Niclasapdk/esd6_project/gitfigures/problem_analysis/effects-all.png

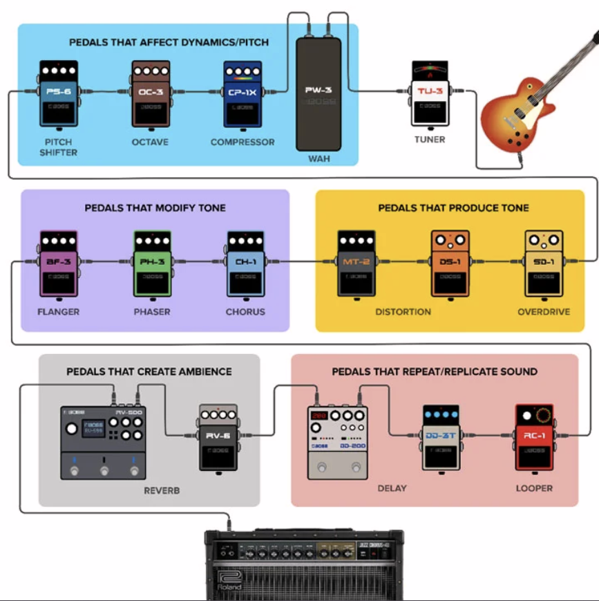
gitfigures/problem_analysis/effects-all.png
