Niclasapdk/esd6_project/gitfigures/problem_analysis/bandwidth_instruments.jpeg

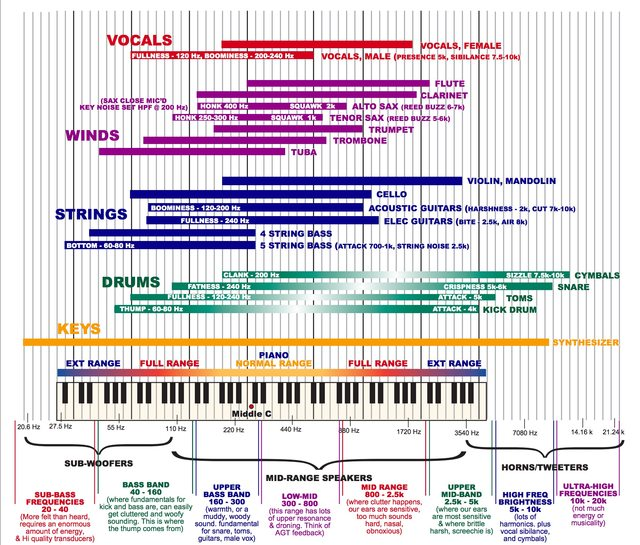
gitfigures/problem_analysis/bandwidth_instruments.jpeg
