Niclasapdk/esd6_project/README.md

# esd6_project
Project repository for esd6 project performed in the spring semester for the Electronic systems engineering education at Aalborg University. The project involves development of a Digital Guitar effect pedal.
