Niclasapdk/esd6_project/ltspice_sim/i2c_level_shift/i2c_level_shift.pdf

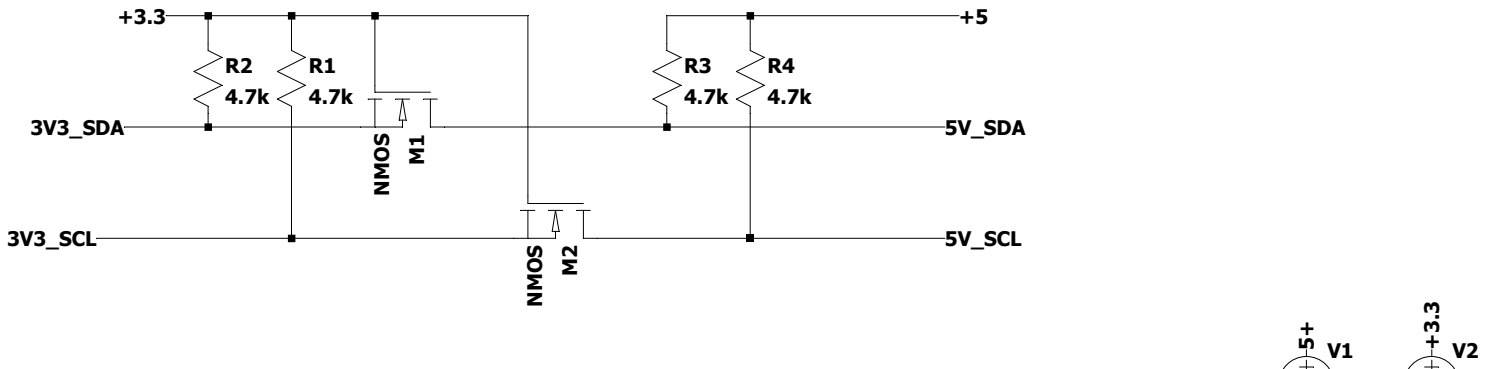
[picture p3: figure]
M1 NMOS M2 NMOS; 3V3_SCL; 3V3_SDA; 5V_SDA; 5V_SCL

5

3.3

--- C:\Users\nicla\Documents\GitHub\esd6_project\ltspice_sim\i2c_level_shift\i2c_level_shift.asc ---
