Niclasapdk/esd6_project/ltspice_sim/powersupply/fullbridgerectifier.pdf

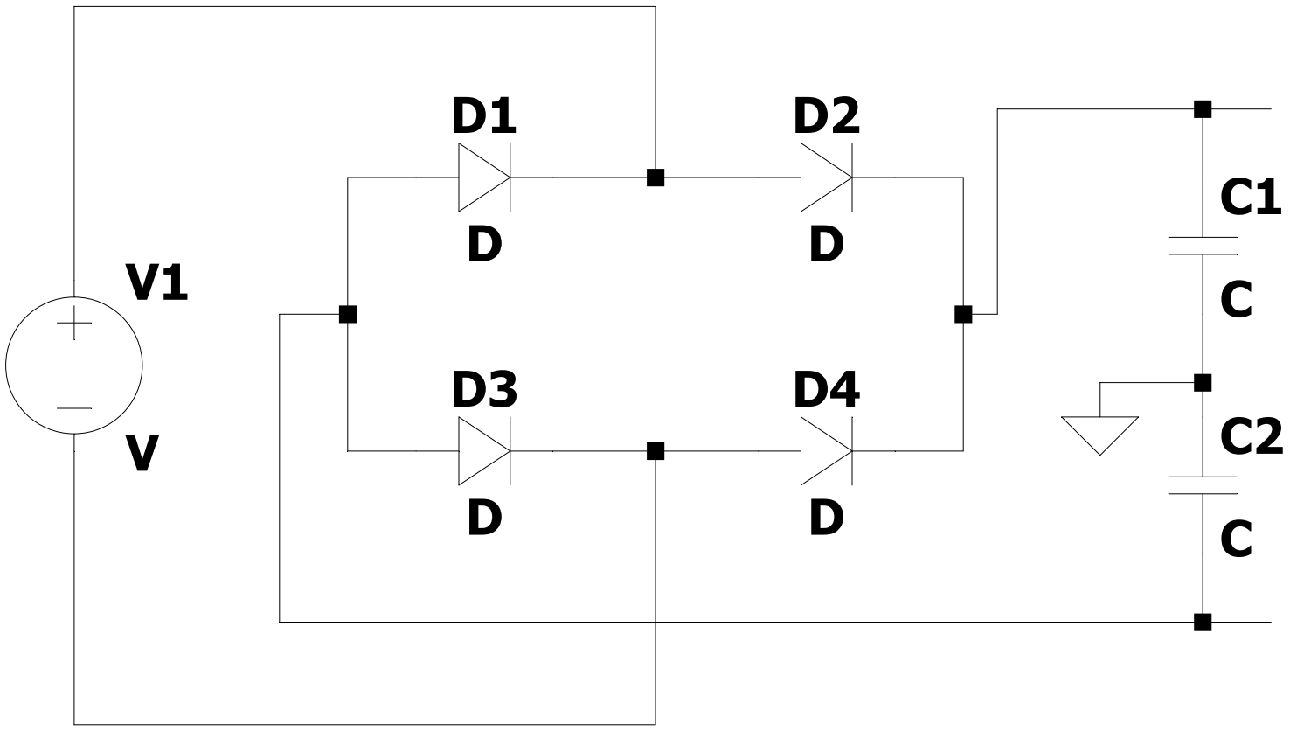
[picture p4: figure]

--- C:\Users\nicla\Documents\GitHub\esd6_project\ltspice_sim\powersupply\fullbridgerectifier.asc ---
