Niclasapdk/esd6_project/ltspice_sim/output_stage/final_output_stage.pdf

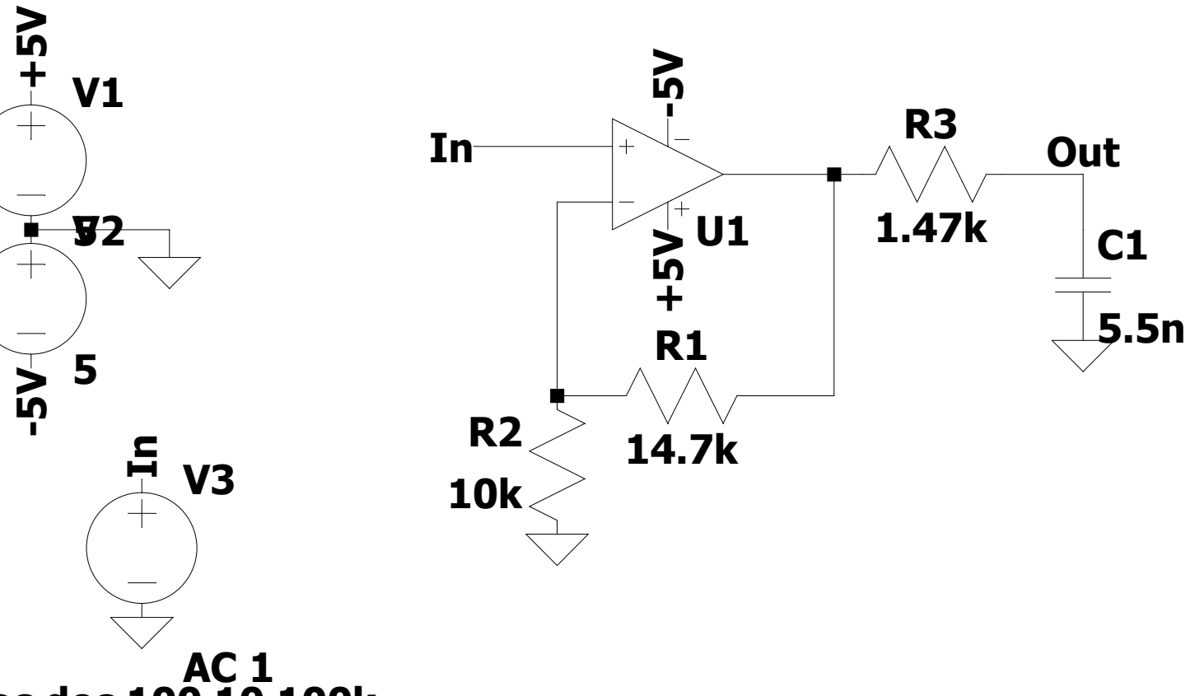
[picture p5: figure]
Out -5V +⁵V

# .ac dec 100 10 100k

--- C:\Users\nicla\Documents\GitHub\esd6_project\ltspice_sim\output_stage\output_stage.asc ---
