Niclasapdk/esd6_project/ltspice_sim/pre_amplifier/pre_amplifier.pdf

U1

V1

5V2

5

R1

R2 | C1 ⁺⁵V -5V | -5V +⁵V In | Out

--- C:\Users\nicla\Documents\GitHub\esd6_project\ltspice_sim\pre_amplifier\pre_amplifier.asc ---
