Niclasapdk/esd6_project/ltspice_sim/output_stage/output_stage.pdf

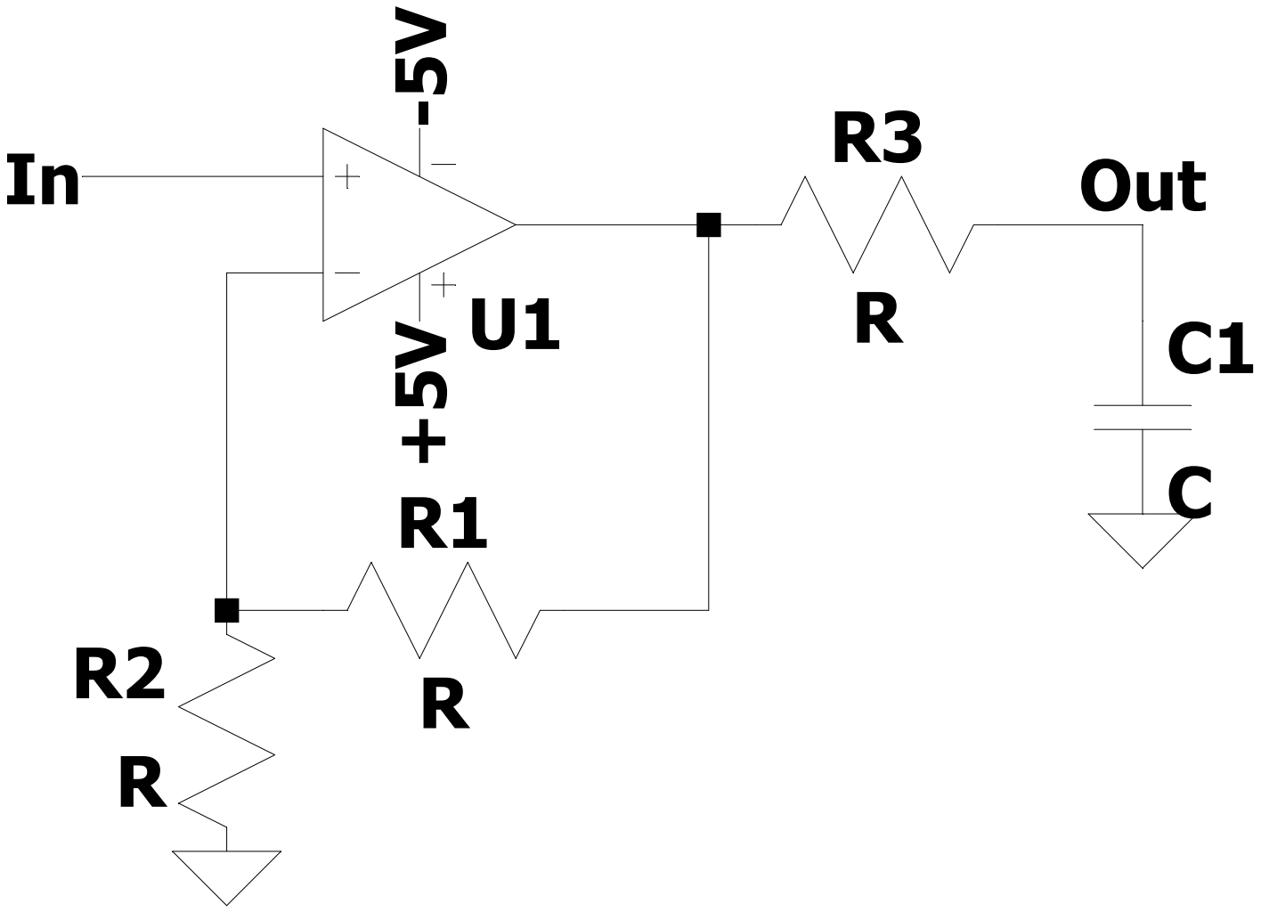
[picture p6: figure]
Out

--- C:\Users\nicla\Documents\GitHub\esd6_project\ltspice_sim\output_stage\output_stage.asc ---
