Niclasapdk/esd6_project/gitfigures/system_design/Wah/wah_low_frequency_12db.csv

#Digilent WaveForms Network Analyzer - Bode
#Device Name: Discovery2
#Serial Number: SN:210321B053D5
#Date Time: 2025-05-15 12:41:13.483
#Start: 20 Hz
#Stop: 20000 Hz
#Steps: 300
#Wavegen: Wavegen C1
#Amplification: 1 X
#Settle: 10 ms
#MinPeriods: 16
#Channel: Channel 1
#Range: 5.43979 V
#Offset: -0.000262887 V
#Relative: no
#Channel: Channel 2
#Range: 5.43753 V
#Offset: -8.04338e-05 V
#Relative: yes
Frequency (Hz) | Channel 1 Magnitude (dB) | Channel 2 Magnitude (dB) | Channel 2 Phase (deg)
20.00000000000002 | -0.002606070705130074 | -33.81785702211154 | -75.45421835355387
20.46743597265041 | -0.003039530886577424 | -33.4971010224652 | -75.87884337679446
20.94579676472719 | -0.003606329130092465 | -33.37743036438188 | -76.69155523995754
21.43533770891007 | -0.001902478492544501 | -33.1057782051241 | -77.15941111737237
21.93632010546278 | -0.003095008247465629 | -32.87304823254387 | -78.01910867283254
22.44901136170614 | -0.002248319778112701 | -32.66217747758758 | -78.67815813652268
22.97368513475109 | -0.002733646385287935 | -32.4089361148945 | -78.92603872778579
23.5106214775674 | -0.003115348752118241 | -32.20519191451243 | -79.74588884813735
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
