Niclasapdk/esd6_project/gitfigures/system_design/Wah/wah_mid_frequency_12db.csv

#Digilent WaveForms Network Analyzer - Bode
#Device Name: Discovery2
#Serial Number: SN:210321B053D5
#Date Time: 2025-05-15 12:43:02.559
#Start: 20 Hz
#Stop: 20000 Hz
#Steps: 300
#Wavegen: Wavegen C1
#Amplification: 1 X
#Settle: 10 ms
#MinPeriods: 16
#Channel: Channel 1
#Range: 5.43979 V
#Offset: -0.000262887 V
#Relative: no
#Channel: Channel 2
#Range: 5.43753 V
#Offset: -8.04338e-05 V
#Relative: yes
Frequency (Hz) | Channel 1 Magnitude (dB) | Channel 2 Magnitude (dB) | Channel 2 Phase (deg)
20.00000000000002 | -0.00260477324015059 | -43.95884145612773 | -74.299338491093
20.46743597265041 | -0.003276387584285059 | -43.70699813291107 | -74.98111551779743
20.94579676472719 | -0.003042464940005225 | -43.49375212266494 | -75.43956537908767
21.43533770891007 | -0.00290015797058464 | -43.29166157057587 | -75.97746576867382
21.93632010546278 | -0.002951141947448487 | -43.14320937720648 | -76.71534744921144
22.44901136170614 | -0.002900704517803395 | -42.91114187823084 | -77.71771890074979
22.97368513475109 | -0.002491785947718732 | -42.69948997378943 | -78.34720888592523
23.5106214775674 | -0.002943338338022859 | -42.44593828576228 | -78.98008649812051
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
