Niclasapdk/esd6_project/gitfigures/system_design/analog_frontend/appendix_LM317_schematic.png

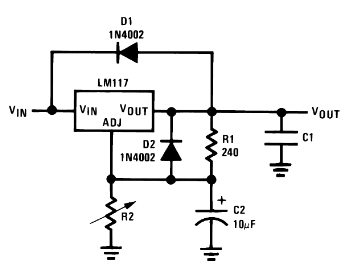
gitfigures/system_design/analog_frontend/appendix_LM317_schematic.png
