Niclasapdk/esd6_project/gitfigures/system_design/analog_frontend/appendix_LM337_schematic_part_2.png

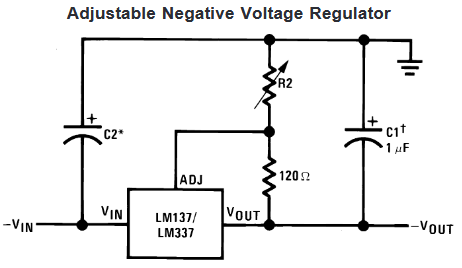
gitfigures/system_design/analog_frontend/appendix_LM337_schematic_part_2.png
