Niclasapdk/esd6_project/gitfigures/system_design/analog_frontend/final_output_stage.png

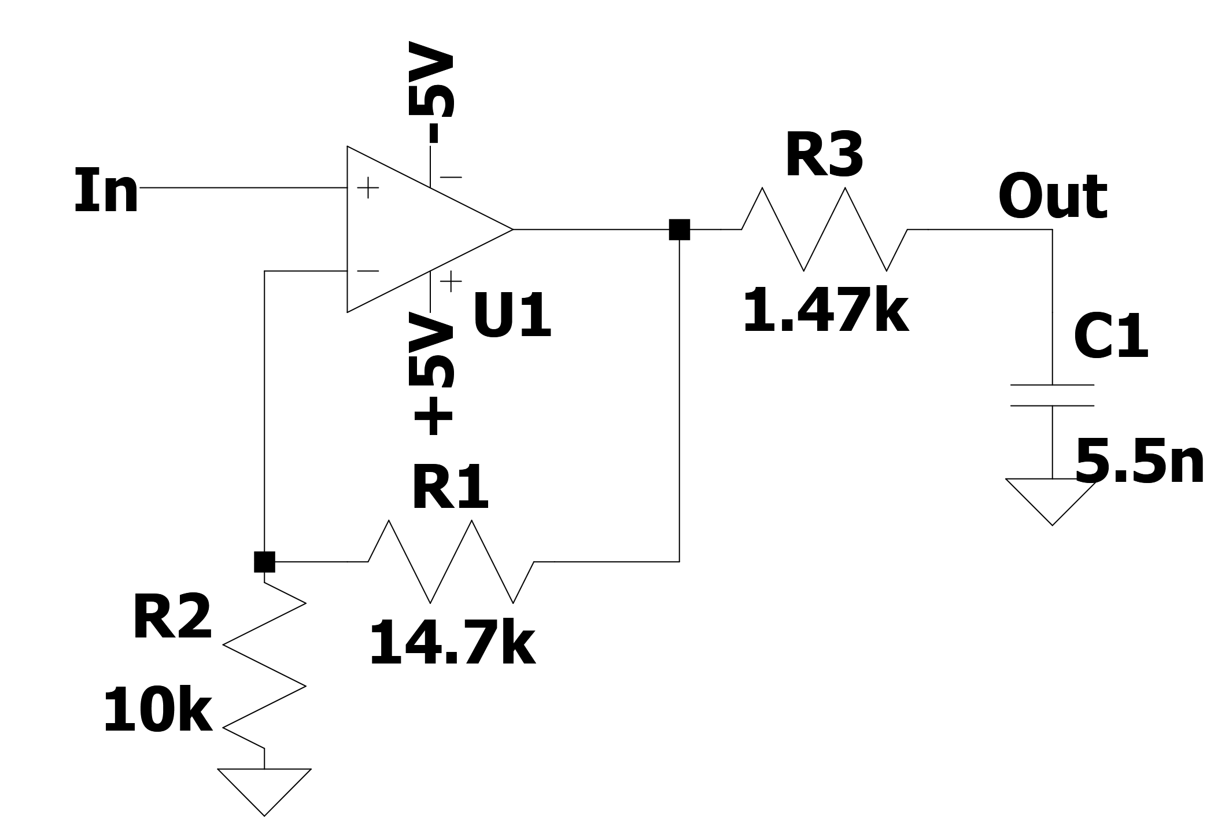
gitfigures/system_design/analog_frontend/final_output_stage.png
