Niclasapdk/esd6_project/gitfigures/system_design/analog_frontend/freqresp_frontend.png

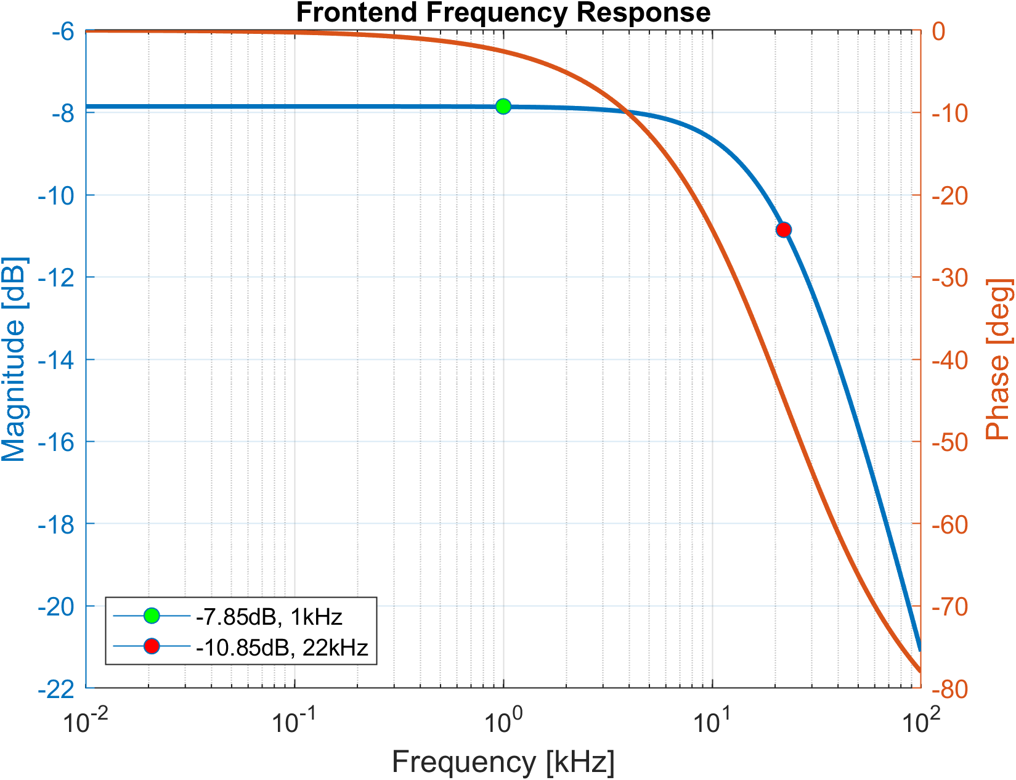
gitfigures/system_design/analog_frontend/freqresp_frontend.png
