Niclasapdk/esd6_project/gitfigures/system_design/analog_frontend/i2c_level_shift.png

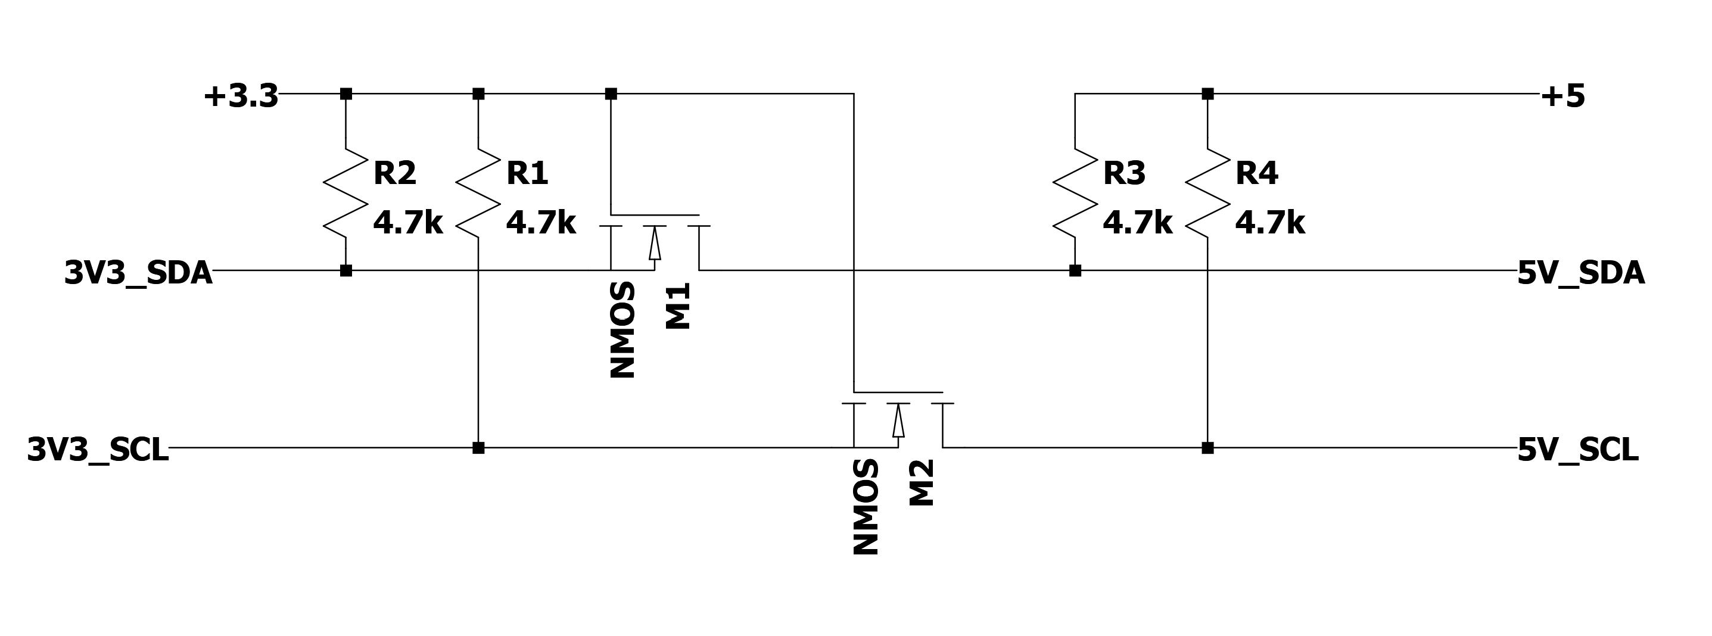
gitfigures/system_design/analog_frontend/i2c_level_shift.png
