Niclasapdk/esd6_project/gitfigures/system_design/analog_frontend/input_protection_preamp.png

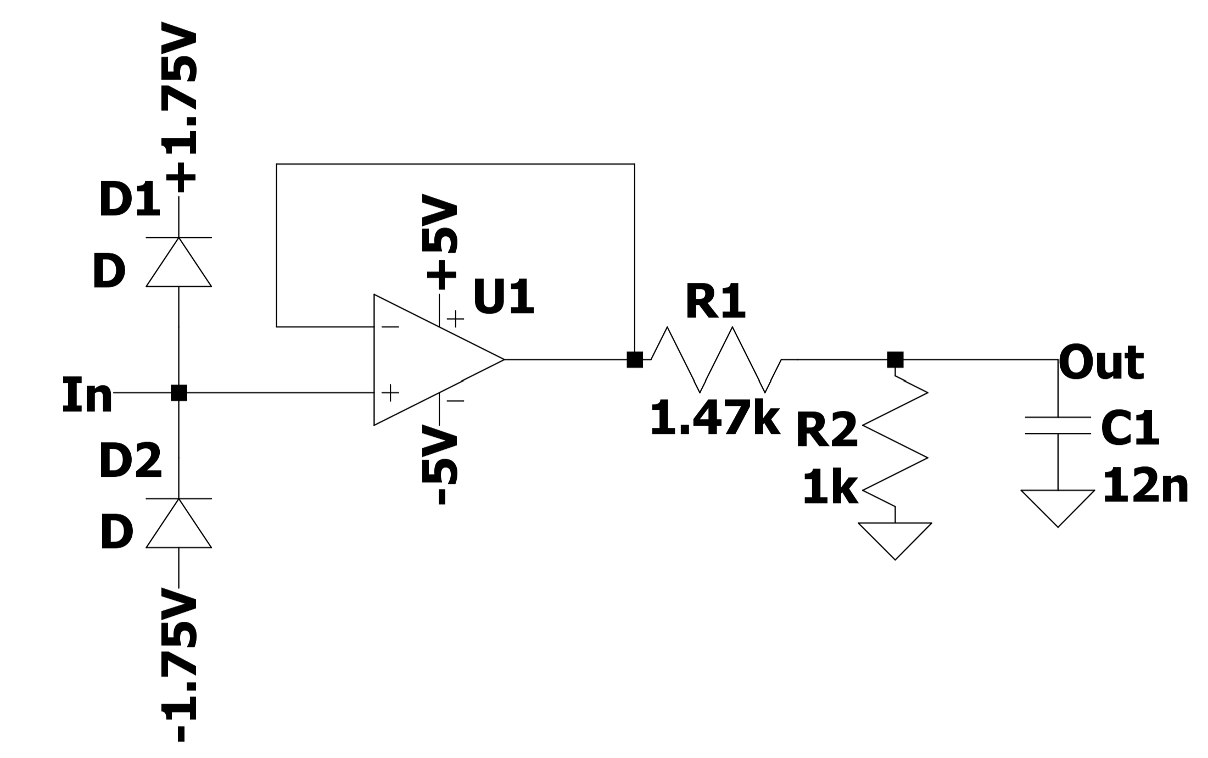
gitfigures/system_design/analog_frontend/input_protection_preamp.png
