Niclasapdk/esd6_project/gitfigures/system_design/analog_frontend/pedalboard.png

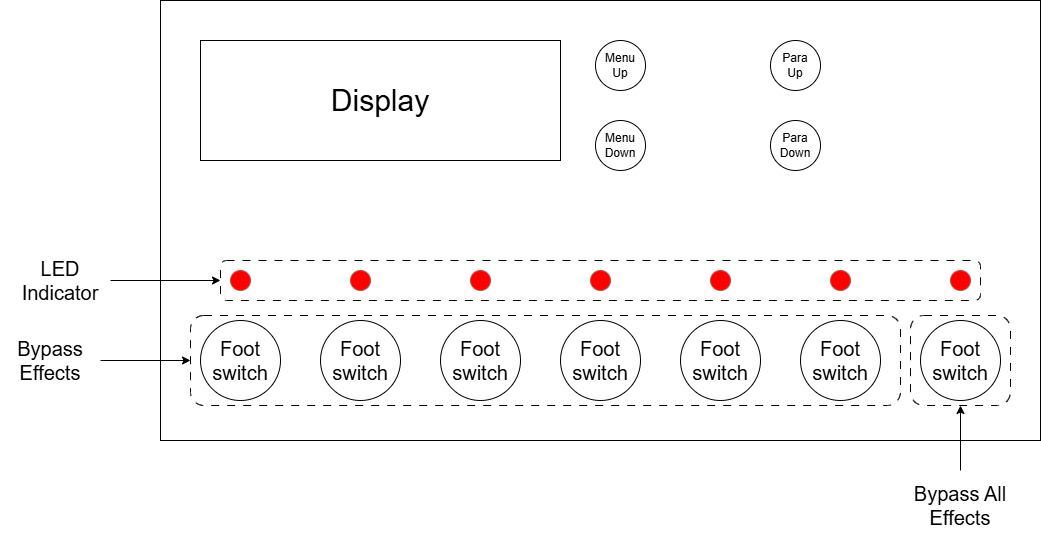
gitfigures/system_design/analog_frontend/pedalboard.png
