Niclasapdk/esd6_project/gitfigures/system_design/analog_frontend/pre_amp_scheamtic.png

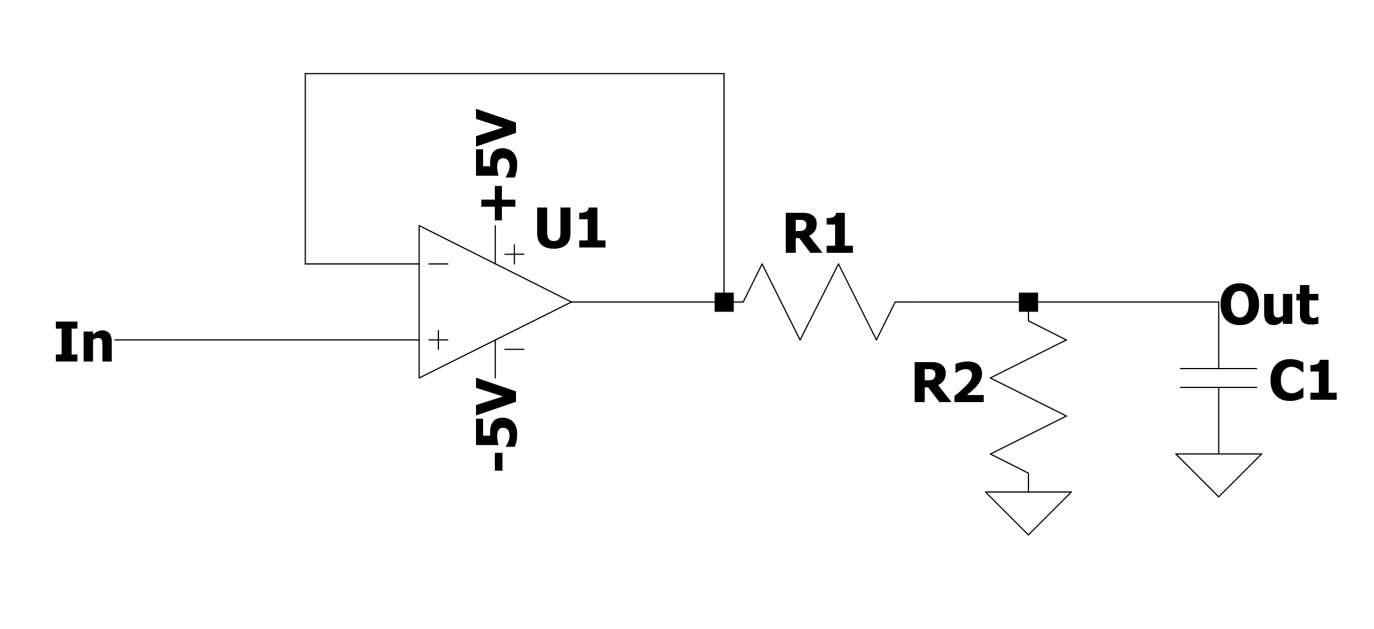
gitfigures/system_design/analog_frontend/pre_amp_scheamtic.png
