Niclasapdk/esd6_project/gitfigures/system_design/ChorusFlanger/ChorusBlock.drawio.png

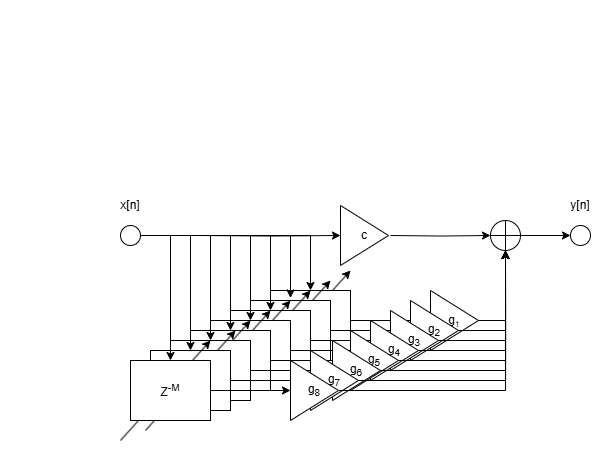
gitfigures/system_design/ChorusFlanger/ChorusBlock.drawio.png
