Niclasapdk/esd6_project/gitfigures/system_design/ChorusFlanger/FlangerBlock.drawio.png

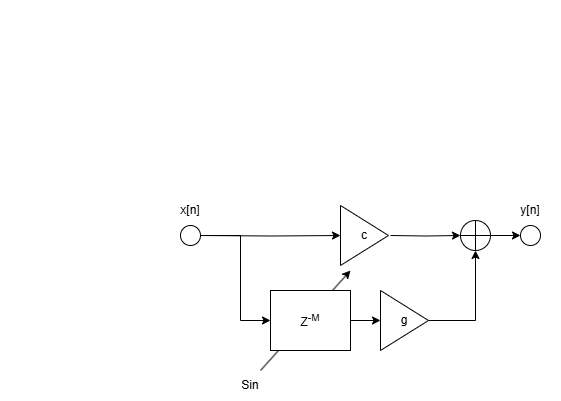
gitfigures/system_design/ChorusFlanger/FlangerBlock.drawio.png
