Niclasapdk/esd6_project/gitfigures/system_design/ChorusFlanger/FlangerWaveplot.png

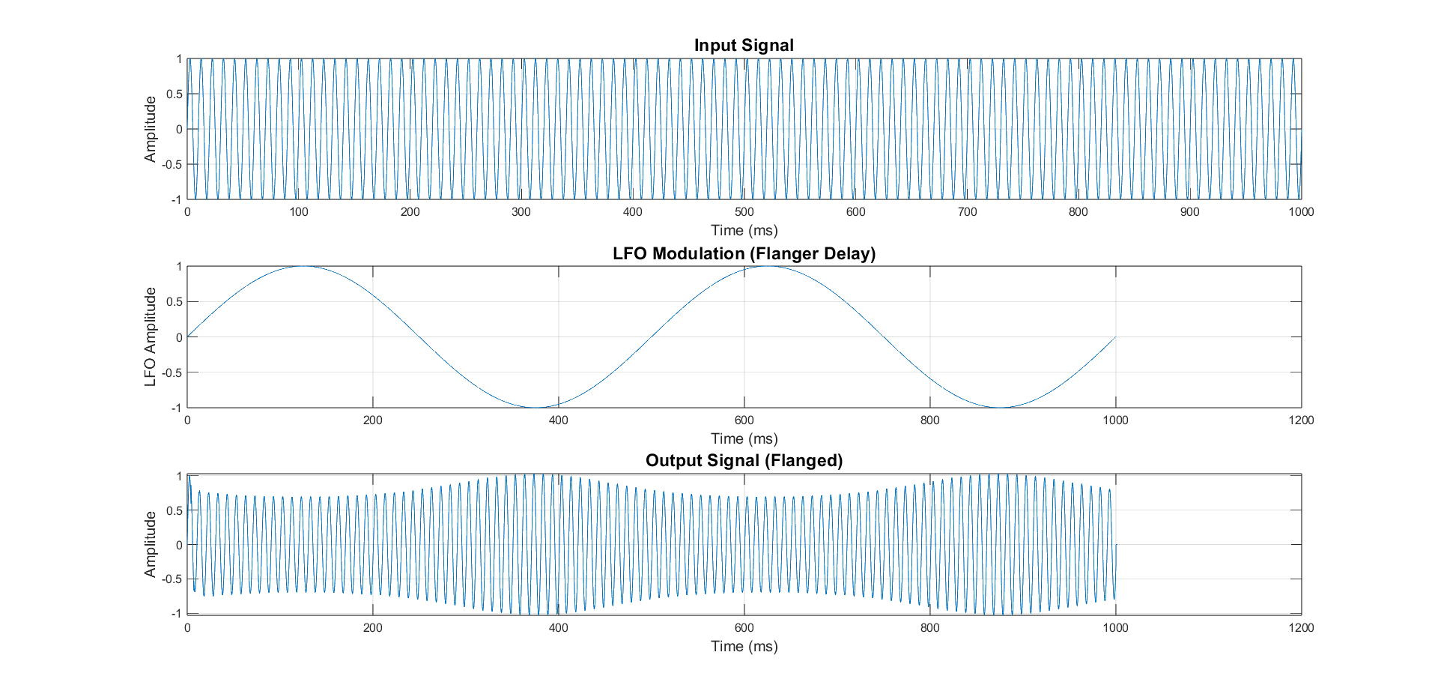
gitfigures/system_design/ChorusFlanger/FlangerWaveplot.png
