Niclasapdk/esd6_project/gitfigures/system_design/codec/snr_10_5dB_input_gain_700mV_signal.png

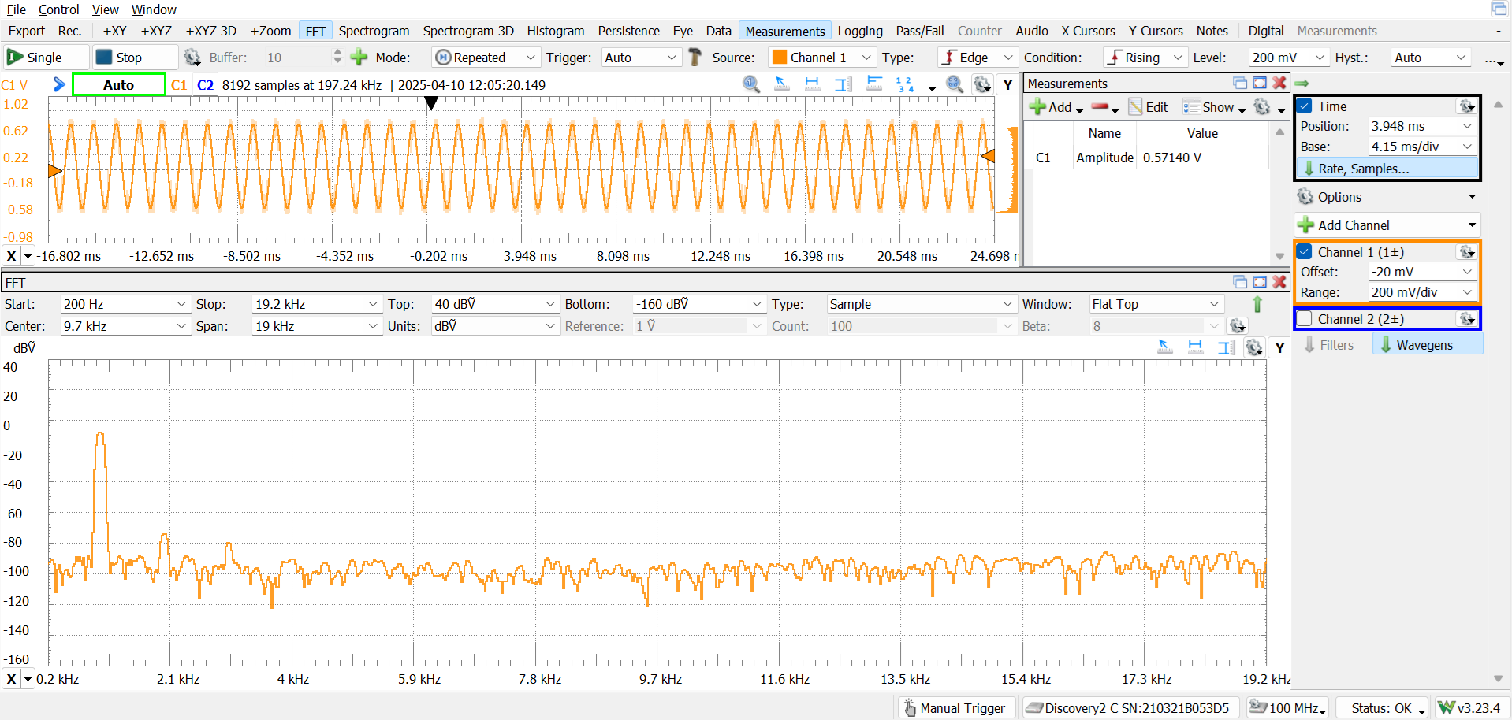
gitfigures/system_design/codec/snr_10_5dB_input_gain_700mV_signal.png
