Niclasapdk/esd6_project/gitfigures/system_design/LCD/LCD_protocol.drawio.png

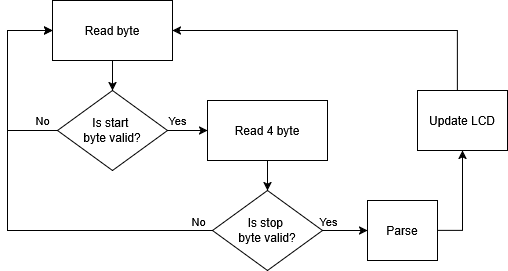
gitfigures/system_design/LCD/LCD_protocol.drawio.png
