Niclasapdk/esd6_project/gitfigures/system_design/lowfrequencyoscillator/32bit_multiplication.png

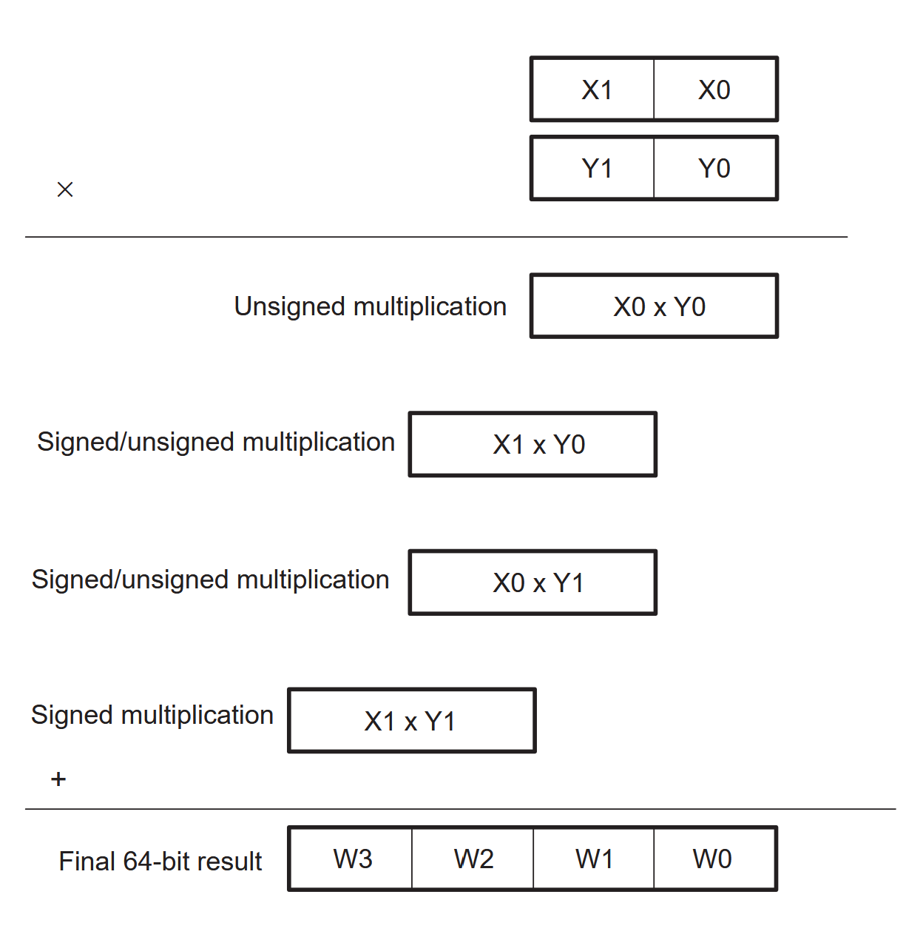
gitfigures/system_design/lowfrequencyoscillator/32bit_multiplication.png
