Niclasapdk/esd6_project/gitfigures/system_design/lowfrequencyoscillator/digital_oscillator.png

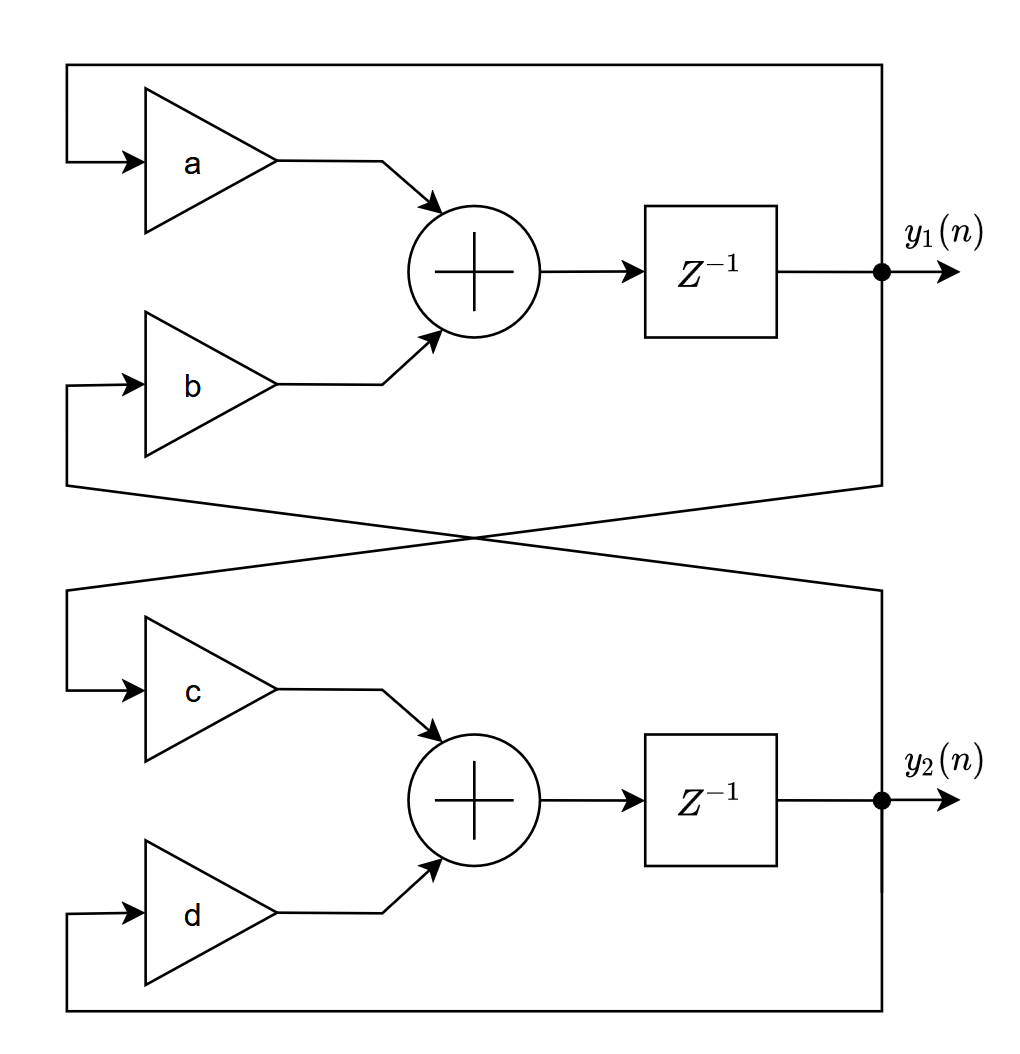
gitfigures/system_design/lowfrequencyoscillator/digital_oscillator.png
