Niclasapdk/esd6_project/gitfigures/system_design/overdrive/aa_filter_matlab_mag_resp.png

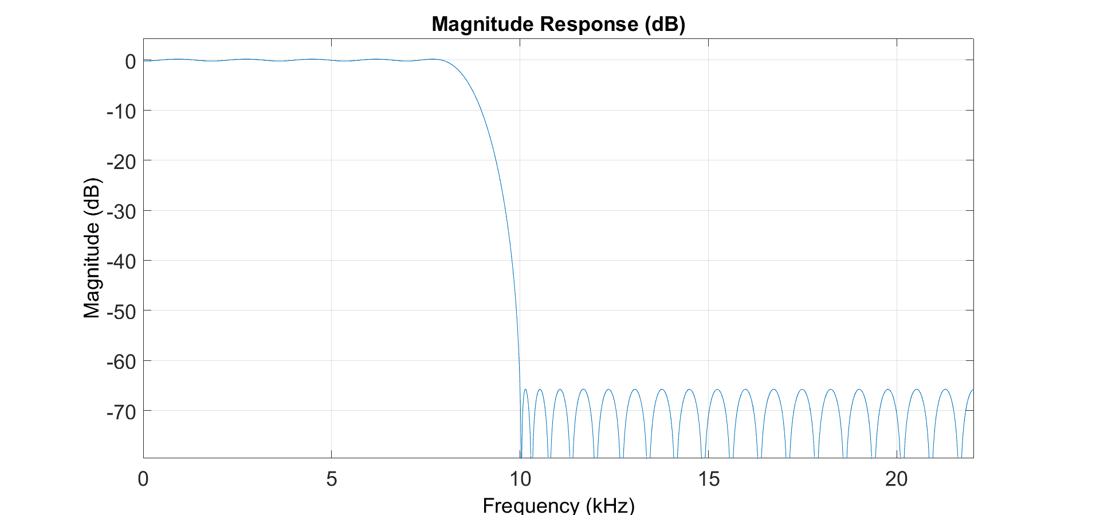
gitfigures/system_design/overdrive/aa_filter_matlab_mag_resp.png
