Niclasapdk/esd6_project/gitfigures/system_design/overdrive/dafx_wdf_adaptors.png

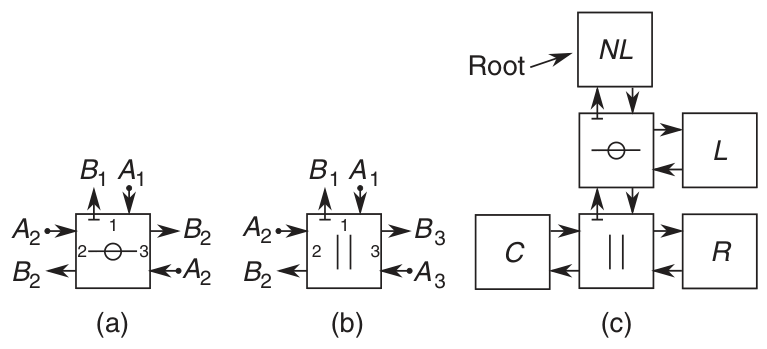
gitfigures/system_design/overdrive/dafx_wdf_adaptors.png
