Niclasapdk/esd6_project/gitfigures/system_design/overdrive/fft_overdrive_output_0k6.png

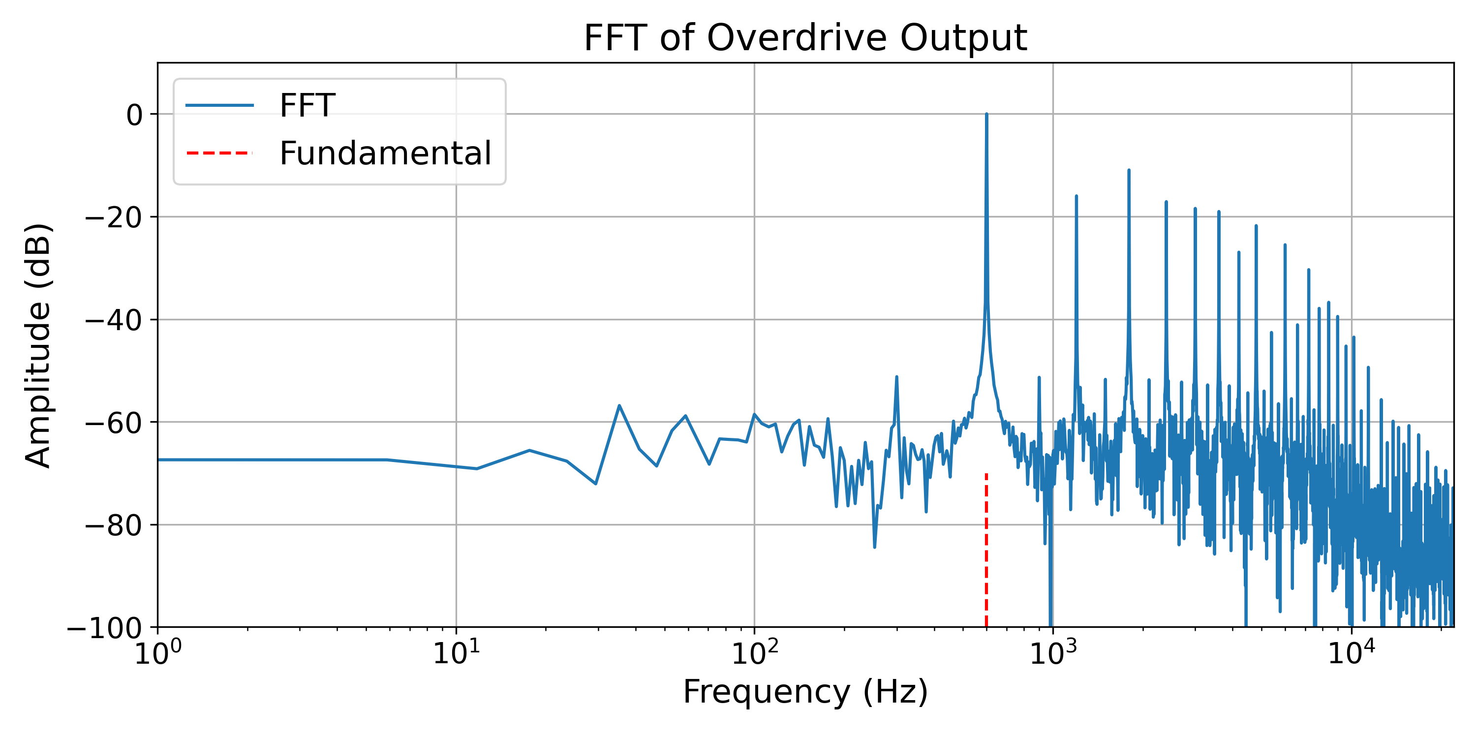
gitfigures/system_design/overdrive/fft_overdrive_output_0k6.png
