Niclasapdk/esd6_project/gitfigures/system_design/overdrive/fft_overdrive_output_2k5.png

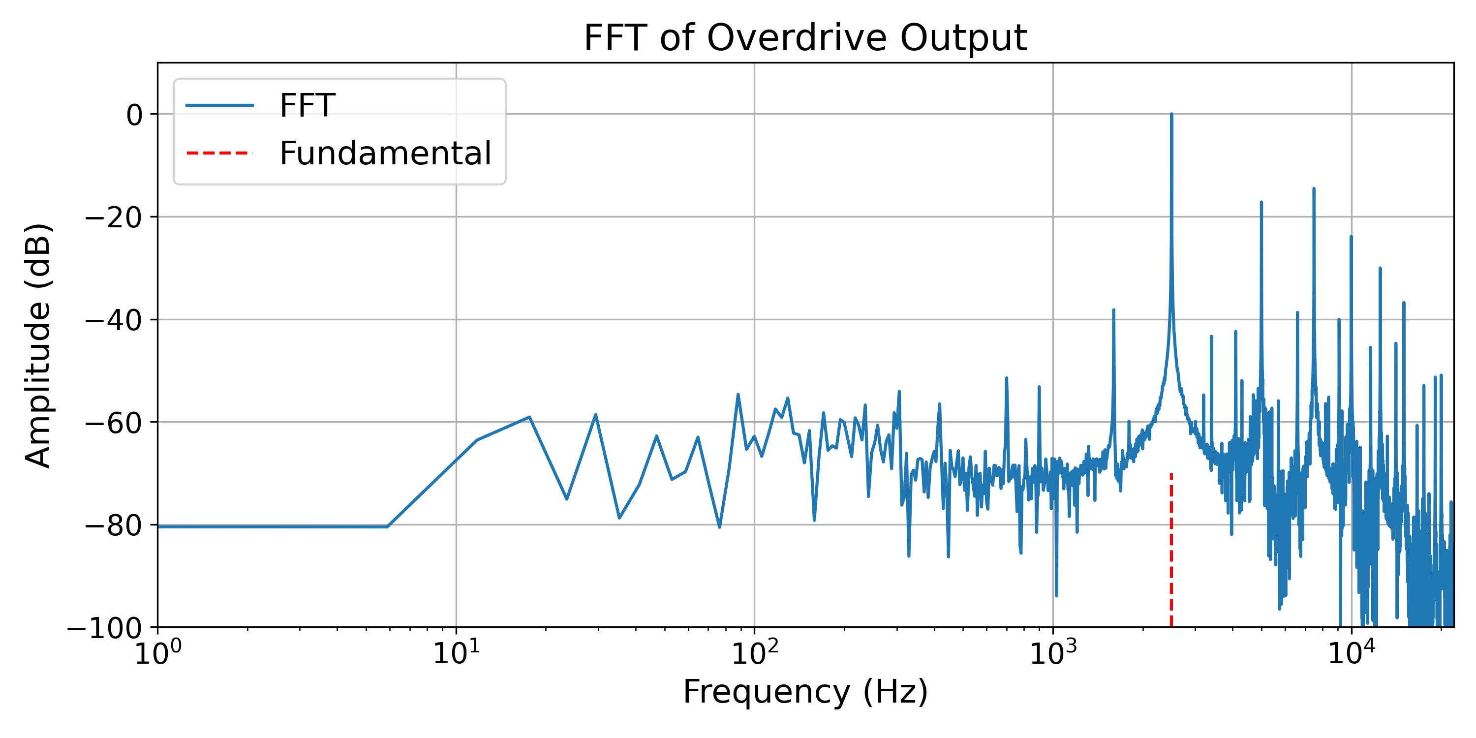
gitfigures/system_design/overdrive/fft_overdrive_output_2k5.png
