Niclasapdk/esd6_project/gitfigures/system_design/overdrive/fft_overdrive_output_5k.png

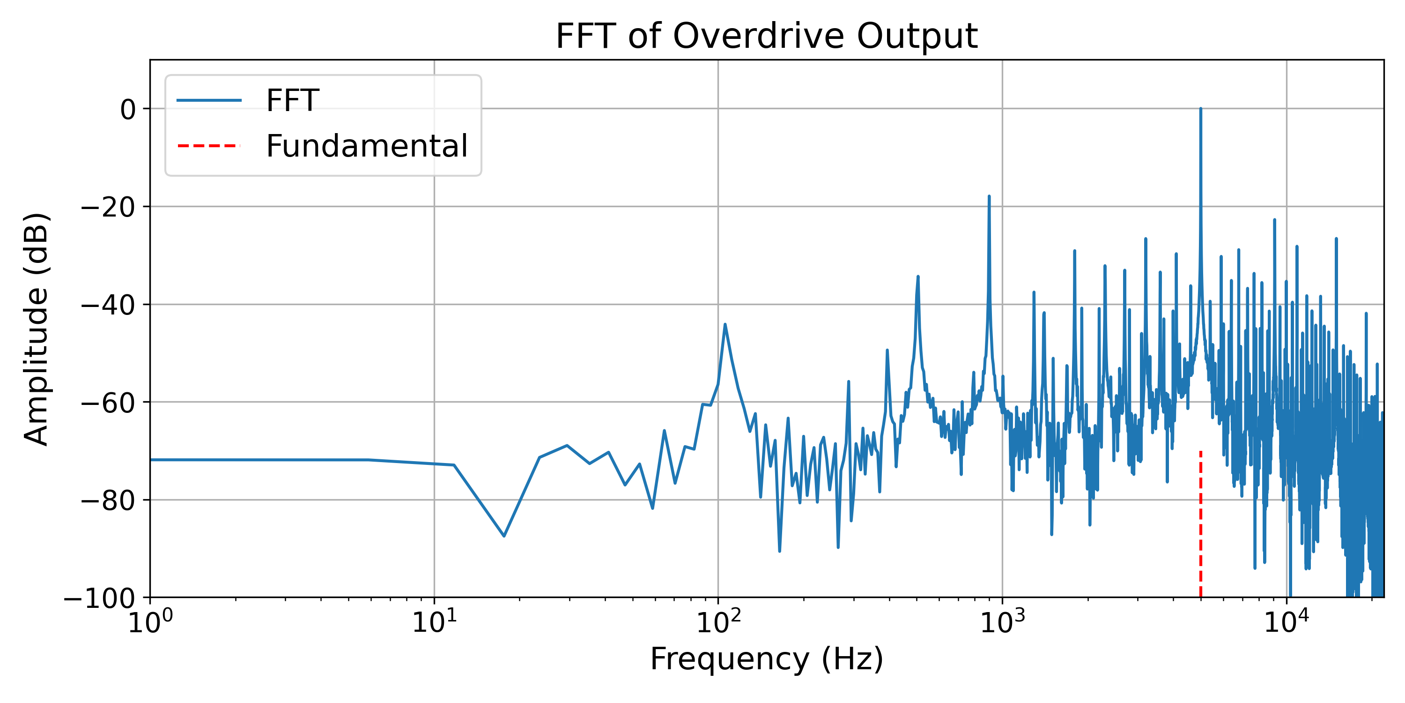
gitfigures/system_design/overdrive/fft_overdrive_output_5k.png
