Niclasapdk/esd6_project/gitfigures/system_design/overdrive/ts808_clip_breakdown.png

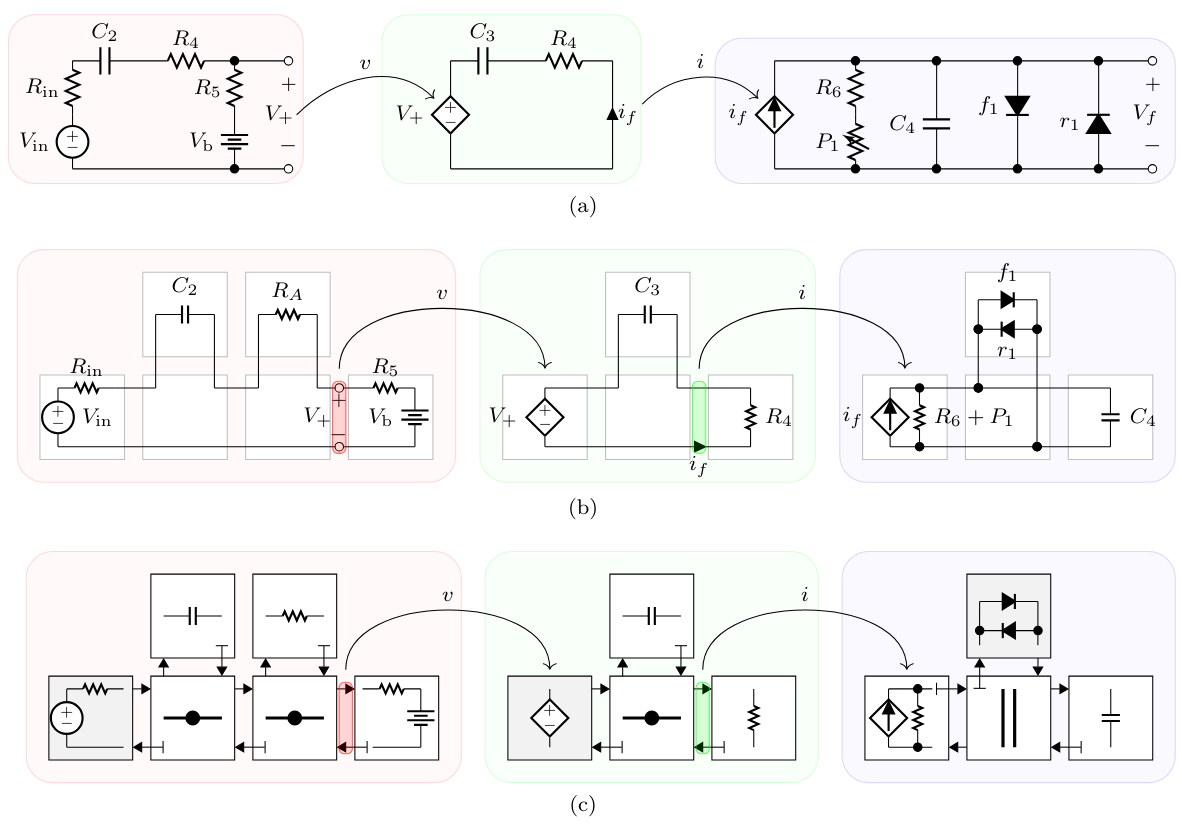
gitfigures/system_design/overdrive/ts808_clip_breakdown.png
