Niclasapdk/esd6_project/gitfigures/system_design/overdrive/ts808_clip_sch.png

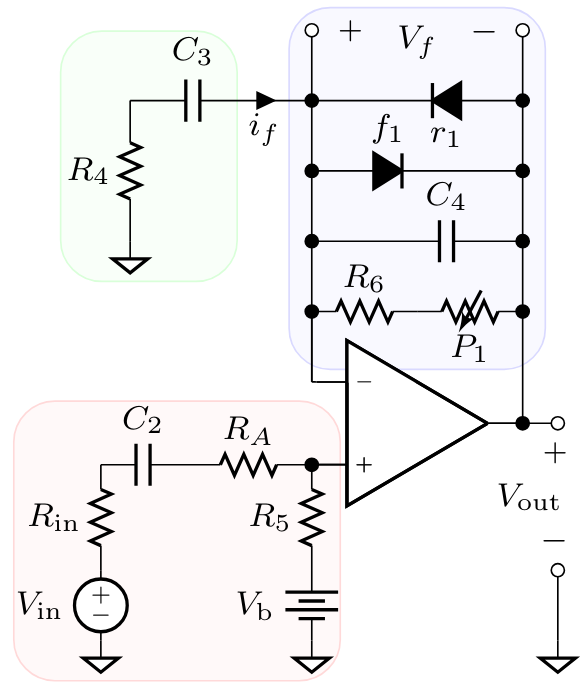
gitfigures/system_design/overdrive/ts808_clip_sch.png
