Niclasapdk/esd6_project/gitfigures/system_design/powersupply/fullbridgerectifier.png

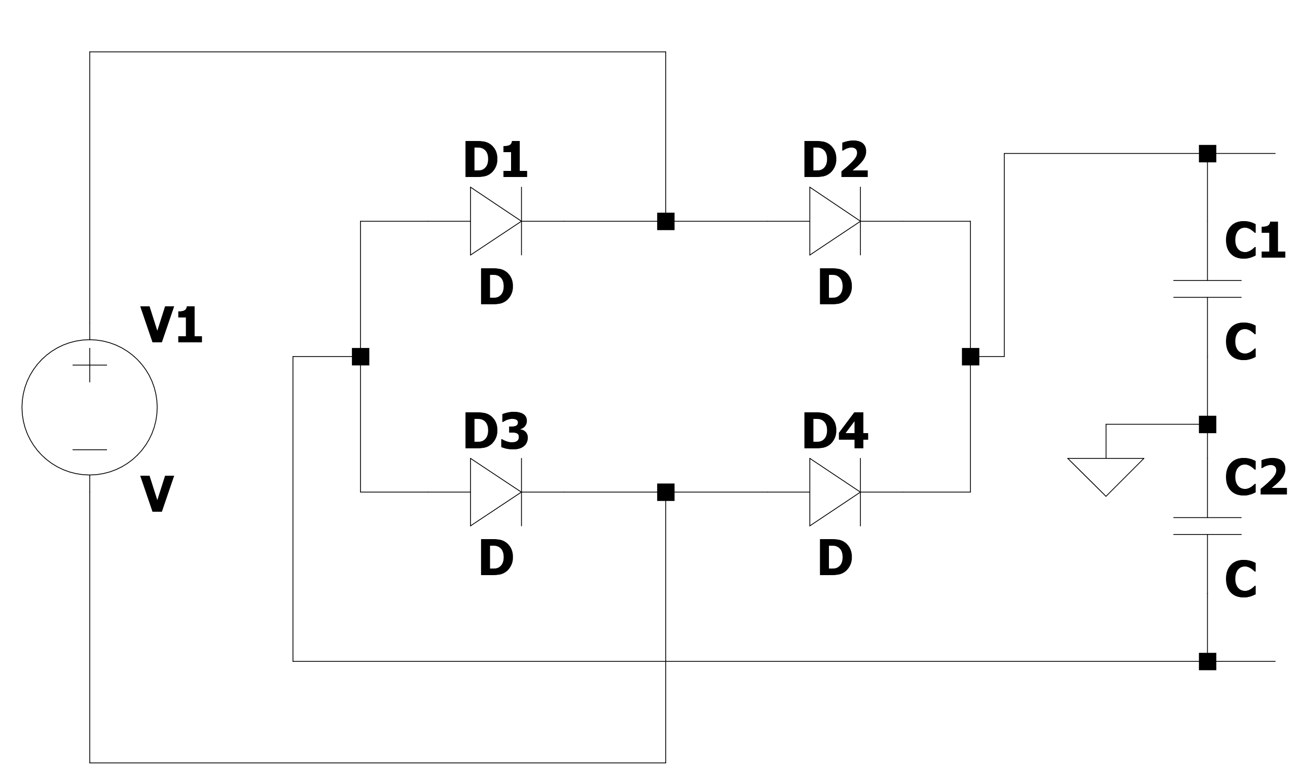
gitfigures/system_design/powersupply/fullbridgerectifier.png
