Niclasapdk/esd6_project/gitfigures/system_design/powersupply/powersupply.png

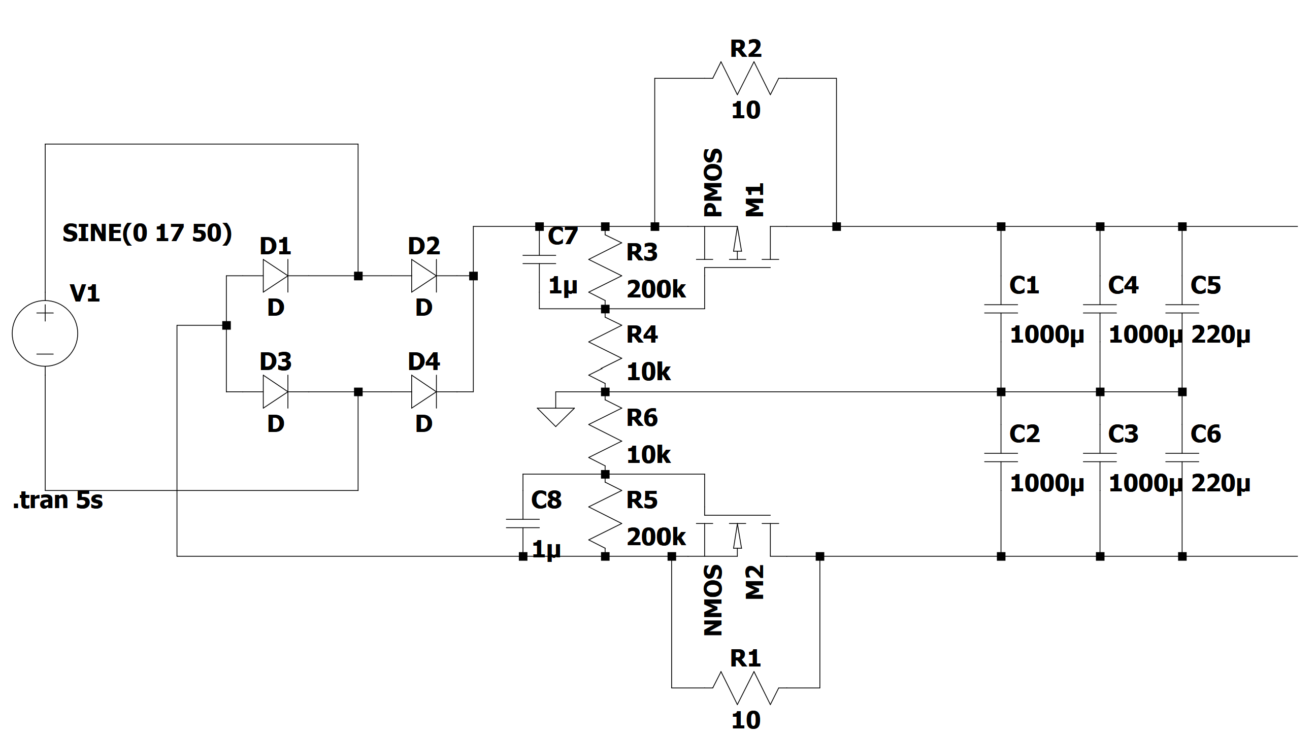
gitfigures/system_design/powersupply/powersupply.png
