Niclasapdk/esd6_project/gitfigures/system_design/reverb/boston_g1_rt1_impulse.png

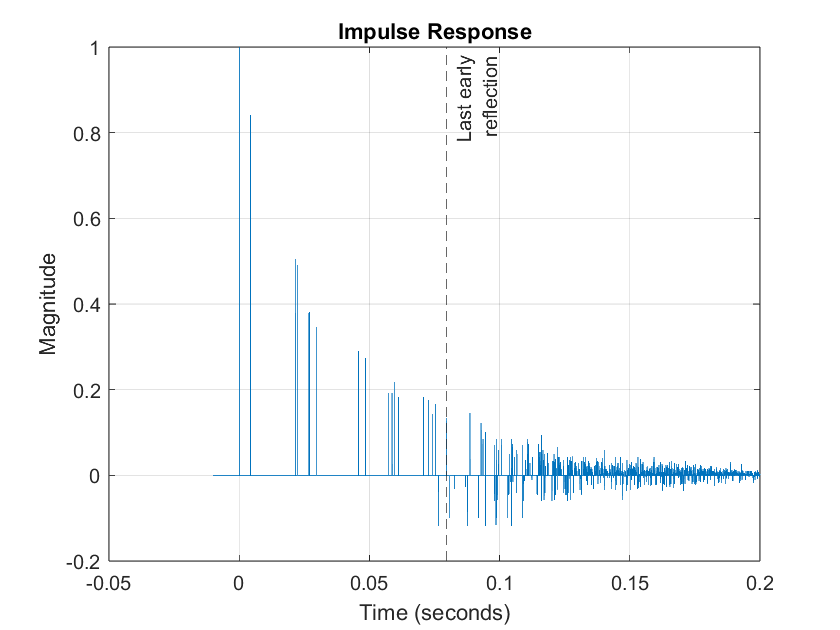
gitfigures/system_design/reverb/boston_g1_rt1_impulse.png
