Niclasapdk/esd6_project/gitfigures/system_design/reverb/circbuf.png

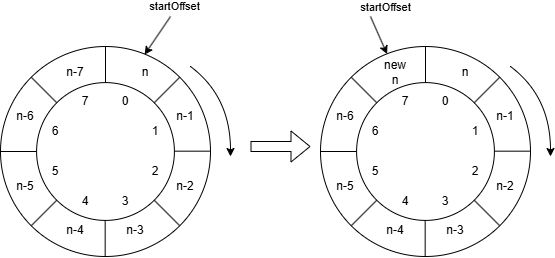
gitfigures/system_design/reverb/circbuf.png
