Niclasapdk/esd6_project/gitfigures/system_design/reverb/moorer_lowpassfilter.png

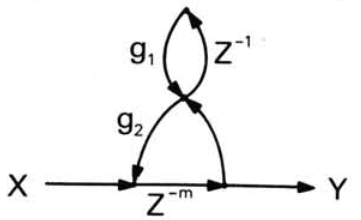
gitfigures/system_design/reverb/moorer_lowpassfilter.png
