Niclasapdk/esd6_project/gitfigures/system_design/reverb/moorers_reverberator.png

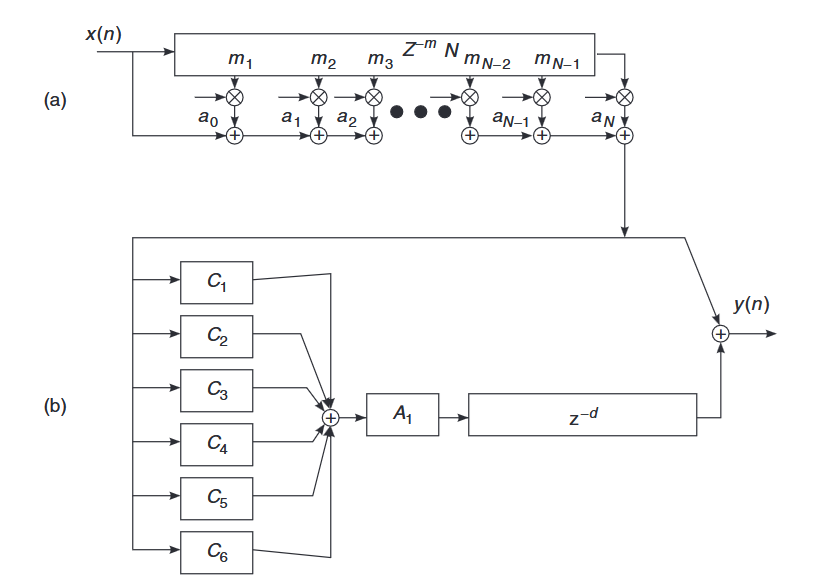
gitfigures/system_design/reverb/moorers_reverberator.png
