Niclasapdk/esd6_project/gitfigures/system_design/reverb/reverb_schroeder_rt60_4s.png

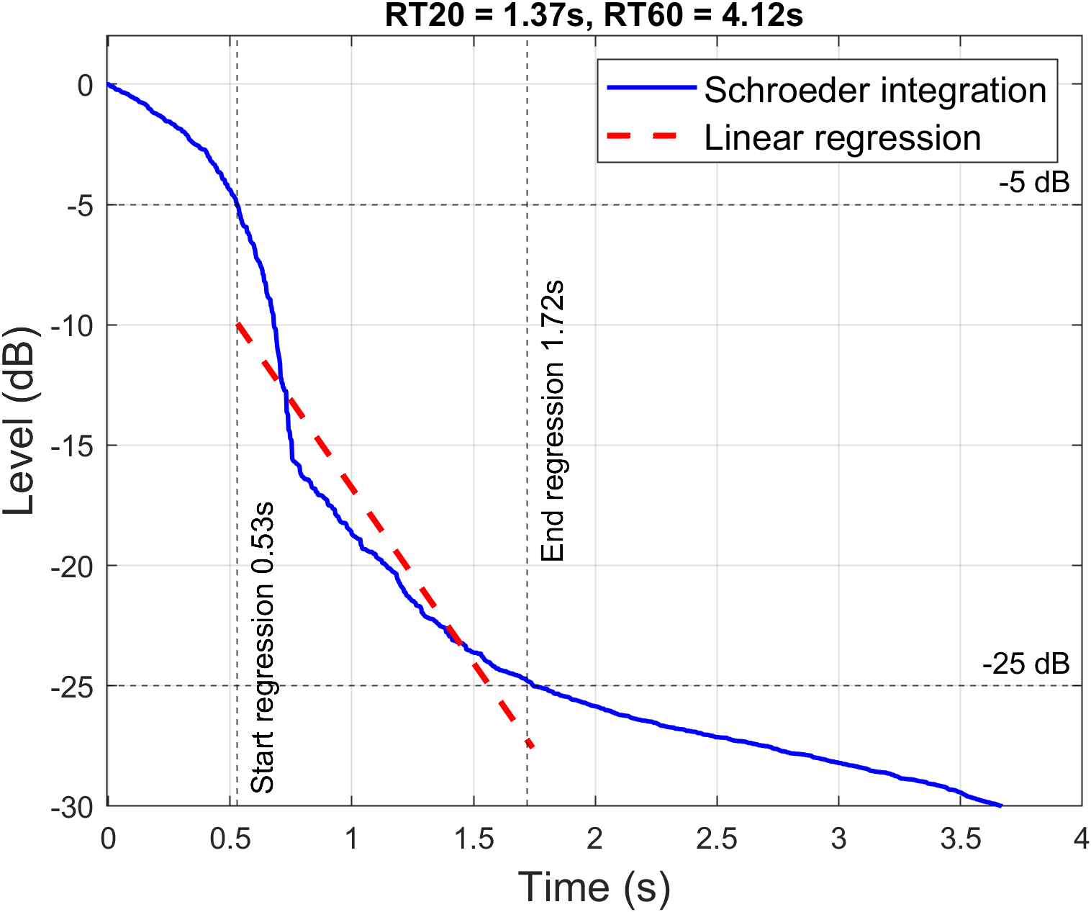
gitfigures/system_design/reverb/reverb_schroeder_rt60_4s.png
