Niclasapdk/esd6_project/gitfigures/system_design/reverb/reverb_schroeder_rt60_05s.png

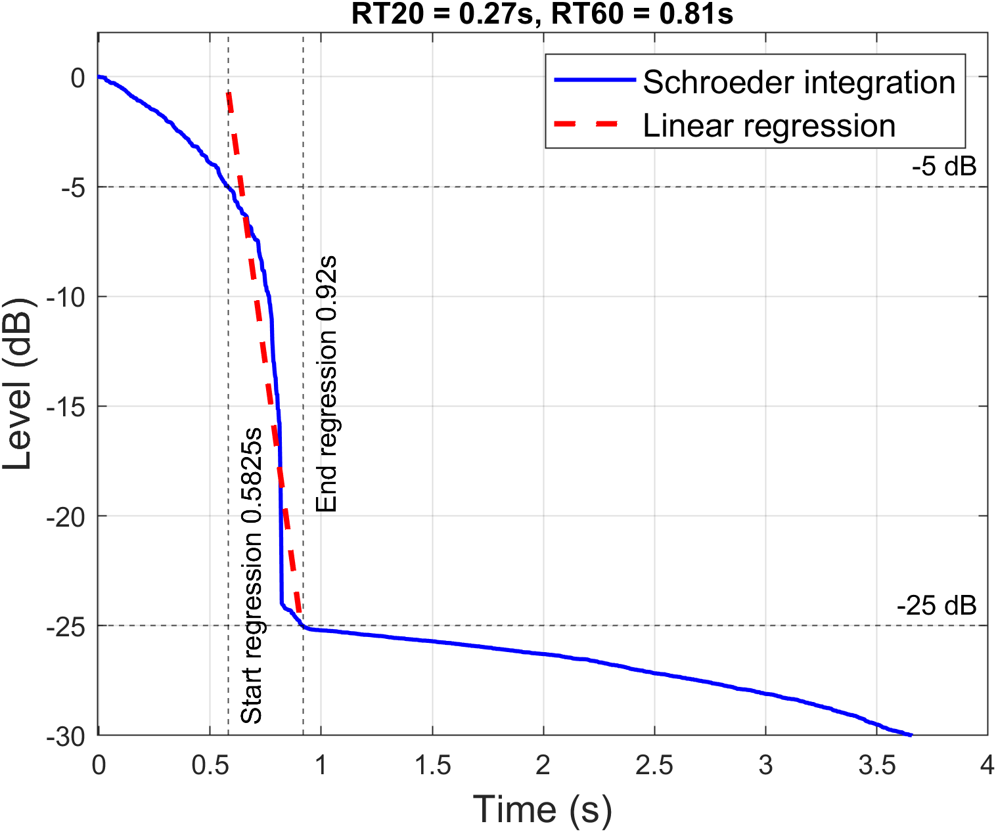
gitfigures/system_design/reverb/reverb_schroeder_rt60_05s.png
