Niclasapdk/esd6_project/gitfigures/system_design/reverb/rt60_tap7_g1_rt05.png

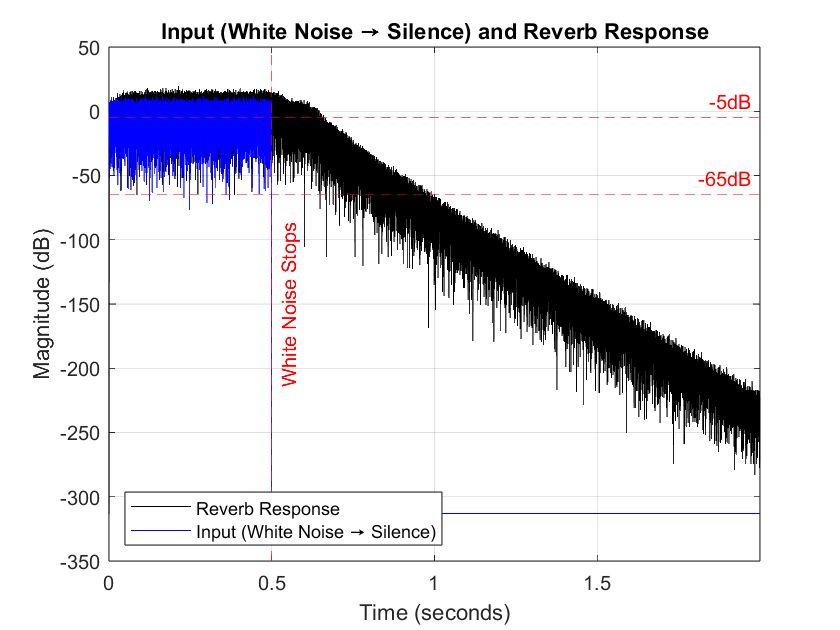
gitfigures/system_design/reverb/rt60_tap7_g1_rt05.png
