Niclasapdk/esd6_project/gitfigures/system_design/tms320c55/aic3204_block_diagram.png

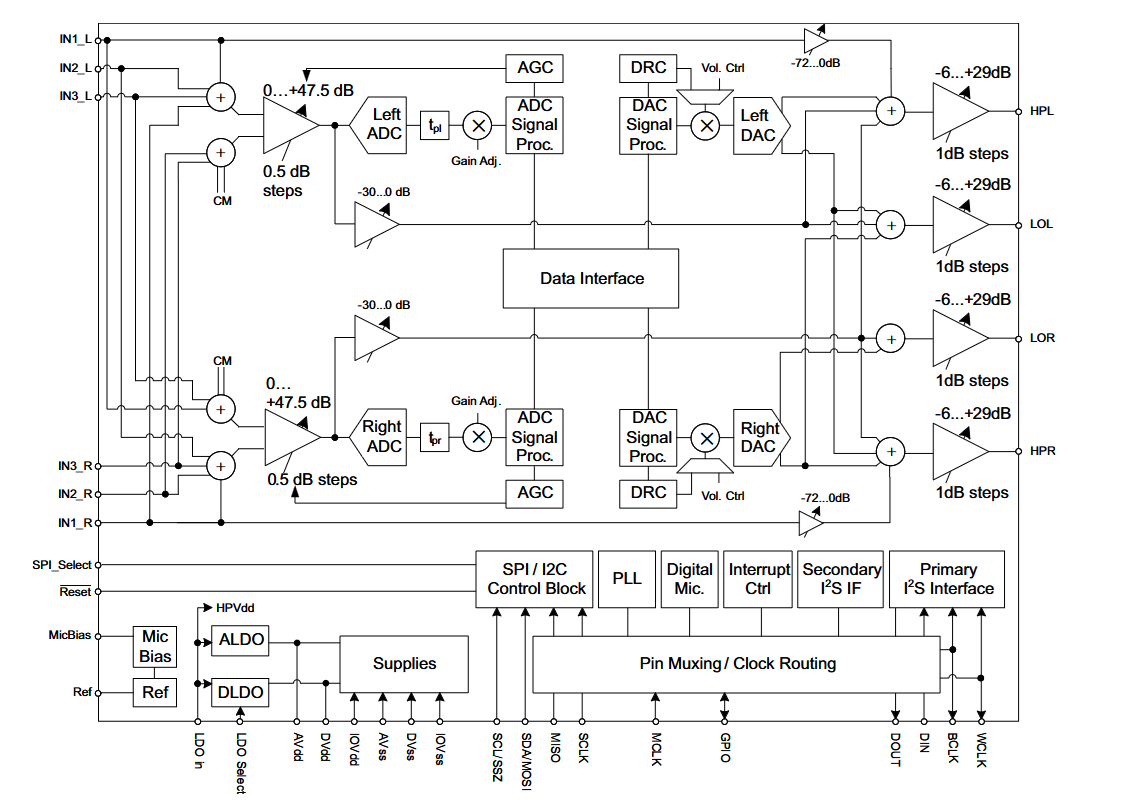
gitfigures/system_design/tms320c55/aic3204_block_diagram.png
