Niclasapdk/esd6_project/gitfigures/system_design/tms320c55/cpu_diagram.png

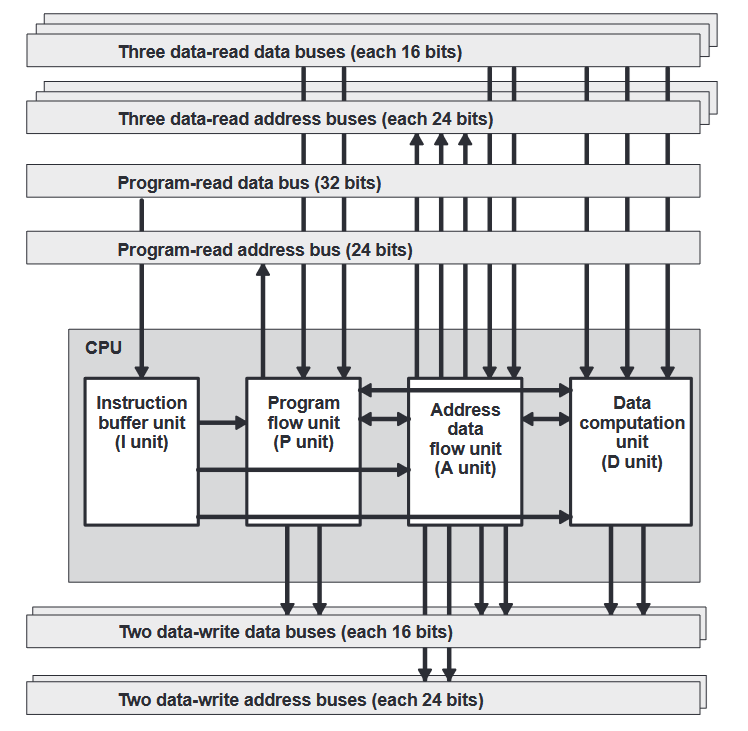
gitfigures/system_design/tms320c55/cpu_diagram.png
