Niclasapdk/esd6_project/gitfigures/system_design/tms320c55/system_overview.png

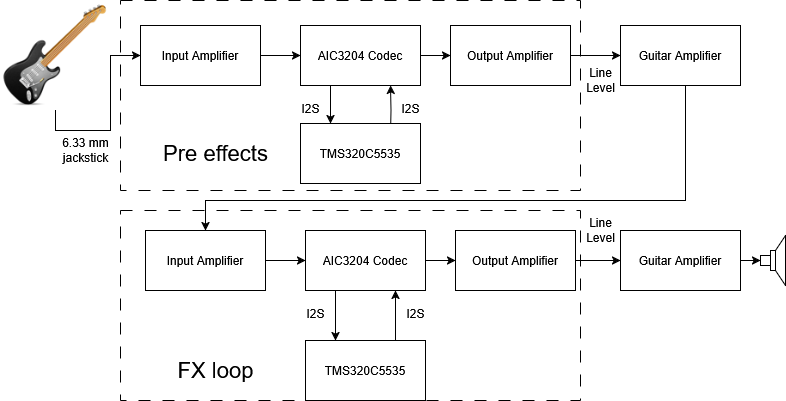
gitfigures/system_design/tms320c55/system_overview.png
