Niclasapdk/esd6_project/gitfigures/system_design/Tremolo/TremoloModulation.png

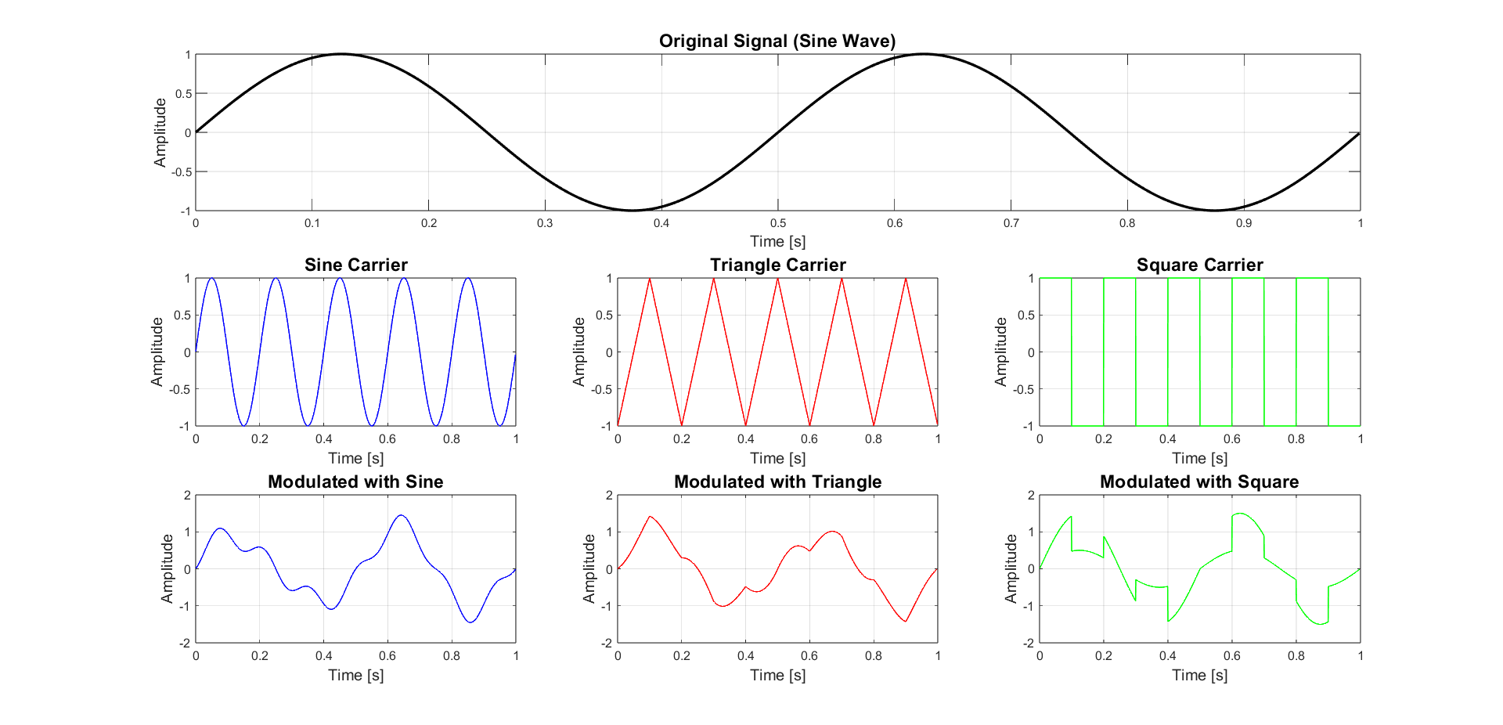
gitfigures/system_design/Tremolo/TremoloModulation.png
