Niclasapdk/esd6_project/gitfigures/system_design/Wah/bandPassStruct.png

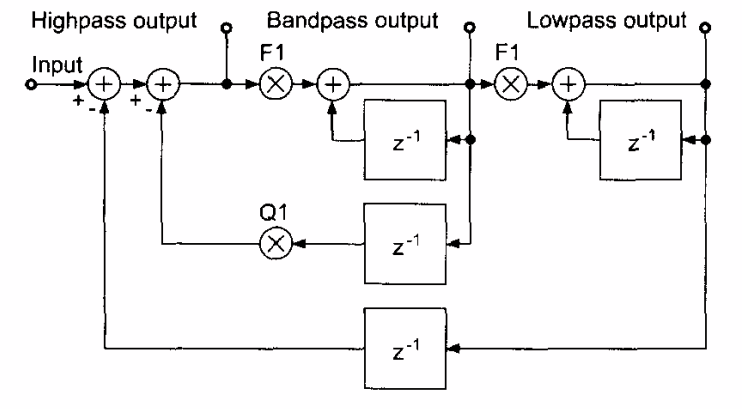
gitfigures/system_design/Wah/bandPassStruct.png
