Niclasapdk/esd6_project/gitfigures/system_design/Wah/bandpassWah.png

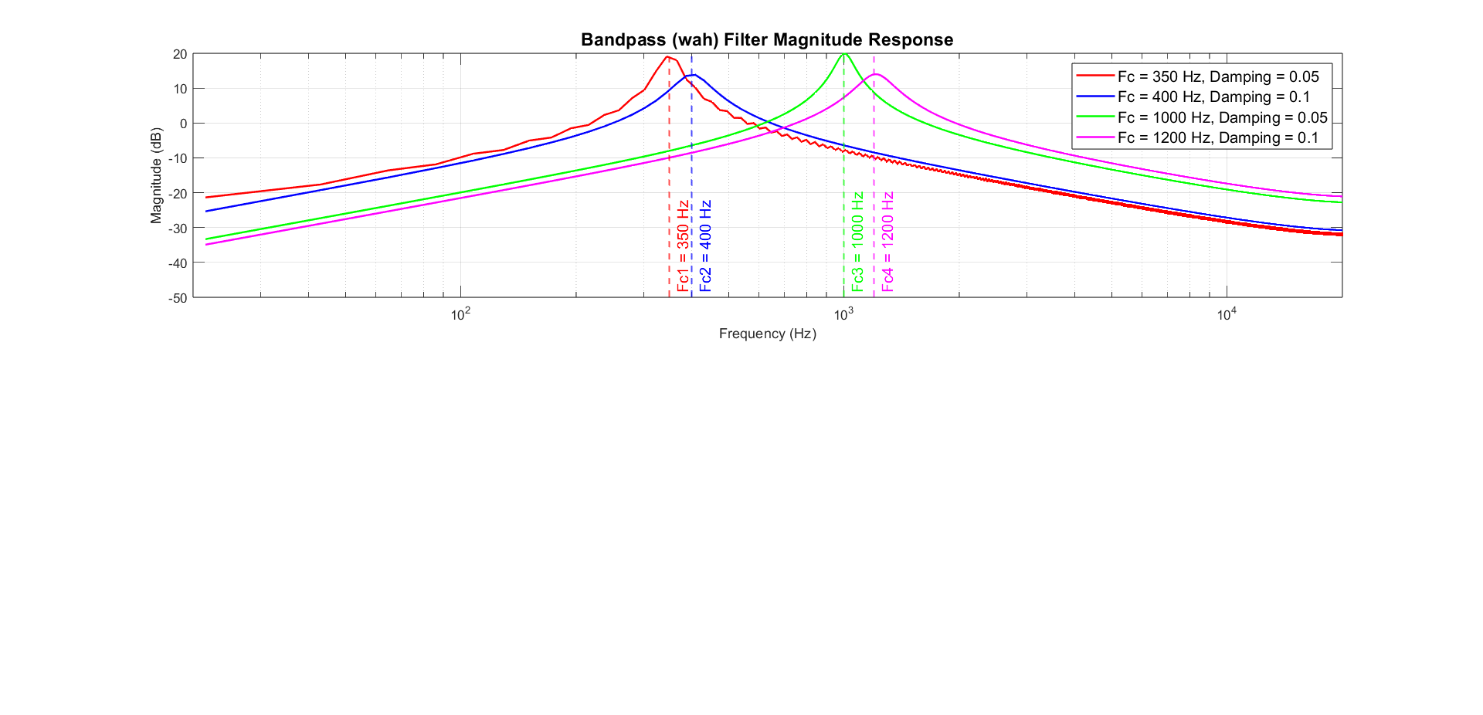
gitfigures/system_design/Wah/bandpassWah.png
