Niclasapdk/esd6_project/gitfigures/system_design/Wah/bandpassWahFile.png

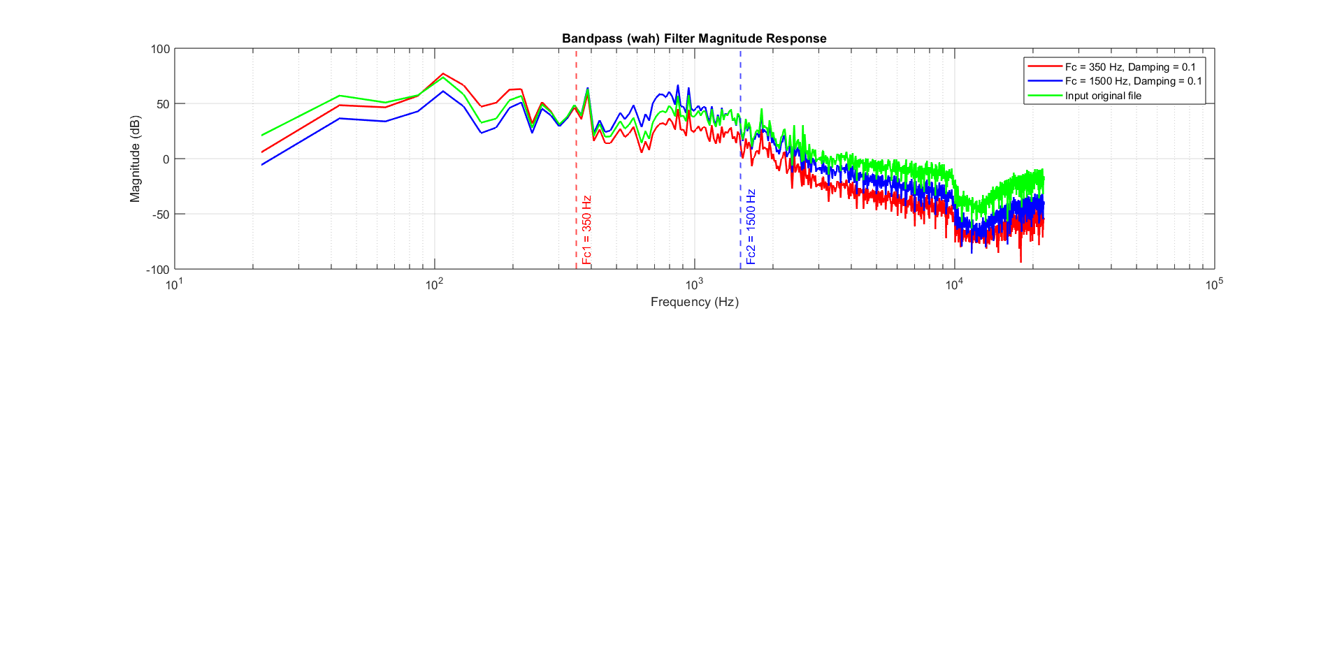
gitfigures/system_design/Wah/bandpassWahFile.png
