Niclasapdk/esd6_project/gitfigures/system_design/Wah/frequencyReponseCryBaby.png

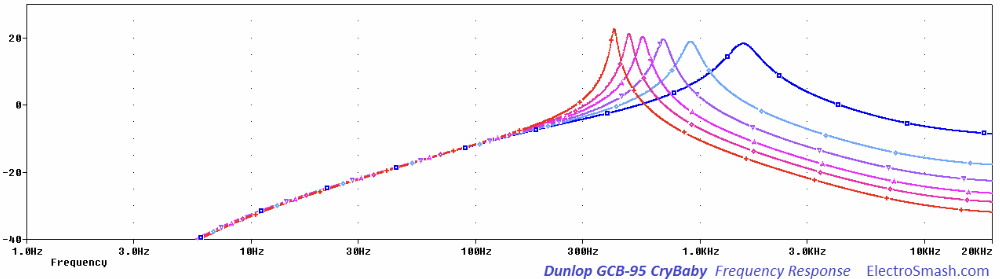
gitfigures/system_design/Wah/frequencyReponseCryBaby.png
