Niclasapdk/esd6_project/gitfigures/system_design/Wah/SinVsTaylorVsMatrix.png

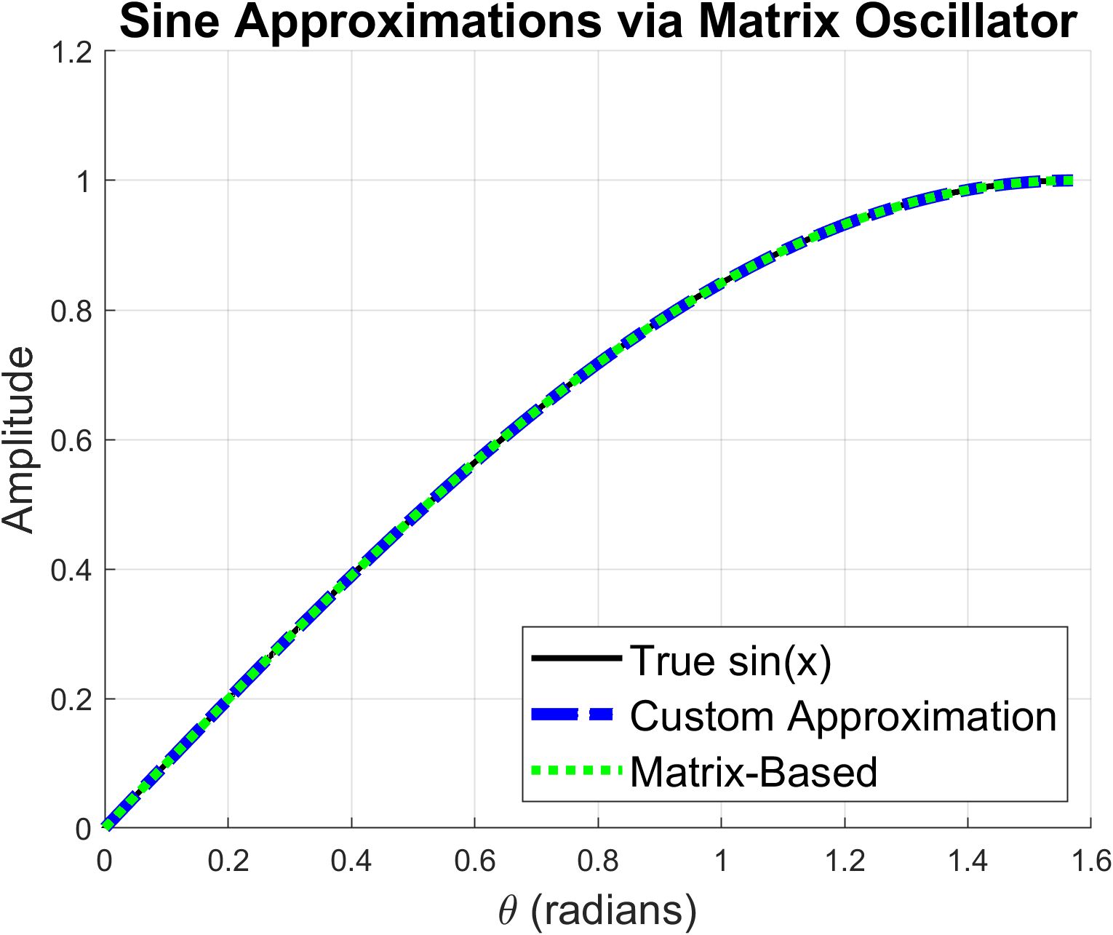
gitfigures/system_design/Wah/SinVsTaylorVsMatrix.png
