Niclasapdk/esd6_project/gitfigures/system_design/Wah/TaylorVSsin.png

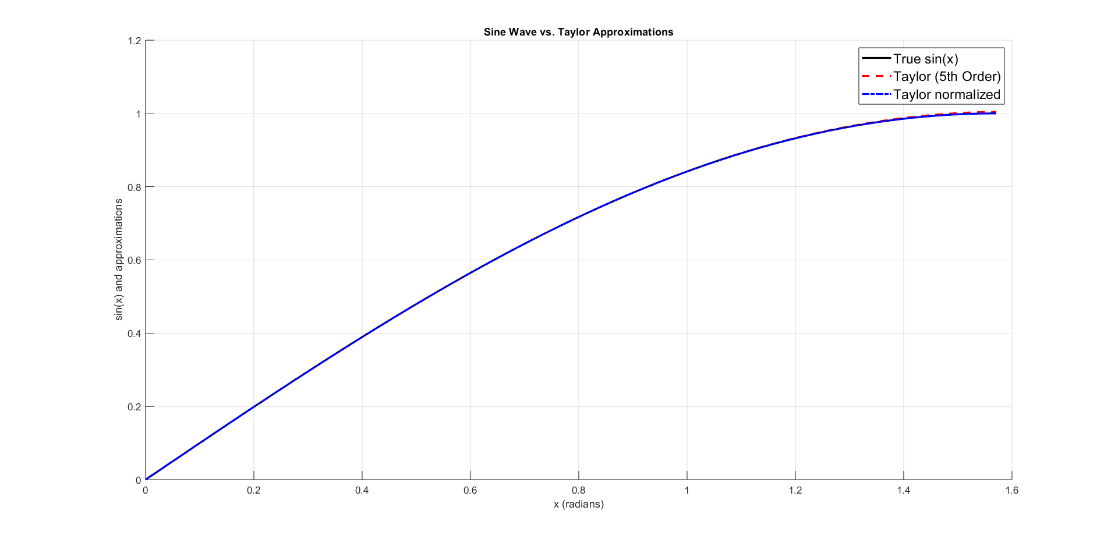
gitfigures/system_design/Wah/TaylorVSsin.png
