Niclasapdk/esd6_project/gitfigures/system_design/Wah/TaylorVSsinNotnorm.png

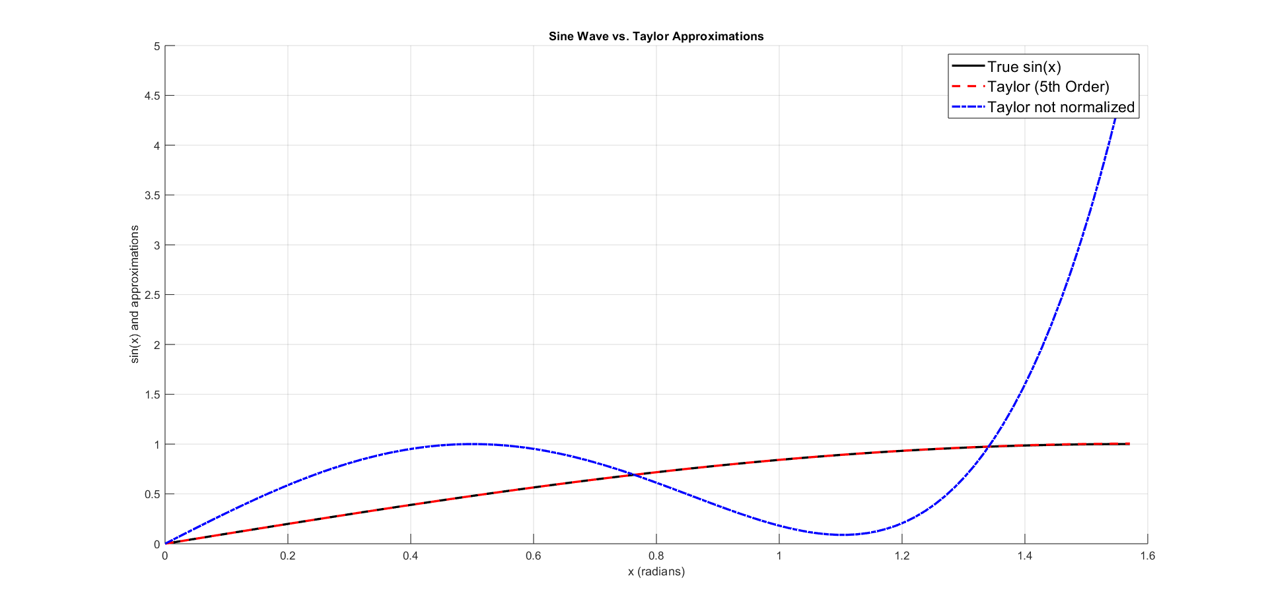
gitfigures/system_design/Wah/TaylorVSsinNotnorm.png
