Niclasapdk/esd6_project/system_design/reverb/matlab_plots/tap7_g1_rt4_wgn.png

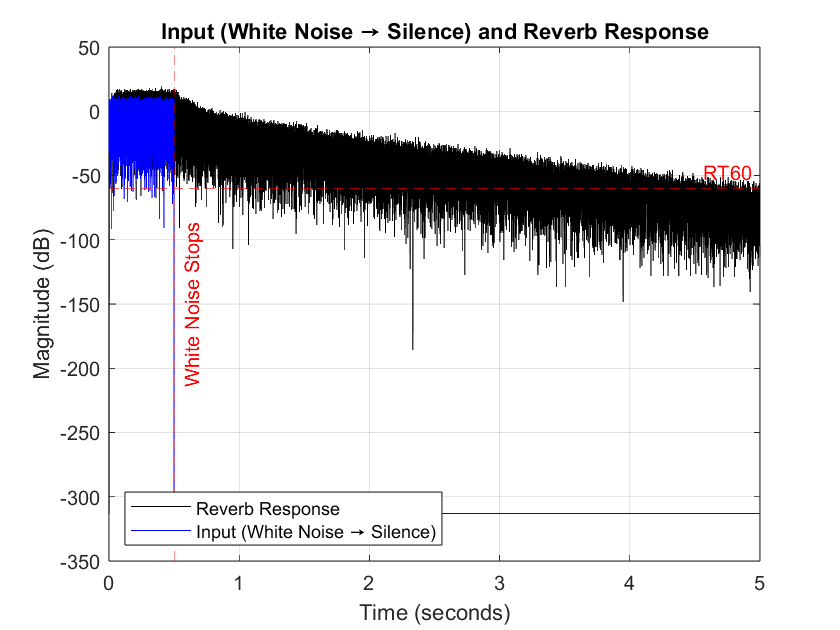
system_design/reverb/matlab_plots/tap7_g1_rt4_wgn.png
