Niclasapdk/esd6_project/gitfigures/problem_analysis/electric-guitar-parts.png

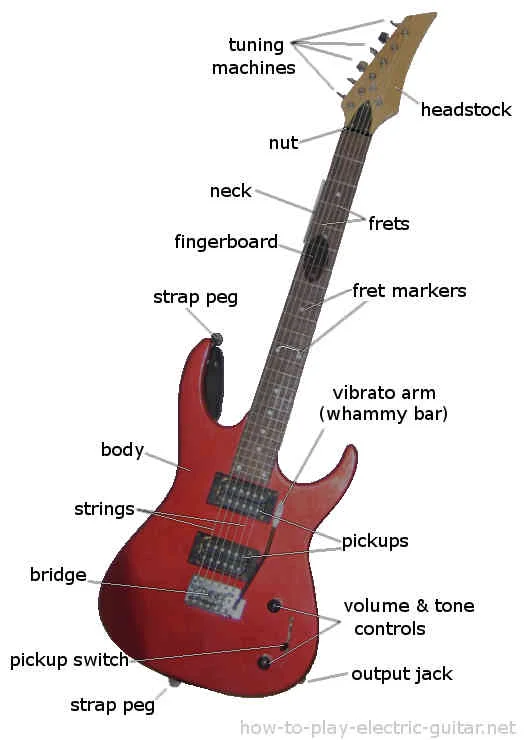
gitfigures/problem_analysis/electric-guitar-parts.png
