Niclasapdk/esd6_project/gitfigures/problem_analysis/Parts-of-an-Electric-Guitar.jpg

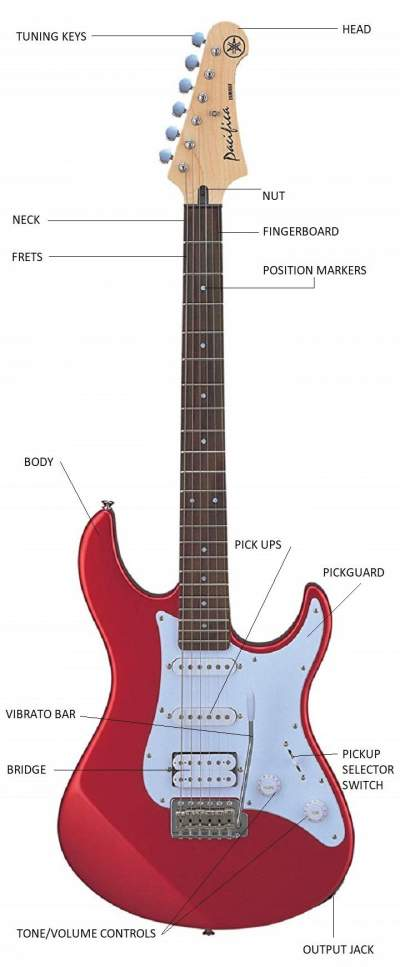
gitfigures/problem_analysis/Parts-of-an-Electric-Guitar.jpg
