Niclasapdk/esd6_project/gitfigures/system_design/overdrive/dafx_wdf_components.jpg

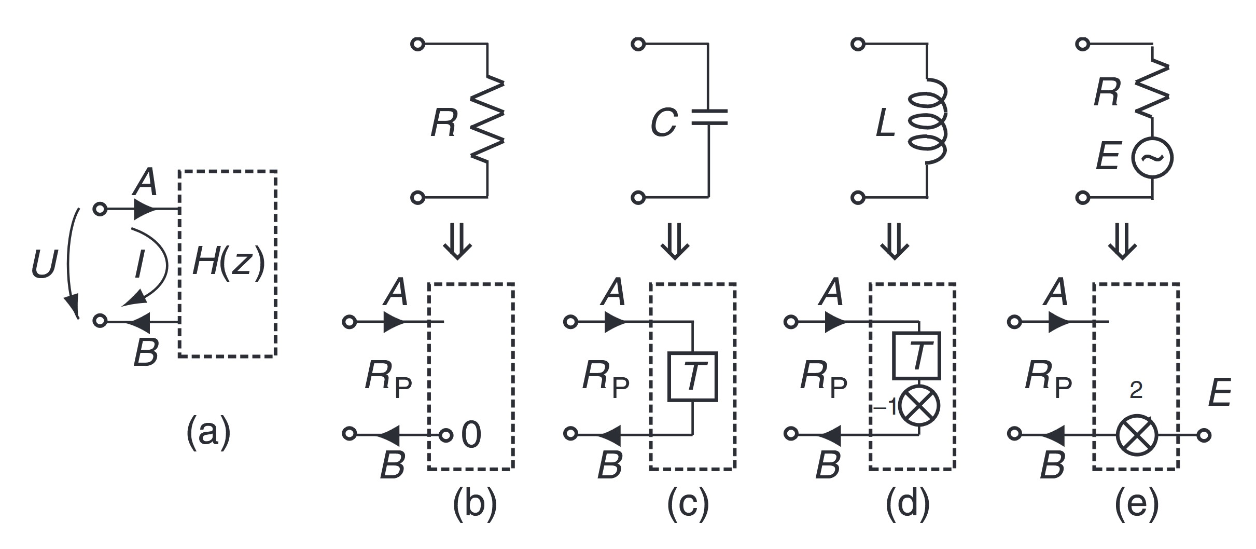
gitfigures/system_design/overdrive/dafx_wdf_components.jpg
