Niclasapdk/esd6_project/gitfigures/guitar_measurement_fig/guitar_imp_setup.png

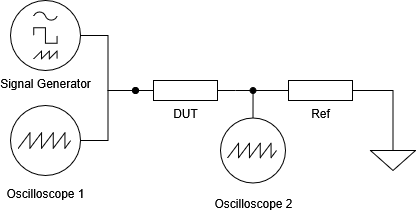
gitfigures/guitar_measurement_fig/guitar_imp_setup.png
