Niclasapdk/esd6_project/gitfigures/problem_analysis/analdiscov_ampl_setup.png

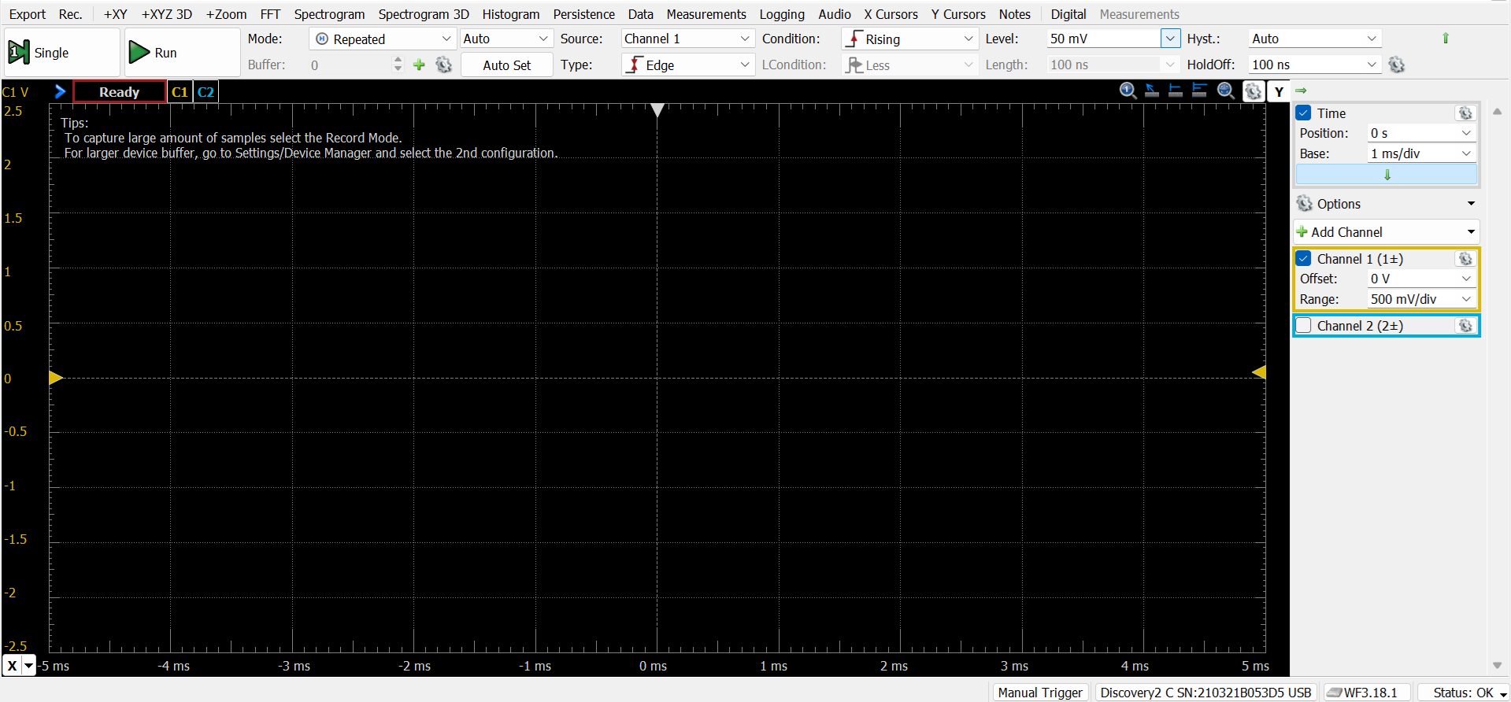
gitfigures/problem_analysis/analdiscov_ampl_setup.png
