Niclasapdk/esd6_project/gitfigures/problem_analysis/pickup_construction.png

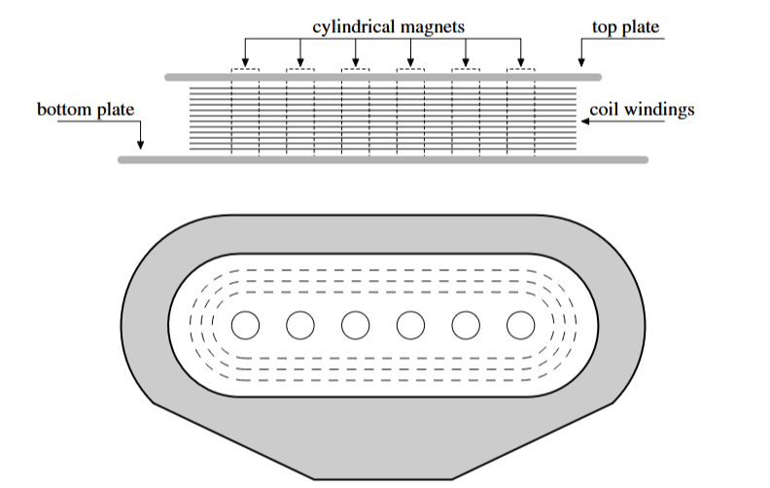
gitfigures/problem_analysis/pickup_construction.png
