Niclasapdk/esd6_project/gitfigures/system_design/tms320c55/instruction_unit_diagram.png

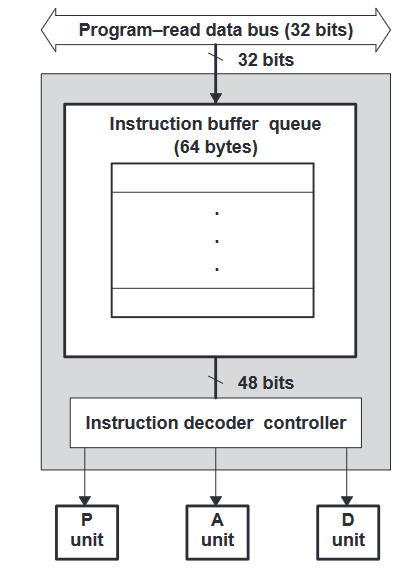
gitfigures/system_design/tms320c55/instruction_unit_diagram.png
