Niclasapdk/esd6_project/system_design/chorus/lfo_chorus_20hz_cos_sin_test.txt

32753	-934
32714	-1867
32647	-2799
32554	-3728
32435	-4655
32288	-5577
32117	-6494
31919	-7408
31694	-8314
31445	-9214
31170	-10106
30868	-10990
30543	-11866
30192	-12731
29818	-13587
29419	-14431
28995	-15264
28548	-16084
28078	-16890
27586	-17683
27070	-18463
26534	-19226
25974	-19976
25394	-20707
24794	-21423
24174	-22121
23533	-22801
22874	-23462
22197	-24104
21501	-24728
20787	-25330
20057	-25913
19310	-26473
18548	-27013
17770	-27530
16978	-28025
16174	-28498
15355	-28947
14523	-29373
13680	-29775
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
