Niclasapdk/esd6_project/system_design/tremolo/lfo_tremolo_10hz_test.txt

32763
32753
32736
32714
32684
32647
32604
32554
32497
32435
32365
32290
32206
32117
32021
31919
31810
31694
31573
31445
31311
31170
31022
30870
30710
30543
30372
30194
30008
29818
29621
29419
29211
28996
28775
28549
28317
28080
27836
27586
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
