Niclasapdk/esd6_project/system_design/flanger/lfo_flanger_1hz_test.txt

32766
32766
32766
32766
32766
32766
32765
32765
32765
32763
32763
32762
32760
32760
32759
32758
32758
32756
32755
32753
32752
32751
32749
32748
32746
32745
32742
32741
32739
32736
32735
32732
32731
32728
32727
32724
32721
32719
32717
32714
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
