Niclasapdk/esd6_project/system_design/tremolo/tremolo_depth_0.5_test.csv

#Digilent WaveForms Oscilloscope Acquisition
#Device Name: Discovery2
#Serial Number: SN:210321B053D5
#Date Time: 2025-05-01 16:34:53.300
#Sample rate: 16000Hz
#Samples: 8192
#Trigger: Source: Channel 1 Type: Edge Condition: Rising Level: 0 V Hyst.: Auto HoldOff: 0 s
#Channel 1: Range: 500 mV/div Offset: 0 V Sample Mode: Average
#Wavegen Channel 1: Running
#Mode: Simple
#Type: Sine
#Frequency: 1 kHz
#Period: 1 ms
#Amplitude: 700 mV
#Offset: 0 V
#Symmetry: 50 %
#Phase: 0 °
Time (s) | Channel 1 (V)
0.1734600474683545 | -0.08705799634356627
0.1735225474683545 | 0.01287959300702066
0.1735850474683545 | 0.1121531452189304
0.1736475474683545 | 0.1988099917986811
0.1737100474683545 | 0.2569132414210999
0.1737725474683545 | 0.2804865598393233
0.1738350474683545 | 0.2652137056528618
0.1738975474683545 | 0.2127547717080829
0.1739600474683545 | 0.131078203667417
0.1740225474683545 | 0.03346474430172696
0.1740850474683545 | -0.06448073363310033
0.1741475474683545 | -0.1488134502279542
0.1742100474683545 | -0.2072487184196437
0.1742725474683545 | -0.2304900182685963
0.1743350474683545 | -0.2152171640821348
0.1743975474683545 | -0.1624262115680853
0.1744600474683545 | -0.08307377351231543
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
