Niclasapdk/esd6_project/system_design/tremolo/tremolo_depth_1_test.csv

#Digilent WaveForms Oscilloscope Acquisition
#Device Name: Discovery2
#Serial Number: SN:210321B053D5
#Date Time: 2025-05-01 16:34:05.195
#Sample rate: 16000Hz
#Samples: 8192
#Trigger: Source: Channel 1 Type: Edge Condition: Rising Level: 0 V Hyst.: Auto HoldOff: 0 s
#Channel 1: Range: 500 mV/div Offset: 0 V Sample Mode: Average
#Wavegen Channel 1: Running
#Mode: Simple
#Type: Sine
#Frequency: 1 kHz
#Period: 1 ms
#Amplitude: 700 mV
#Offset: 0 V
#Symmetry: 50 %
#Phase: 0 °
Time (s) | Channel 1 (V)
0.173496568627451 | -0.05385613941647598
0.173559068627451 | 0.1556475777935494
0.173621568627451 | 0.3439021065699802
0.173684068627451 | 0.4826858685253032
0.173746568627451 | 0.551081693795103
0.173809068627451 | 0.5374689324550022
0.173871568627451 | 0.4474919001825875
0.173934068627451 | 0.2917751911946048
0.173996568627451 | 0.09522019818615944
0.174059068627451 | -0.1122914076082396
0.174121568627451 | -0.2985538249690467
0.174184068627451 | -0.4353454755087434
0.174246568627451 | -0.5014171707936478
0.174309068627451 | -0.4894645022999006
0.174371568627451 | -0.4001515071660277
0.174434068627451 | -0.2457628724551281
0.174496568627451 | -0.05153200943157965
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
