Niclasapdk/esd6_project/gitfigures/system_design/analog_frontend/amplifier_frequency_response_test/loop_output.csv

# | Frequency (Hz) | Amplitude (Vpp) | Gain (dB) | Phase (°)
1 | 20.0 | 0.7000 | 7.82 | 5.38
2 | 21.1 | 0.7000 | 7.83 | 5.16
3 | 22.4 | 0.7000 | 7.84 | 4.92
4 | 23.7 | 0.7000 | 7.85 | 4.62
5 | 25.1 | 0.7000 | 7.86 | 4.40
6 | 26.6 | 0.7000 | 7.87 | 4.24
7 | 28.2 | 0.7000 | 7.88 | 4.00
8 | 29.9 | 0.7000 | 7.89 | 3.77
9 | 31.6 | 0.7000 | 7.89 | 3.55
10 | 33.5 | 0.7000 | 7.90 | 3.38
11 | 35.5 | 0.7000 | 7.91 | 3.21
12 | 37.6 | 0.7000 | 7.92 | 3.02
13 | 39.8 | 0.7000 | 7.92 | 2.82
14 | 42.2 | 0.7000 | 7.93 | 2.68
15 | 44.7 | 0.7000 | 7.94 | 2.48
16 | 47.3 | 0.7000 | 7.93 | 2.35
17 | 50.1 | 0.7000 | 7.93 | 2.22
18 | 53.1 | 0.7000 | 7.95 | 2.05
19 | 56.2 | 0.7000 | 7.95 | 1.90
20 | 59.6 | 0.7000 | 7.94 | 1.77
21 | 63.1 | 0.7000 | 7.94 | 1.60
22 | 66.8 | 0.7000 | 7.96 | 1.55
23 | 70.8 | 0.7000 | 7.95 | 1.37
24 | 75.0 | 0.7000 | 7.95 | 1.25
25 | 79.4 | 0.7000 | 7.96 | 1.16
26 | 84.1 | 0.7000 | 7.96 | 1.05
27 | 89.1 | 0.7000 | 7.95 | 0.91
28 | 94.4 | 0.7000 | 7.96 | 0.86
29 | 100.0 | 0.7000 | 7.94 | 0.79
30 | 105.9 | 0.7000 | 7.94 | 0.69
31 | 112.2 | 0.7000 | 7.95 | 0.64
32 | 118.9 | 0.7000 | 7.96 | 0.56
33 | 125.9 | 0.7000 | 7.94 | 0.42
34 | 133.4 | 0.7000 | 7.95 | 0.36
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
