Niclasapdk/esd6_project/gitfigures/system_design/analog_frontend/amplifier_frequency_response_test/pre_input.csv

# | Frequency (Hz) | Amplitude (Vpp) | Gain (dB) | Phase (°)
1 | 20.0 | 1.7000 | -7.96 | 1.05
2 | 21.1 | 1.7000 | -7.95 | 1.03
3 | 22.4 | 1.7000 | -7.95 | 0.95
4 | 23.7 | 1.7000 | -7.93 | 0.98
5 | 25.1 | 1.7000 | -7.93 | 0.97
6 | 26.6 | 1.7000 | -7.92 | 0.92
7 | 28.2 | 1.7000 | -7.91 | 0.86
8 | 29.9 | 1.7000 | -7.90 | 0.86
9 | 31.6 | 1.7000 | -7.90 | 0.80
10 | 33.5 | 1.7000 | -7.89 | 0.75
11 | 35.5 | 1.7000 | -7.88 | 0.75
12 | 37.6 | 1.7000 | -7.88 | 0.65
13 | 39.8 | 1.7000 | -7.87 | 0.64
14 | 42.2 | 1.7000 | -7.86 | 0.57
15 | 44.7 | 1.7000 | -7.86 | 0.47
16 | 47.3 | 1.7000 | -7.86 | 0.46
17 | 50.1 | 1.7000 | -7.85 | 0.40
18 | 53.1 | 1.7000 | -7.84 | 0.36
19 | 56.2 | 1.7000 | -7.85 | 0.29
20 | 59.6 | 1.7000 | -7.85 | 0.23
21 | 63.1 | 1.7000 | -7.85 | 0.17
22 | 66.8 | 1.7000 | -7.85 | 0.12
23 | 70.8 | 1.7000 | -7.85 | 0.05
24 | 75.0 | 1.7000 | -7.85 | 0.04
25 | 79.4 | 1.7000 | -7.86 | 0.00
26 | 84.1 | 1.7000 | -7.85 | -0.06
27 | 89.1 | 1.7000 | -7.86 | -0.11
28 | 94.4 | 1.7000 | -7.85 | -0.16
29 | 100.0 | 1.7000 | -7.86 | -0.18
30 | 105.9 | 1.7000 | -7.85 | -0.23
31 | 112.2 | 1.7000 | -7.86 | -0.27
32 | 118.9 | 1.7000 | -7.87 | -0.29
33 | 125.9 | 1.7000 | -7.86 | -0.35
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
