Niclasapdk/esd6_project/gitfigures/system_design/analog_frontend/amplifier_frequency_response_test/pre_output.csv

# | Frequency (Hz) | Amplitude (Vpp) | Gain (dB) | Phase (°)
1 | 20.0 | 0.7000 | 7.72 | 5.45
2 | 21.1 | 0.7000 | 7.73 | 5.20
3 | 22.4 | 0.7000 | 7.75 | 4.86
4 | 23.7 | 0.7000 | 7.75 | 4.68
5 | 25.1 | 0.7000 | 7.77 | 4.42
6 | 26.6 | 0.7000 | 7.76 | 4.23
7 | 28.2 | 0.7000 | 7.78 | 4.01
8 | 29.9 | 0.7000 | 7.79 | 3.77
9 | 31.6 | 0.7000 | 7.79 | 3.60
10 | 33.5 | 0.7000 | 7.79 | 3.40
11 | 35.5 | 0.7000 | 7.82 | 3.21
12 | 37.6 | 0.7000 | 7.81 | 3.05
13 | 39.8 | 0.7000 | 7.82 | 2.85
14 | 42.2 | 0.7000 | 7.82 | 2.71
15 | 44.7 | 0.7000 | 7.84 | 2.53
16 | 47.3 | 0.7000 | 7.85 | 2.39
17 | 50.1 | 0.7000 | 7.83 | 2.20
18 | 53.1 | 0.7000 | 7.84 | 2.05
19 | 56.2 | 0.7000 | 7.84 | 1.93
20 | 59.6 | 0.7000 | 7.85 | 1.78
21 | 63.1 | 0.7000 | 7.85 | 1.62
22 | 66.8 | 0.7000 | 7.85 | 1.51
23 | 70.8 | 0.7000 | 7.86 | 1.37
24 | 75.0 | 0.7000 | 7.86 | 1.25
25 | 79.4 | 0.7000 | 7.85 | 1.20
26 | 84.1 | 0.7000 | 7.85 | 1.05
27 | 89.1 | 0.7000 | 7.85 | 0.98
28 | 94.4 | 0.7000 | 7.85 | 0.80
29 | 100.0 | 0.7000 | 7.85 | 0.75
30 | 105.9 | 0.7000 | 7.85 | 0.69
31 | 112.2 | 0.7000 | 7.84 | 0.57
32 | 118.9 | 0.7000 | 7.85 | 0.57
33 | 125.9 | 0.7000 | 7.84 | 0.46
34 | 133.4 | 0.7000 | 7.85 | 0.36
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
