Niclasapdk/esd6_project/gitfigures/ImplementationTest/12Mhz_clock_before_change.csv

#Digilent WaveForms Oscilloscope Acquisition
#Device Name: Discovery2
#Serial Number: SN:210321B053D5
#Date Time: 2025-05-09 15:35:09.660
#Sample rate: 1e+08Hz
#Samples: 8192
#Trigger: Source: Channel 2 Type: Edge Condition: Rising Level: 280 mV Hyst.: Auto HoldOff: 0 s
#Channel 1: Range: 200 mV/div Offset: 0 V Sample Mode: Average
#Channel 2: Range: 100 mV/div Offset: 0 V Sample Mode: Average
#Wavegen Channel 1: Enabled
#Mode: Simple
#Type: Sine
#Frequency: 1 kHz
#Period: 1 ms
#Amplitude: 250 mV
#Offset: 0 V
#Symmetry: 50 %
#Phase: 0 °
Time (s) | Channel 1 (V) | Channel 2 (V)
-2.589756097560977e-06 | 0.001922980221035721 | 0.2894802127259219
-2.579756097560975e-06 | -0.009365651134174979 | 0.2416894235377081
-2.569756097560974e-06 | -0.00172922404094391 | 0.03891044996827674
-2.559756097560979e-06 | -0.001065186902402708 | 0.04787122294105871
-2.549756097560977e-06 | -0.004053354025840532 | 0.03758292804637784
-2.539756097560976e-06 | 0.001922980221035721 | 0.07143473705469602
-2.529756097560974e-06 | -0.003721335456569629 | 0.2831744835969215
-2.519756097560979e-06 | -0.002725279748757374 | 0.2801875592726595
-2.509756097560978e-06 | 0.002254998790306624 | 0.2878208103235534
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
