Niclasapdk/esd6_project/gitfigures/ImplementationTest/acope_0wy12.csv

x-axis | 1
second | Volt
-250.0000E-09 | +37.7537533641E-03
-249.5000E-09 | -2.4472512305E-03
-249.0000E-09 | -2.4472512305E-03
-248.5000E-09 | -2.4472512305E-03
-248.0000E-09 | +37.7537533641E-03
-247.5000E-09 | +118.1557625532E-03
-247.0000E-09 | +238.7587763369E-03
-246.5000E-09 | +399.5627947151E-03
-246.0000E-09 | +640.7688222825E-03
-245.5000E-09 | +922.1758544444E-03
-245.0000E-09 | +1.2437838912009E+00
-244.5000E-09 | +1.6055929325520E+00
-244.0000E-09 | +1.9674019739030E+00
-243.5000E-09 | +2.3292110152541E+00
-243.0000E-09 | +2.6910200566052E+00
-242.5000E-09 | +2.9724270887672E+00
-242.0000E-09 | +3.2136331163346E+00
-241.5000E-09 | +3.3744371347128E+00
-241.0000E-09 | +3.4950401484966E+00
-240.5000E-09 | +3.5754421576857E+00
-240.0000E-09 | +3.5754421576858E+00
-239.5000E-09 | +3.5754421576858E+00
-239.0000E-09 | +3.5754421576858E+00
-238.5000E-09 | +3.5352411530912E+00
-238.0000E-09 | +3.5352411530912E+00
-237.5000E-09 | +3.4950401484967E+00
-237.0000E-09 | +3.4950401484966E+00
-236.5000E-09 | +3.4548391439021E+00
-236.0000E-09 | +3.4548391439021E+00
-235.5000E-09 | +3.4146381393075E+00
-235.0000E-09 | +3.4146381393075E+00
-234.5000E-09 | +3.3744371347130E+00
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
