Niclasapdk/esd6_project/gitfigures/ImplementationTest/acope_0wy13.csv

x-axis | 1
second | Volt
-50.0000E-09 | +1.5855709478419E+00
-49.8438E-09 | +1.6659729570310E+00
-49.6875E-09 | +1.7488875290073E+00
-49.5313E-09 | +1.8318021009836E+00
-49.3750E-09 | +1.9147166729599E+00
-49.2188E-09 | +1.9976312449362E+00
-49.0625E-09 | +2.0805458169125E+00
-48.9063E-09 | +2.1609478261016E+00
-48.7500E-09 | +2.2363247097164E+00
-48.5938E-09 | +2.3091890305441E+00
-48.4375E-09 | +2.3795407885846E+00
-48.2813E-09 | +2.4398422954764E+00
-48.1250E-09 | +2.4976312395811E+00
-47.9688E-09 | +2.5478824953243E+00
-47.8125E-09 | +2.5855709371317E+00
-47.6563E-09 | +2.6182342533648E+00
-47.5000E-09 | +2.6433598812364E+00
-47.3438E-09 | +2.6559226951722E+00
-47.1875E-09 | +2.6634603835337E+00
-47.0313E-09 | +2.6584352579594E+00
-46.8750E-09 | +2.6433598812364E+00
-46.7188E-09 | +2.6207468161520E+00
-46.5625E-09 | +2.5905960627060E+00
-46.4063E-09 | +2.5529076208986E+00
-46.2500E-09 | +2.5051689279426E+00
-46.0938E-09 | +2.4524051094122E+00
-45.9375E-09 | +2.3946161653075E+00
-45.7813E-09 | +2.3267769700542E+00
-45.6250E-09 | +2.2564252120137E+00
-45.4688E-09 | +2.1835608911861E+00
-45.3125E-09 | +2.1081840075713E+00
-45.1563E-09 | +2.0277819983822E+00
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
