Niclasapdk/esd6_project/gitfigures/ImplementationTest/allfx_computationtime.csv

#Digilent WaveForms Oscilloscope Acquisition
#Device Name: Discovery2
#Serial Number: SN:210321B053D5
#Date Time: 2025-05-15 15:19:24.210
#Sample rate: 1.42857e+07Hz
#Samples: 8192
#Trigger: Source: Channel 1 Type: Edge Condition: Rising Level: 0 V Hyst.: Auto HoldOff: 0 s
#Channel 1: Range: 1 V/div Offset: 0 V Sample Mode: Average
#Channel 2: Range: 1 V/div Offset: 0 V Sample Mode: Average
Time (s) | Channel 1 (V) | Channel 2 (V)
-0.0004168335816625773 | 3.295104975449817 | 3.292971711145221
-0.0004167635816625773 | 3.298754638508367 | 3.296619984814881
-0.0004166935816625773 | 3.30240430156691 | 3.289323437475564
-0.0004166235816625773 | 3.287805649332717 | 3.292971711145221
-0.0004165535816625773 | 3.287805649332717 | 3.285675163805902
-0.0004164835816625773 | 3.306053964625463 | 3.285675163805904
-0.0004164135816625773 | 3.298754638508367 | 3.289323437475562
-0.0004163435816625773 | 3.298754638508367 | 3.292971711145221
-0.0004162735816625773 | 3.295104975449815 | 3.285675163805902
-0.0004162035816625773 | 3.291455312391268 | 3.285675163805902
-0.0004161335816625773 | 3.295104975449817 | 3.292971711145221
-0.0004160635816625773 | 3.295104975449815 | 3.296619984814878
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
