Niclasapdk/esd6_project/gitfigures/ImplementationTest/allfxfiroverdrive_computationtime.csv

#Digilent WaveForms Oscilloscope Acquisition
#Device Name: Discovery2
#Serial Number: SN:210321B053D5
#Date Time: 2025-05-15 15:16:05.458
#Sample rate: 1.42857e+07Hz
#Samples: 8192
#Trigger: Source: Channel 1 Type: Edge Condition: Rising Level: 0 V Hyst.: Auto HoldOff: 0 s
#Channel 1: Range: 1 V/div Offset: 0 V Sample Mode: Average
#Channel 2: Range: 1 V/div Offset: 0 V Sample Mode: Average
Time (s) | Channel 1 (V) | Channel 2 (V)
-0.0004168343307853843 | 3.273206997098518 | 3.271082069127263
-0.0004167643307853843 | 3.280506323215618 | 3.271082069127263
-0.0004166943307853843 | 3.27320699709852 | 3.267433795457603
-0.0004166243307853843 | 3.276856660157068 | 3.267433795457603
-0.0004165543307853843 | 3.269557334039969 | 3.271082069127263
-0.0004164843307853843 | 3.280506323215615 | 3.274730342796917
-0.0004164143307853843 | 3.273206997098518 | 3.263785521787943
-0.0004163443307853843 | 3.280506323215618 | 3.267433795457603
-0.0004162743307853843 | 3.269557334039974 | 3.271082069127261
-0.0004162043307853843 | 3.280506323215618 | 3.267433795457603
-0.0004161343307853843 | 3.276856660157068 | 3.271082069127263
-0.0004160643307853843 | 3.276856660157066 | 3.267433795457601
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
