Niclasapdk/esd6_project/gitfigures/ImplementationTest/chorus_computationtime.csv

#Digilent WaveForms Oscilloscope Acquisition
#Device Name: Discovery2
#Serial Number: SN:210321B053D5
#Date Time: 2025-05-15 15:11:39.437
#Sample rate: 1.42857e+07Hz
#Samples: 8192
#Trigger: Source: Channel 1 Type: Edge Condition: Rising Level: 0 V Hyst.: Auto HoldOff: 0 s
#Channel 1: Range: 1 V/div Offset: 0 V Sample Mode: Average
#Channel 2: Range: 1 V/div Offset: 0 V Sample Mode: Average
Time (s) | Channel 1 (V) | Channel 2 (V)
-0.0004168313163709699 | 3.298754638508367 | 3.31850962683284
-0.0004167613163709699 | 3.302404301566917 | 3.32945444784182
-0.0004166913163709699 | 3.306053964625465 | 3.322157900502499
-0.0004166213163709699 | 3.302404301566917 | 3.31850962683284
-0.0004165513163709699 | 3.306053964625467 | 3.32580617417216
-0.0004164813163709699 | 3.302404301566917 | 3.329454447841818
-0.0004164113163709699 | 3.302404301566917 | 3.32580617417216
-0.0004163413163709699 | 3.302404301566917 | 3.32580617417216
-0.0004162713163709699 | 3.302404301566915 | 3.329454447841818
-0.0004162013163709699 | 3.298754638508367 | 3.32580617417216
-0.0004161313163709699 | 3.302404301566917 | 3.3221579005025
-0.0004160613163709699 | 3.298754638508364 | 3.322157900502502
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
