Niclasapdk/esd6_project/dsp_board/test_dsp_board/output_stage_figure.png

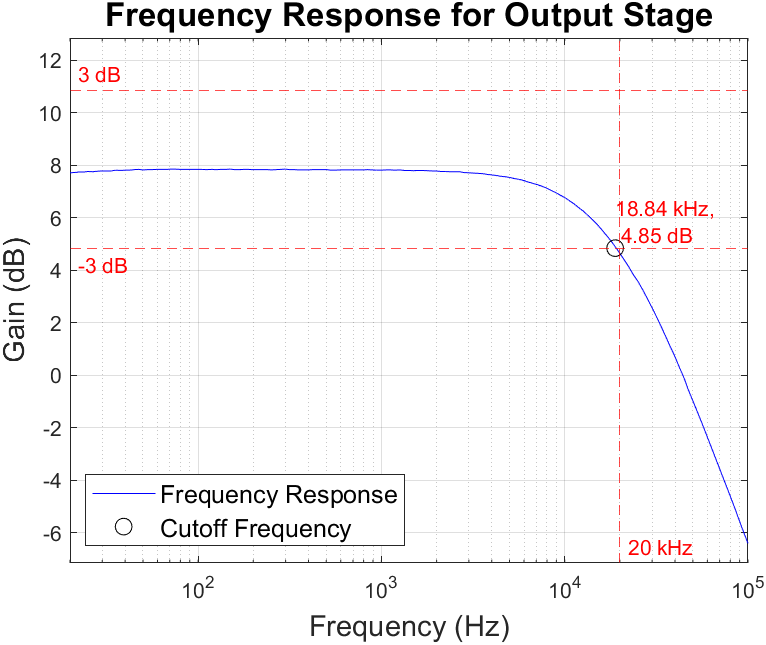
dsp_board/test_dsp_board/output_stage_figure.png
