Niclasapdk/esd6_project/gitfigures/guitar_measurement_fig/Bridge_Hard.png

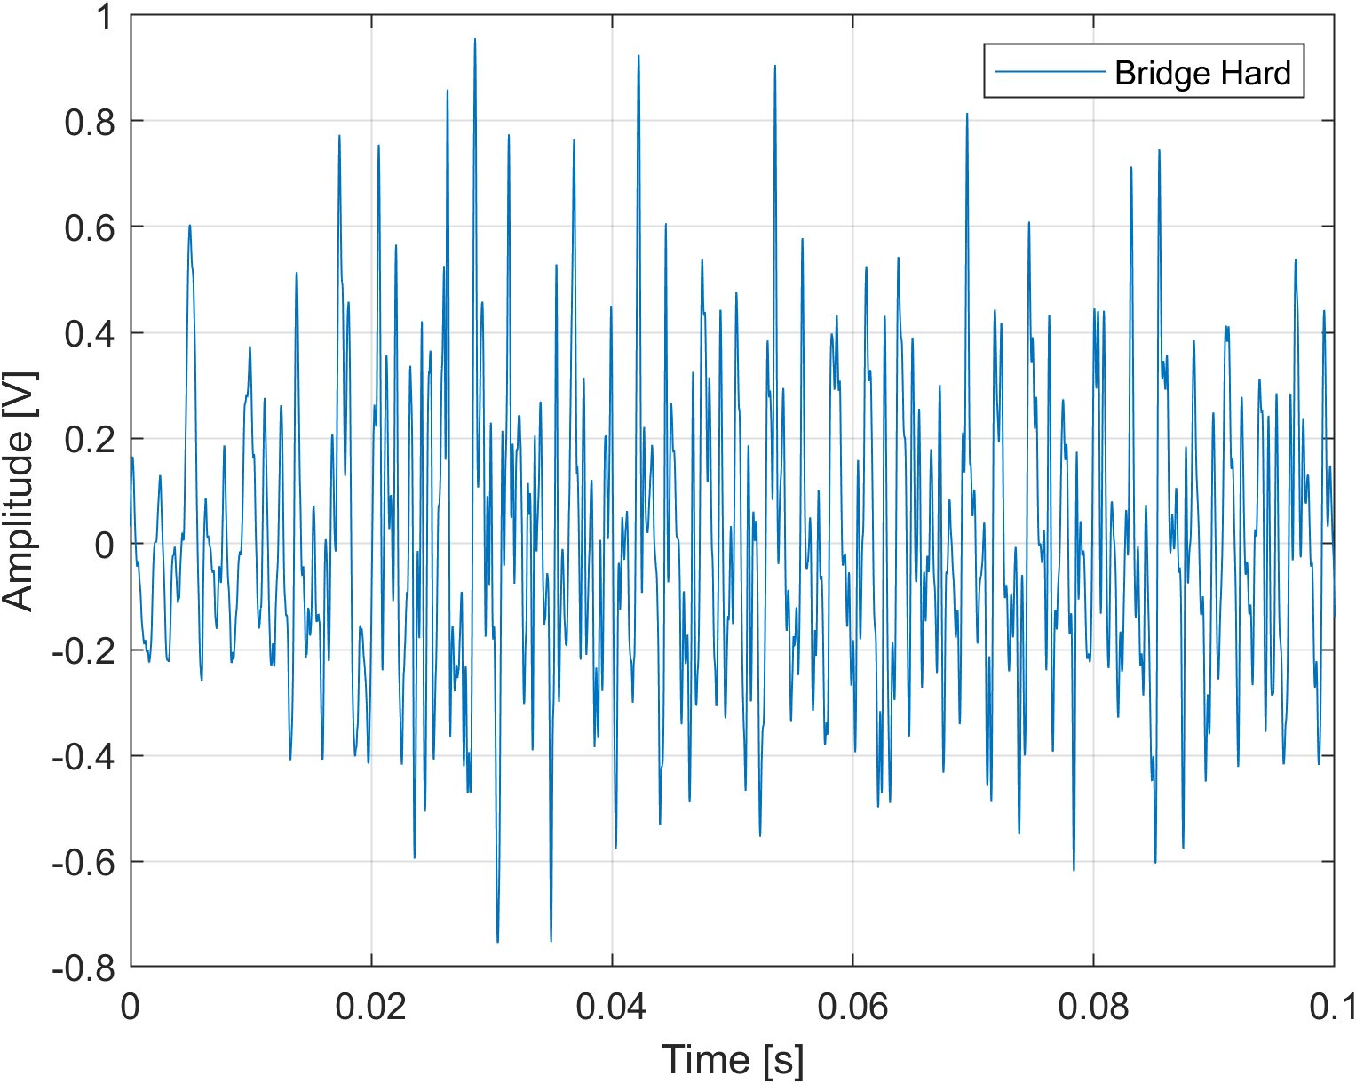
gitfigures/guitar_measurement_fig/Bridge_Hard.png
