Niclasapdk/esd6_project/gitfigures/guitar_measurement_fig/Bridge_Normal.png

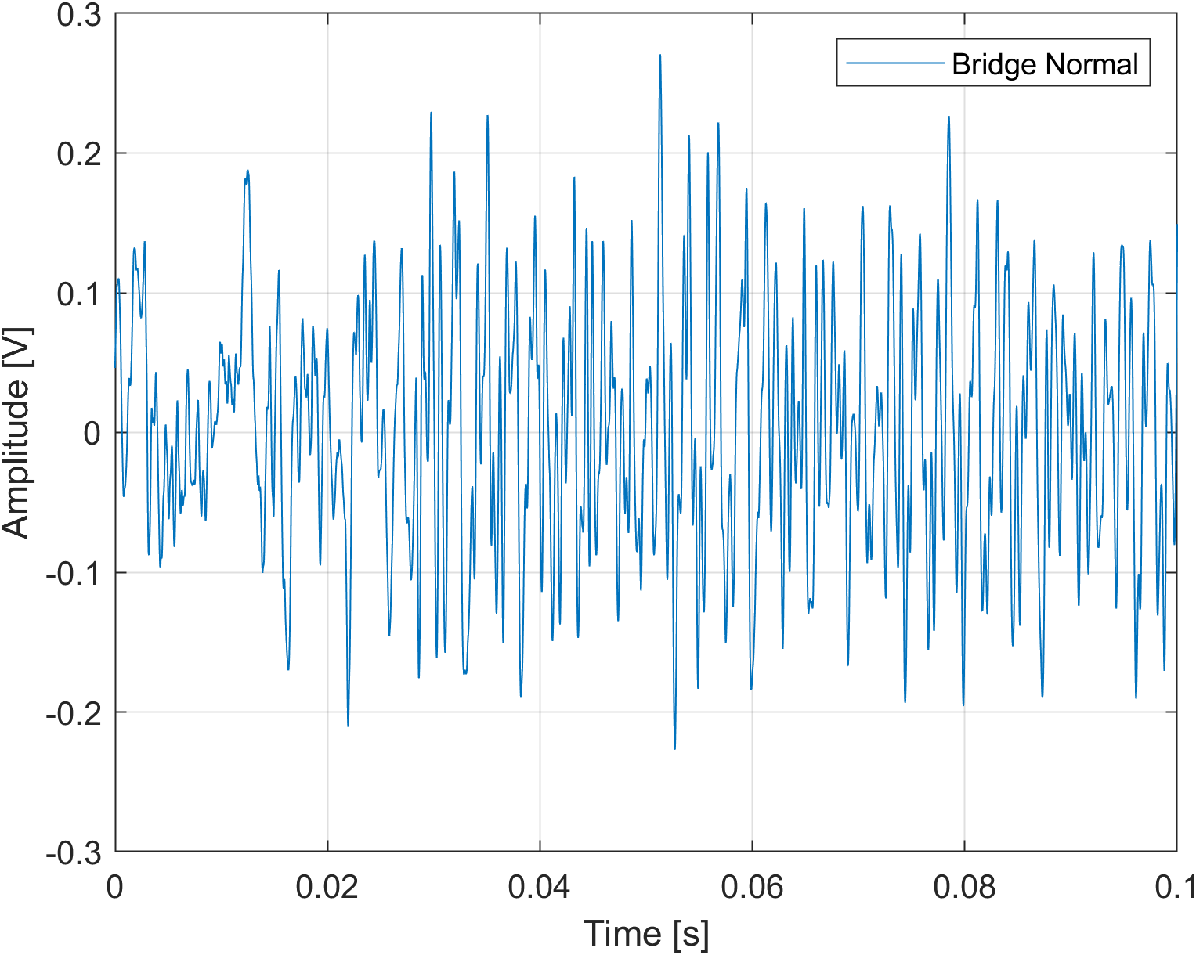
gitfigures/guitar_measurement_fig/Bridge_Normal.png
