Niclasapdk/esd6_project/gitfigures/guitar_measurement_fig/guitar_impedance_measurement.png

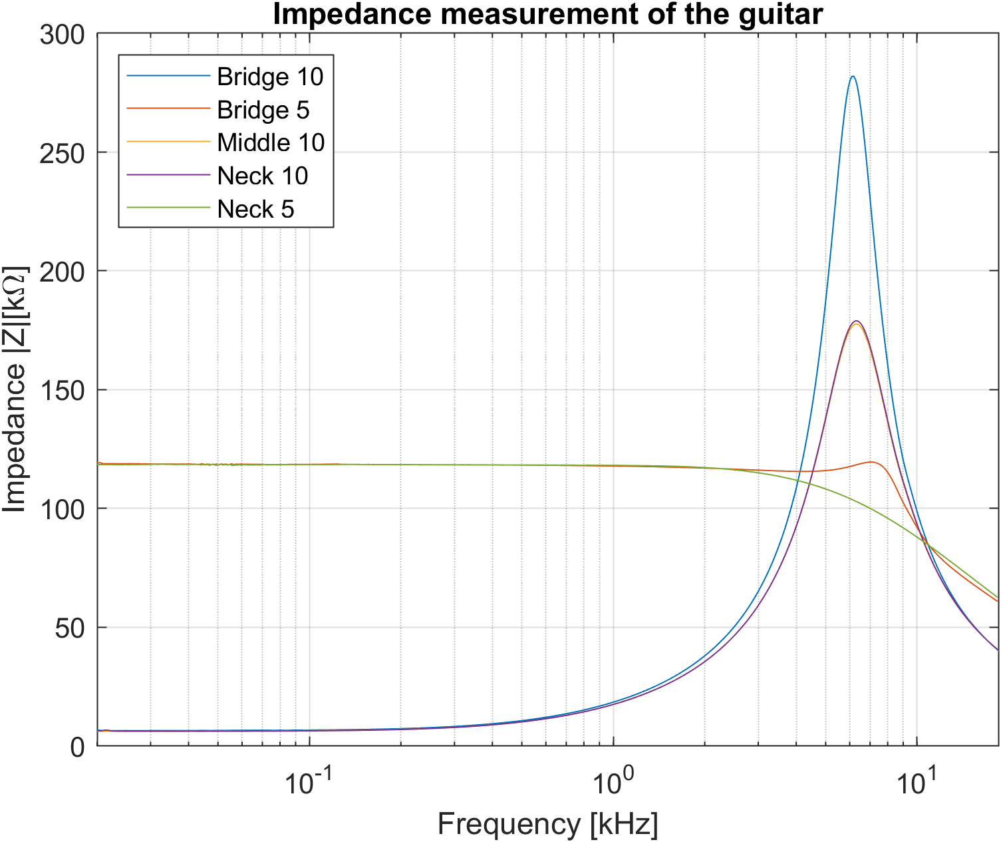
gitfigures/guitar_measurement_fig/guitar_impedance_measurement.png
