Niclasapdk/esd6_project/gitfigures/guitar_measurement_fig/guitar_measurement.png

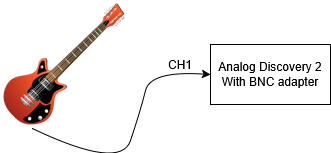
gitfigures/guitar_measurement_fig/guitar_measurement.png
