Niclasapdk/esd6_project/gitfigures/guitar_measurement_fig/Middle_Hard.png

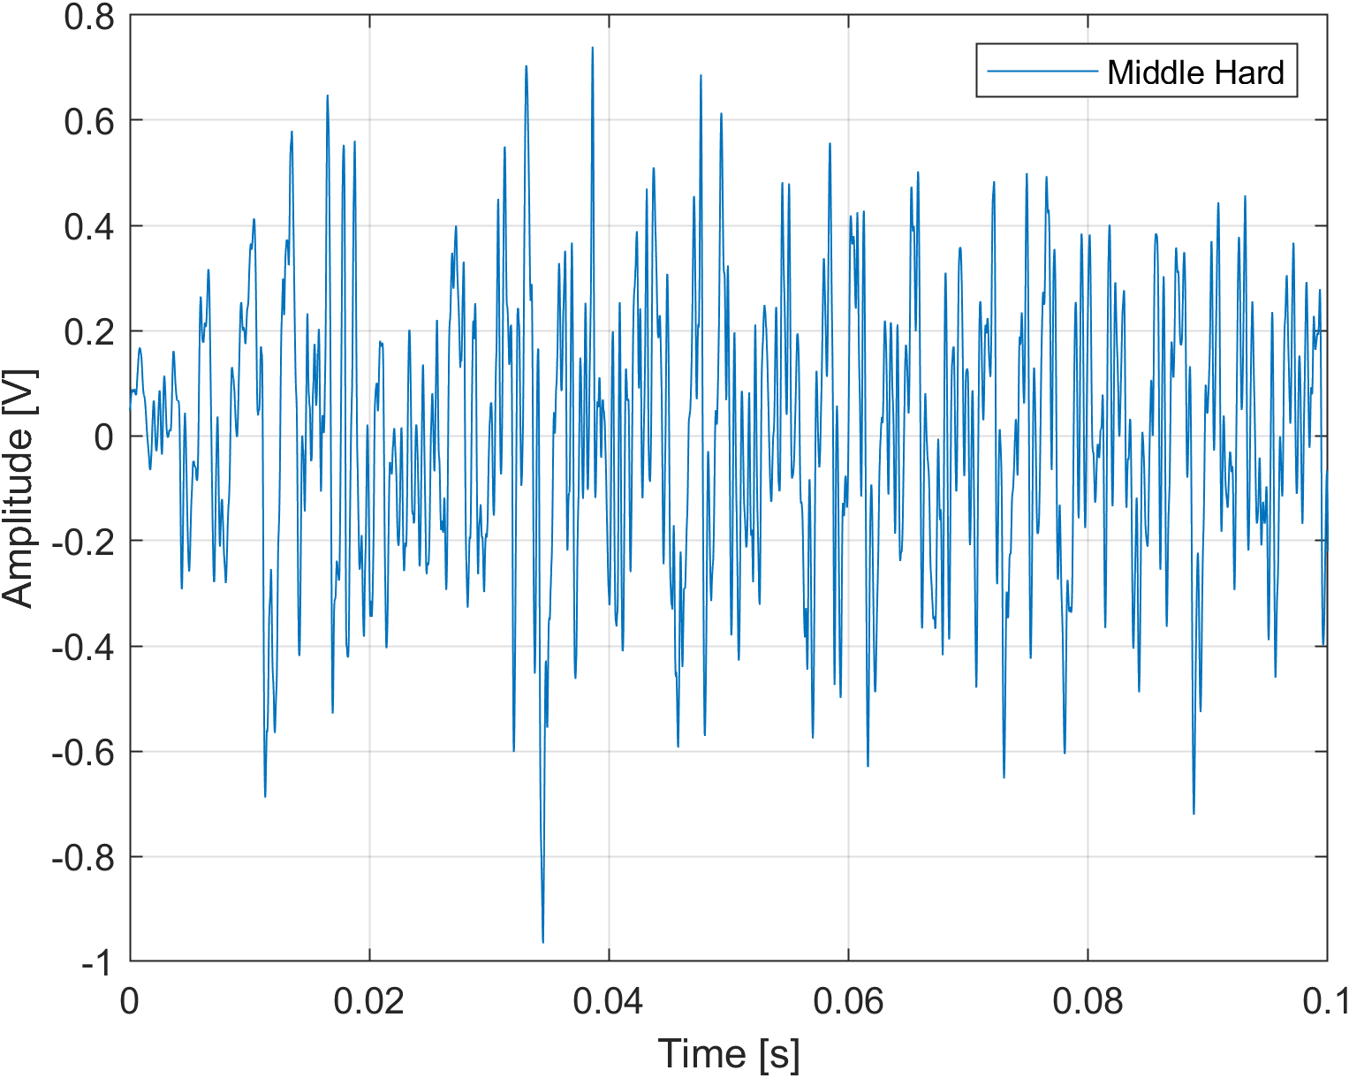
gitfigures/guitar_measurement_fig/Middle_Hard.png
