Niclasapdk/esd6_project/gitfigures/guitar_measurement_fig/Middle_Normal.png

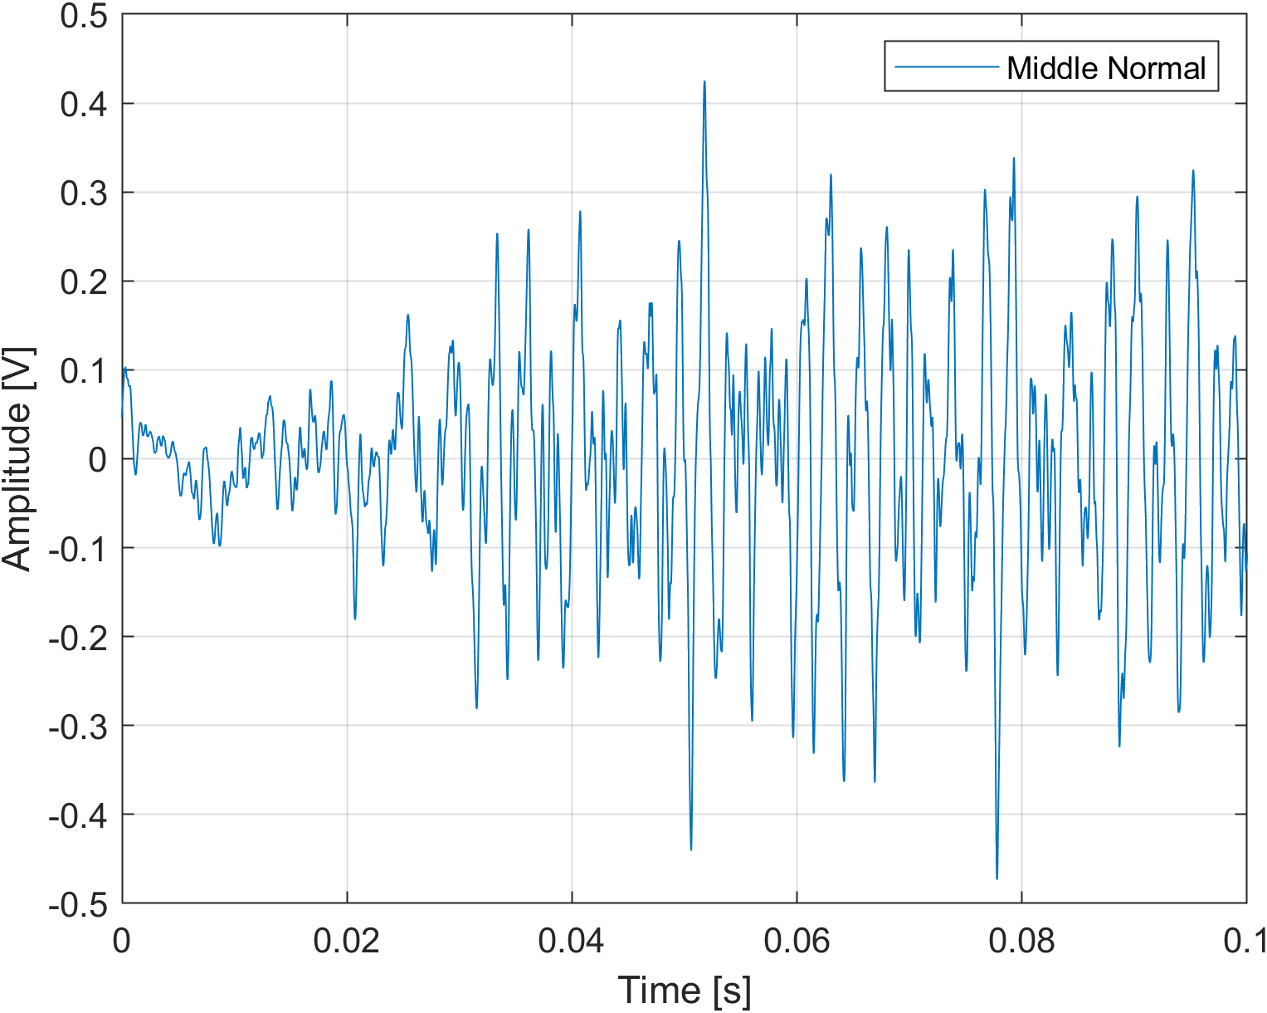
gitfigures/guitar_measurement_fig/Middle_Normal.png
