Niclasapdk/esd6_project/gitfigures/guitar_measurement_fig/Neck_Hard.png

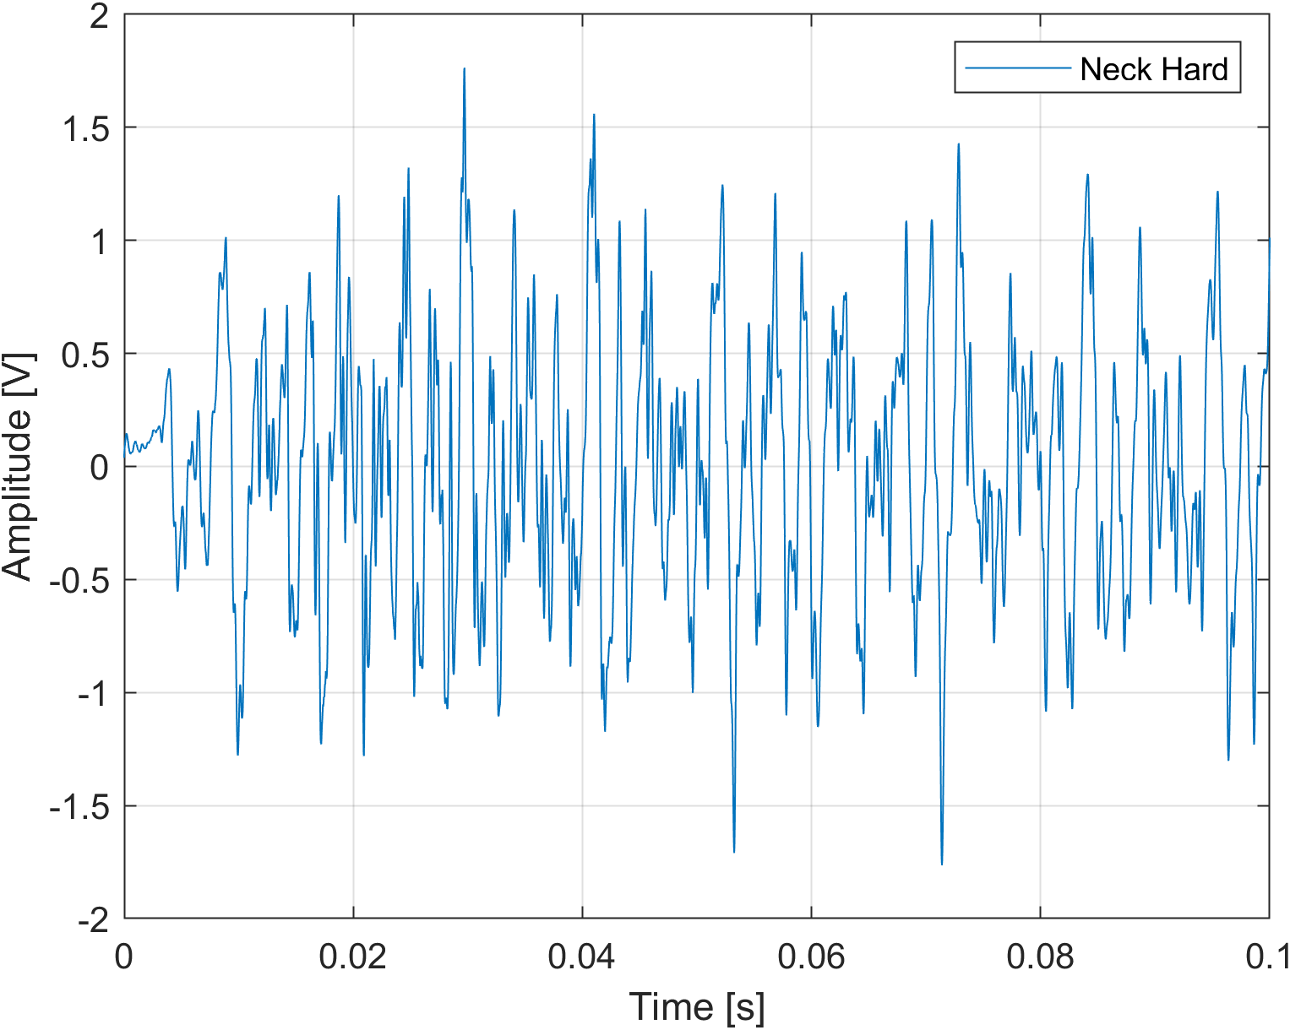
gitfigures/guitar_measurement_fig/Neck_Hard.png
