Niclasapdk/esd6_project/gitfigures/guitar_measurement_fig/Neck_Middle.png

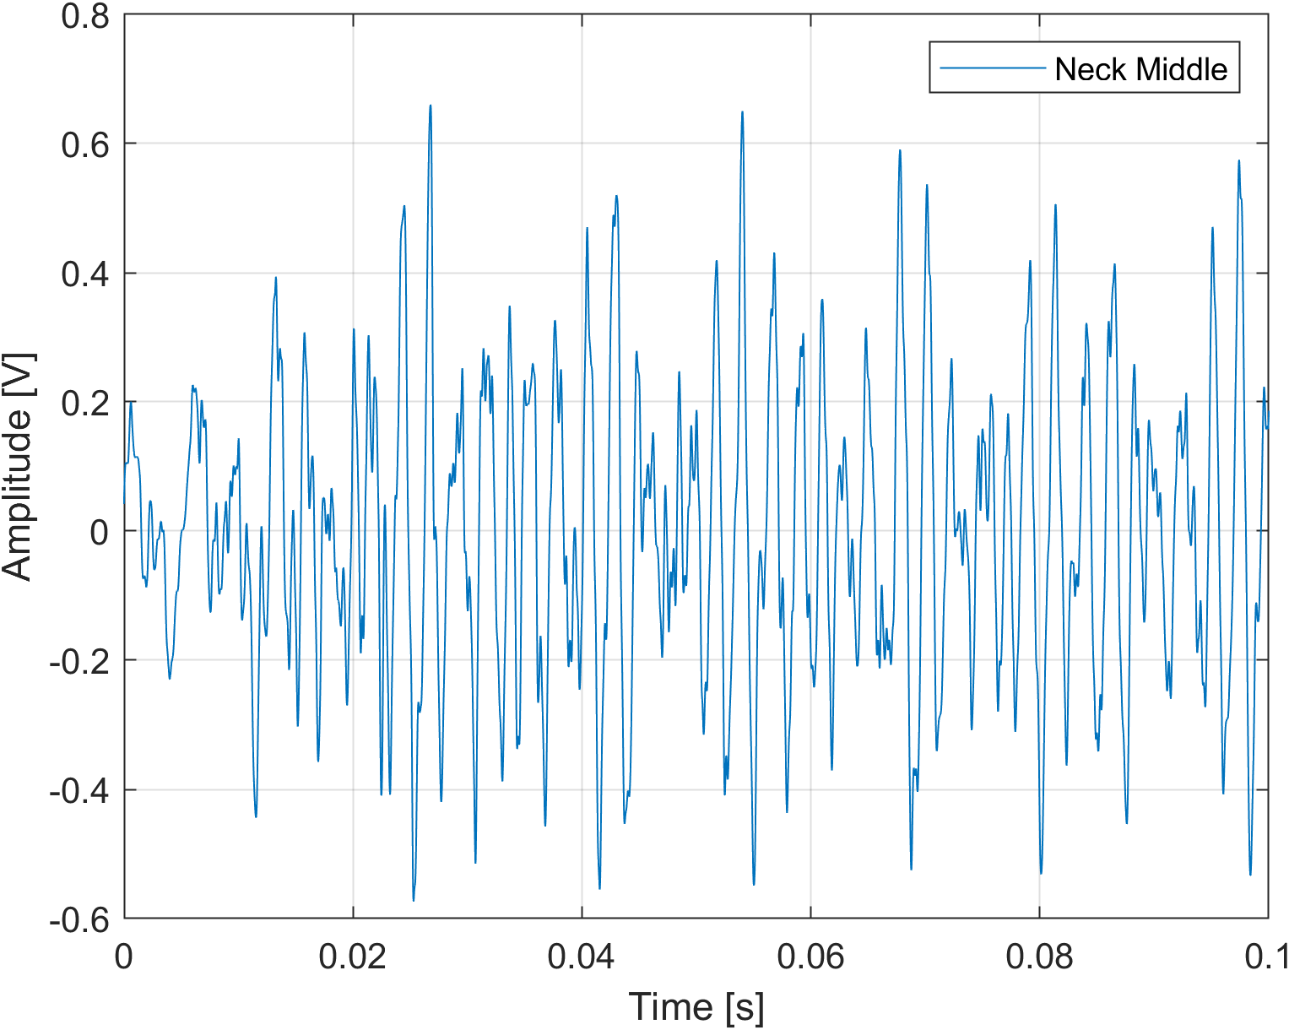
gitfigures/guitar_measurement_fig/Neck_Middle.png
