Niclasapdk/esd6_project/gitfigures/guitar_measurement_fig/voltage_divider.png

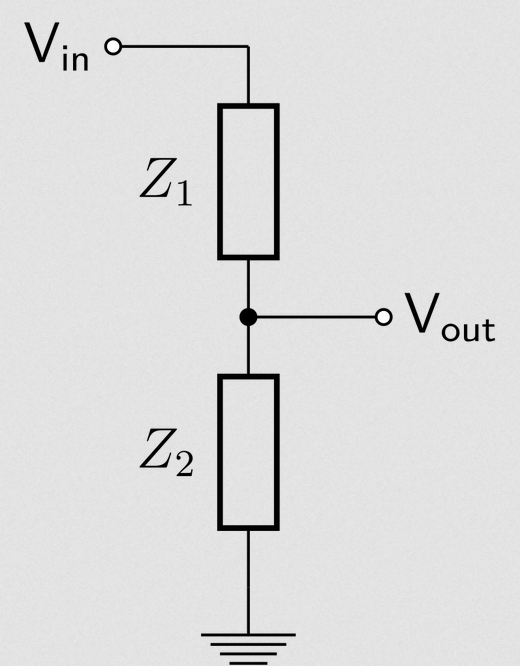
gitfigures/guitar_measurement_fig/voltage_divider.png
