Niclasapdk/esd6_project/gitfigures/ImplementationTest/12.2Mhz_clock_plot.png

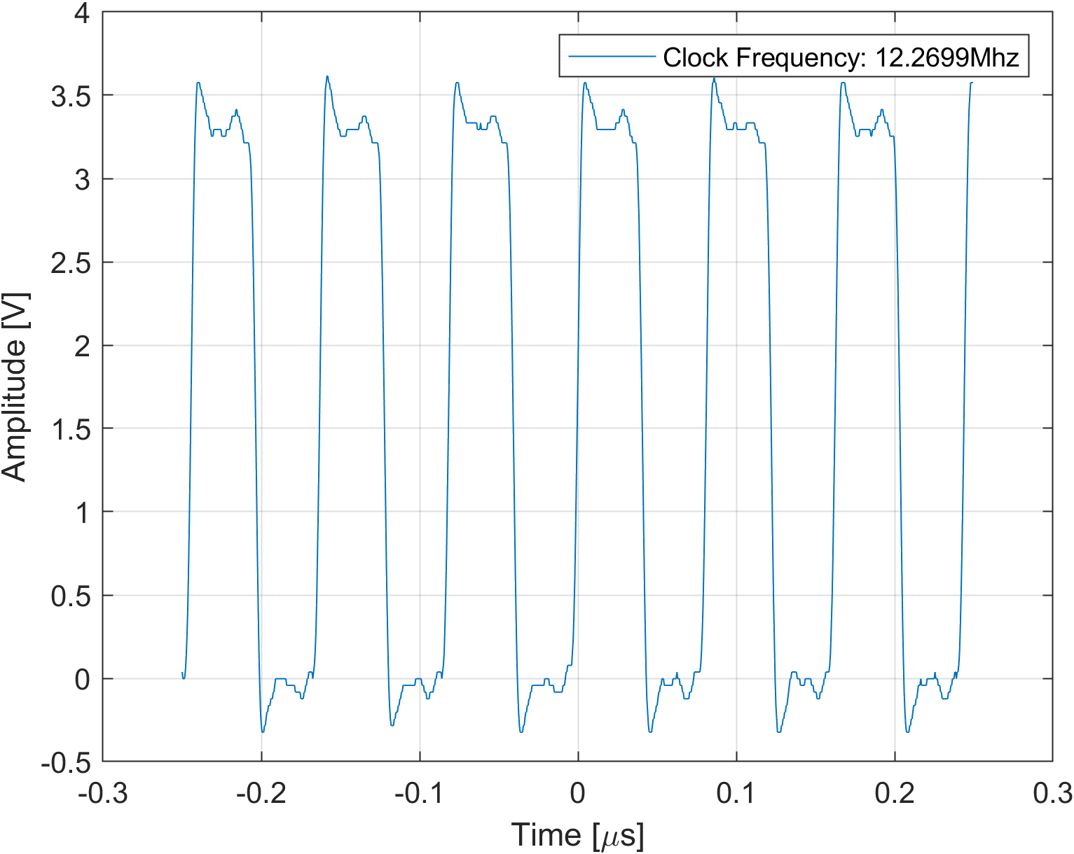
gitfigures/ImplementationTest/12.2Mhz_clock_plot.png
