Niclasapdk/esd6_project/gitfigures/ImplementationTest/100Mhz_clock_plot.png

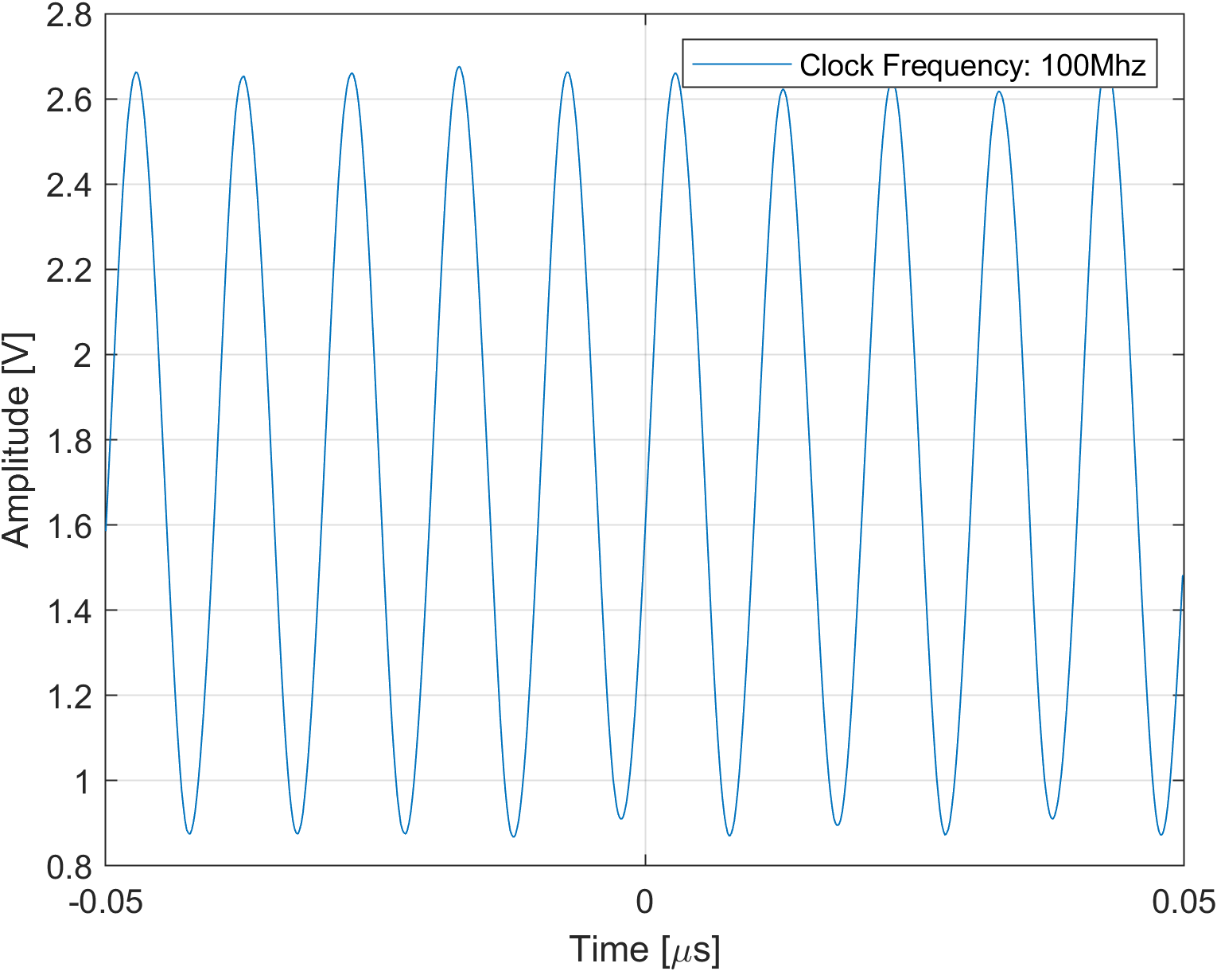
gitfigures/ImplementationTest/100Mhz_clock_plot.png
