Niclasapdk/esd6_project/gitfigures/ImplementationTest/adc_sampling_test.png

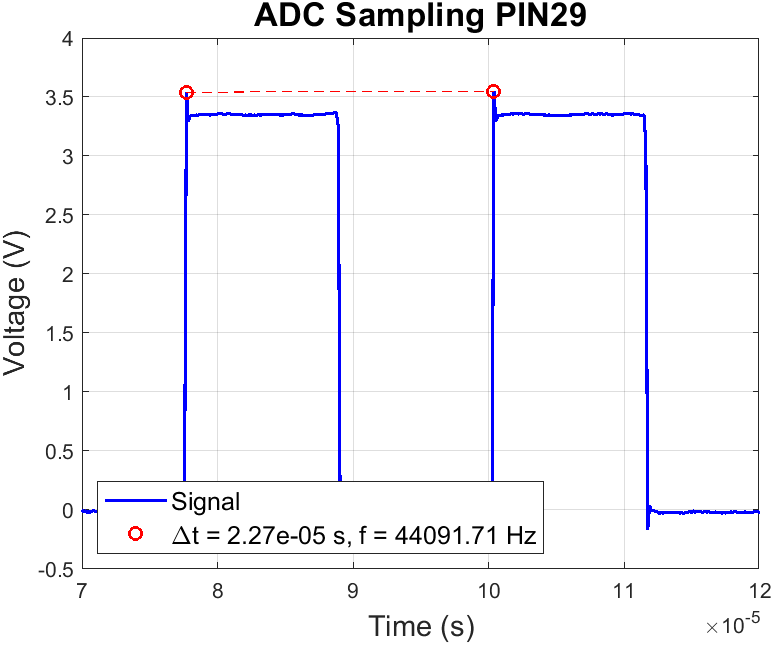
gitfigures/ImplementationTest/adc_sampling_test.png
