Niclasapdk/esd6_project/gitfigures/ImplementationTest/ComputationTime_ALLFx.png

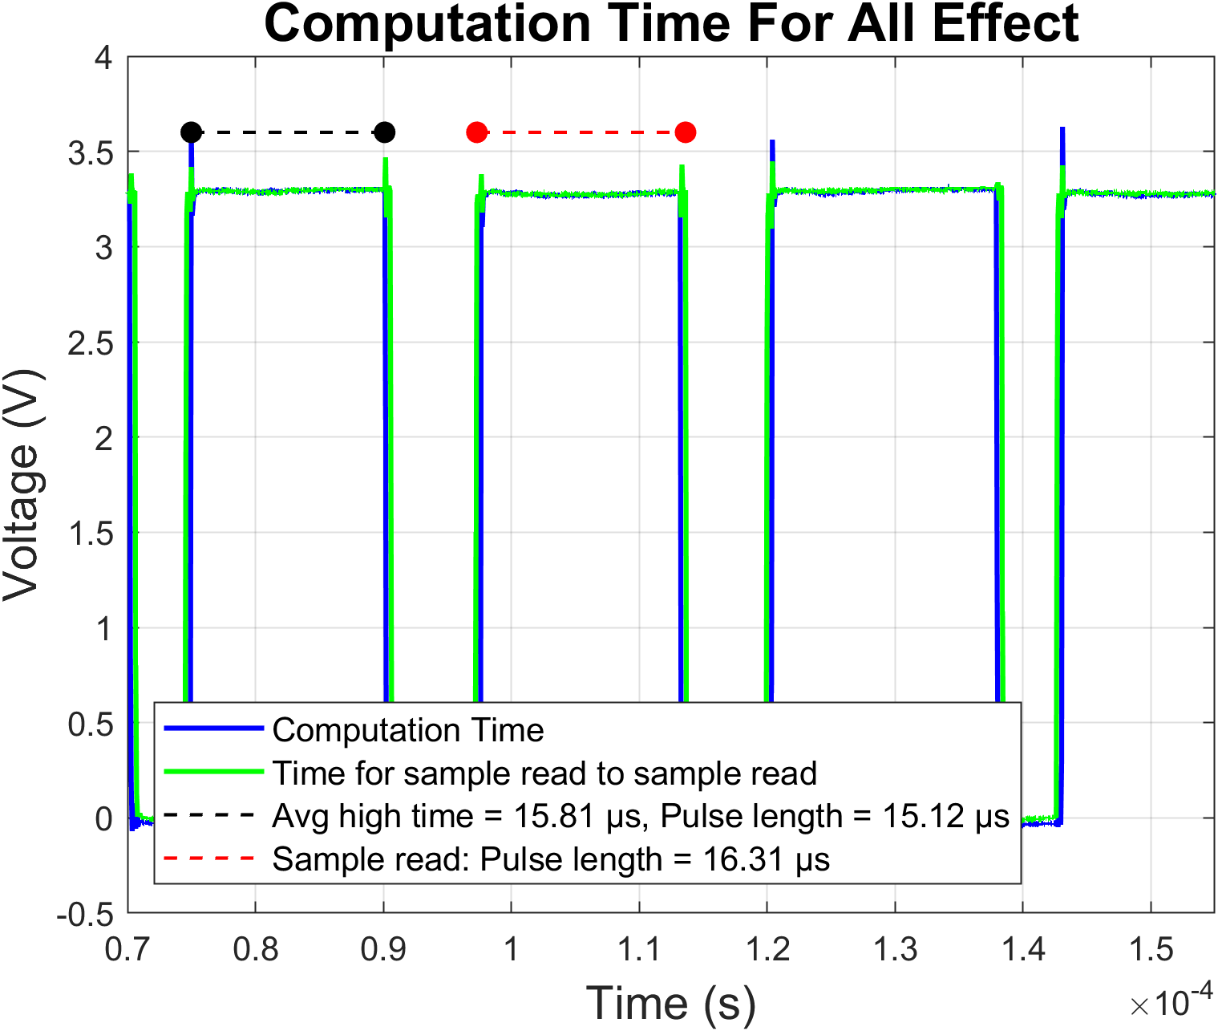
gitfigures/ImplementationTest/ComputationTime_ALLFx.png
