Niclasapdk/esd6_project/gitfigures/ImplementationTest/ComputationTime_Chorus.png

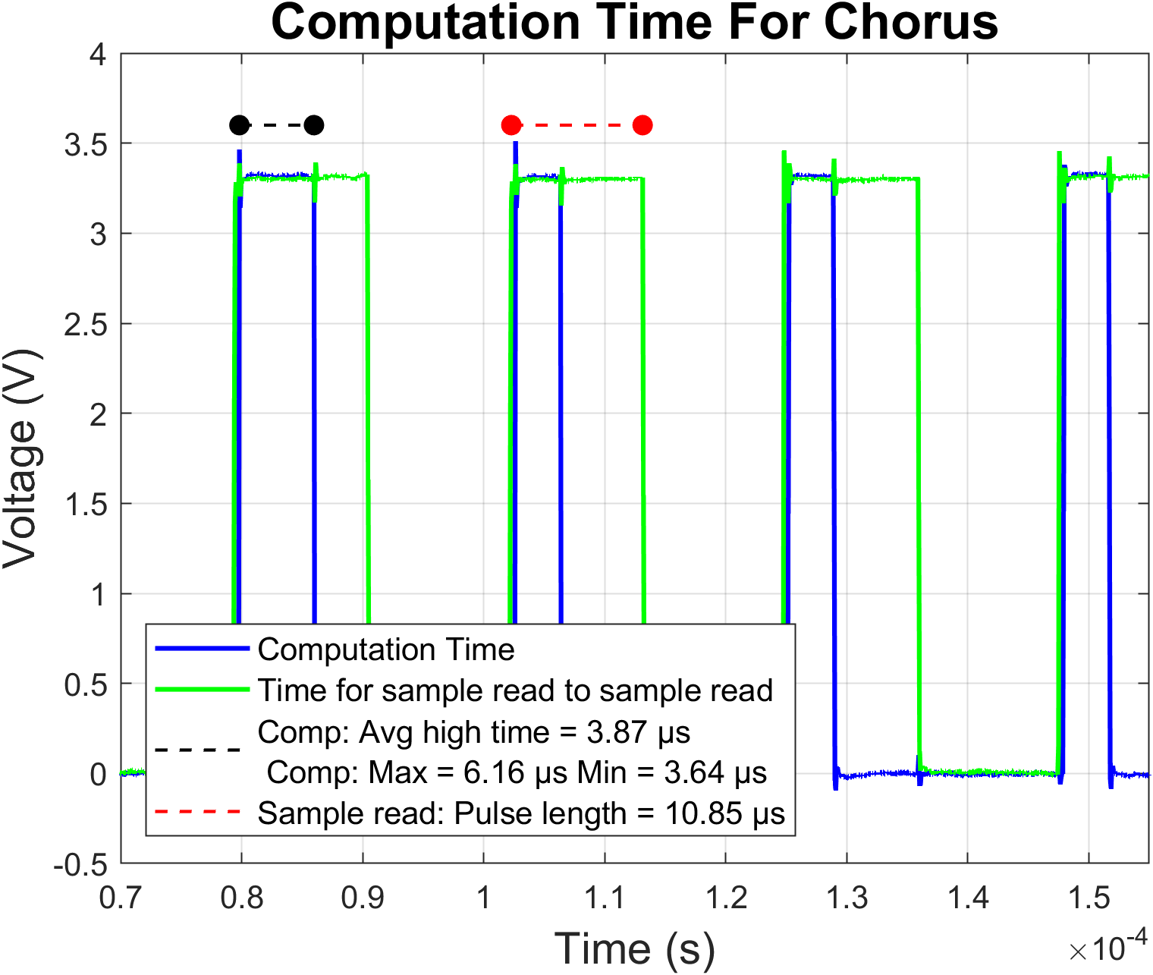
gitfigures/ImplementationTest/ComputationTime_Chorus.png
