Niclasapdk/esd6_project/gitfigures/ImplementationTest/ComputationTime_FirALLFX.png

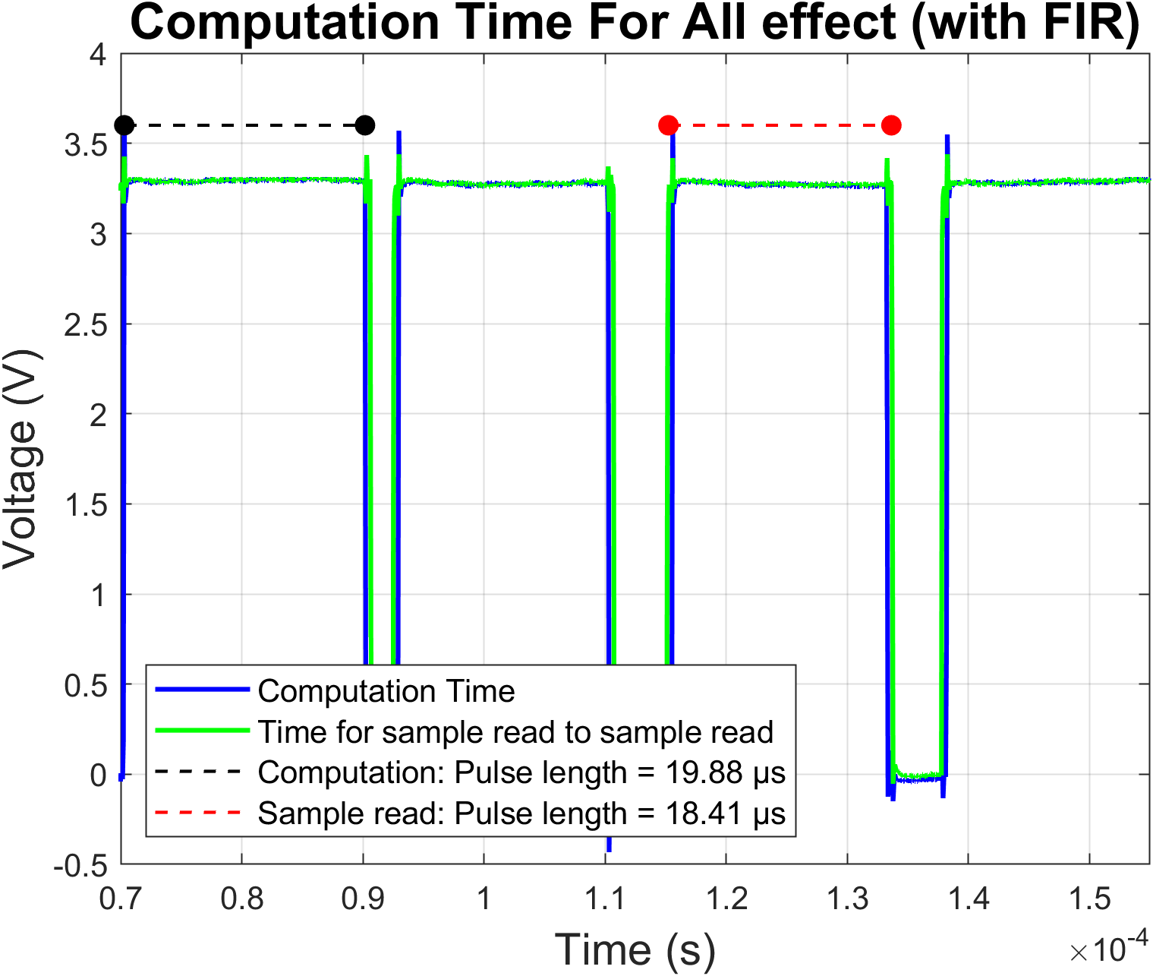
gitfigures/ImplementationTest/ComputationTime_FirALLFX.png
