Niclasapdk/esd6_project/gitfigures/ImplementationTest/ComputationTime_FIROverdrive.png

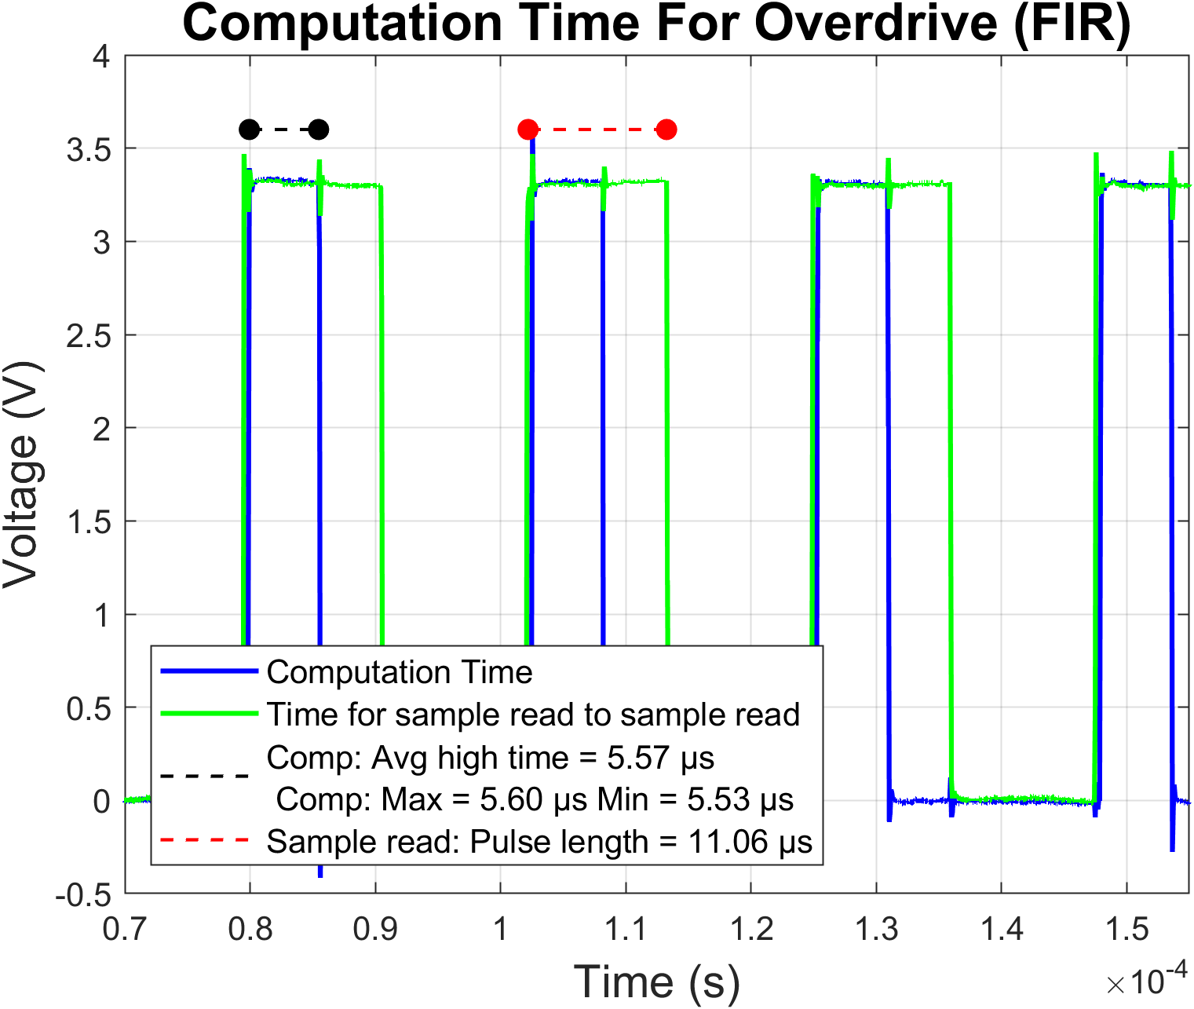
gitfigures/ImplementationTest/ComputationTime_FIROverdrive.png
