Niclasapdk/esd6_project/gitfigures/ImplementationTest/ComputationTime_FIROverdriveALLFx.png

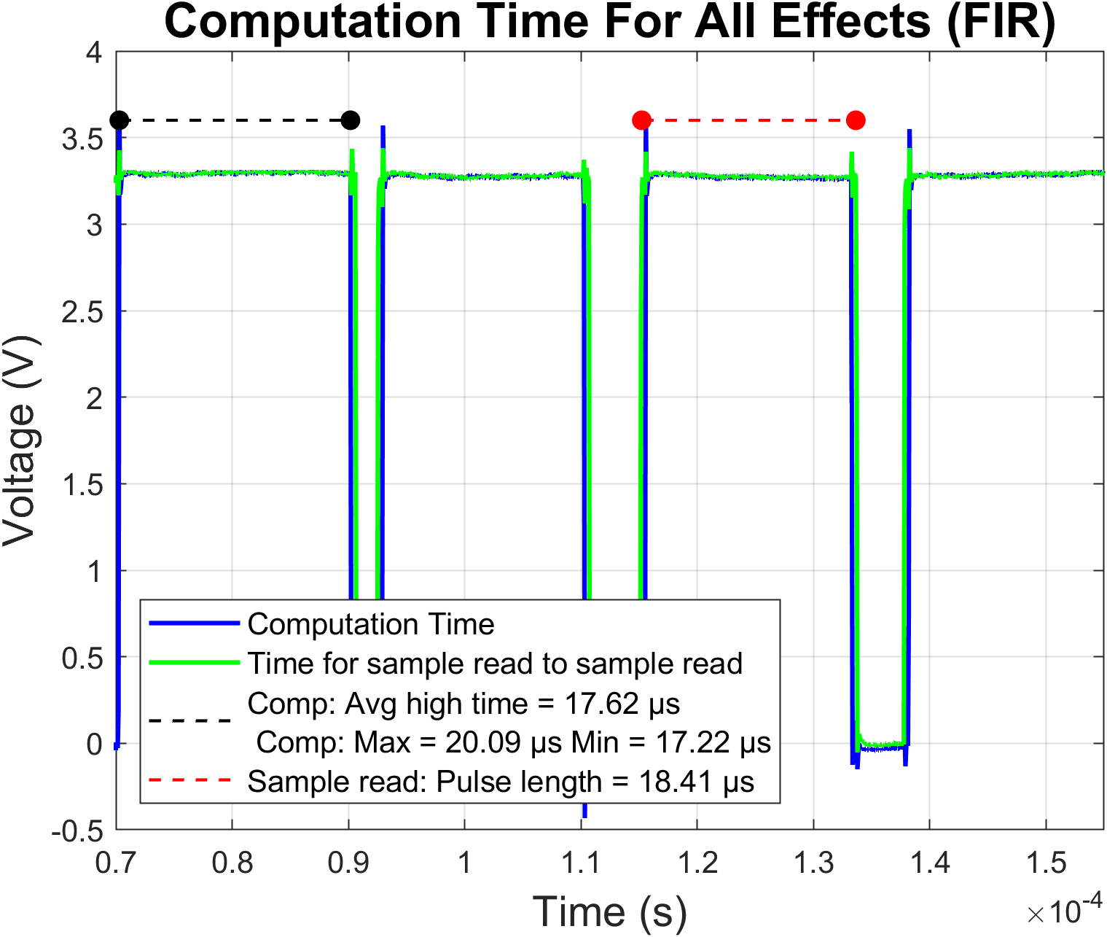
gitfigures/ImplementationTest/ComputationTime_FIROverdriveALLFx.png
