Niclasapdk/esd6_project/gitfigures/ImplementationTest/ComputationTime_O1ALLFx.png

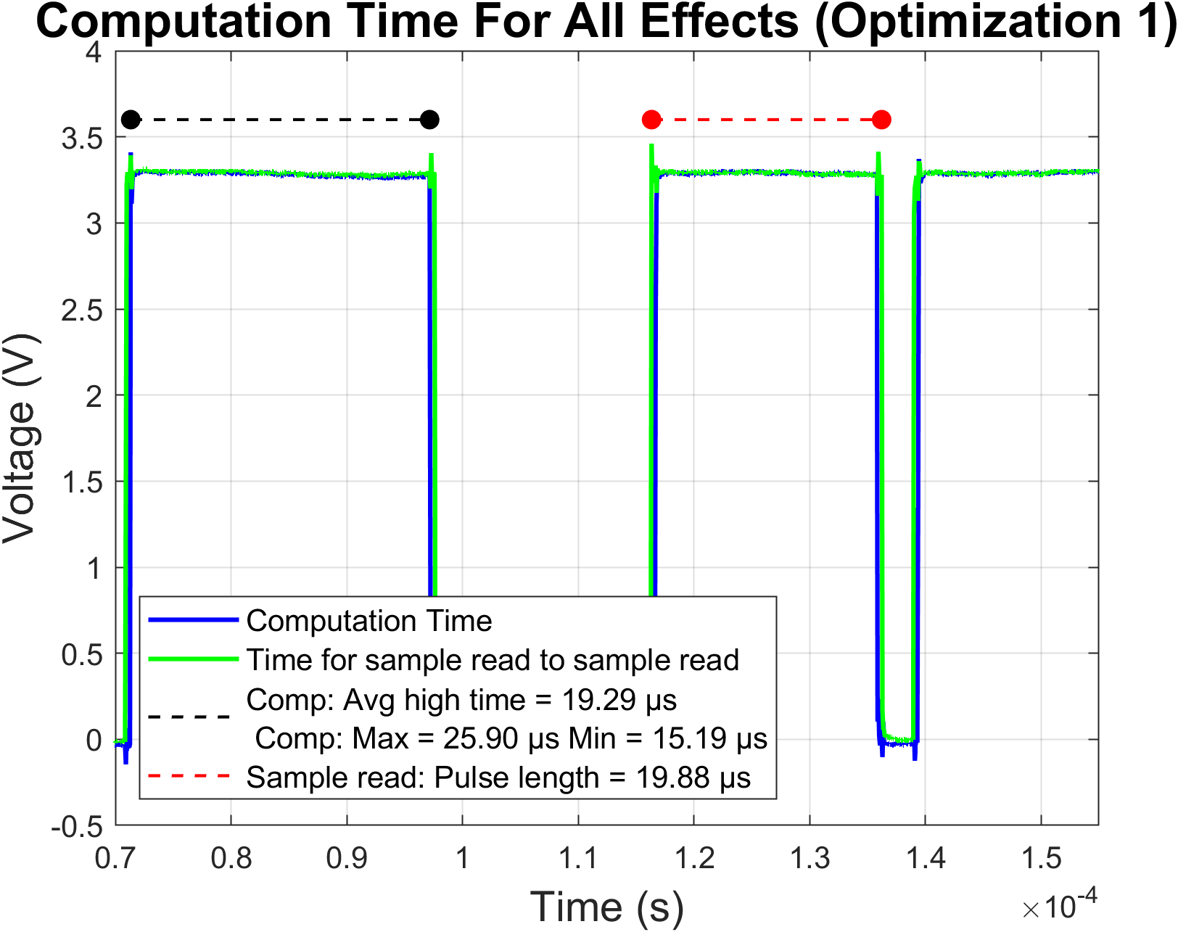
gitfigures/ImplementationTest/ComputationTime_O1ALLFx.png
