Niclasapdk/esd6_project/gitfigures/ImplementationTest/ComputationTime_O2ALLFx.png

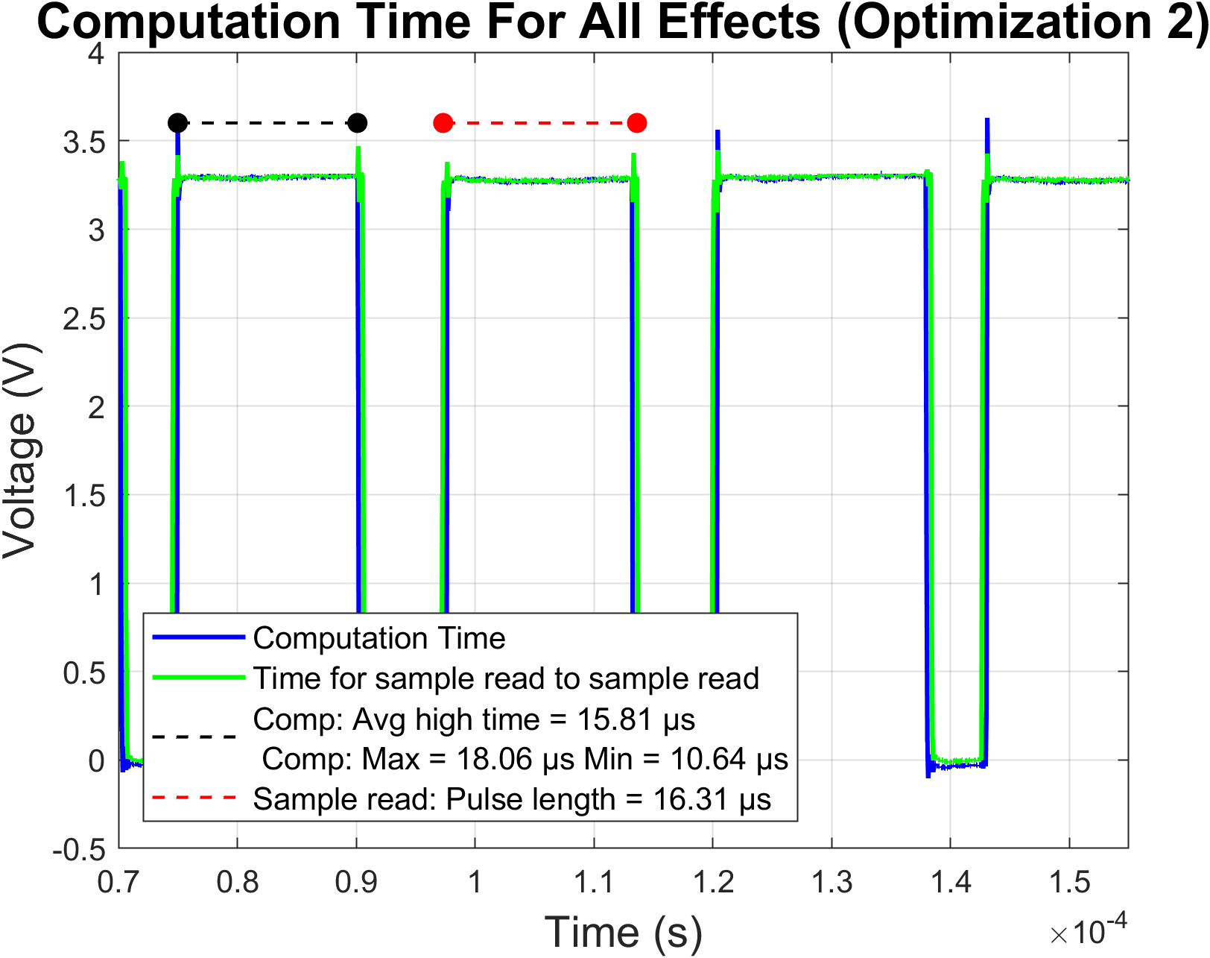
gitfigures/ImplementationTest/ComputationTime_O2ALLFx.png
