Niclasapdk/esd6_project/gitfigures/ImplementationTest/ComputationTime_O3ALLFx.png

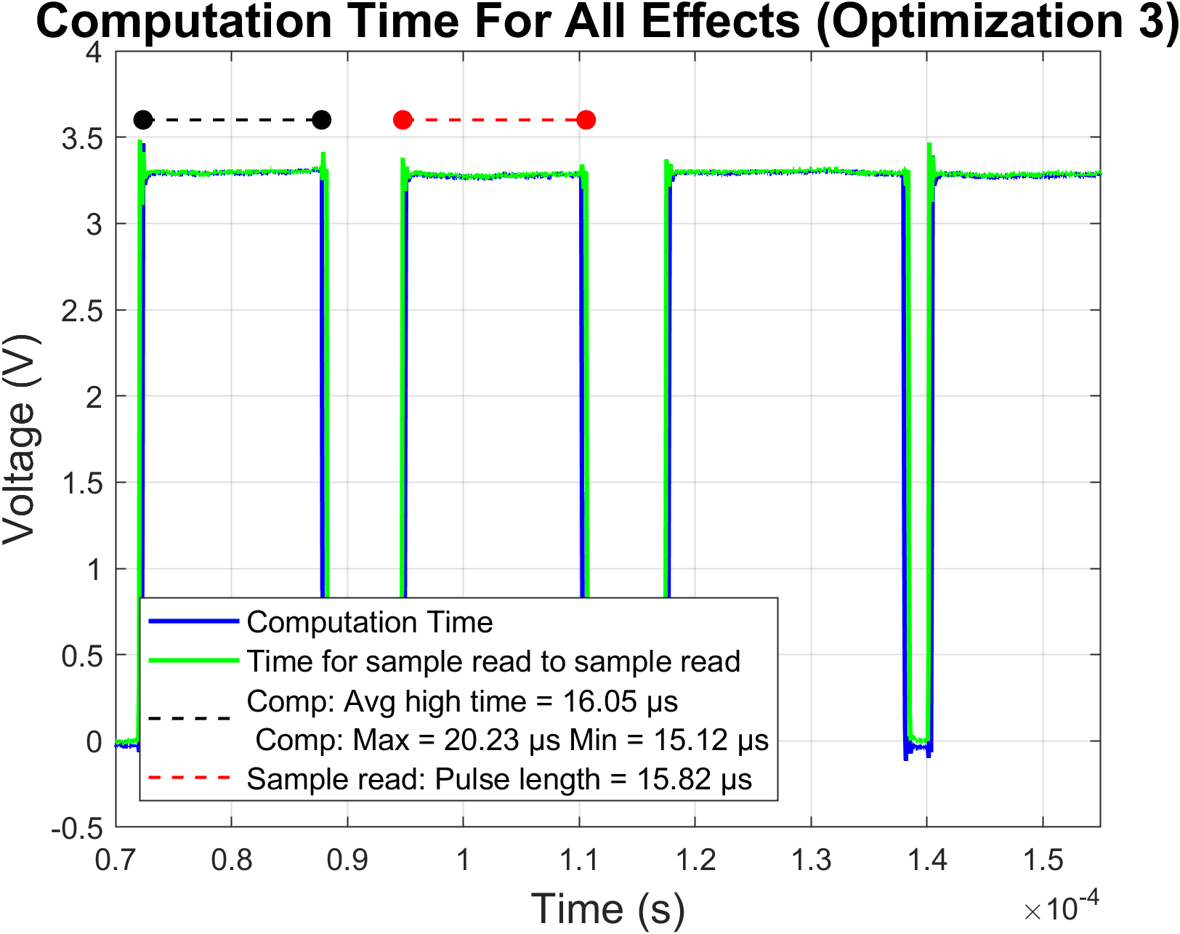
gitfigures/ImplementationTest/ComputationTime_O3ALLFx.png
