Niclasapdk/esd6_project/gitfigures/system_design/analog_frontend/amplifier_frequency_response_test/analog_frontend_frequency_response_test.drawio.png

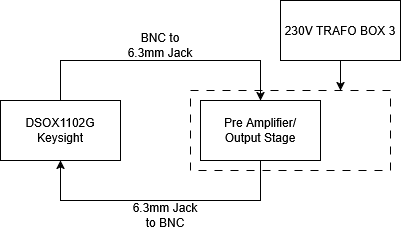
gitfigures/system_design/analog_frontend/amplifier_frequency_response_test/analog_frontend_frequency_response_test.drawio.png
