Niclasapdk/esd6_project/gitfigures/system_design/analog_frontend/amplifier_frequency_response_test/bandwidth_test.png

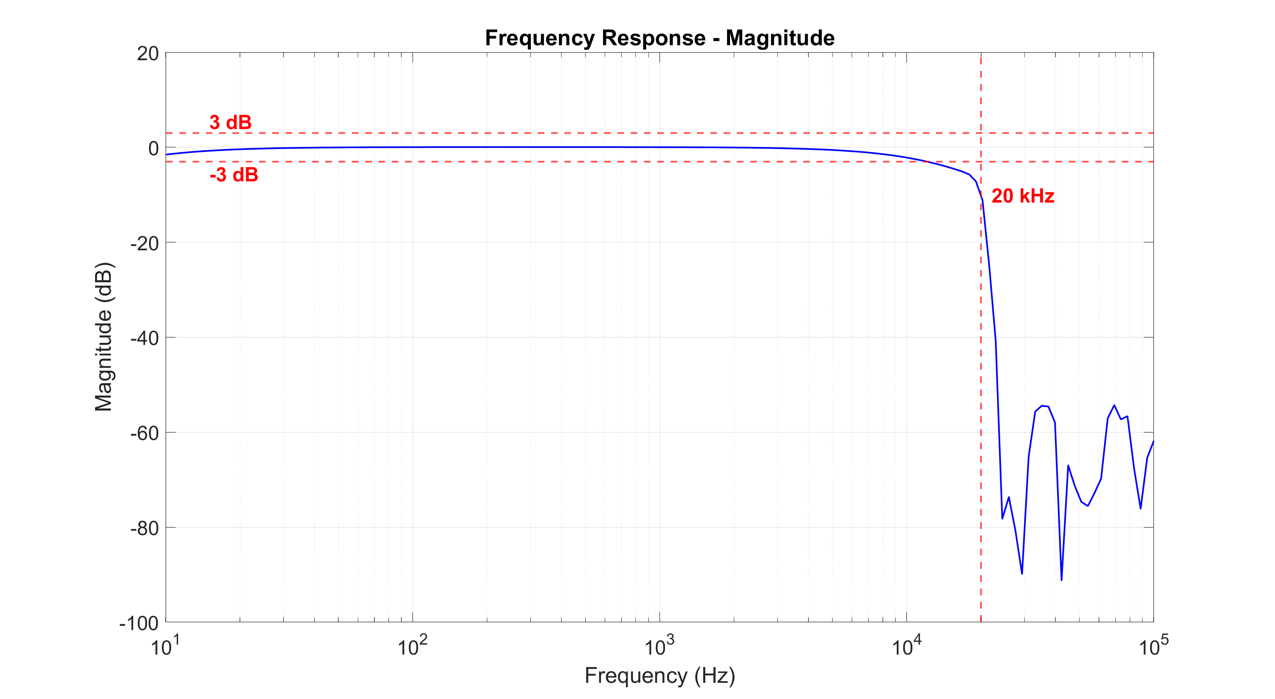
gitfigures/system_design/analog_frontend/amplifier_frequency_response_test/bandwidth_test.png
