Niclasapdk/esd6_project/gitfigures/system_design/analog_frontend/amplifier_frequency_response_test/input_impedance_test_figure.png

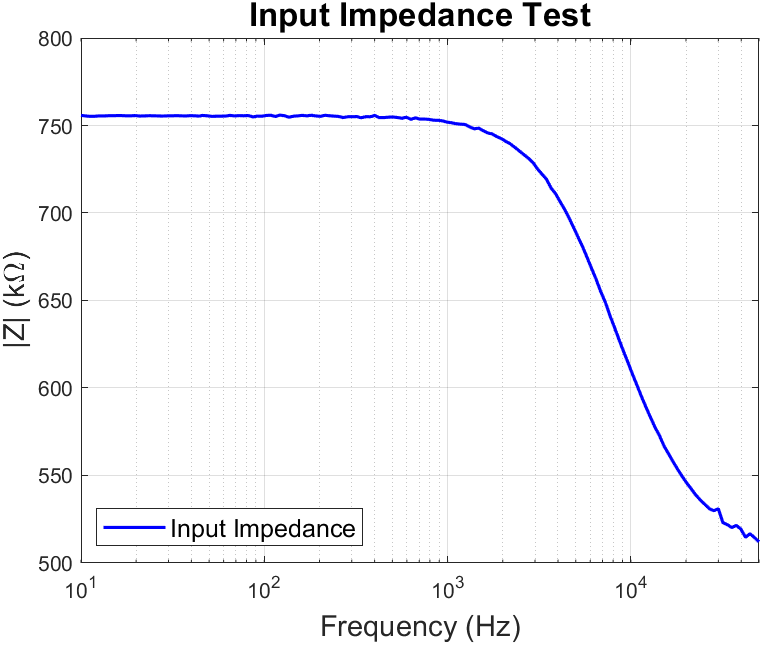
gitfigures/system_design/analog_frontend/amplifier_frequency_response_test/input_impedance_test_figure.png
