Niclasapdk/esd6_project/gitfigures/system_design/analog_frontend/amplifier_frequency_response_test/output_stage_figure.png

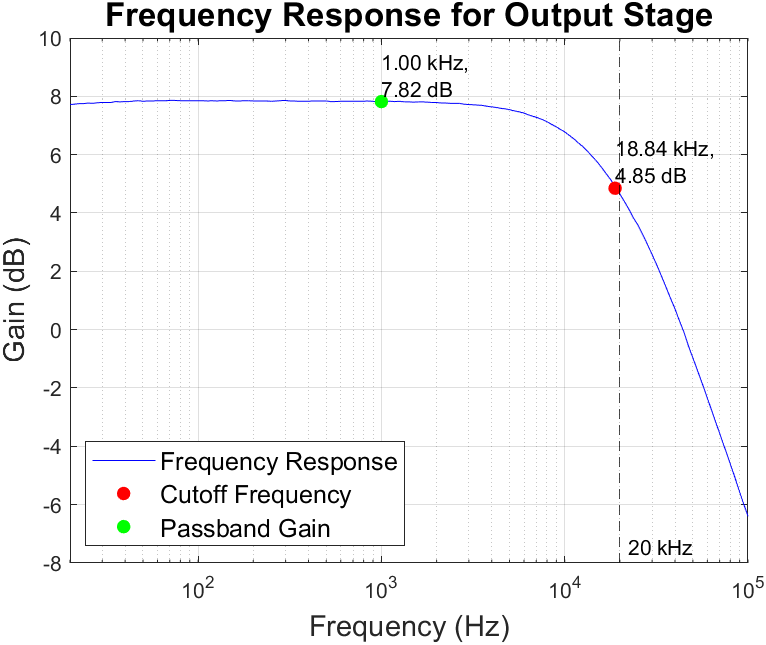
gitfigures/system_design/analog_frontend/amplifier_frequency_response_test/output_stage_figure.png
