Niclasapdk/esd6_project/gitfigures/system_design/analog_frontend/input_signal_test.png

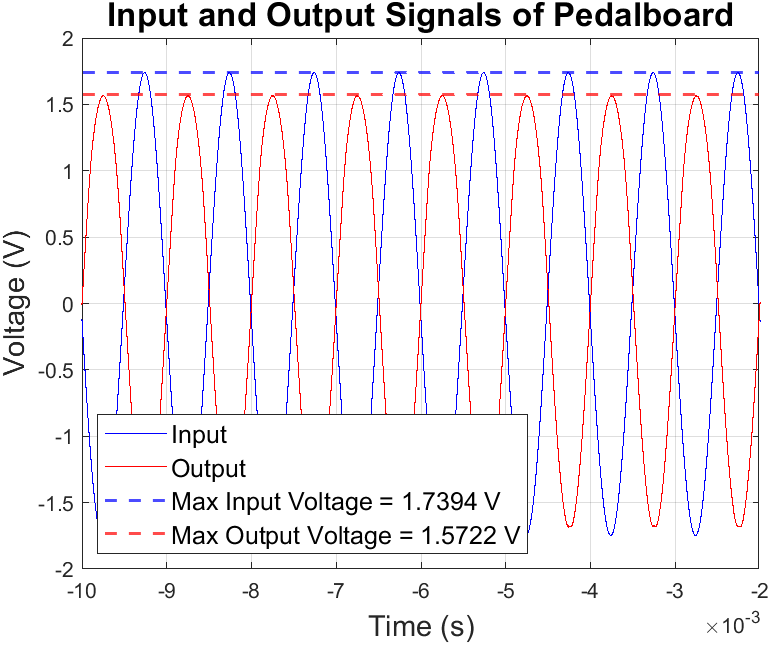
gitfigures/system_design/analog_frontend/input_signal_test.png
