Niclasapdk/esd6_project/gitfigures/system_design/analog_frontend/output_dsp_test.png

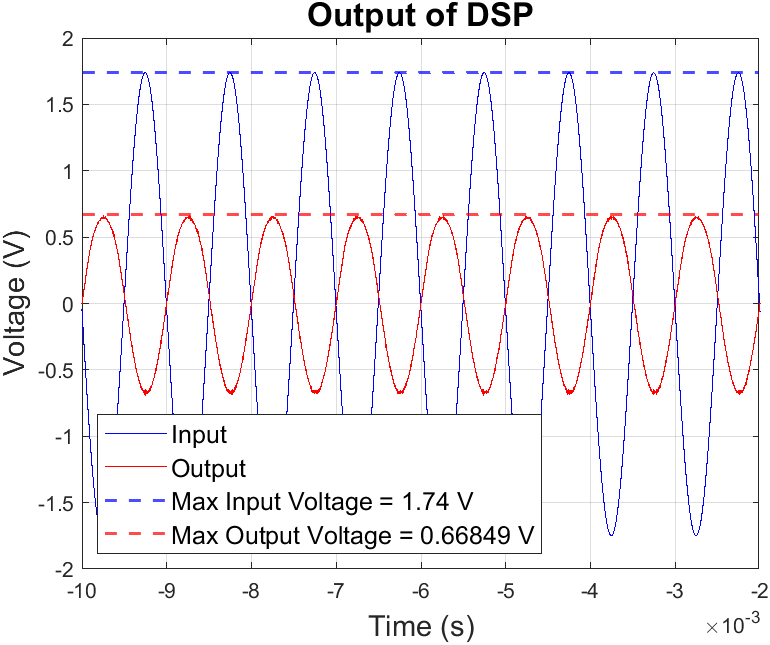
gitfigures/system_design/analog_frontend/output_dsp_test.png
