Niclasapdk/esd6_project/gitfigures/system_design/analog_frontend/output_impedance_test_driver.png

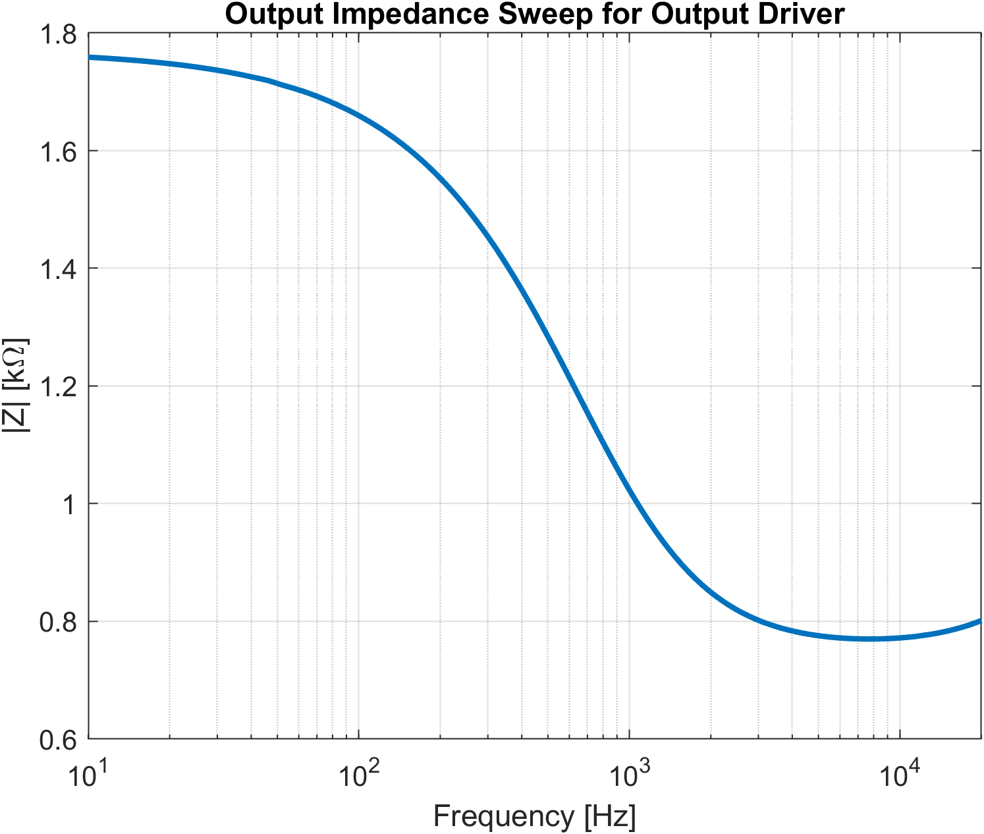
gitfigures/system_design/analog_frontend/output_impedance_test_driver.png
