Niclasapdk/esd6_project/gitfigures/system_design/ChorusFlanger/chorus_delay_10_ms_test.png

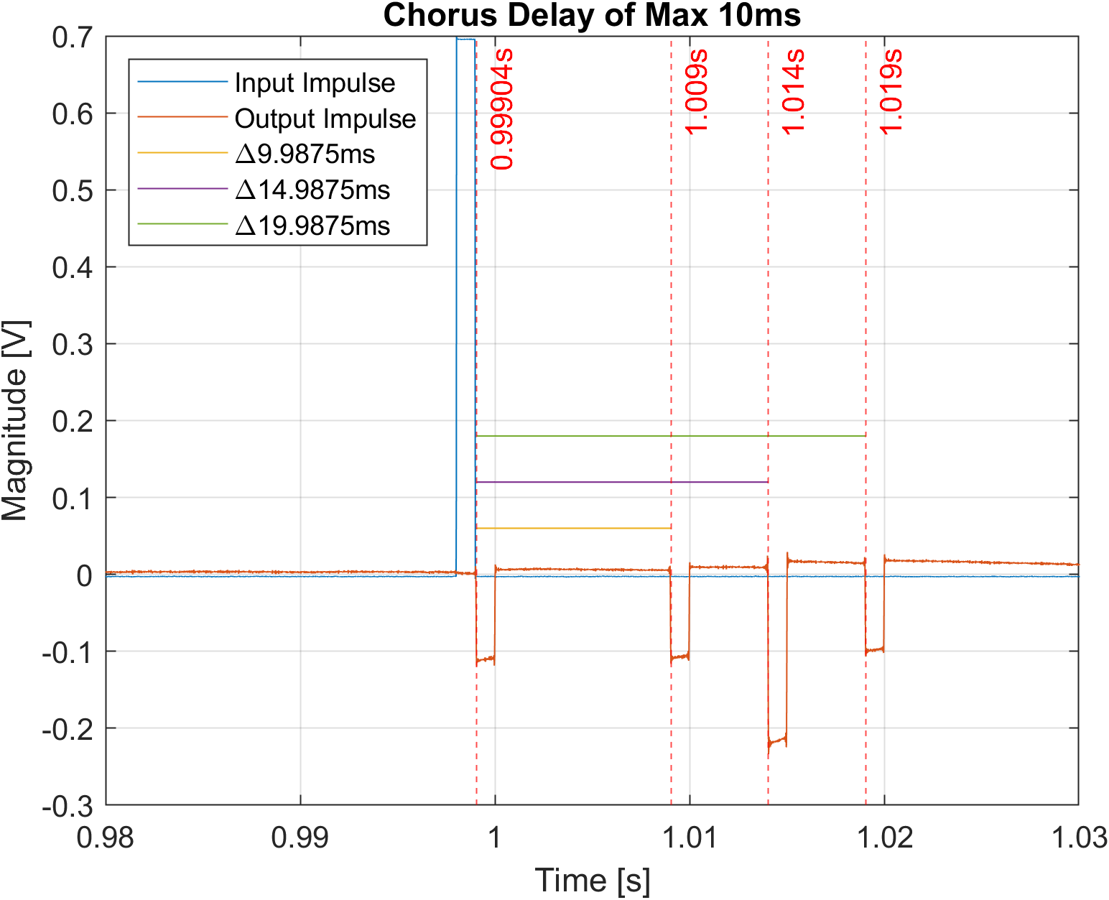
gitfigures/system_design/ChorusFlanger/chorus_delay_10_ms_test.png
