Niclasapdk/esd6_project/gitfigures/system_design/ChorusFlanger/chorus_delay_25_ms_test.png

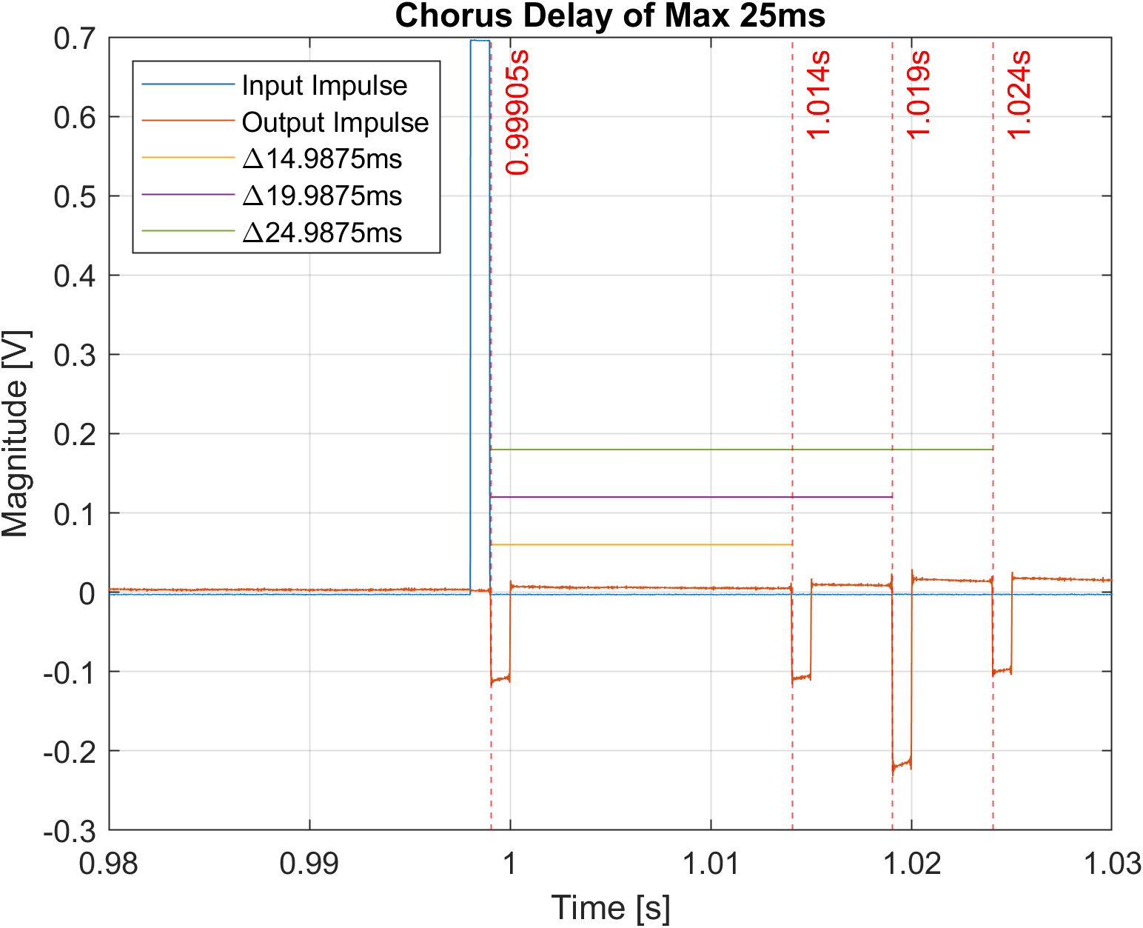
gitfigures/system_design/ChorusFlanger/chorus_delay_25_ms_test.png
