Niclasapdk/esd6_project/gitfigures/system_design/ChorusFlanger/chorus_lfo_test_20Hz_sin_cos.png

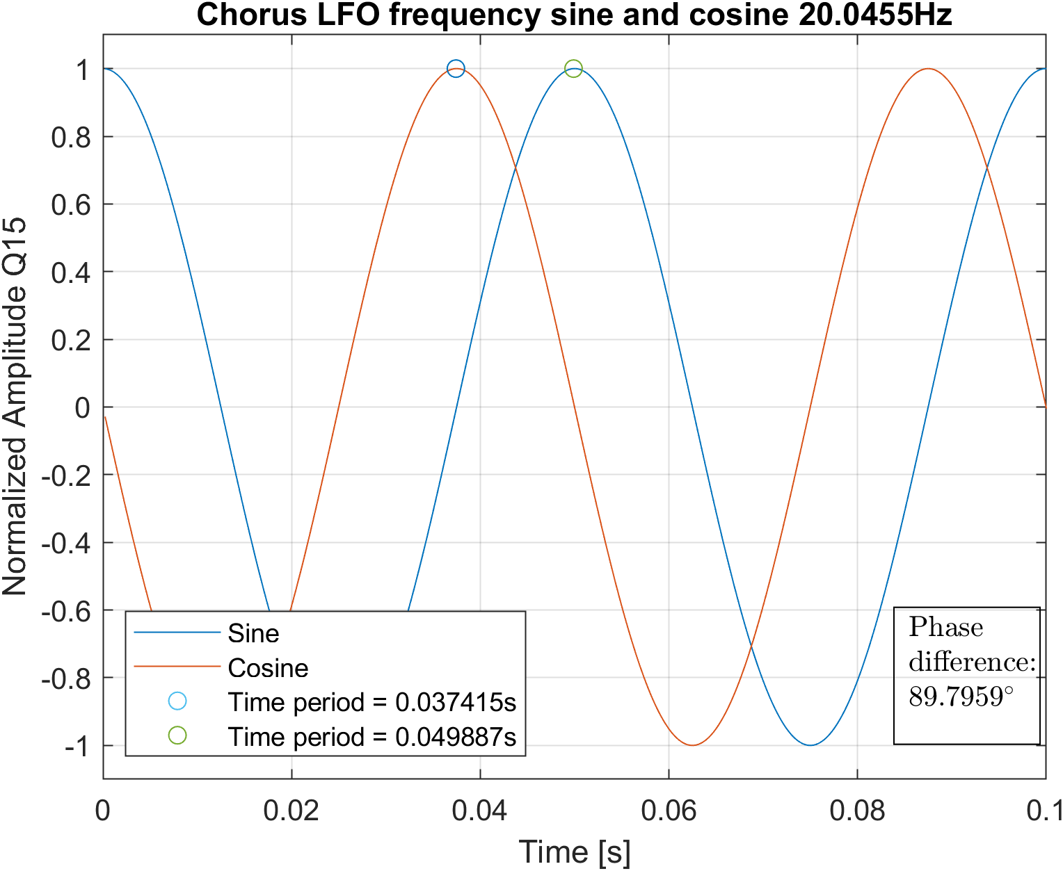
gitfigures/system_design/ChorusFlanger/chorus_lfo_test_20Hz_sin_cos.png
