Niclasapdk/esd6_project/gitfigures/system_design/ChorusFlanger/flanger_delay_15ms_test.png

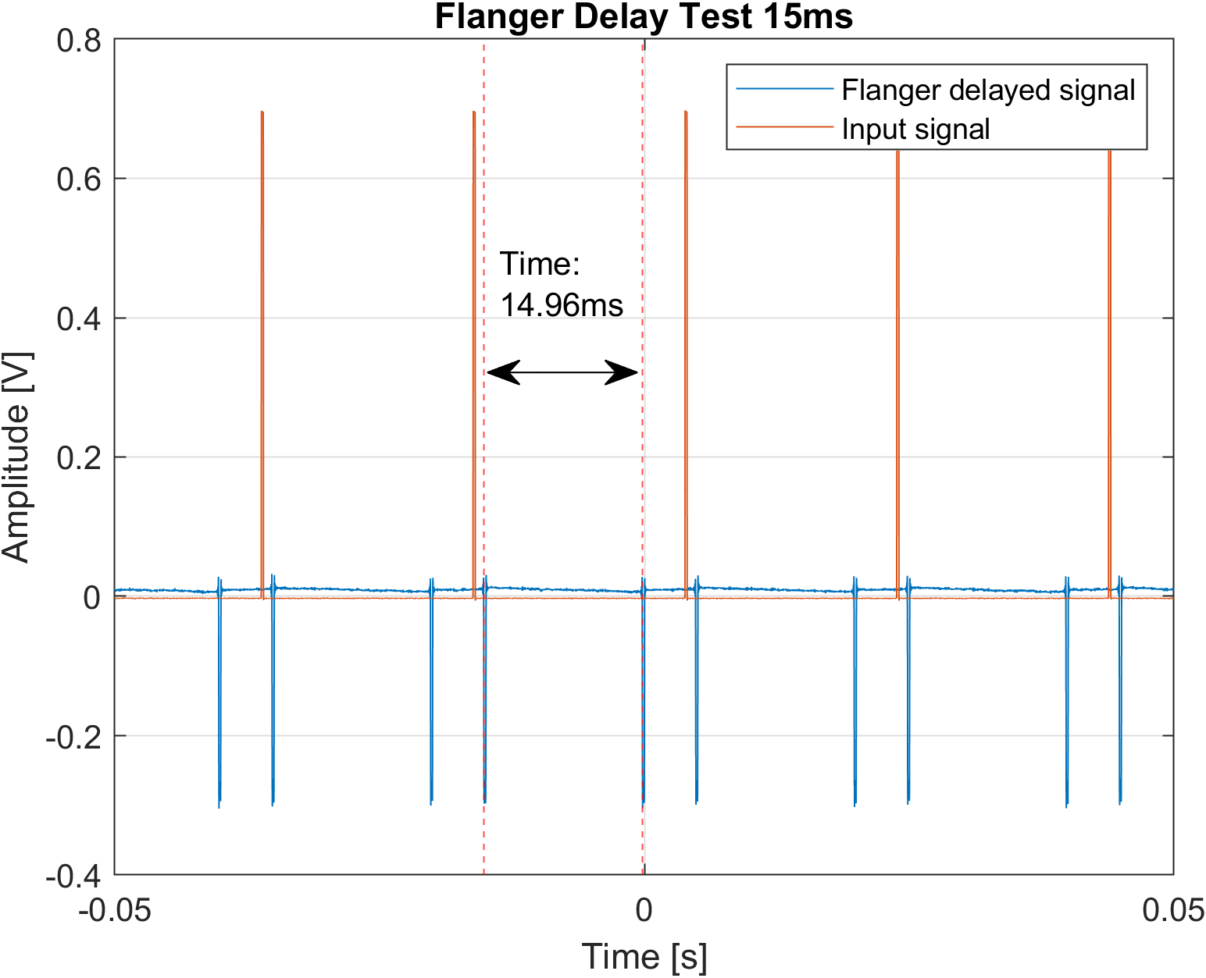
gitfigures/system_design/ChorusFlanger/flanger_delay_15ms_test.png
