Niclasapdk/esd6_project/gitfigures/system_design/ChorusFlanger/flanger_lfo_test_100mHz.png

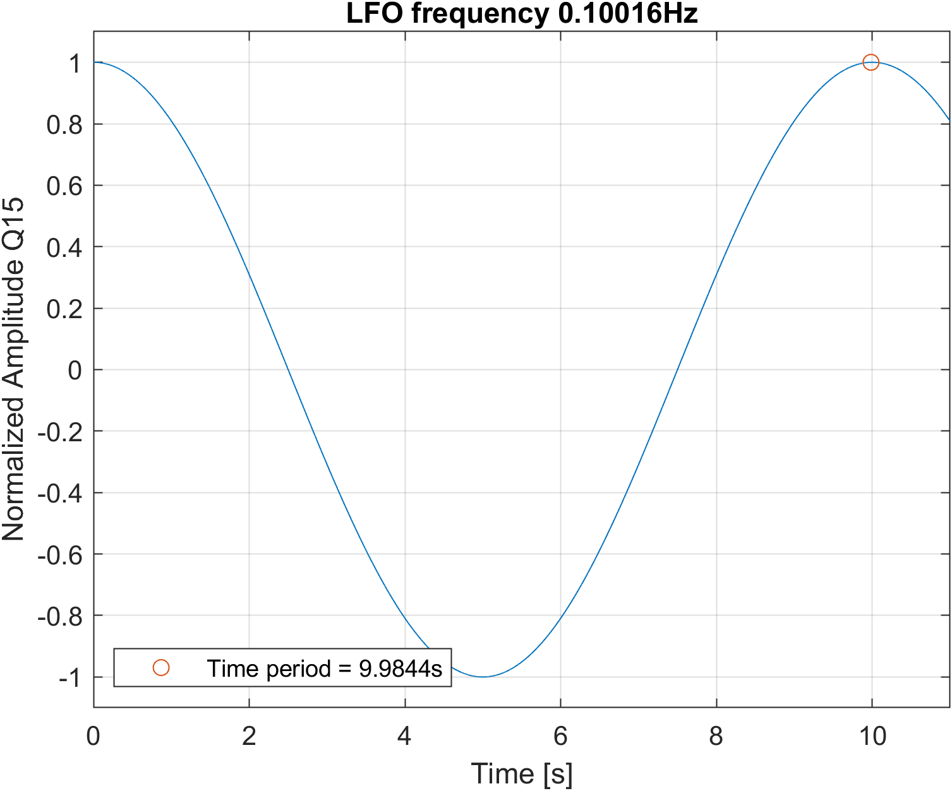
gitfigures/system_design/ChorusFlanger/flanger_lfo_test_100mHz.png
