Niclasapdk/esd6_project/gitfigures/system_design/overdrive/overdrive_aa_filter_test.png

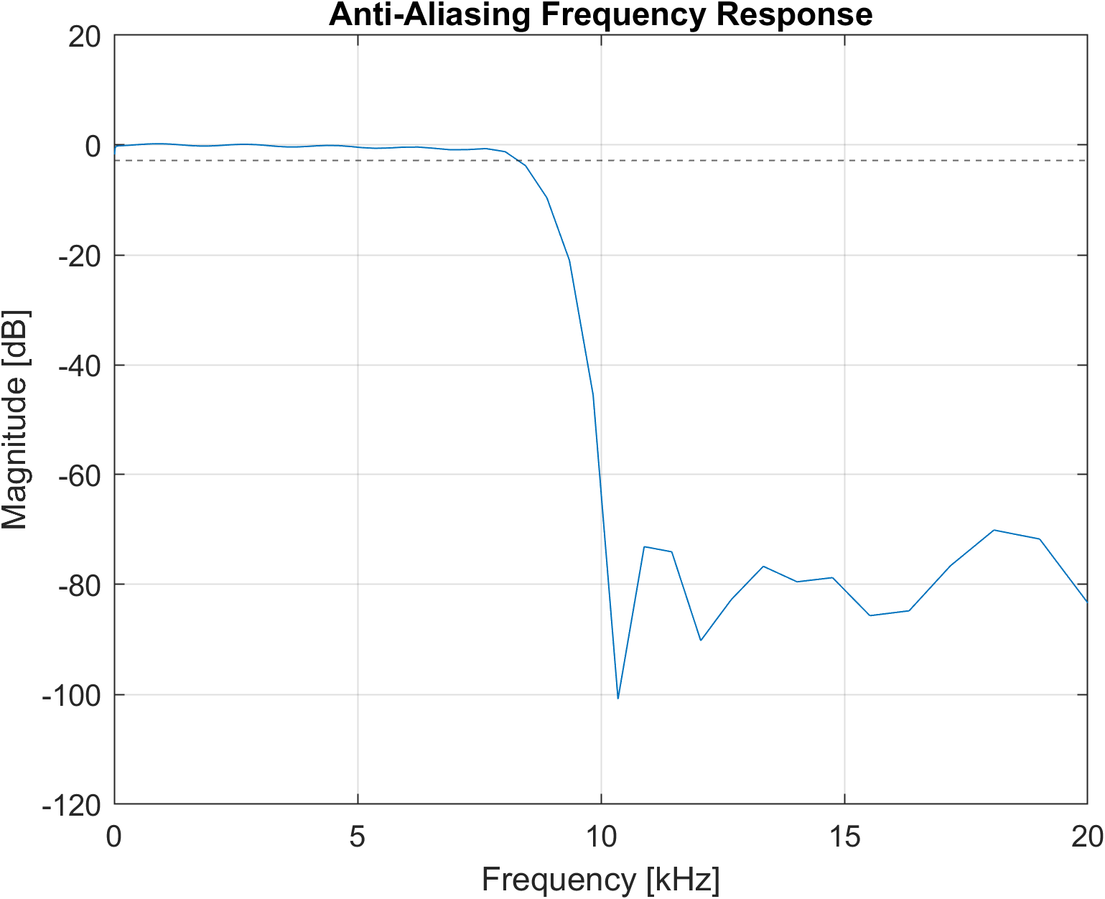
gitfigures/system_design/overdrive/overdrive_aa_filter_test.png
