Niclasapdk/esd6_project/gitfigures/system_design/overdrive/overdrive_hp_filter_test.png

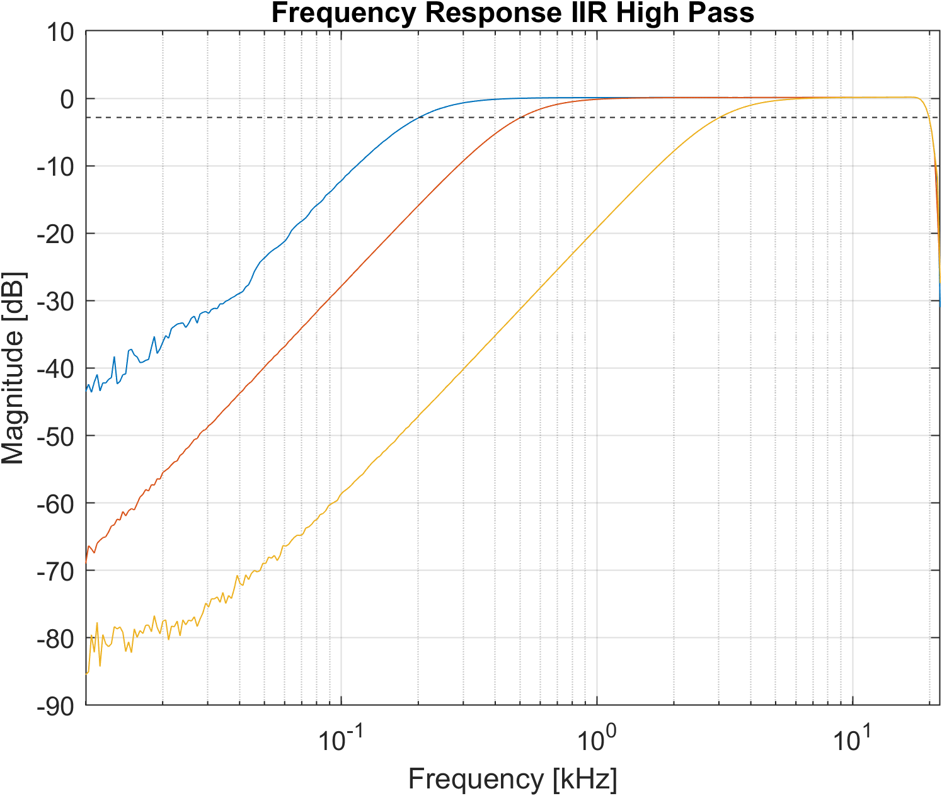
gitfigures/system_design/overdrive/overdrive_hp_filter_test.png
