Niclasapdk/esd6_project/gitfigures/system_design/overdrive/overdrive_nonlinearity_test_fig1.png

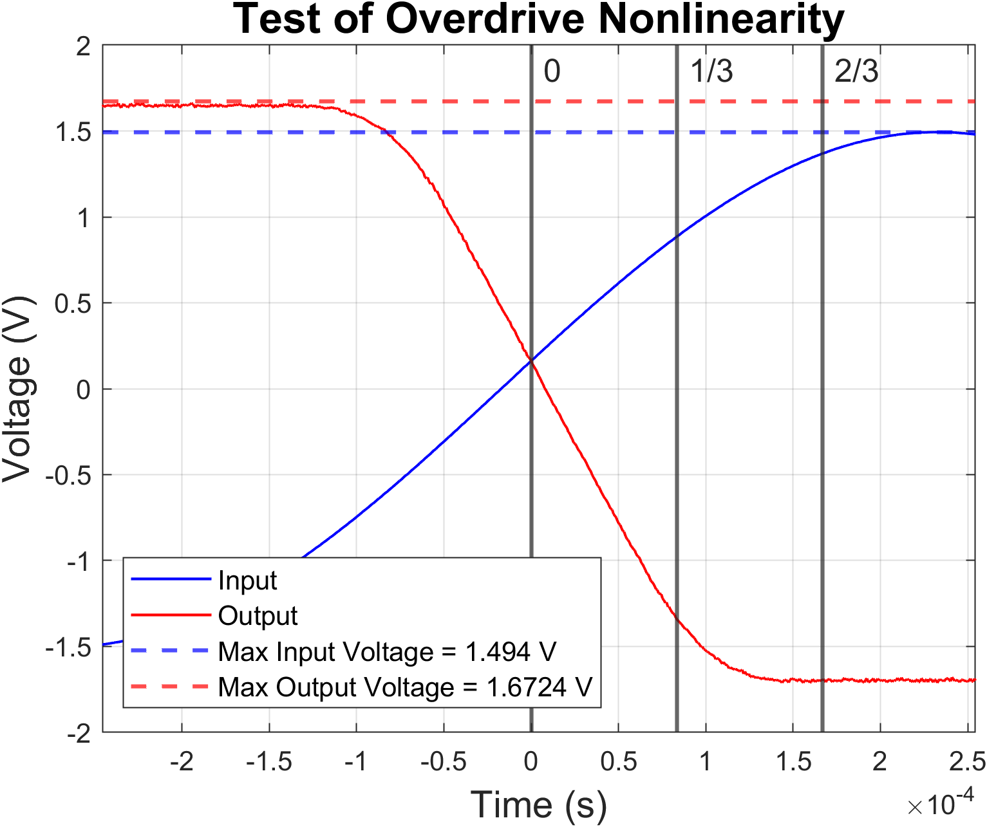
gitfigures/system_design/overdrive/overdrive_nonlinearity_test_fig1.png
