Niclasapdk/esd6_project/gitfigures/system_design/reverb/reverb_early_delay_test.png

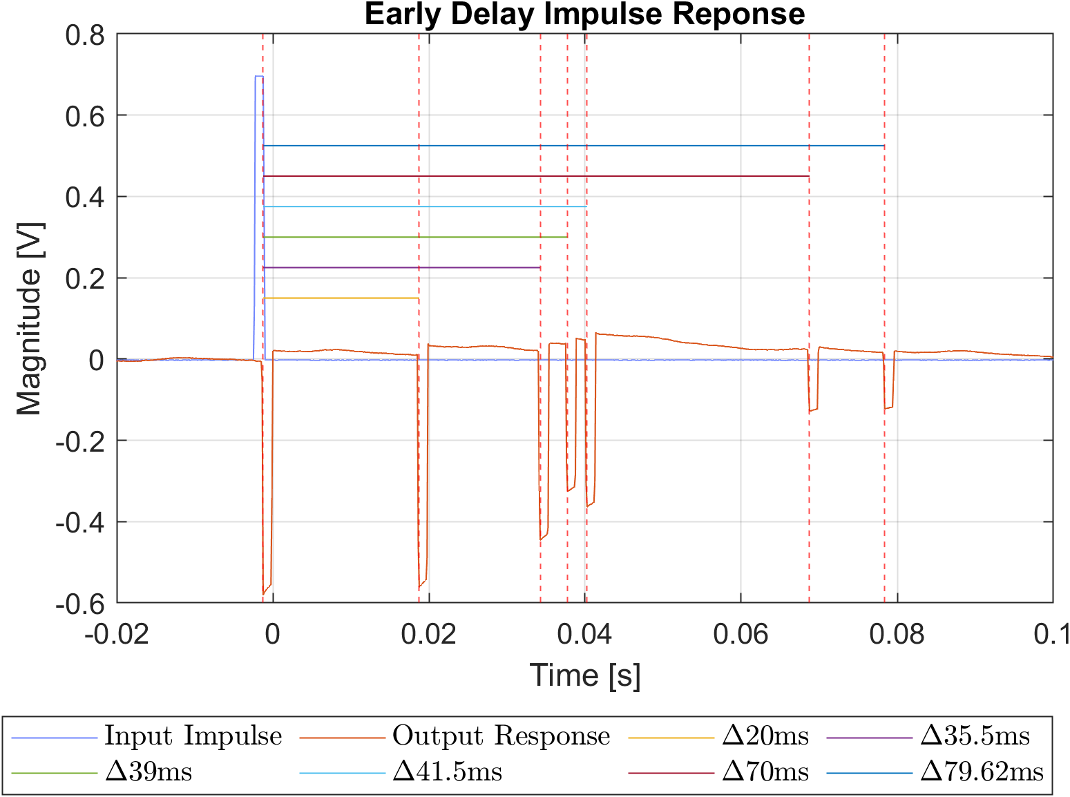
gitfigures/system_design/reverb/reverb_early_delay_test.png
