Niclasapdk/esd6_project/gitfigures/system_design/reverb/reverb_rt60_test_4.png

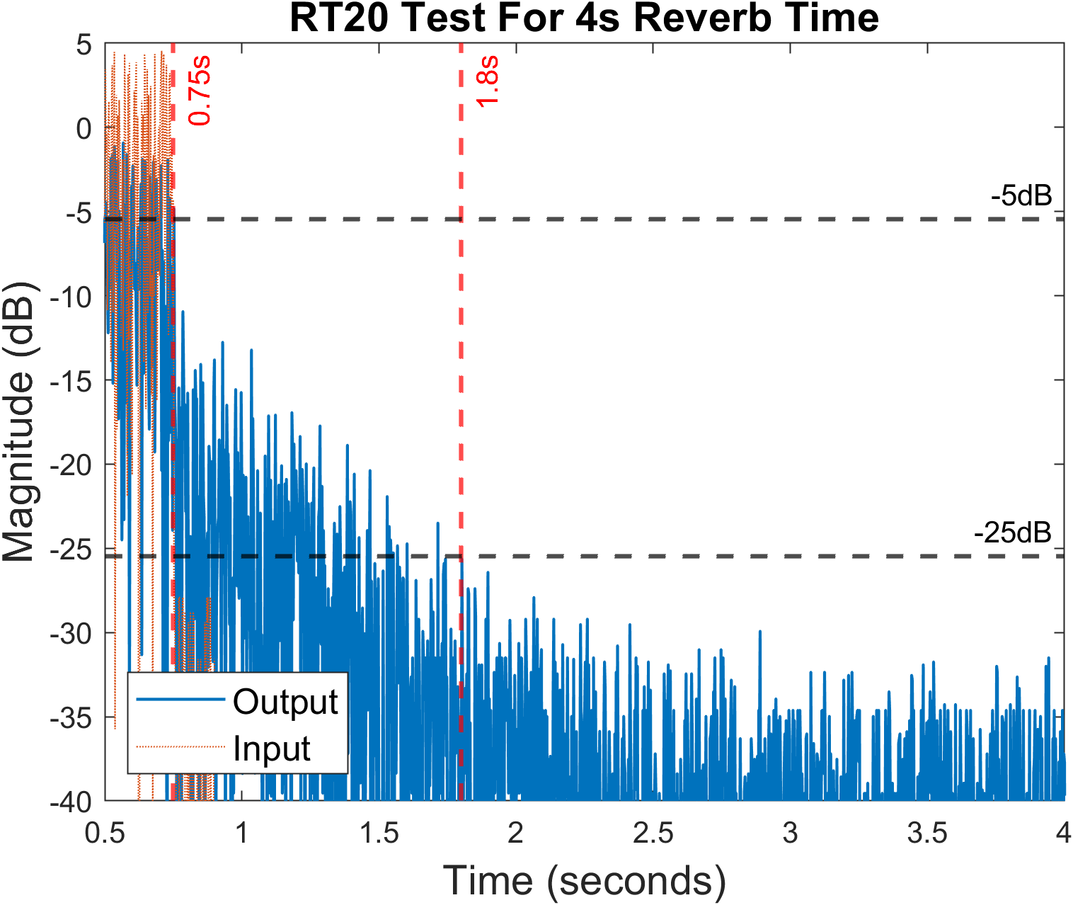
gitfigures/system_design/reverb/reverb_rt60_test_4.png
