Niclasapdk/esd6_project/gitfigures/system_design/Tremolo/tremolo_depth_0.5_test.png

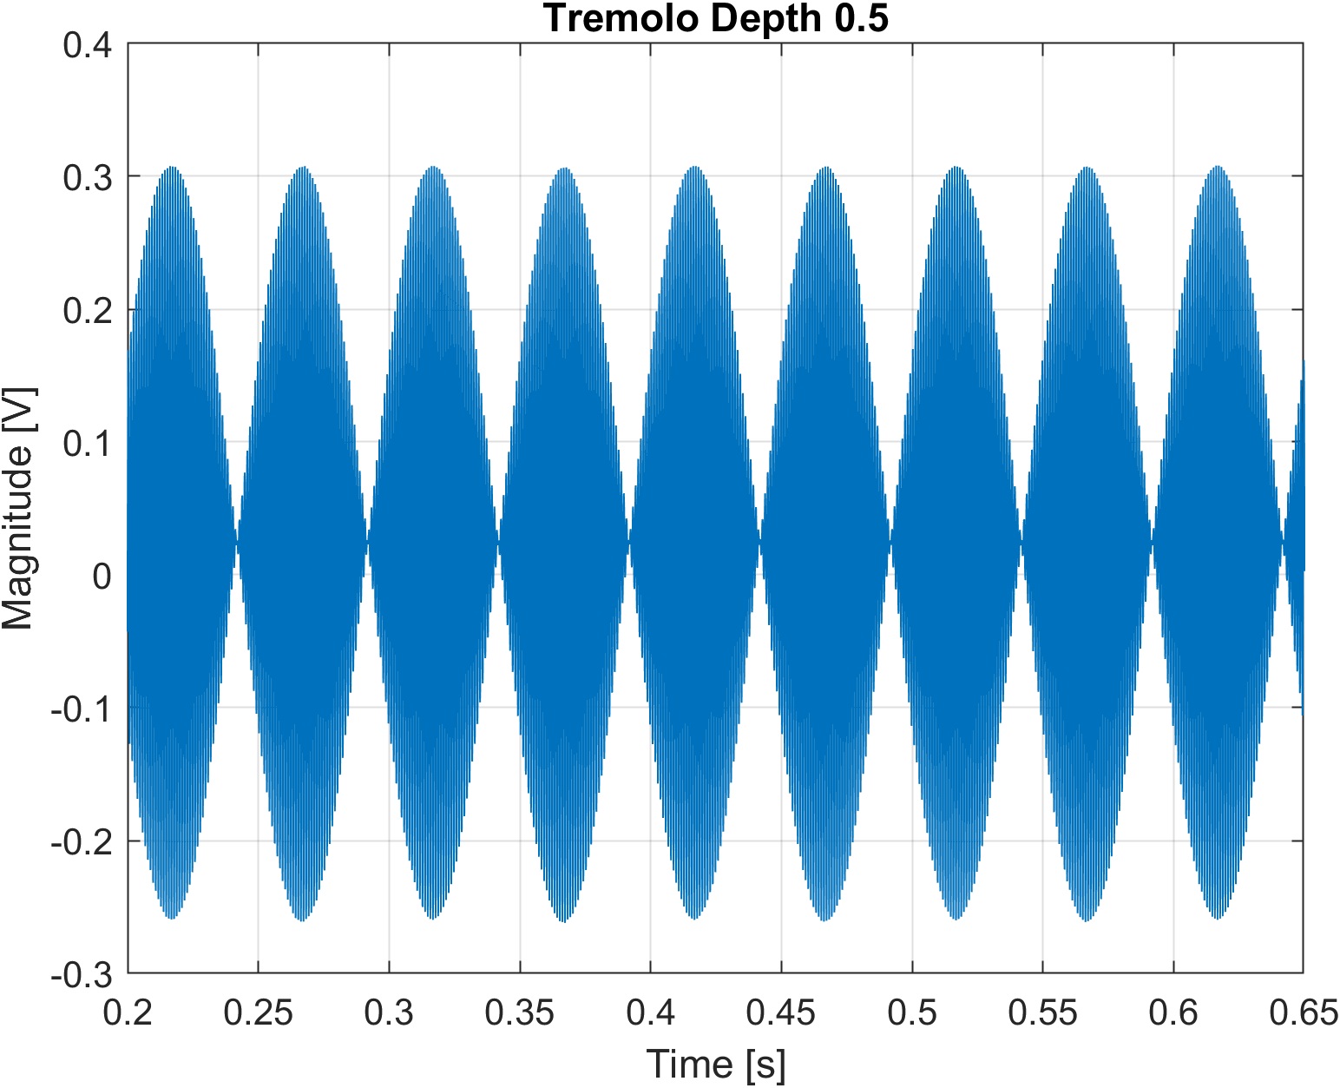
gitfigures/system_design/Tremolo/tremolo_depth_0.5_test.png
