Niclasapdk/esd6_project/gitfigures/system_design/Tremolo/tremolo_depth_1_test.png

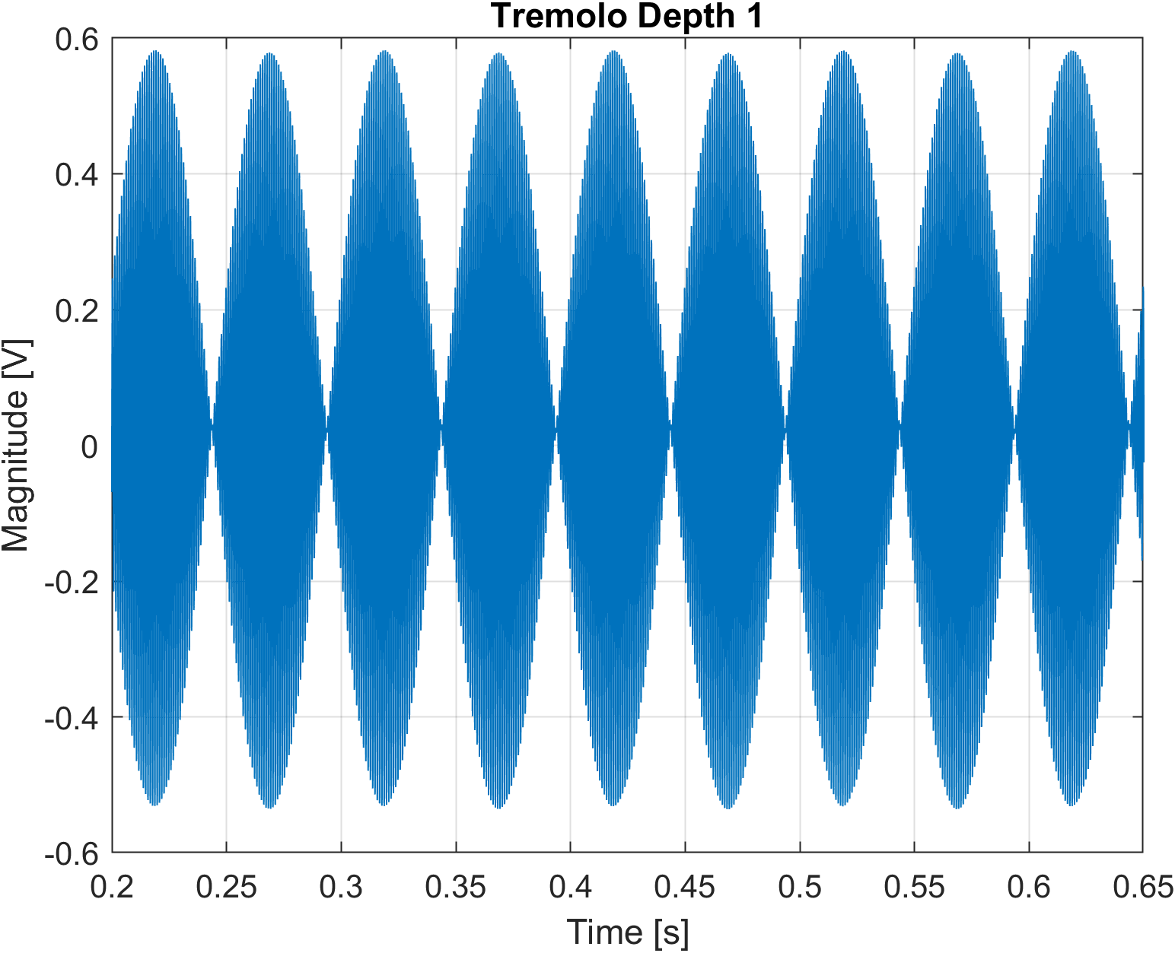
gitfigures/system_design/Tremolo/tremolo_depth_1_test.png
