Niclasapdk/esd6_project/gitfigures/system_design/Tremolo/tremolo_lfo_test_10Hz.png

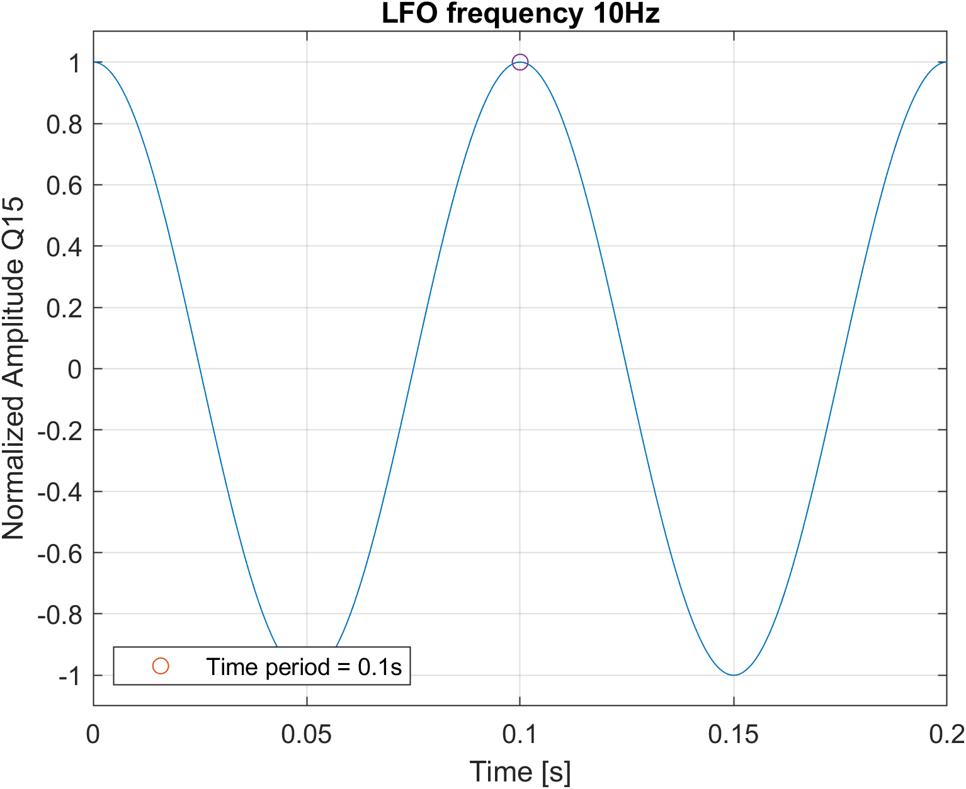
gitfigures/system_design/Tremolo/tremolo_lfo_test_10Hz.png
