Niclasapdk/esd6_project/gitfigures/system_design/Wah/wah_fc_sweep_test.png

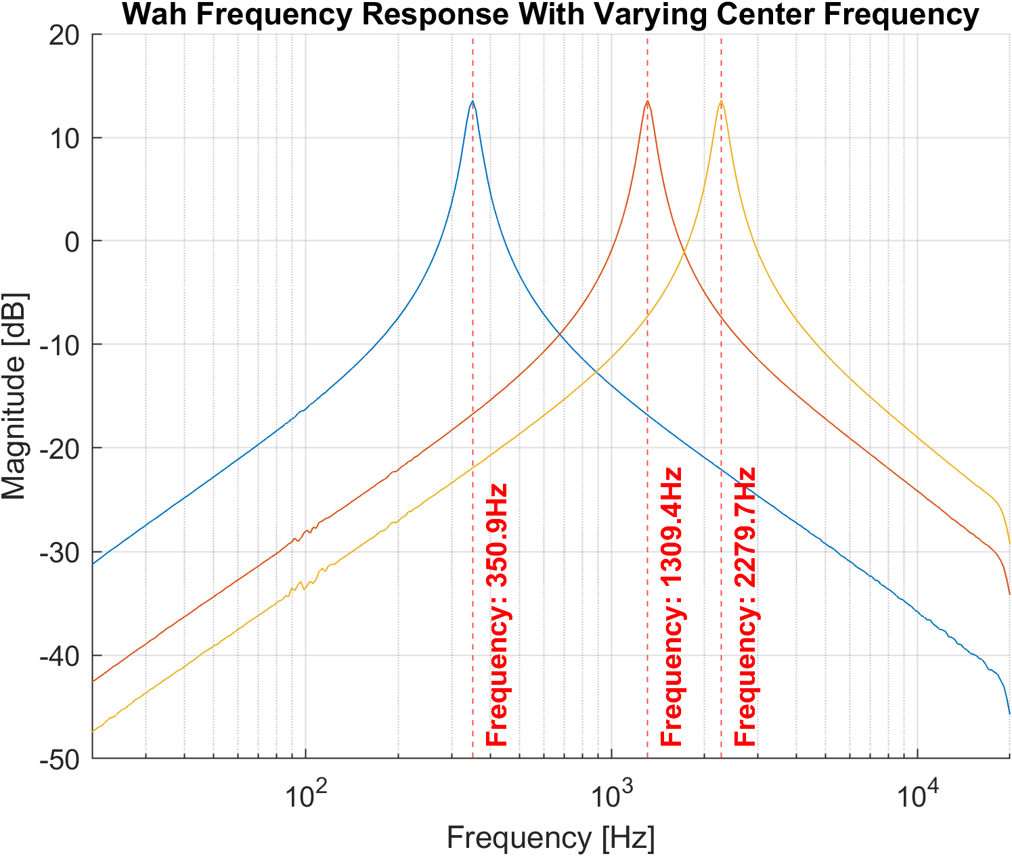
gitfigures/system_design/Wah/wah_fc_sweep_test.png
