Niclasapdk/esd6_project/gitfigures/system_design/Wah/wah_fc_test_500mv_50mv_noshift.png

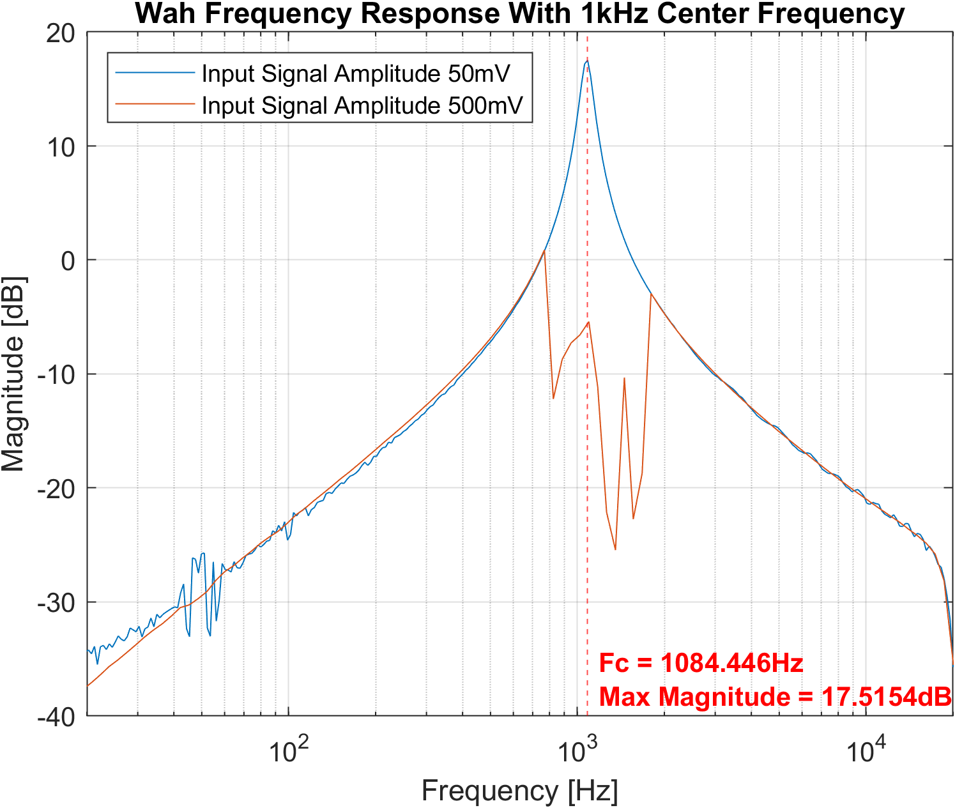
gitfigures/system_design/Wah/wah_fc_test_500mv_50mv_noshift.png
