Niclasapdk/esd6_project/gitfigures/problem_analysis/c5535_ezdsp.png

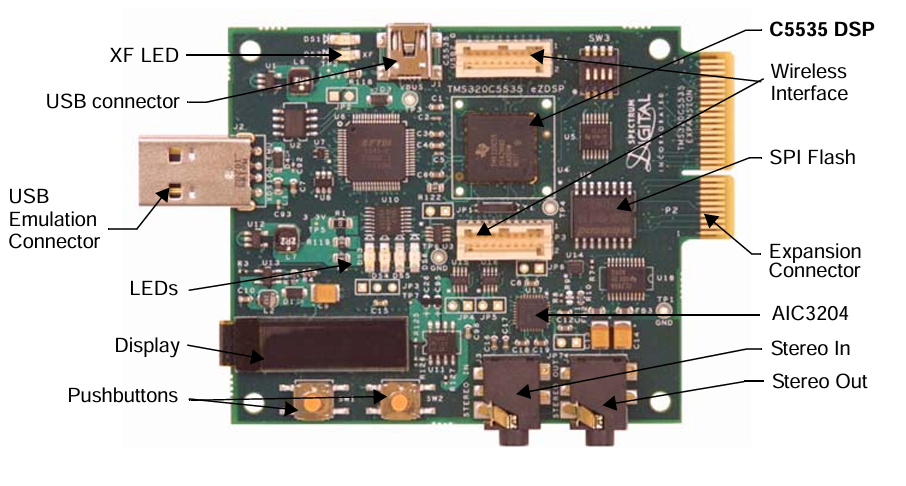
gitfigures/problem_analysis/c5535_ezdsp.png
