Niclasapdk/esd6_project/gitfigures/problem_analysis/decay-PreDelay.png

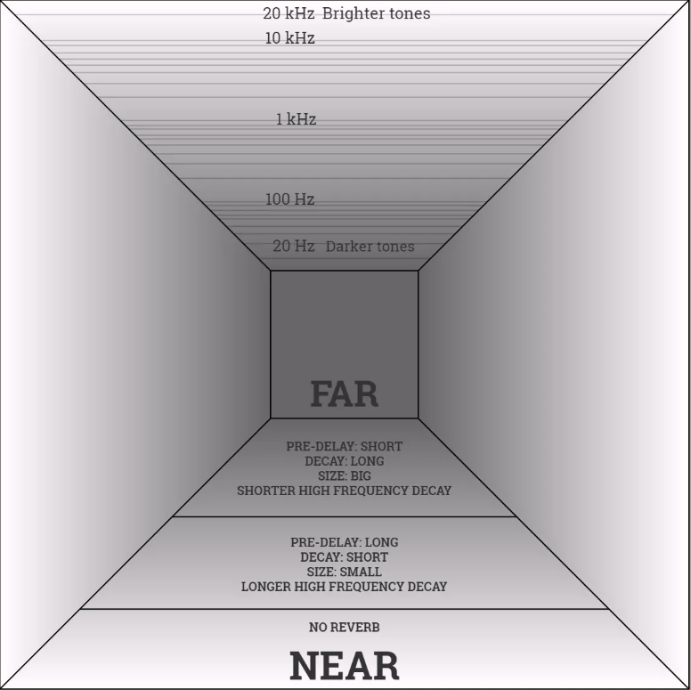
gitfigures/problem_analysis/decay-PreDelay.png
