Niclasapdk/esd6_project/gitfigures/problem_analysis/Dynamic-Range.png

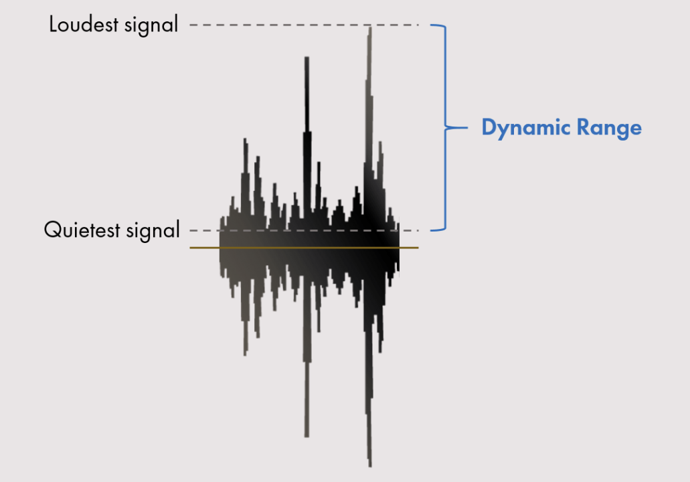
gitfigures/problem_analysis/Dynamic-Range.png
