Niclasapdk/esd6_project/gitfigures/problem_analysis/effects/charactericsticcurve_overdrive_analysis.png

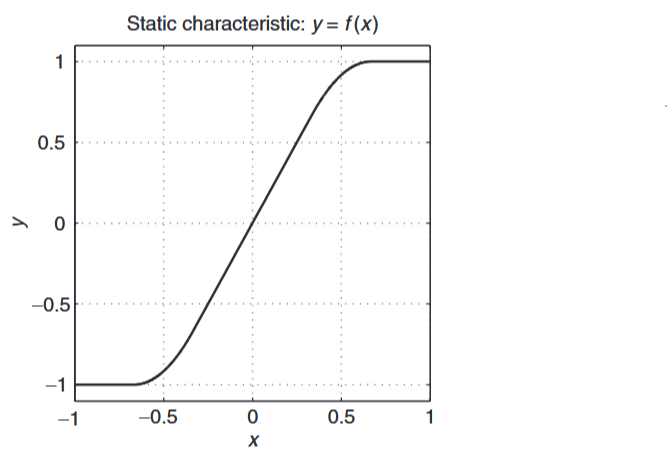
gitfigures/problem_analysis/effects/charactericsticcurve_overdrive_analysis.png
