Niclasapdk/esd6_project/gitfigures/problem_analysis/effects/DynamicRange.drawio.png

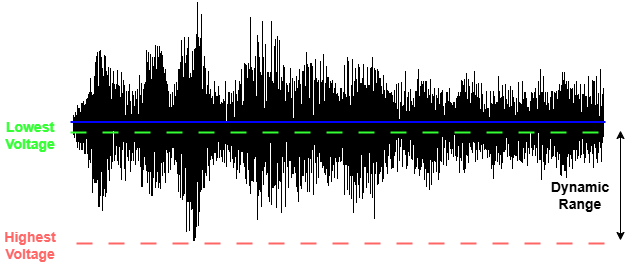
gitfigures/problem_analysis/effects/DynamicRange.drawio.png
