Niclasapdk/esd6_project/gitfigures/problem_analysis/effects/FIR_comb.drawio.png

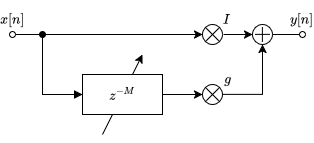
gitfigures/problem_analysis/effects/FIR_comb.drawio.png
