Niclasapdk/esd6_project/gitfigures/problem_analysis/effects/IIR_comb.drawio.png

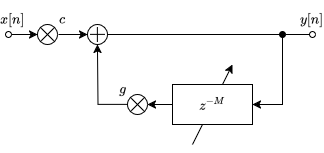
gitfigures/problem_analysis/effects/IIR_comb.drawio.png
