Niclasapdk/esd6_project/gitfigures/problem_analysis/effects/universal_comb_filter.drawio.png

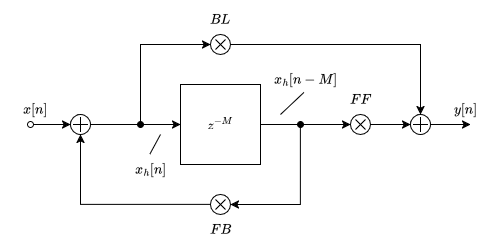
gitfigures/problem_analysis/effects/universal_comb_filter.drawio.png
