Niclasapdk/esd6_project/gitfigures/problem_analysis/EQ-10band.png

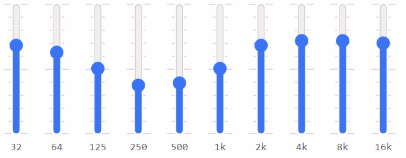
gitfigures/problem_analysis/EQ-10band.png
