Niclasapdk/esd6_project/gitfigures/problem_analysis/humbucker_electromagnetic_interference.png

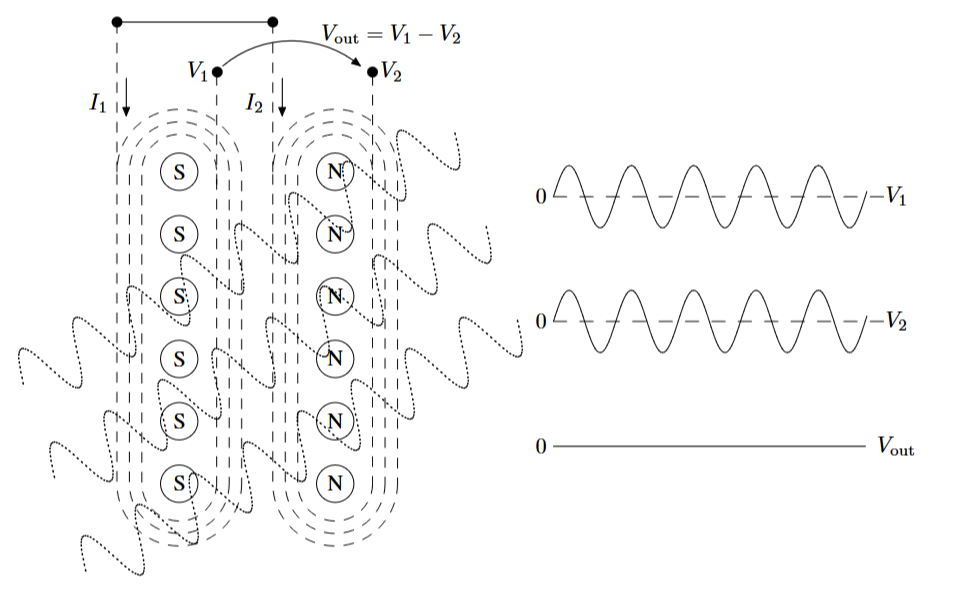
gitfigures/problem_analysis/humbucker_electromagnetic_interference.png
