Niclasapdk/esd6_project/gitfigures/problem_analysis/overtones_guitar.png

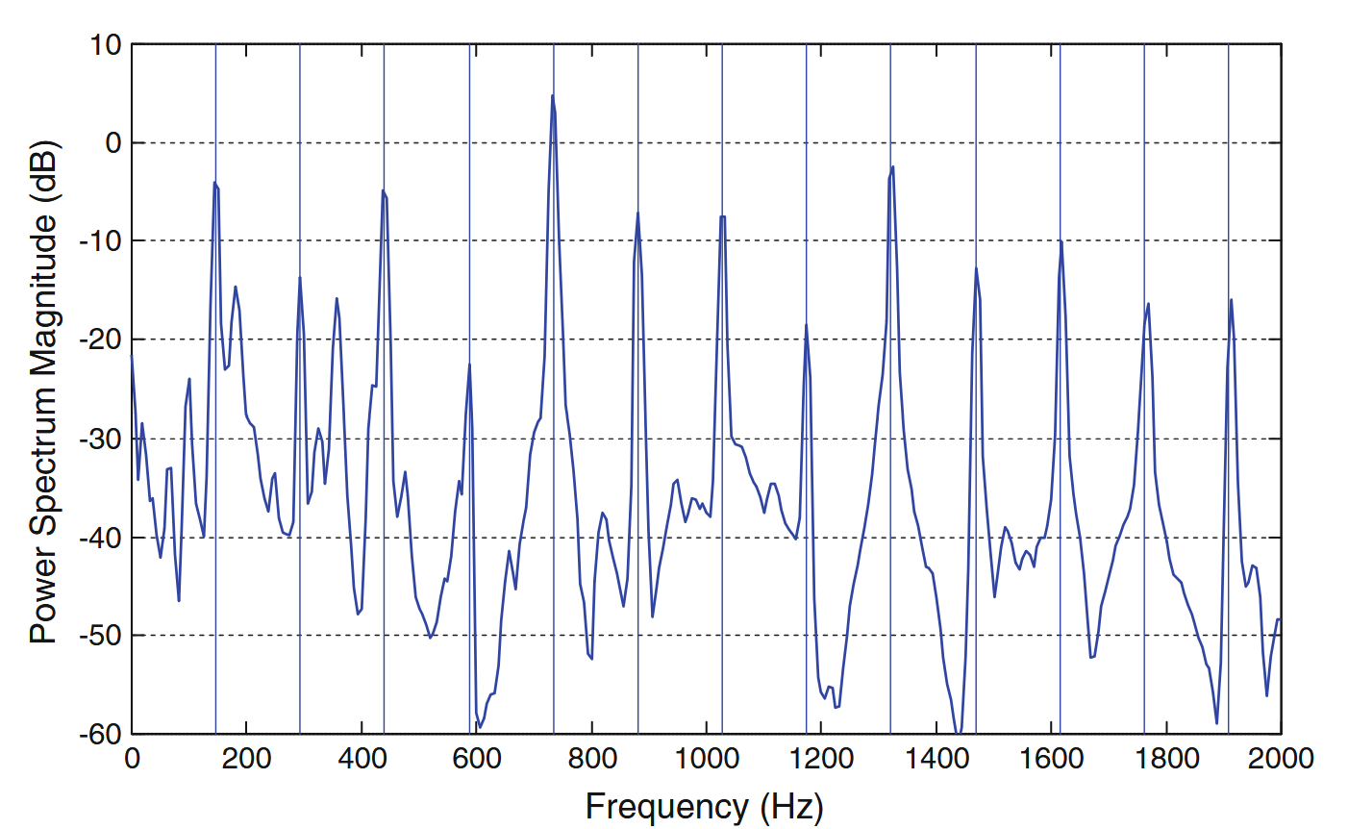
gitfigures/problem_analysis/overtones_guitar.png
