Niclasapdk/esd6_project/gitfigures/problem_analysis/Room-Reverb.png

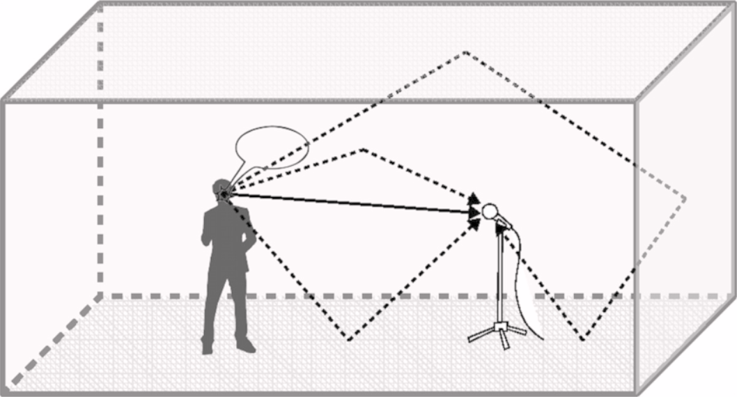
gitfigures/problem_analysis/Room-Reverb.png
