Niclasapdk/esd6_project/gitfigures/problem_analysis/standing_waves_guitar.png

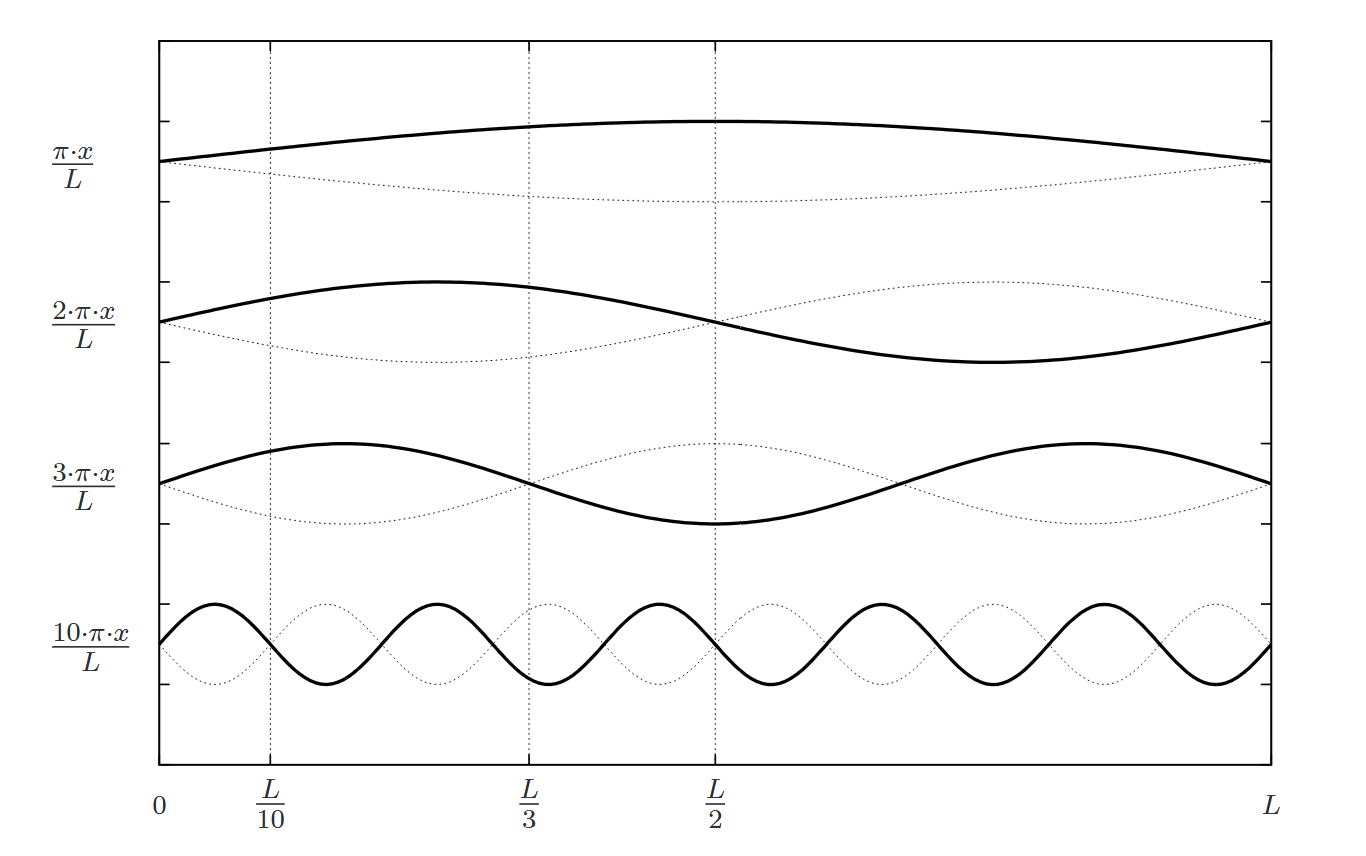
gitfigures/problem_analysis/standing_waves_guitar.png
