Niclasapdk/esd6_project/gitfigures/problem_analysis/tone_and_volume_control.png

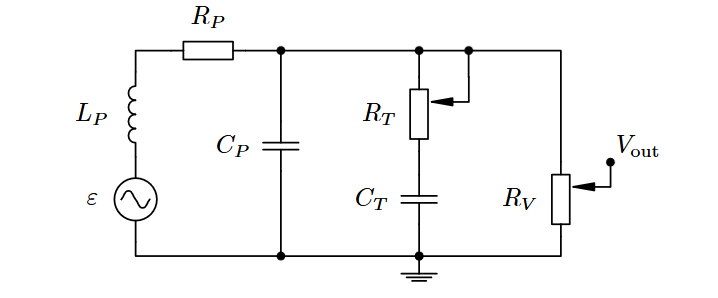
gitfigures/problem_analysis/tone_and_volume_control.png
