Niclasapdk/esd6_project/gitfigures/problem_analysis/Wah-Effect.png

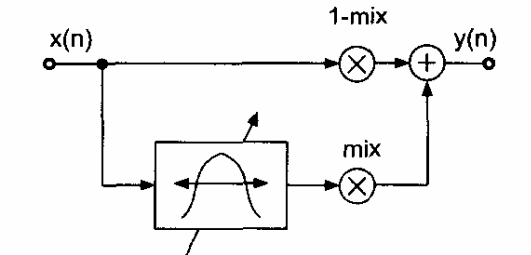
gitfigures/problem_analysis/Wah-Effect.png
