Niclasapdk/esd6_project/gitfigures/problem_analysis/Wave-Reverb.png

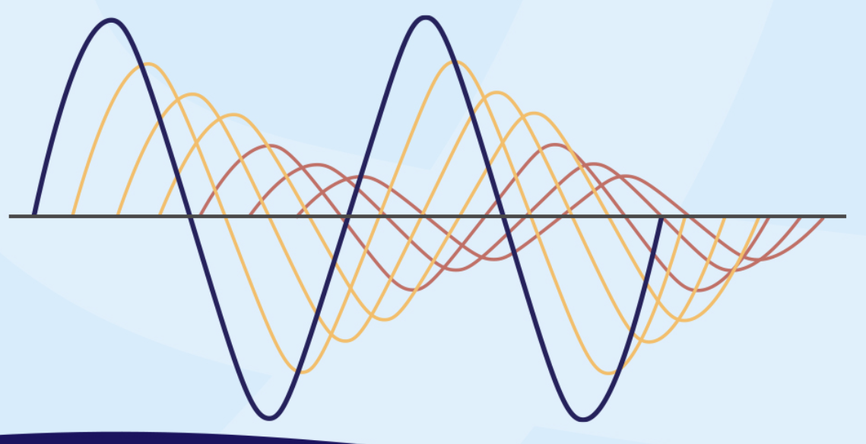
gitfigures/problem_analysis/Wave-Reverb.png
