Niclasapdk/esd6_project/dsp_board/dsp_board_2.pdf

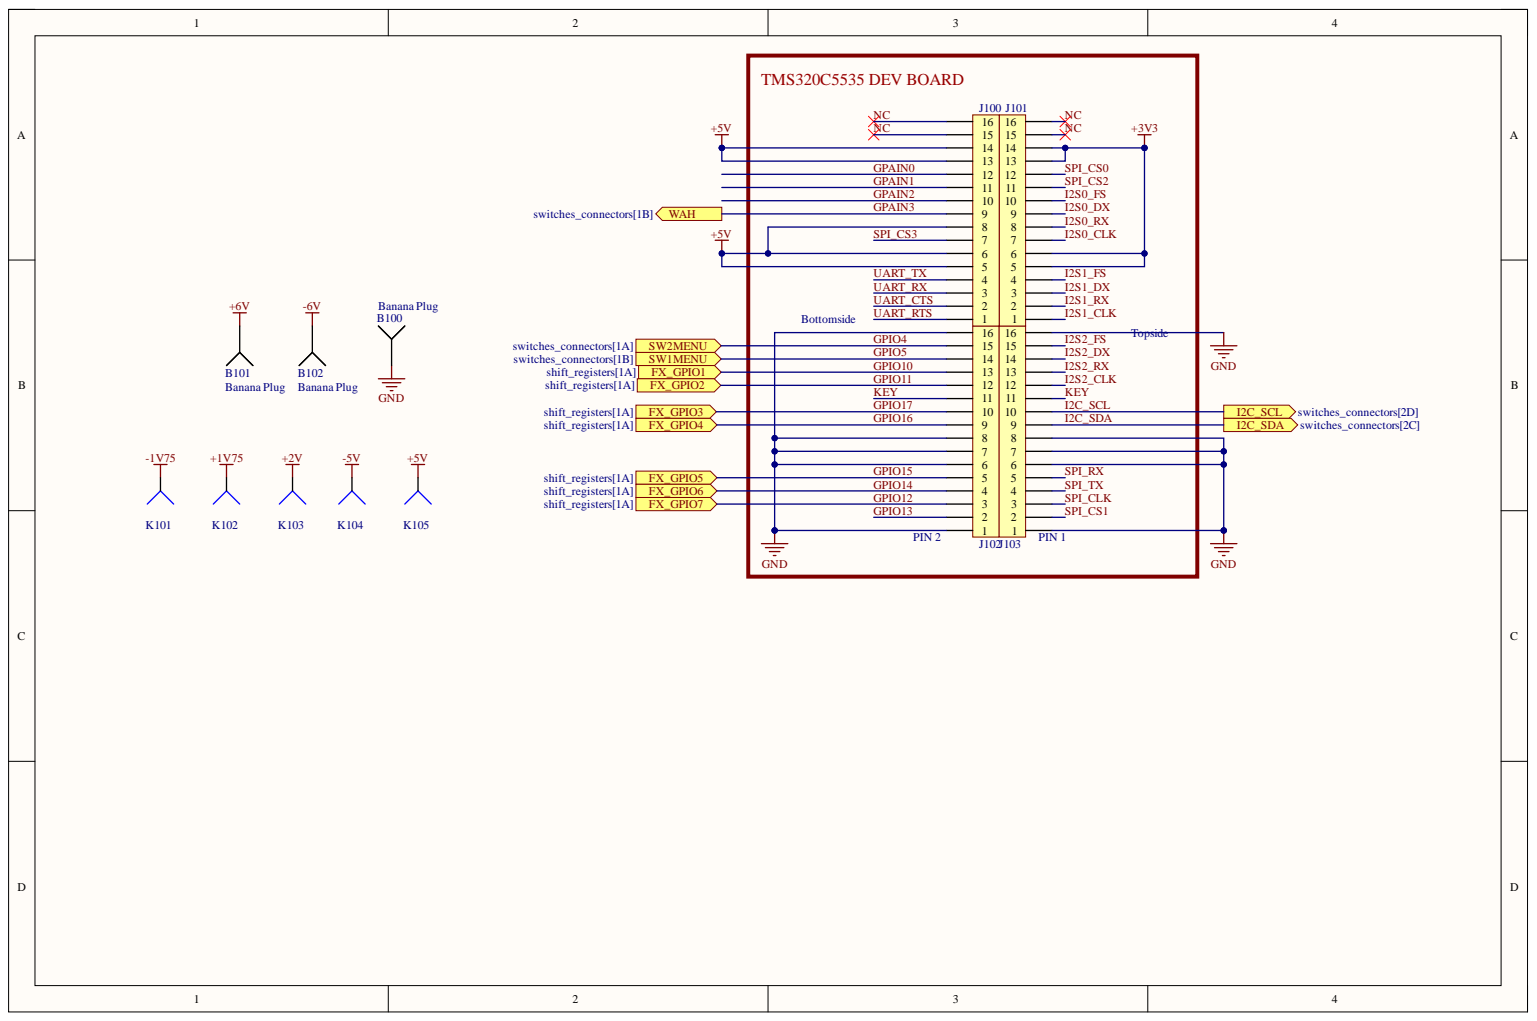
[picture p133: page 1]

U A RT _T X U A RT _RX U A RT _CT S U A RT _ RT S Bo t t oms i d e | | I2S1 _ F S I2S1 _D X I2S1 _RX I2S1 _CL K To

GPIO 4 | | | I2S2 _ F S I2S2 _D X I2S2 _RX I2S2 _CL K K E Y I2C_SCL
GPIO 5
GPIO 1 0
GPIO 1 1
K E Y GPIO 1 7

GPIO 1 6 | | | I2C_SD A

GPIO 1 5 | | SPI_ RX SPI_ T X SPI_CL K SPI_CS1
GPIO 1 4
GPIO 1 2

G | GPIO 1 3

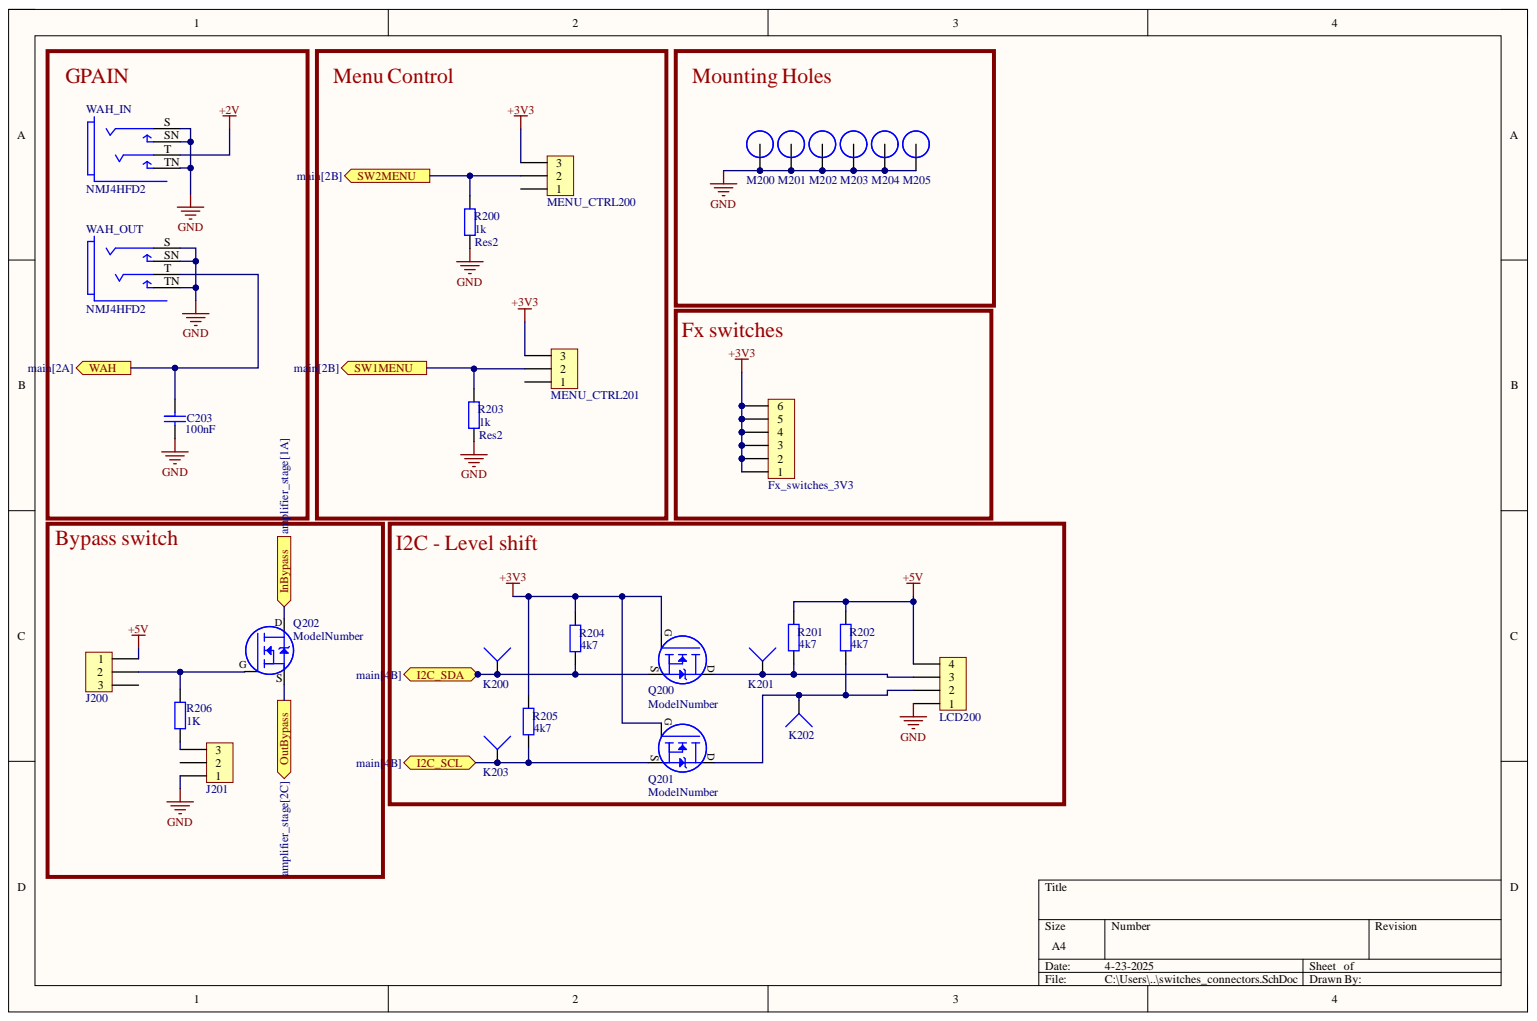
[picture p134: page 2]

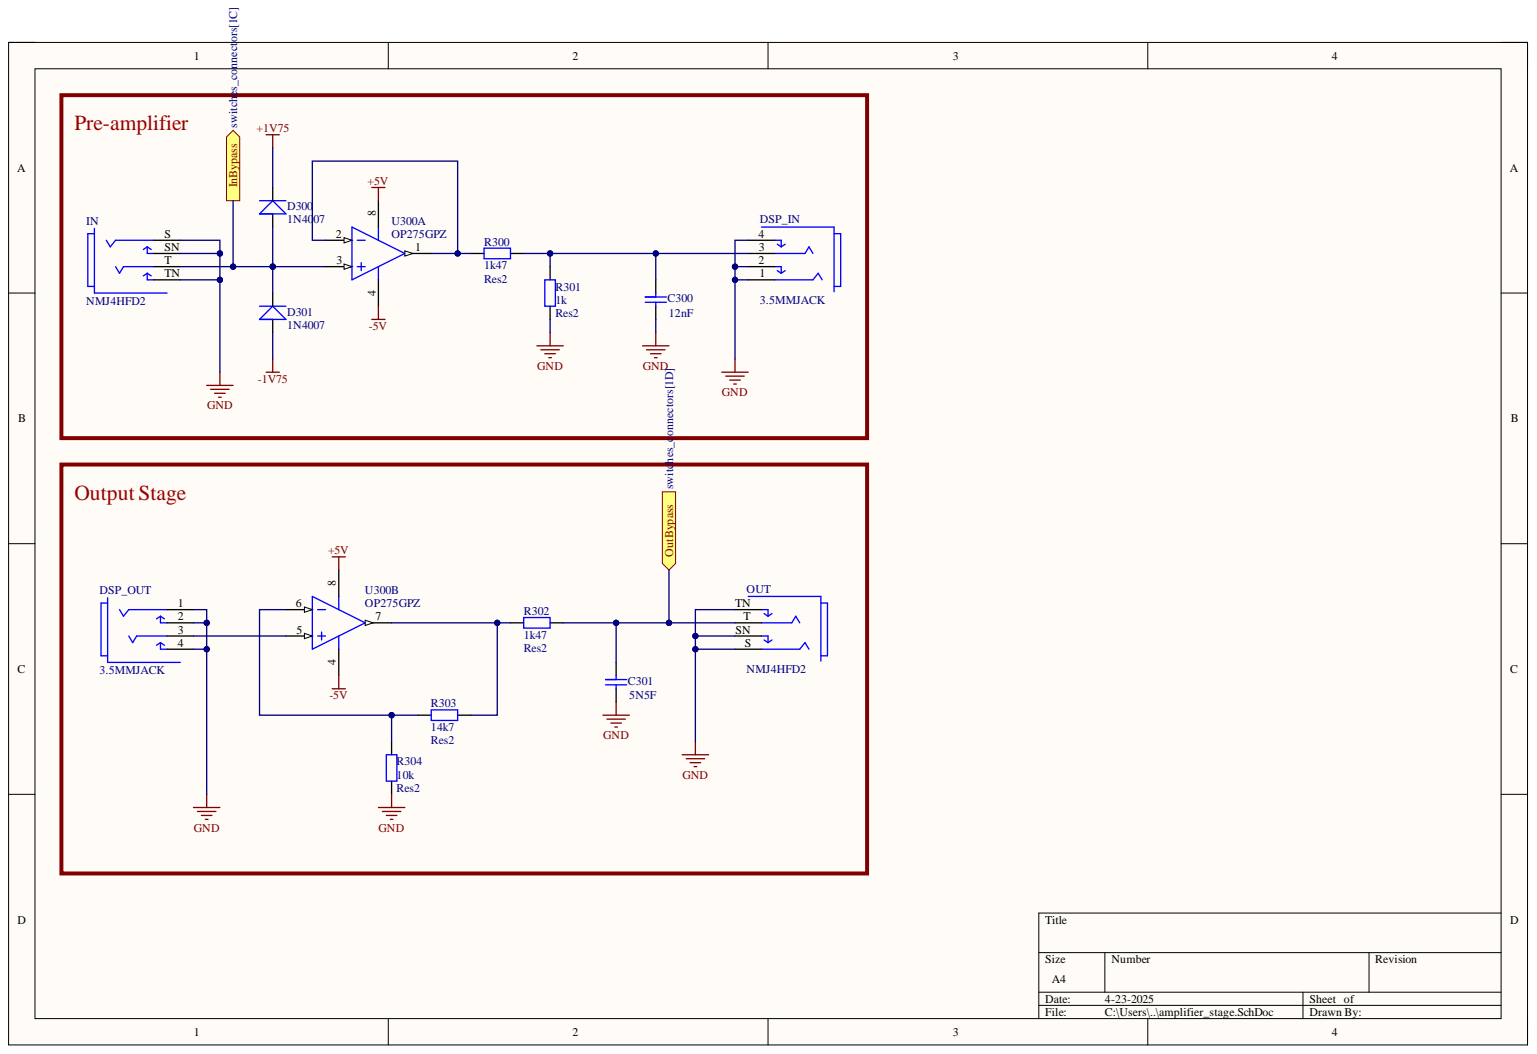
[picture p135: page 3]

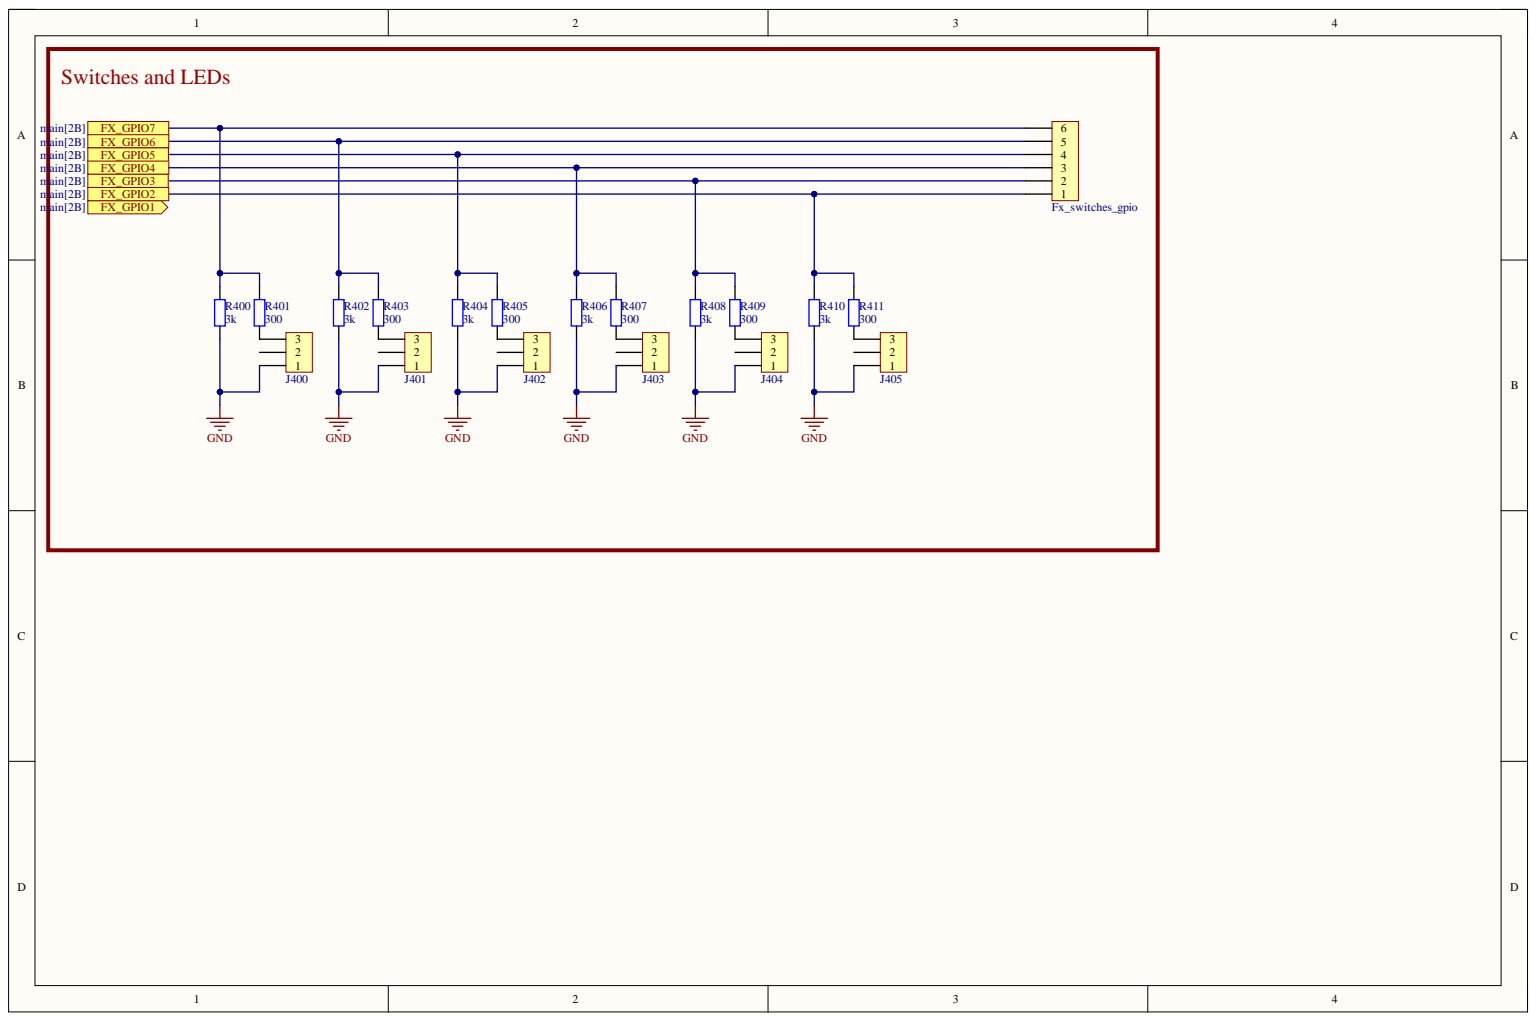
[picture p136: page 4]

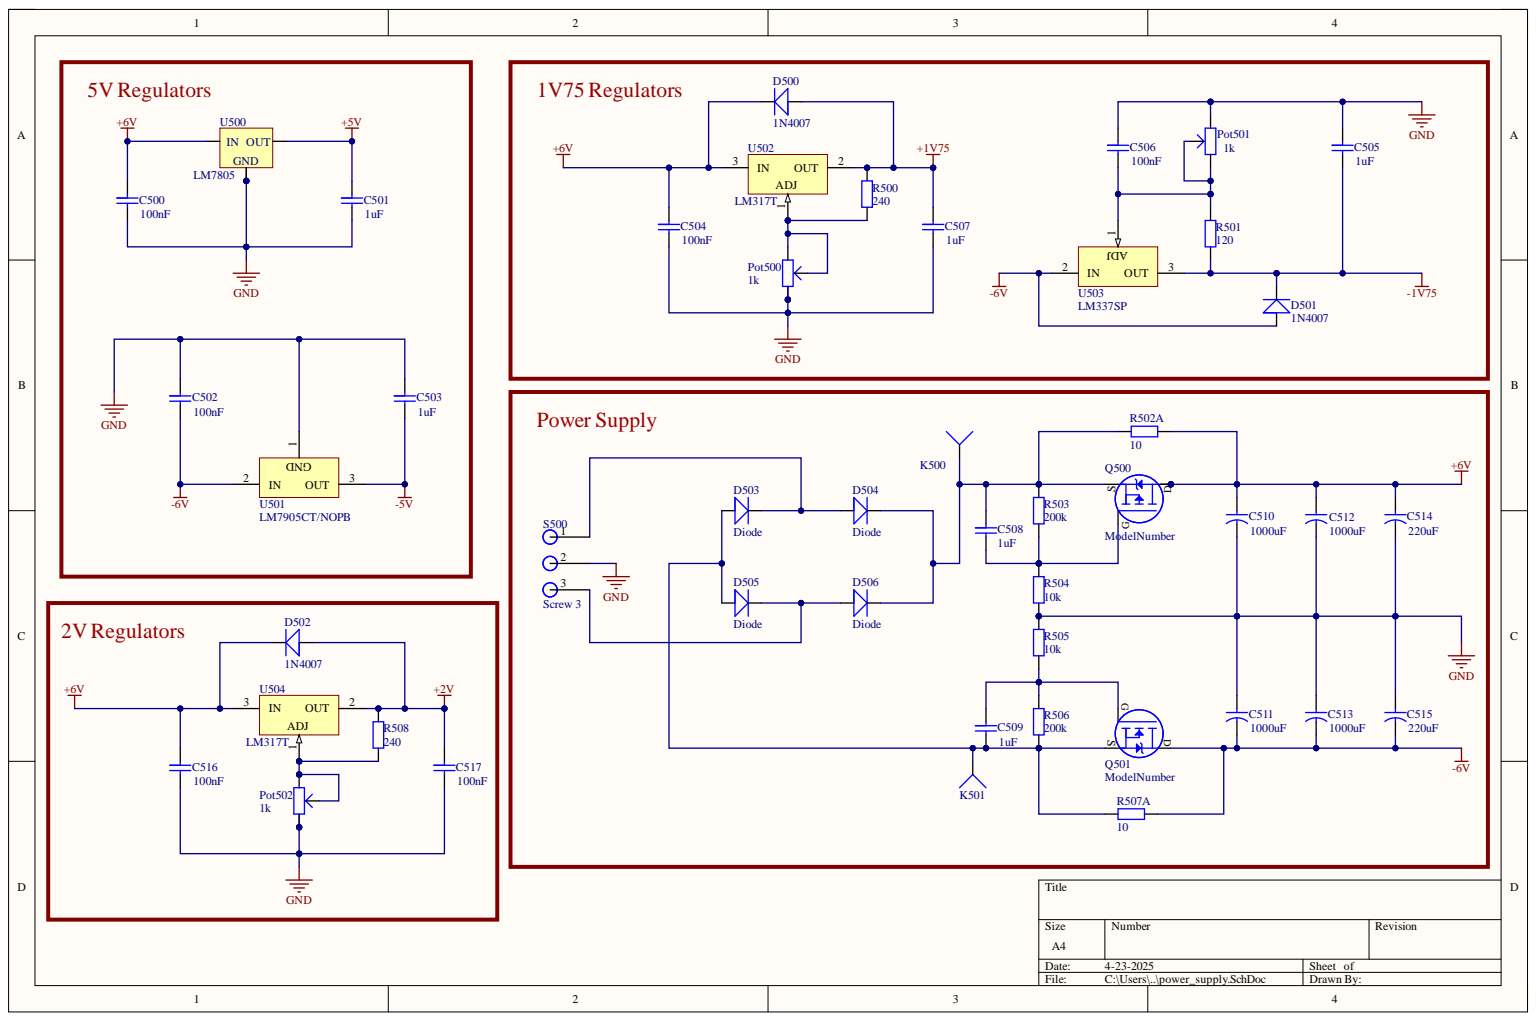
[picture p137: page 5]

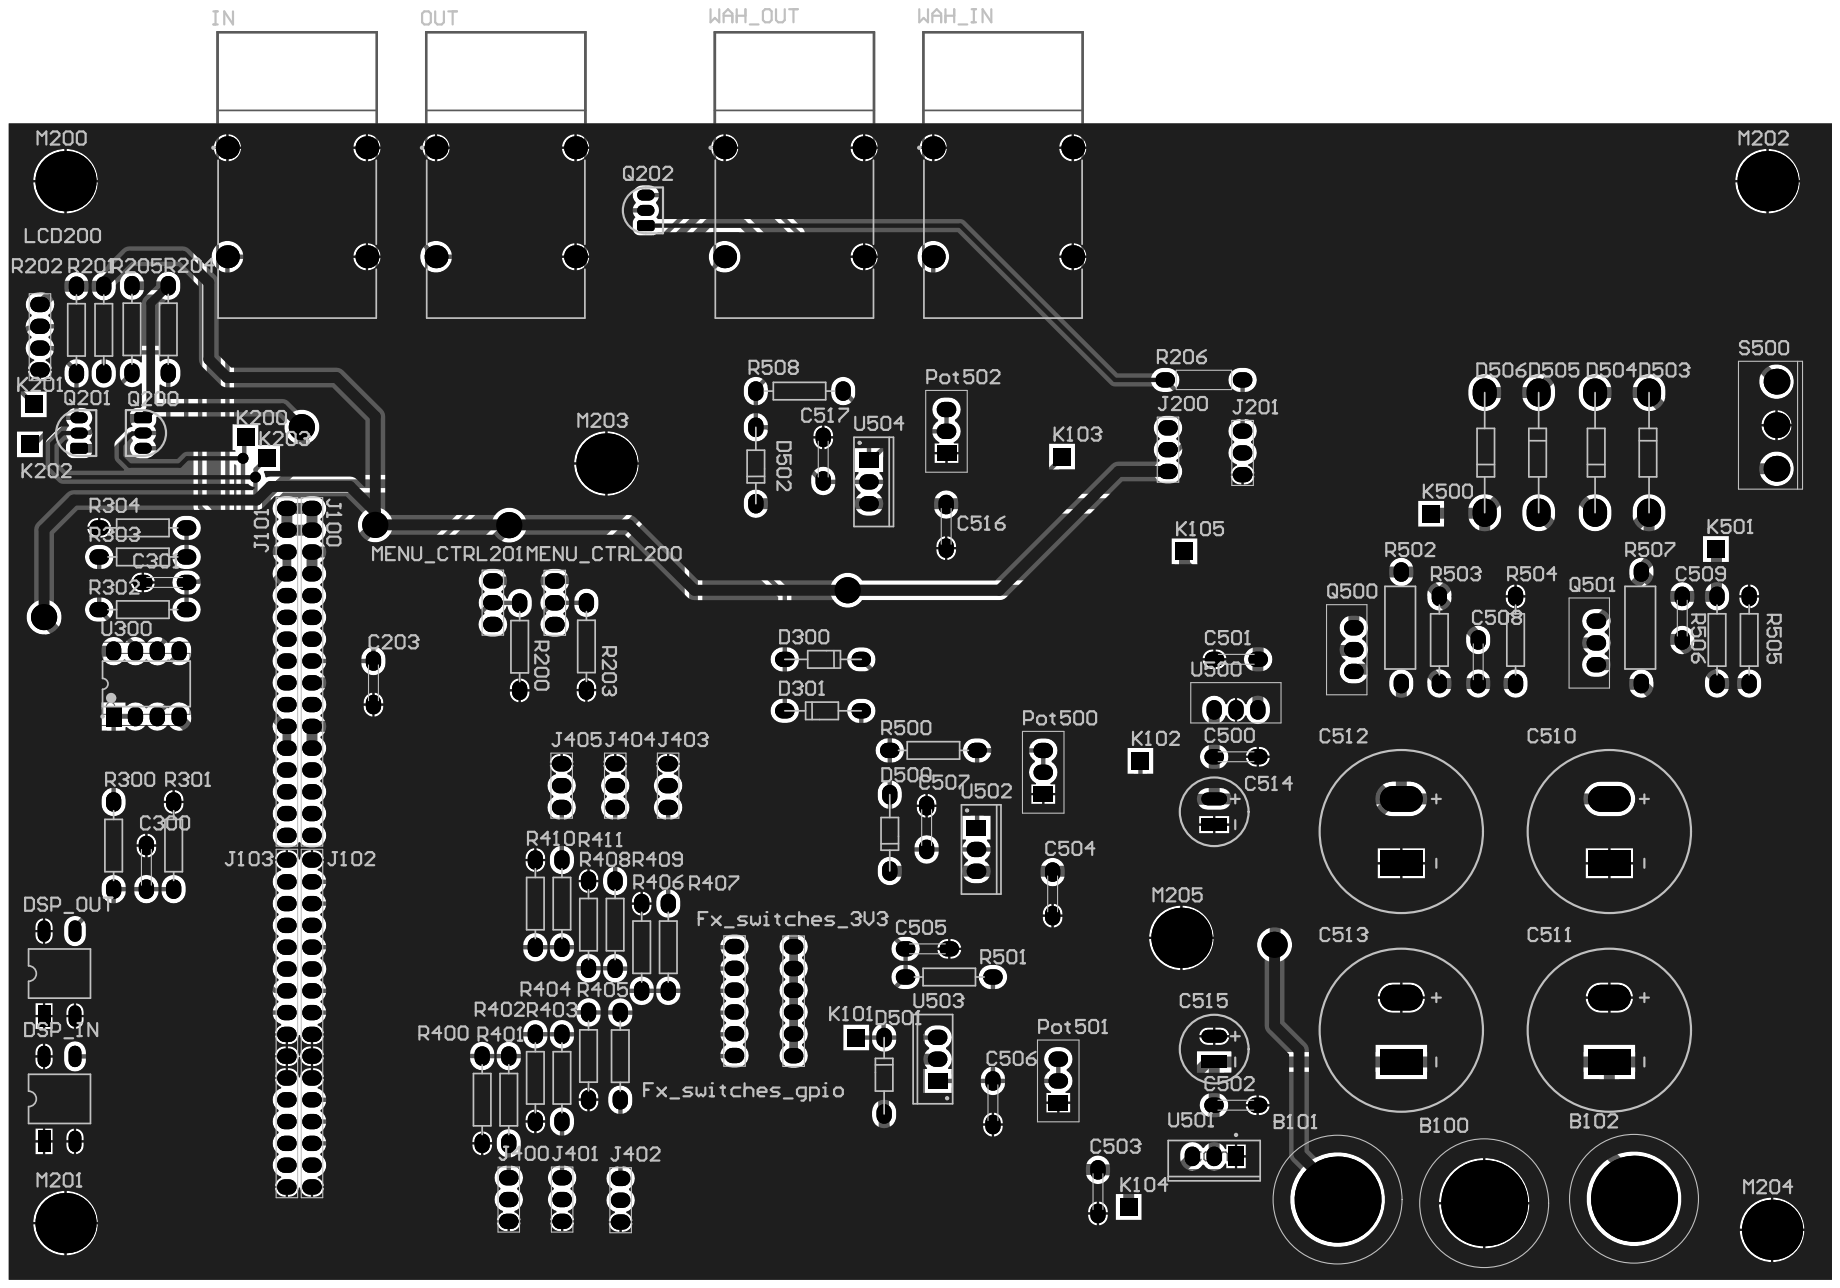
[picture p138: page 6]
