Niclasapdk/esd6_project/ltspice_sim/powersupply/powersupply.pdf

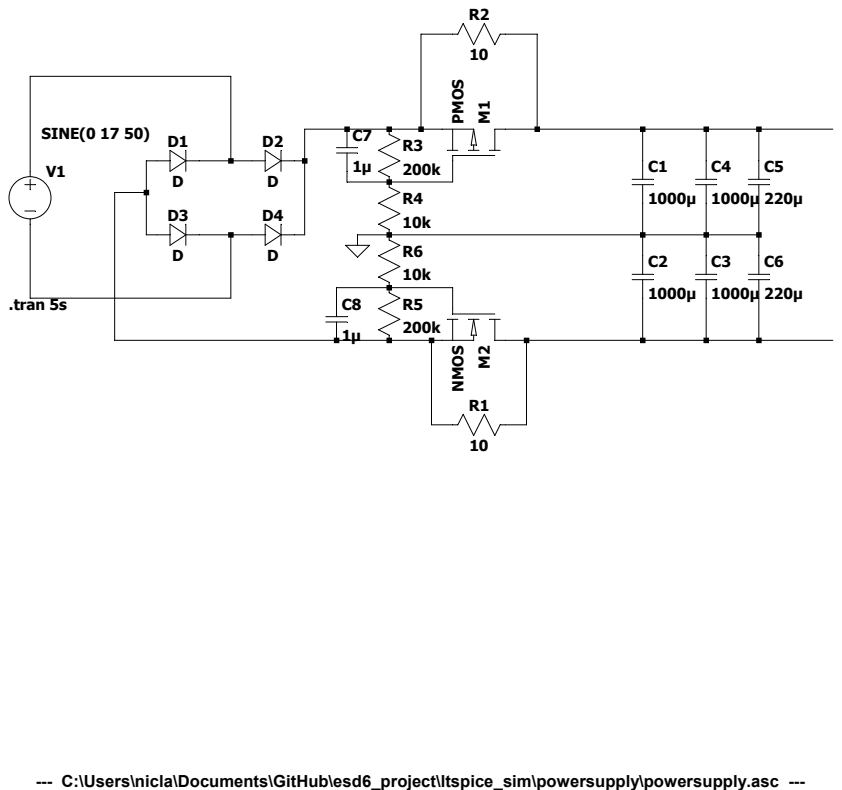
[picture p139: page 1]

--- C:\Users\nicla\Documents\GitHub\esd6_project\ltspice_sim\powersupply\powersupply.asc ---
