Niclasapdk/esd6_project/gitfigures/system_design/analog_frontend/dsp_board.pdf

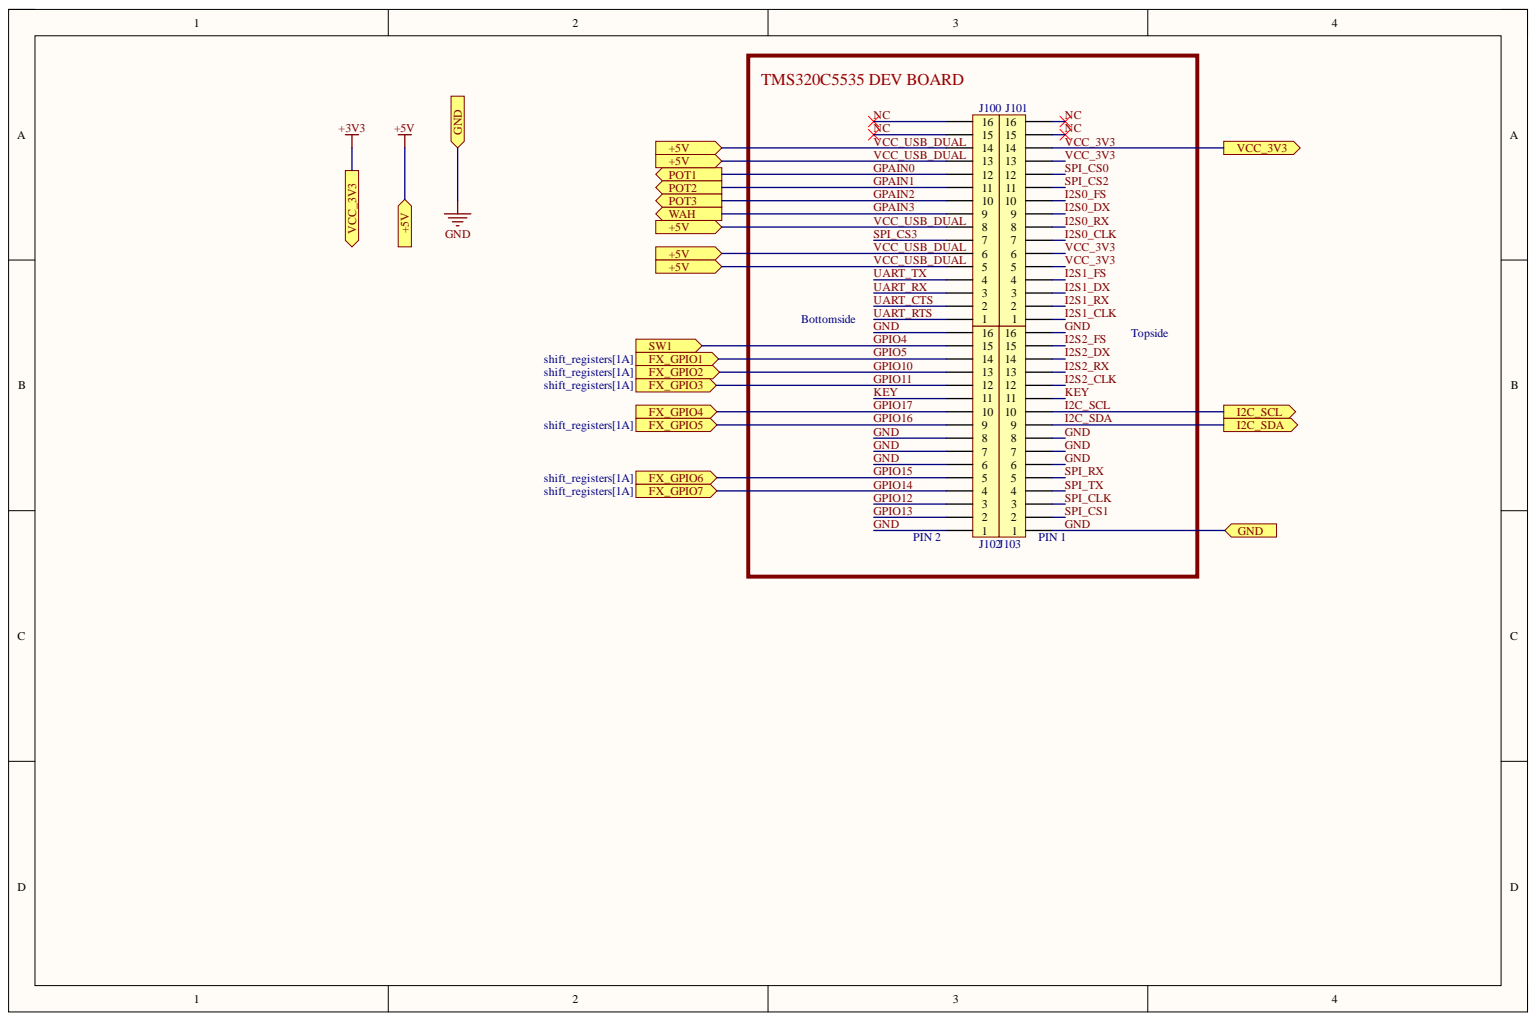
[picture p140: page 1]

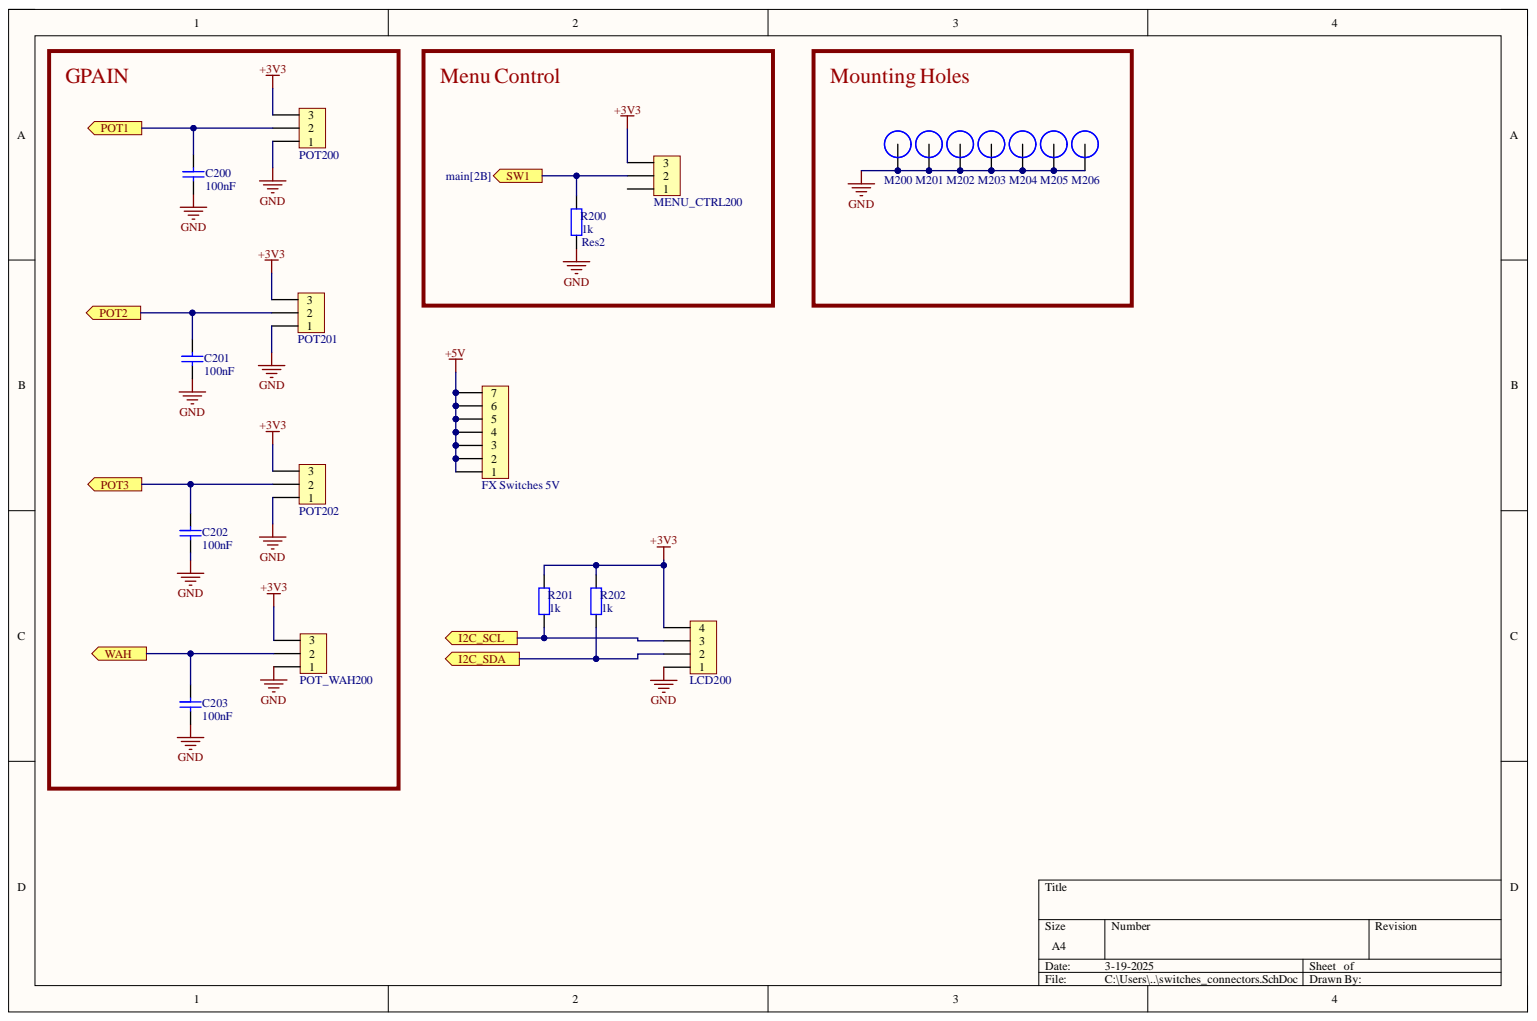
[picture p141: page 2]

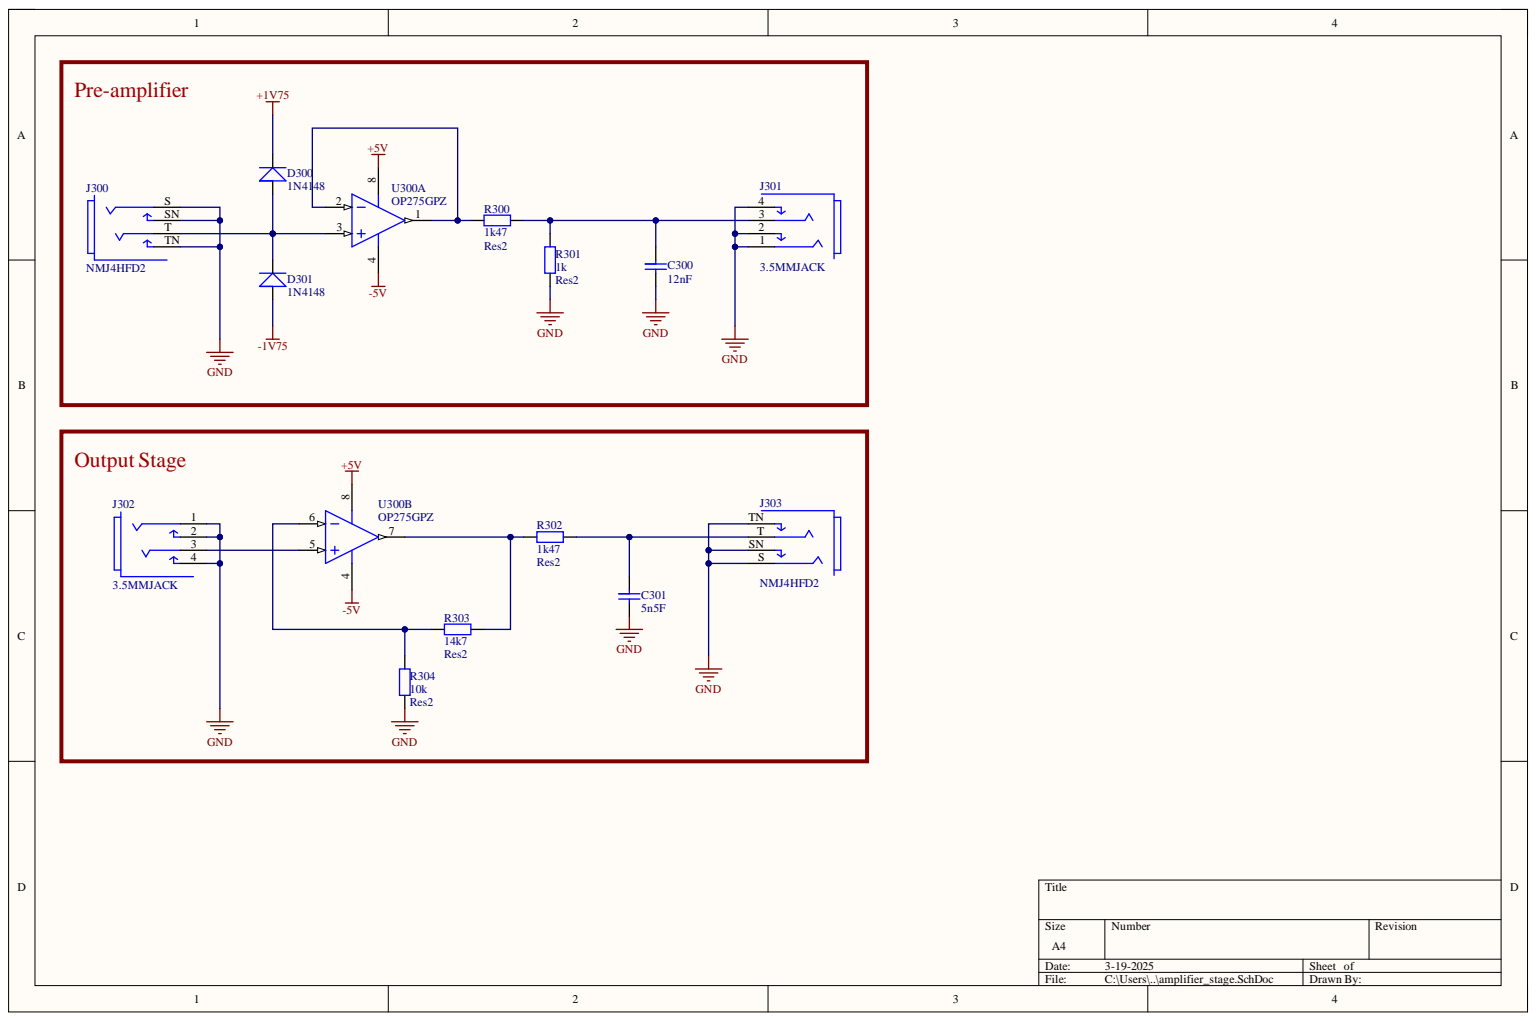
[picture p142: page 3]

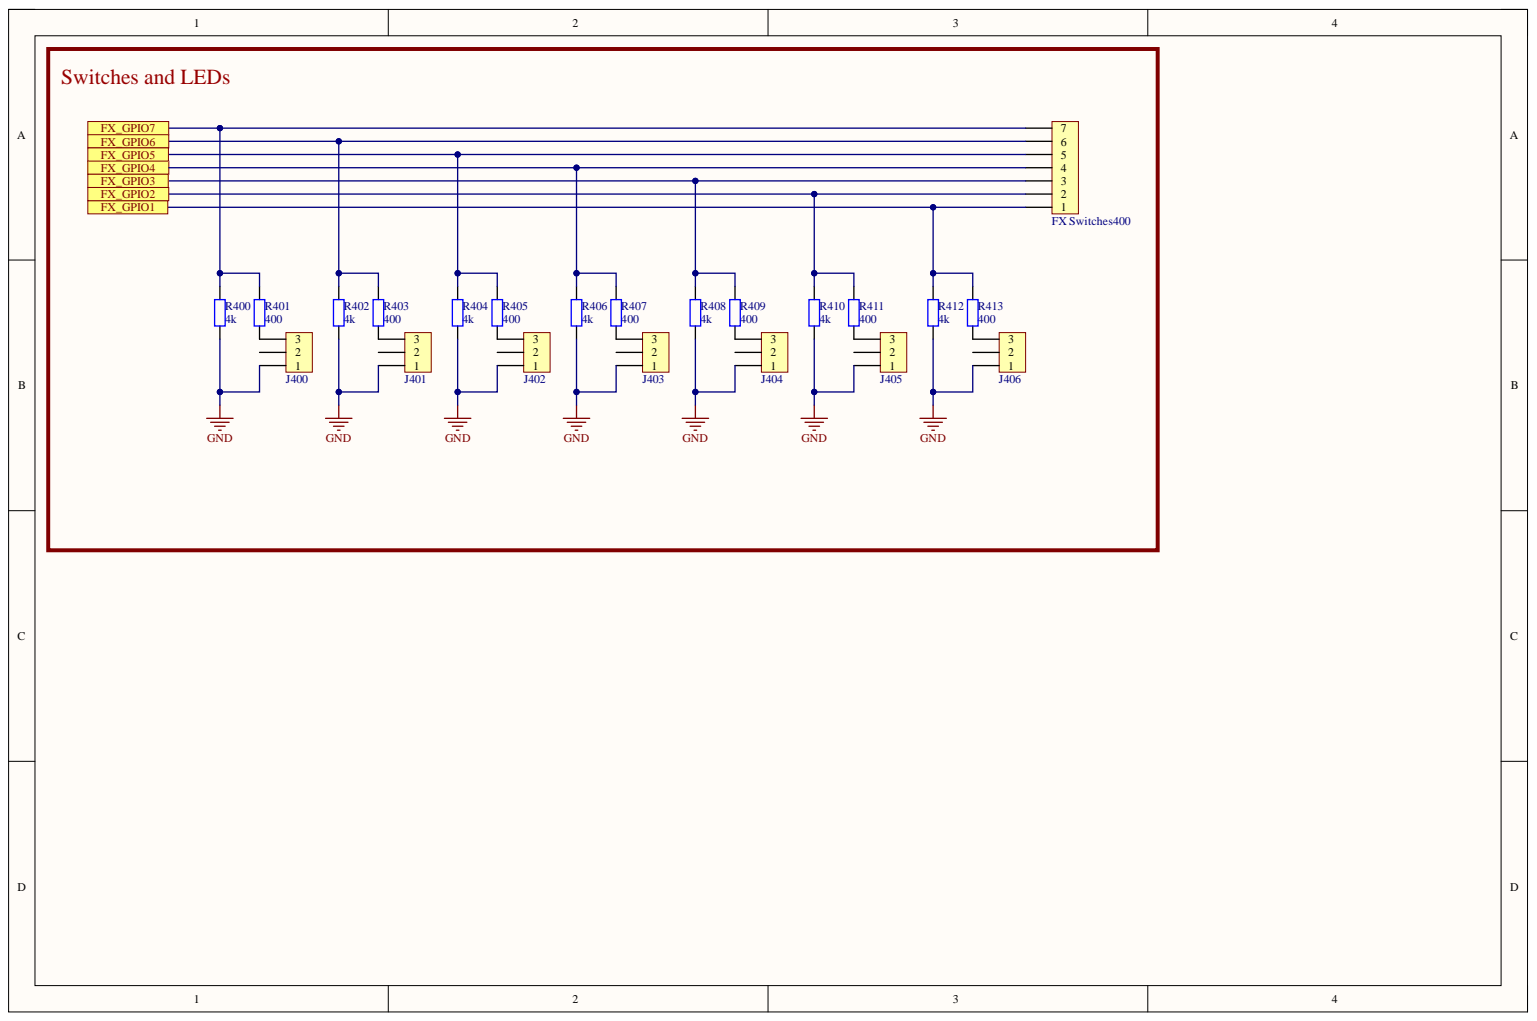
[picture p143: page 4]

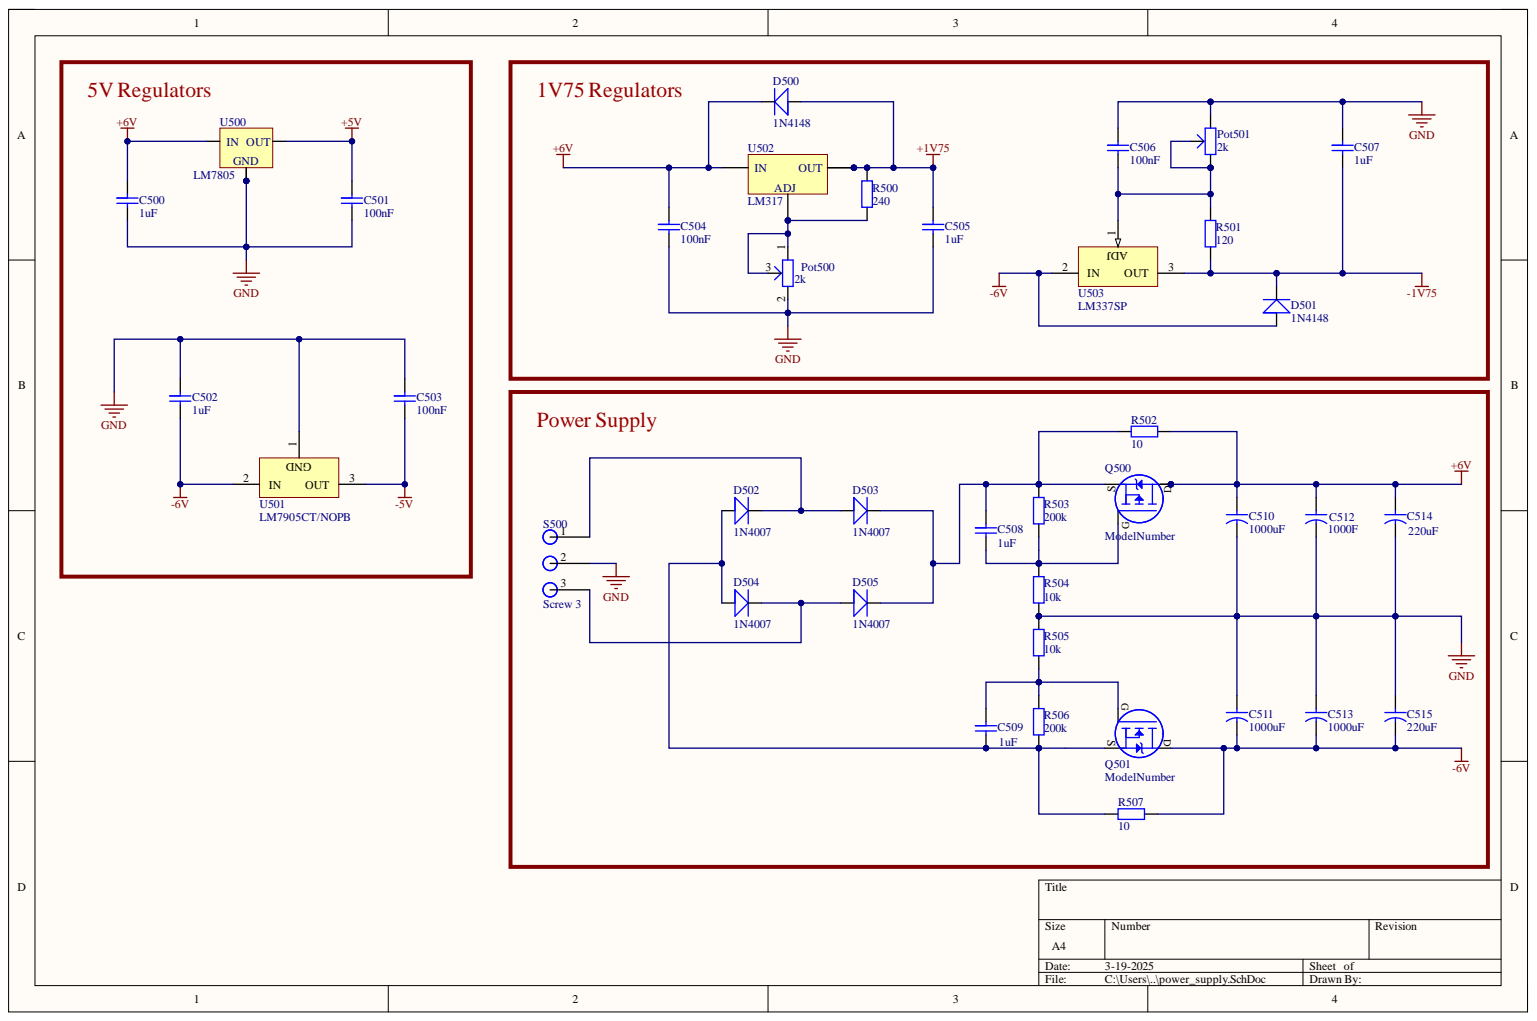
[picture p144: page 5]

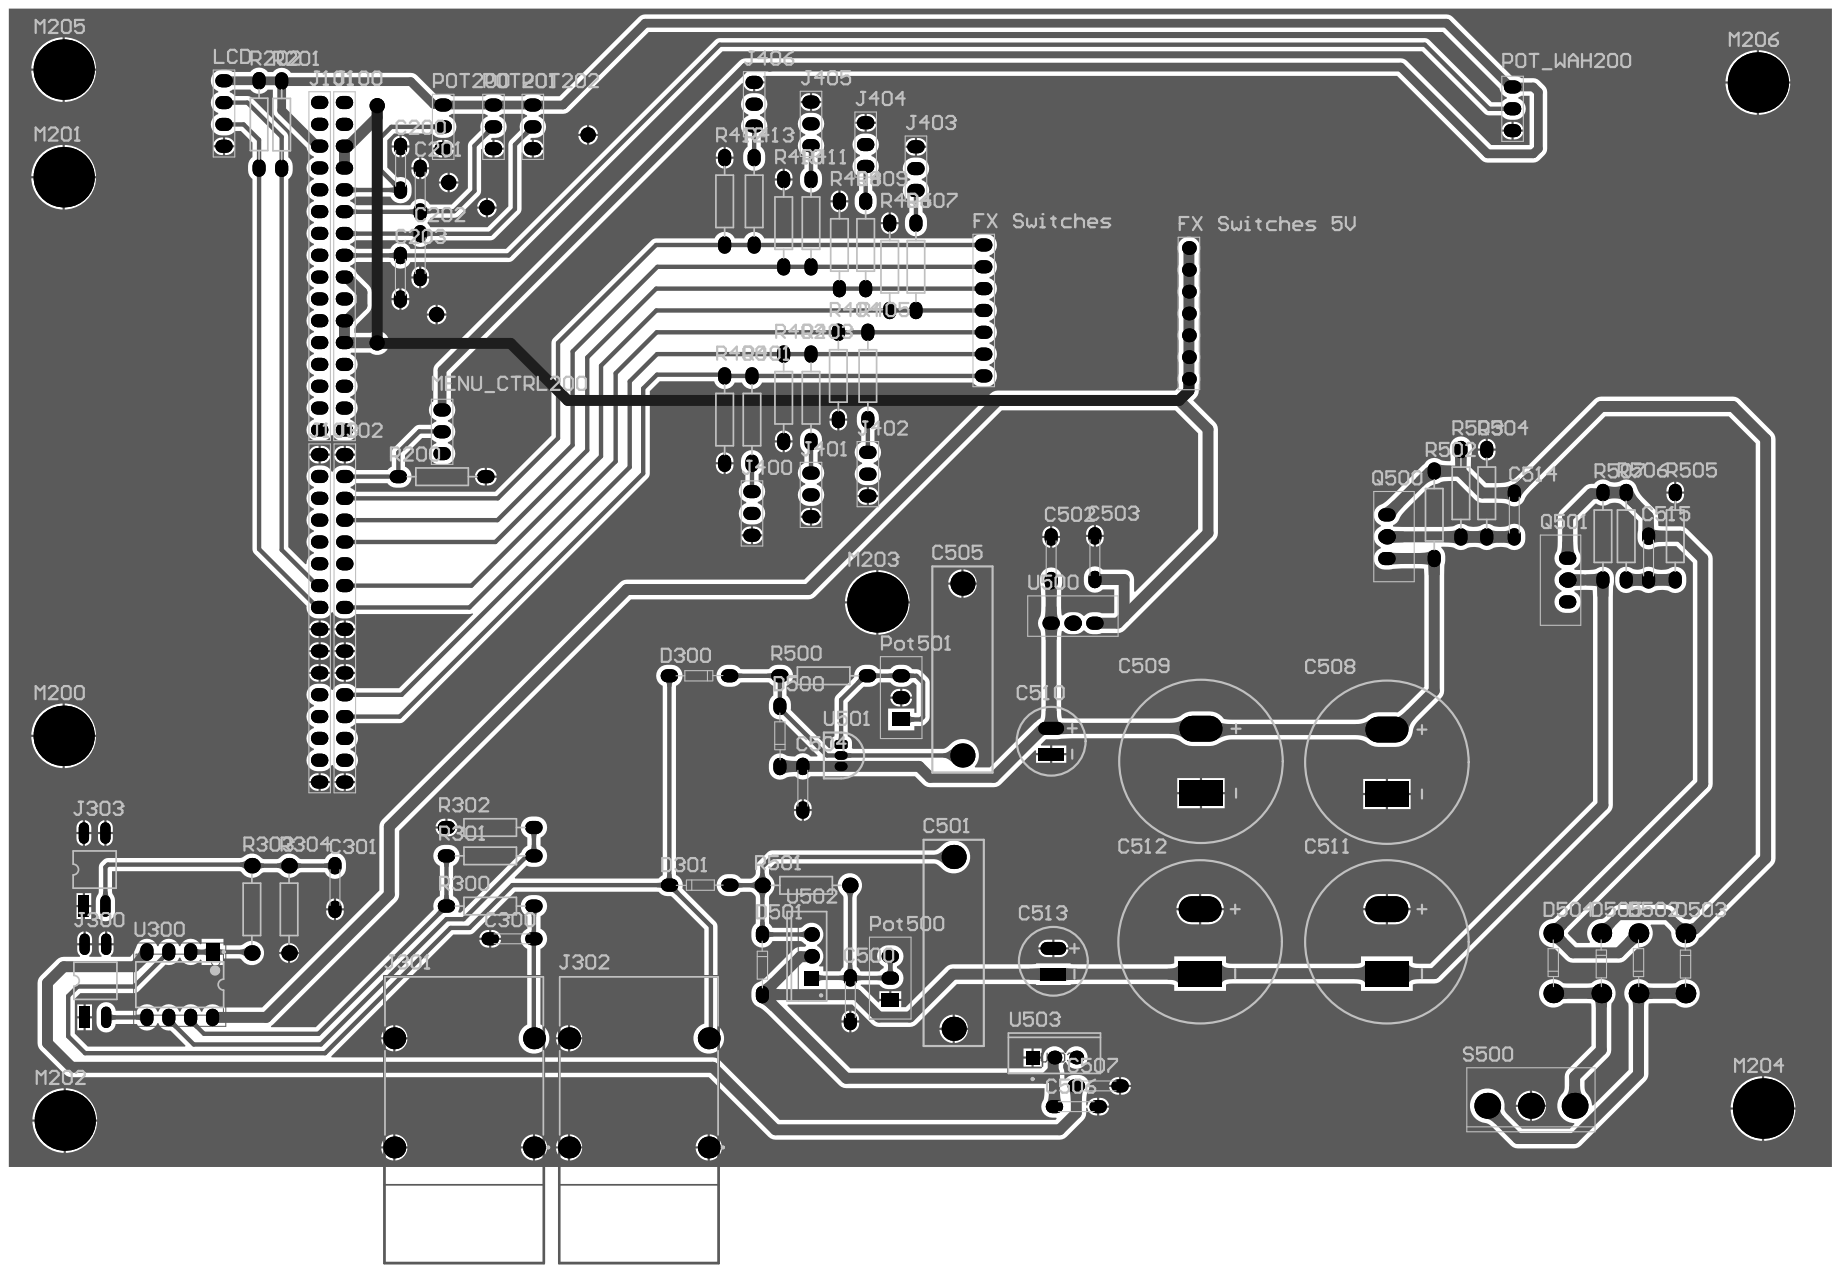
[picture p145: page 6]

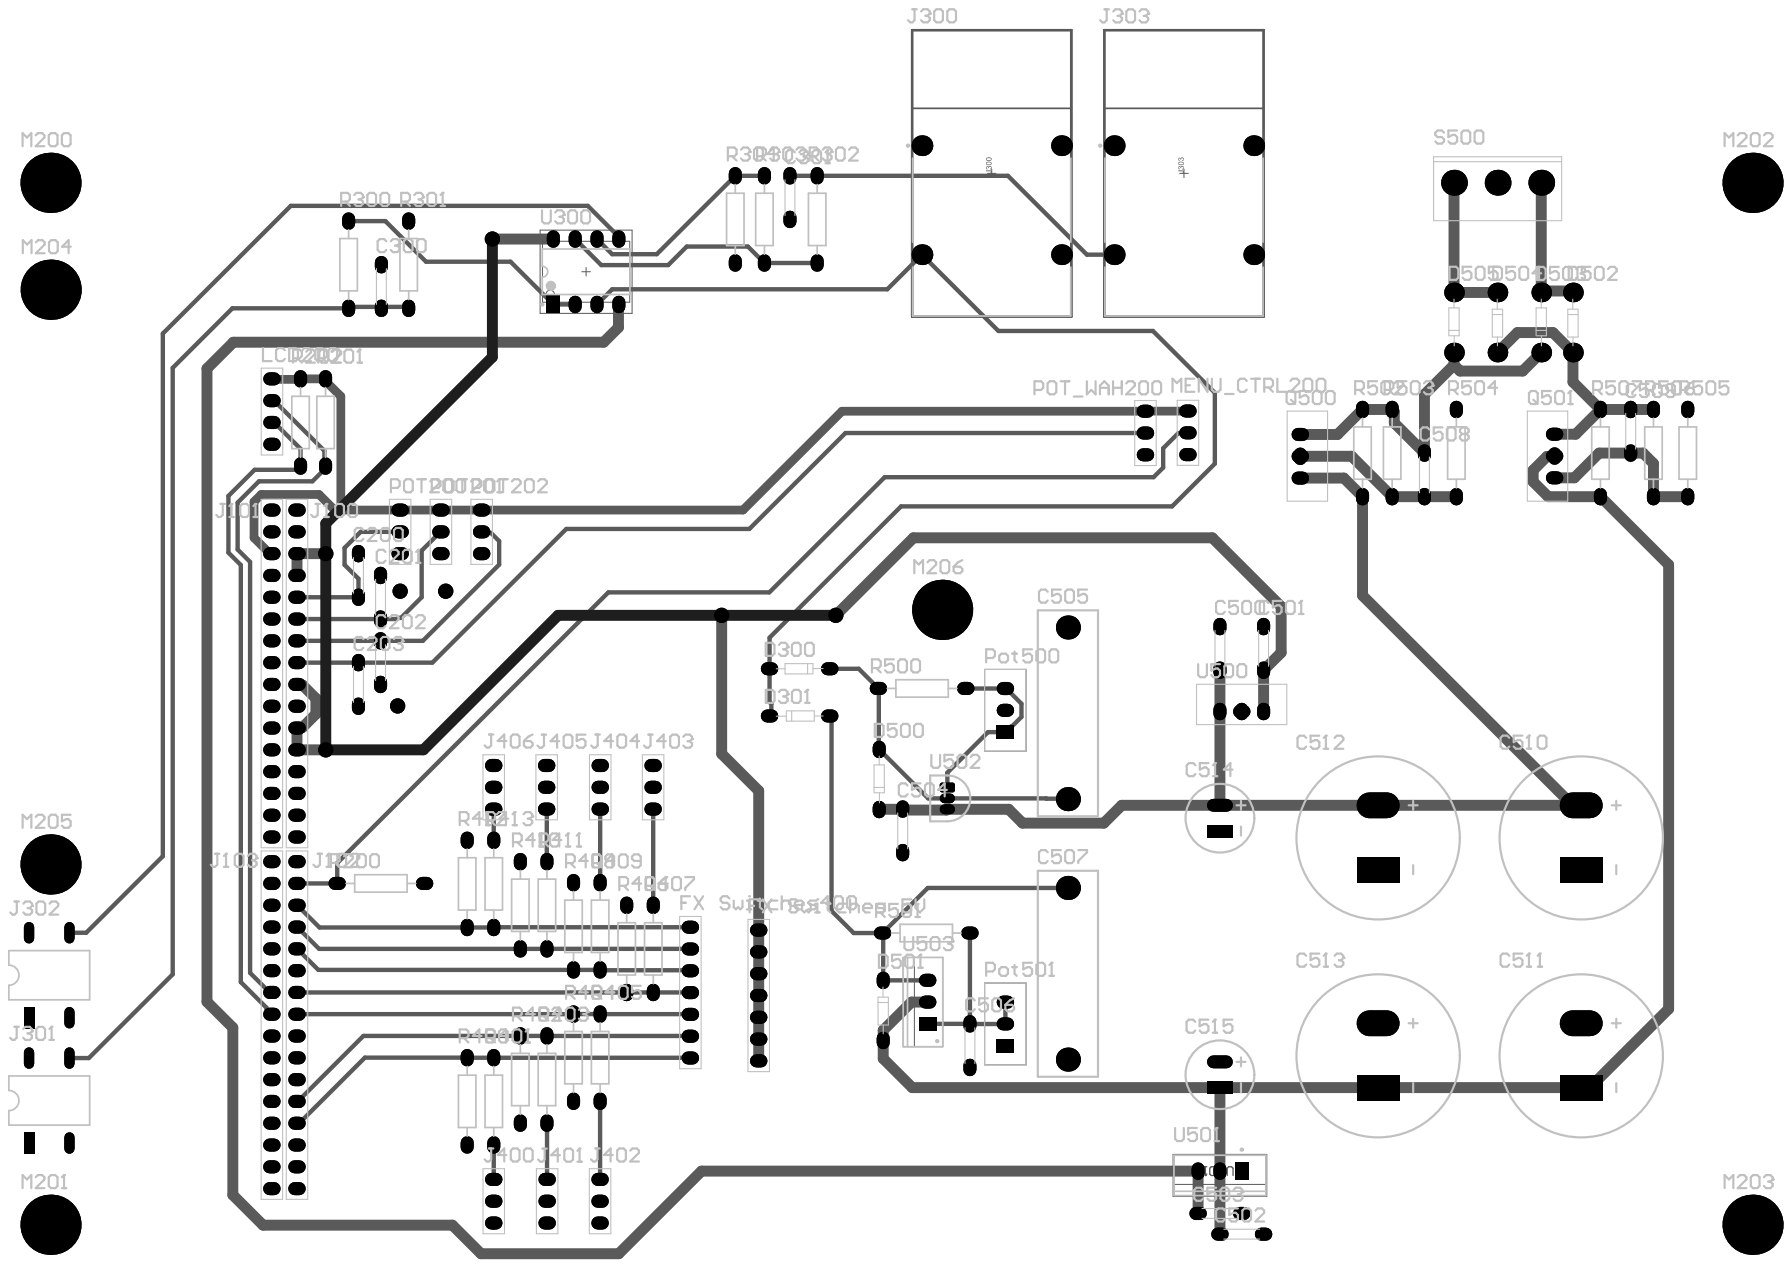
[picture p146: page 7]
