Niclasapdk/esd6_project/dsp_board/dsp_board.pdf

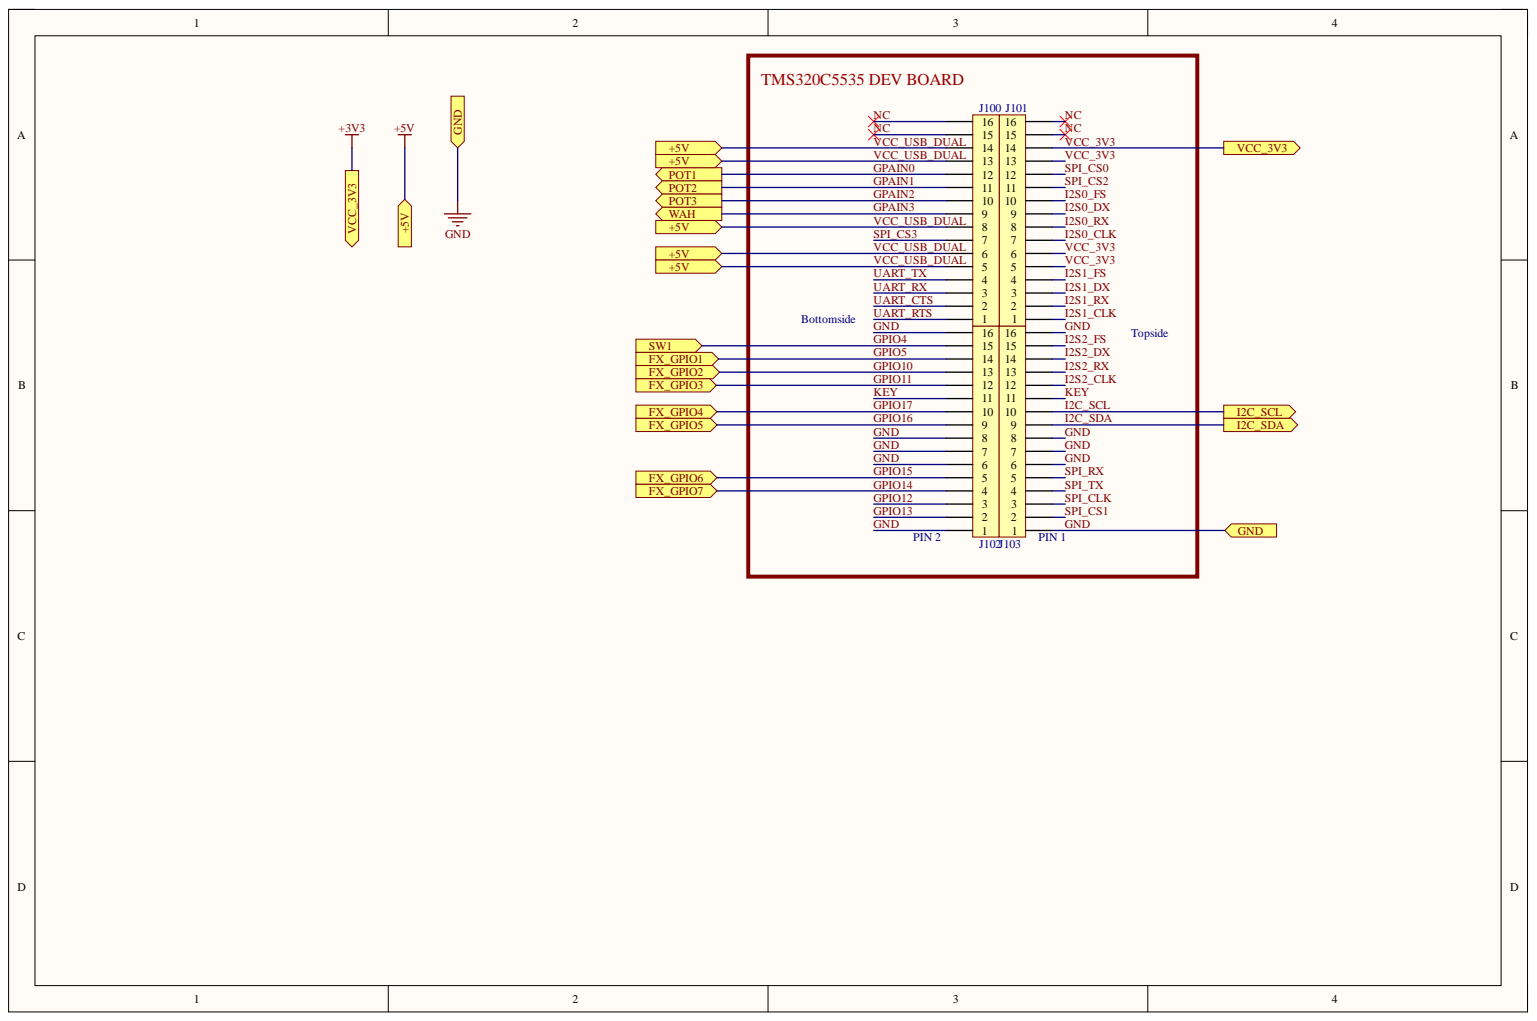
[picture p147: page 1]

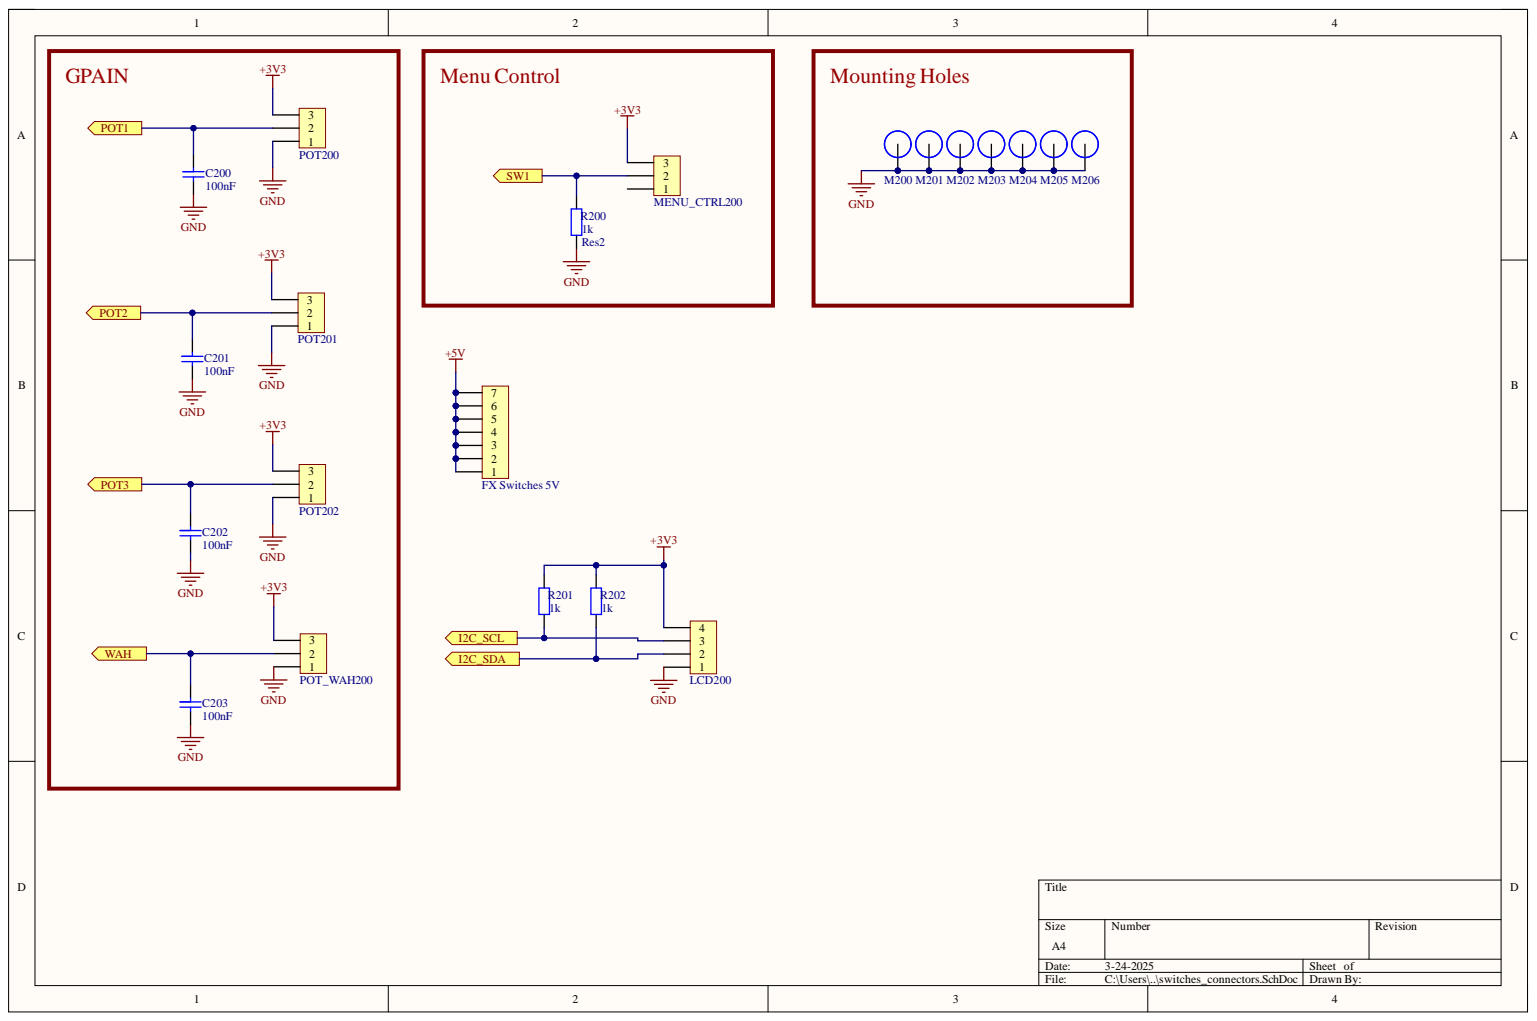
[picture p148: page 2]

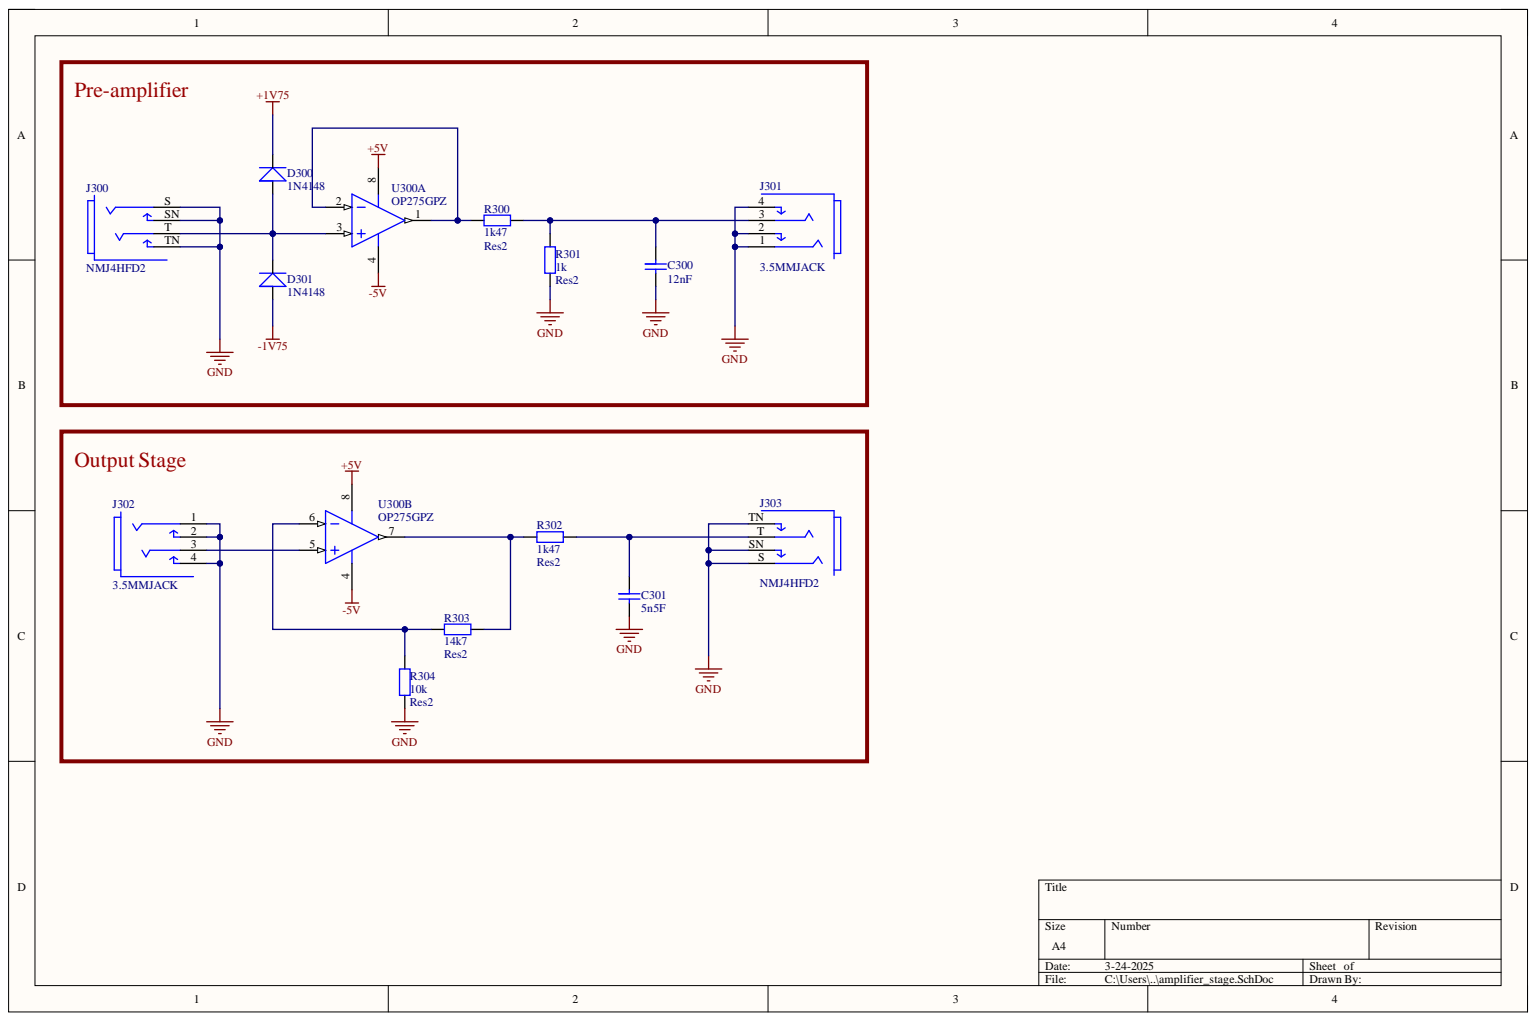
[picture p149: page 3]


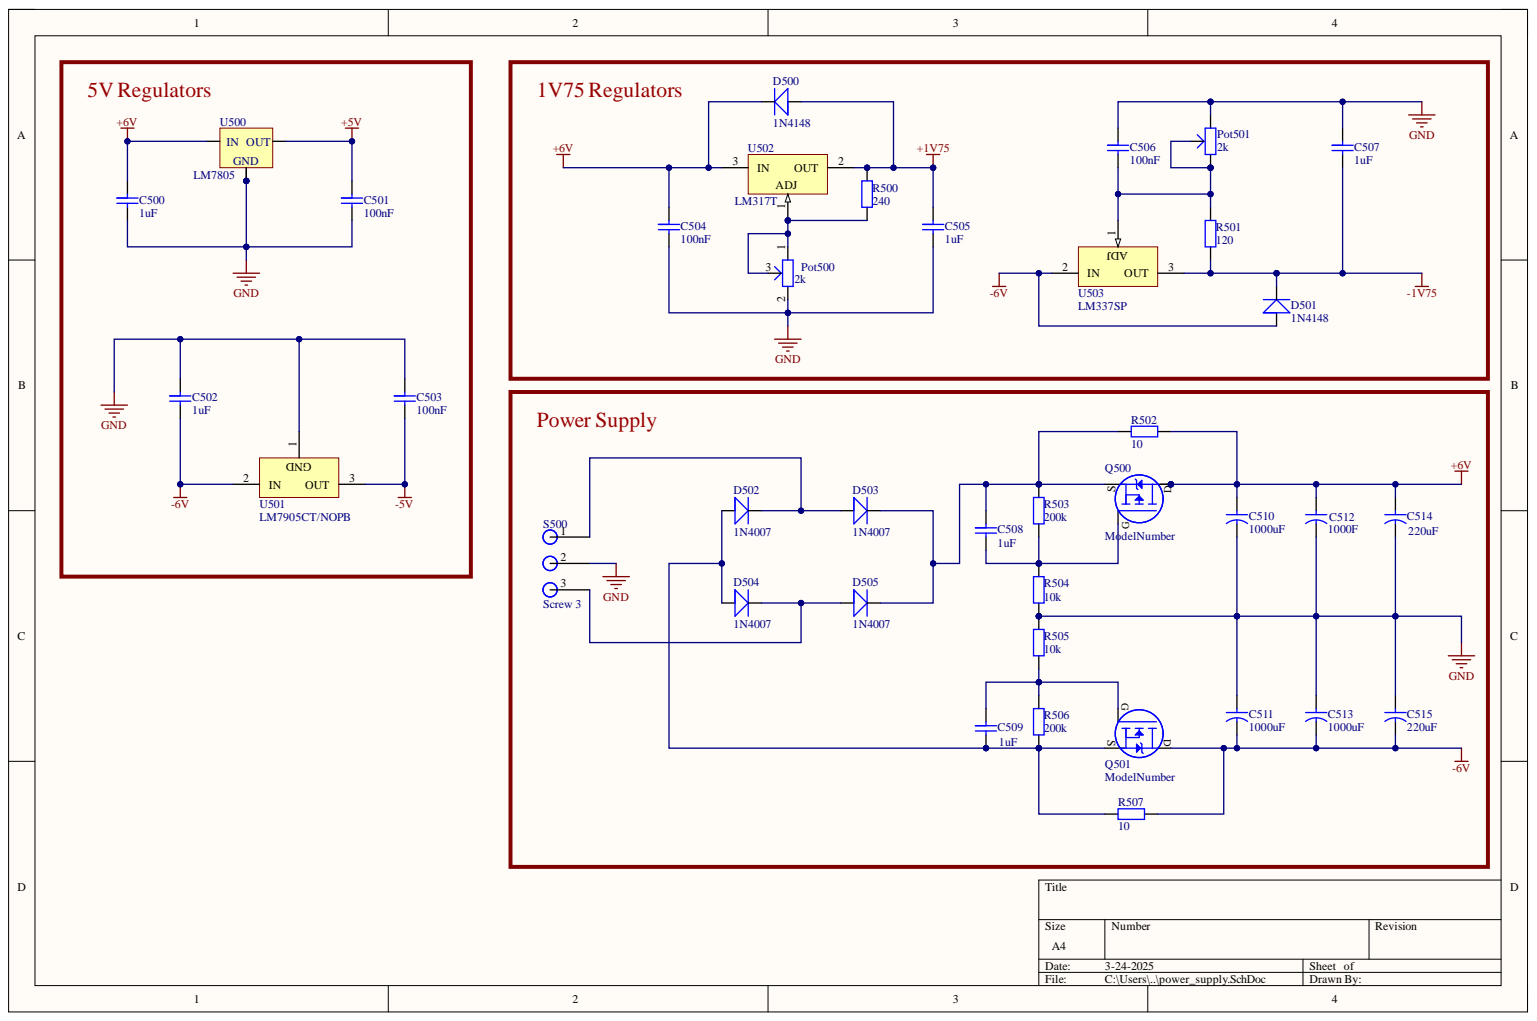
[picture p150: page 5]


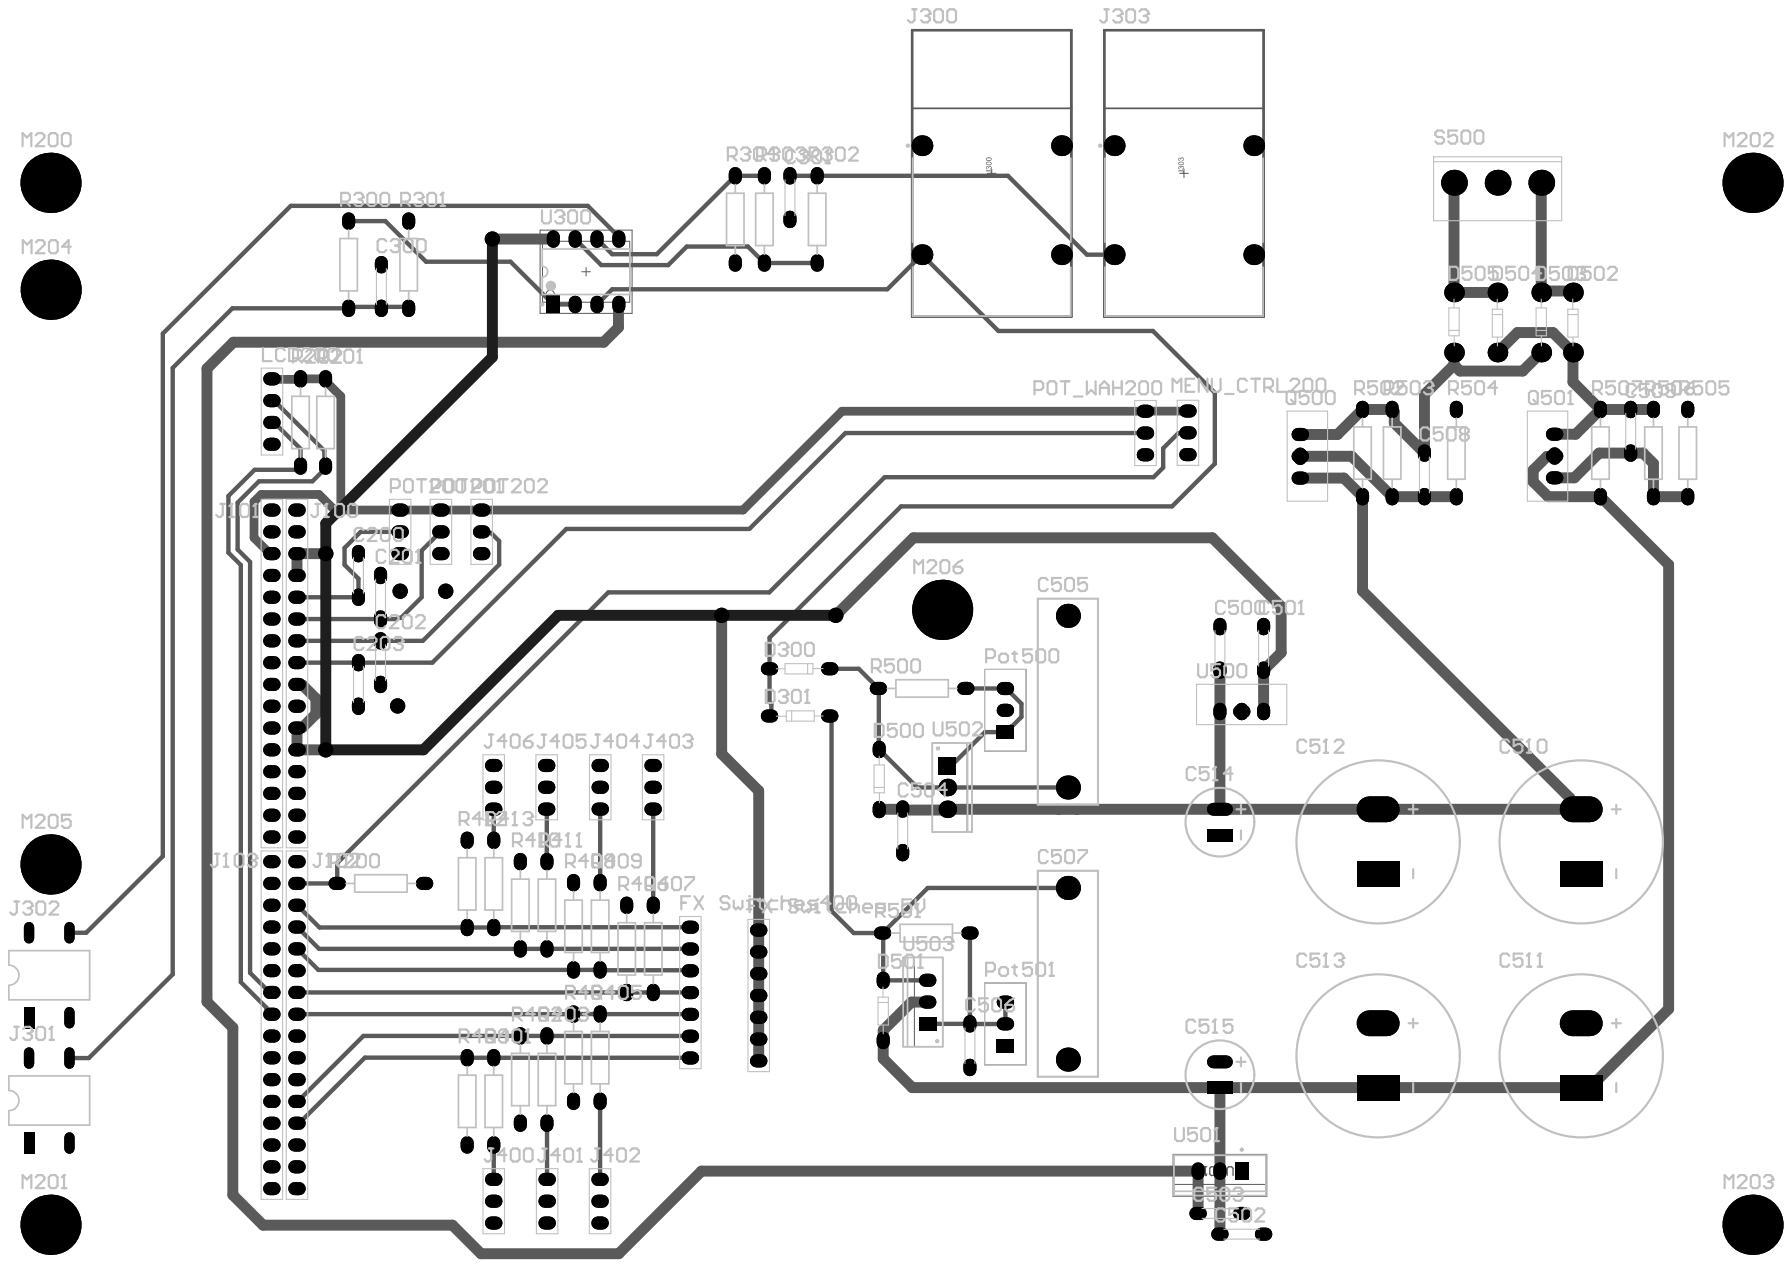
[picture p151: page 7]
