Niclasapdk/esd6_project/ltspice_sim/i2c_level_shift/i2c_level_shift.asc

M1: nmos
M2: nmos
R1: res; 4.7k
R2: res; 4.7k
R3: res; 4.7k
R4: res; 4.7k
V1: voltage; 5
V2: voltage; 3.3
Named nets: 0, 5+, +3.3, +5, 3V3_SCL, 3V3_SDA, 5V_SDA, 5V_SCL
