Niclasapdk/esd6_project/ltspice_sim/output_stage/Draft2.asc

C1: cap
C2: cap
D1: diode
D2: diode
D3: diode
D4: diode
V1: voltage
Named nets: 0
