Niclasapdk/esd6_project/ltspice_sim/powersupply/powersupply.asc

C1: cap; 1000µ
C2: cap; 1000µ
C3: cap; 1000µ
C4: cap; 1000µ
C5: cap; 220µ
C6: cap; 220µ
C7: cap; 1µ
C8: cap; 1µ
D1: diode
D2: diode
D3: diode
D4: diode
M1: pmos
M2: nmos
R1: res; 10
R2: res; 10
R3: res; 200k
R4: res; 10k
R5: res; 200k
R6: res; 10k
V1: voltage; SINE(0 17 50)
Named nets: 0
.tran 5s
