Niclasapdk/esd6_project/ltspice_sim/output_stage/output_stage.asc

C1: cap; 5.5n
R1: res; 14.7k
R2: res; 10k
R3: res; 1.47k
U1: UniversalOpAmp
V1: voltage; 5
V2: voltage; 5
V3: voltage; ""; AC 1
Named nets: -5V, +5V, 0, In, Out
.ac dec 100 10 100k
