Niclasapdk/esd6_project/ltspice_sim/pre_amplifier/Draft2.asc

C1: cap
R1: res
R2: res
R3: res
U1: UniversalOpAmp
Named nets: -5V, +5V, 0, In, Out
