Niclasapdk/esd6_project/ltspice_sim/pre_amplifier/pre_amplifier.asc

C1: cap; 12n
D1: diode
D2: diode
R1: res; 1.47k
R2: res; 1k
U1: UniversalOpAmp
V1: voltage; 5
V2: voltage; 5
V3: voltage; ""; AC 1
Named nets: +5V, -5V, 0, In, Out, +1.75V, -1.75V
.ac dec 100 10 100k
