Niclasapdk/esd6_project/ltspice_sim/tubescreamer/tube_screamer_sch.asc

C1: cap; 1µ
C2: cap; 0.22µ
C3: cap; 0.22µ
C4: cap; 51p
C5: cap; 0.047µ
C6: cap; 1µ
D1: diode; 1N4148
D2: diode; 1N4148
D3: diode; 1N4148
R1: res; 1k
R2: res; 1k
R3: res; 10k
R4: res; {Rtone + 1}
R5: res; {20k - Rtone + 1}
R6: res; 220
R7: res; 1k
R8: res; 51k
R9: res; {Rgain}
R10: res; 4.7k
R11: res; 10k
U5: UniversalOpAmp
U6: UniversalOpAmp
V1: voltage; 9
V2: voltage; 4.5
V3: voltage; wavefile = guitar.wav
Named nets: 0, 9V, 4.5V, vout, vin
.param Rgain=100k
.param Rtone=1k
.tran 5
;.step param Rtone list 1k 2k 5k 10k 12k 15k 20k
.param v_in = 0.5
;.step param v_in list 0.5 1 1.5 2
.wave meowmeow.wav 16 44.1k V(vout)
