Niclasapdk/esd6_project/(list of files, drawings)

Other design files:
dsp_board/amplifier_stage.SchDoc
dsp_board/dsp_board.PrjPcb
dsp_board/main.SchDoc
dsp_board/PCB2.PcbDoc
dsp_board/PCBV4.PcbDoc
dsp_board/power_supply.SchDoc
dsp_board/regulators.SchDoc
dsp_board/switches_connectors.SchDoc
dsp_board/switches_LEDs.SchDoc
pcb_library/PcbLib1.PcbLib
pcb_library/Schlib1.SchLib
