Niclasapdk/esd6_project/implementation/overdrive.h

#ifndef OVERDRIVE_H_
#define OVERDRIVE_H_

Int16 odChangeDrive(Int16 dir);
Int16 odChangeLevel(Int16 dir);
Int16 odChangeHpCutoff(Int16 dir);
Int16 odChangeLpCutoff(Int16 dir);
Int16 odChangeGateThres(Int16 dir);
Int16 odChangeGateRel(Int16 dir);
void odInit();
Int16 overdrive(Int16 x_in);

#endif /*OVERDRIVE_H_*/
