Niclasapdk/esd6_project/implementation/chorus.c

// Parameters (Q15 arithmetic)
// maxDelay: maximum delay in samples (15 ms)
// Mix: wet mix (Q15)
// invMix: dry mix (Q15)
// Delay: delay modulation depth (Q15)
// Rate: LFO rate in mHz
#include <stdio.h>
#include "chorus.h"
extern long EPM(long *, long *);

#define LFO_NORMALIZATION 23170 // [-1,1] normalize output
#define MAP_BY_TWO_PI_FS 1530 //2*pi*mapfactor/fs,fs=4410, mapfactor=0.1*2^15/100
#define THREE_FRAC_TWO 1610612736 // 1.5 Q2.30
#define CHORUS_DELAYLINE_LEN 1104 // Max Delay = 882, plus width = 221

static long oneMinusKpow2Frac2 = 2147474928;
static long k = 6120000; // Q1.31

static Int16 Mix = 6554;       // Wet mix in Q15
static Int16 invMix = 26213;    // Dry mix in Q15 (1 - wet mix)
static Int16 Delay = 882; 		// Base delay, 20 ms
static Int16 Width = 221;  		// Modulation delay width , 5ms in both dir

void chorusFRate(Int16 r);

// State variables
static Int16 cDelayLine[CHORUS_DELAYLINE_LEN] = {0};      // Delay buffer

Int16 chorusChangeDelay(Int16 dir) {
    const Int16 step = 44;				// Step size 1 ms
    Delay += dir*step;
    if (Delay > 882) Delay = 882;	    // 20 ms in samples
    else if (Delay < 661) Delay = 661;  // 15 ms in samples
    return Delay;
}

Int16 chorusChangeRate(Int16 dir) {
    static Int16 rate = 2000;
    const Int16 step = 100;
    rate += dir*step;
    // saturate
    if (rate > 5000) rate = 5000;
    else if (rate < 100) rate = 100;
    chorusFRate(rate);
    return rate;
}

Int16 chorusChangeMix(Int16 dir) {
    const Int16 step = 1638; // 5% step size
    Mix += dir*step;
    // saturate (order matters)
    if (Mix < -20000) Mix = 32767; // for overflow
    else if (Mix < 0) Mix = 0;
    invMix = 32767 - Mix;
    return Mix;
}

void chorusFRate(Int16 r) {
    k = ((long)MAP_BY_TWO_PI_FS * r) << 1; //Q1.31
    oneMinusKpow2Frac2 = (EPM(&k, &k) >> 1); //k^2/2
    oneMinusKpow2Frac2 = (2147483648 - oneMinusKpow2Frac2); //Q1.31
}

void chorusLFO(int *out) {
    static long delaylineLFO[2] = {1518270939,0}; //Q1.31 format for 0.707 and 0
    long agc = 1073741824; // 1 for start gain
    int outtmp[2];
    long y1 = (EPM(&oneMinusKpow2Frac2, &delaylineLFO[0]) + EPM(&k, &delaylineLFO[1]));
    long y2 = (EPM(&oneMinusKpow2Frac2, &delaylineLFO[1]) - EPM(&k, &delaylineLFO[0]));
    long power = (EPM(&y1, &y1) + EPM(&y2, &y2)) >> 1; //Q2.30, so its possible to fit 1.5 in the
    agc = (THREE_FRAC_TWO - power); // Q1.31
    y1 = EPM(&y1, &agc) << 1;
    y2 = EPM(&y2, &agc) << 1;
    /*next iteration*/
    delaylineLFO[0] = y1;
    delaylineLFO[1] = y2;
    /*Output change to match -1 and 1*/
    outtmp[0] = _rnd(y1) >> 16;      // sin
    outtmp[1] = _rnd(y2) >> 16;     // cos
    out[0] = ((long)outtmp[0] * LFO_NORMALIZATION) >> 14;
    out[1] = ((long)outtmp[1] * LFO_NORMALIZATION) >> 14;
}

Int16 chorus(Int16 xn) {
    Int16 yn, i, wet;
    static int delayIndex = 0;
    static int LFOIndex = 100;
    int delaySize[4] = {0};
    int delayBack[4] = {0};
    static int LFOVal[4];
    // Update LFO value occasionally (as in your original code)
    if (LFOIndex >= 9) {
        chorusLFO(LFOVal);
        LFOVal[2]=-LFOVal[0];
        LFOVal[3]=-LFOVal[1];
        LFOIndex = 0;
    } else {
        LFOIndex++;
    }
    for (i = 0; i <= 3; i++) {
        // Calculate the current delay size (modulated by the LFO)
        delaySize[i] = Delay + (((Int32)Width * LFOVal[i]) >> 15);
        delayBack[i] = delayIndex - delaySize[i];
        if (delayBack[i] < 0) {
            delayBack[i] += CHORUS_DELAYLINE_LEN;
        }

    }
    // Calculate wet fx as sum of delay lines * (1/4)
    // >>2 instead of *(1/4)
    wet = ((long)cDelayLine[delayBack[0]] +
           (long)cDelayLine[delayBack[1]] +
           (long)cDelayLine[delayBack[2]] +
           (long)cDelayLine[delayBack[3]]) >> 2;
    yn = (((long)invMix * xn) + ((long)Mix * wet)) >> 15;

    // update delayline
    cDelayLine[delayIndex] = xn;

    // Update the delay line pointer
    delayIndex++;
    if (delayIndex >= CHORUS_DELAYLINE_LEN) {
        delayIndex = 0;
    }

    return yn;
}

void chorusInit() {
    Int i;
    for (i=0; i<CHORUS_DELAYLINE_LEN; i++) cDelayLine[i] = 0;
}
