Niclasapdk/esd6_project/implementation/codec.c

#include "codec.h"
#include "wait.h"
#include <ezdsp5535.h>
#include <ezdsp5535_i2c.h>

#define AIC3204_I2C_ADDR 0x18

/*
 *
 *  AIC3204_rget( regnum, *regval )
 *
 *      Return value of codec register regnum
 *
 */
Int16 AIC3204_rget(  Uint16 regnum, Uint16* regval )
{
    Int16  retcode = 0;
    Uint16 cmd[2];

    cmd[0] = regnum & 0x007F;       // 7-bit Device Register
    cmd[1] = 0;

    retcode |= EZDSP5535_I2C_write( AIC3204_I2C_ADDR, cmd, 1 );
    retcode |= EZDSP5535_I2C_read( AIC3204_I2C_ADDR, cmd, 1 );

    *regval = cmd[0];
    wait_usec( 10 );
    return retcode;
}

/*
 *
 *  AIC3204_rset( regnum, regval )
 *
 *      Set codec register regnum to value regval
 *
 */
Int16 AIC3204_rset( Uint16 regnum, Uint16 regval )
{
    Uint16 cmd[2];
    cmd[0] = regnum & 0x007F;       // 7-bit Device Register
    cmd[1] = regval;                // 8-bit Register Data

    wait_usec( 300 );

    return EZDSP5535_I2C_write( AIC3204_I2C_ADDR, cmd, 2 );
}

void initCODEC() {
    /* Configure AIC3204 */
    AIC3204_rset( 0,  0x00 );  // Select page 0
    AIC3204_rset( 1,  0x01 );  // Reset codec
    wait_usec(1000);  // Wait 1ms after reset
    AIC3204_rset( 0,  0x01 );  // Select page 1
    AIC3204_rset( 1,  0x08 );  // Disable crude AVDD generation from DVDD
    AIC3204_rset( 2,  0x01 );  // Enable Analog Blocks, use LDO power
    AIC3204_rset( 10, 0x40 );  // Set common mode to 0.75 (0.707 max peak)
    AIC3204_rset( 123,0x05 );  // Force reference to power up in 40ms
    wait_usec(50000); // Wait at least 40ms
    AIC3204_rset( 0,  0x00 );  // Select page 0

    /* PLL and Clocks config and Power Up  */
    AIC3204_rset( 27, 0x0d );  // BCLK and WCLK are set as o/p; AIC3204(Master)
    AIC3204_rset( 28, 0x00 );  // Data ofset = 0
    AIC3204_rset( 4,  0x03 );  // PLL setting: PLLCLK <- MCLK, CODEC_CLKIN <-PLL CLK
    AIC3204_rset( 6,  0x07 );  // PLL setting: J=7
    AIC3204_rset( 7,  0x02 );  // PLL setting: HI_BYTE(D=560)
    AIC3204_rset( 8,  0x30 );  // PLL setting: LO_BYTE(D=560)
    AIC3204_rset( 30, 0x88 );  // For 32 bit clocks per frame in Master mode ONLY
    // BCLK=DAC_CLK/N =(12288000/8) = 1.536MHz = 32*fs
    AIC3204_rset( 5,  0x91 );  // PLL setting: Power up PLL, P=1 and R=1
    wait_usec(10000); // Wait for PLL to come up
    AIC3204_rset( 13, 0x00 );  // Hi_Byte(DOSR) for DOSR = 128 decimal or 0x0080 DAC oversamppling
    AIC3204_rset( 14, 0x80 );  // Lo_Byte(DOSR) for DOSR = 128 decimal or 0x0080
    AIC3204_rset( 20, 0x80 );  // AOSR for AOSR = 128 decimal or 0x0080 for decimation filters 1 to 6
    AIC3204_rset( 11, 0x83 );  // Power up NDAC and set NDAC value to 3
    AIC3204_rset( 12, 0x85 );  // Power up MDAC and set MDAC value to 5
    AIC3204_rset( 18, 0x85 );  // Power up NADC and set NADC value to 5
    AIC3204_rset( 19, 0x83 );  // Power up MADC and set MADC value to 3

    /* DAC ROUTING and Power Up */
    AIC3204_rset( 0,  0x01 );  // Select page 1
    AIC3204_rset( 12, 0x08 );  // LDAC AFIR routed to HPL
    AIC3204_rset( 13, 0x08 );  // RDAC AFIR routed to HPR
    AIC3204_rset( 0,  0x00 );  // Select page 0
    AIC3204_rset( 64, 0x02 );  // Left vol=right vol
    AIC3204_rset( 65, 0x00 );  // Left DAC gain to 0dB VOL; Right tracks Left
    AIC3204_rset( 63, 0xd4 );  // Power up left,right data paths and set channel
    AIC3204_rset( 0,  0x01 );  // Select page 1
    AIC3204_rset( 16, 0x00 );  // Unmute HPL , 0dB gain
    AIC3204_rset( 17, 0x00 );  // Unmute HPR , 0dB gain
    AIC3204_rset( 9, 0x30 );   // Power up HPL,HPR
    wait_usec(100 );  // Wait

    /* ADC ROUTING and Power Up */
    AIC3204_rset( 0,  0x01 );  // Select page 1
    AIC3204_rset( 52, 0x30 );  // IN2_L to LADC_P through 40 kohm
    AIC3204_rset( 55, 0x30 );  // IN2_R to LADC_P through 40 kohm
    AIC3204_rset( 54, 0x03 );  // CM_1 (common mode) to LADC_M through 40 kohm
    AIC3204_rset( 57, 0xc0 );  // CM_1 (common mode) to RADC_M through 40 kohm
    // TODO create input gain adjustment mode to
    // set input gain for example when switching guitars
    AIC3204_rset( 59, 0x14 );  // MIC_PGA_L unmute and MicPGA left gain to 0.5*val
    AIC3204_rset( 60, 0x14 );  // MIC_PGA_R unmute and MicPGA right gain to 0.5*val
    AIC3204_rset( 0,  0x00 );  // Select page 0
    AIC3204_rset( 81, 0xc0 );  // Powerup Left and Right ADC
    AIC3204_rset( 82, 0x00 );  // Unmute Left and Right ADC
    AIC3204_rset( 0,  0x00 );  // Select page 0
    wait_usec(10000);  // Wait
}
