Niclasapdk/esd6_project/implementation/adc.c

#include <ezdsp5535.h>
#include "adc.h"
#include "wait.h"

ioport int *SARCTRL    = (ioport int *)0x7012; // SAR A/D Control Register Section 3.1
ioport int *SARDATA    = (ioport int *)0x7014; // SAR A/D Data Register Section 3.2
ioport int *SARCLKCTRL = (ioport int *)0x7016; // SAR A/D Clock Control Register Section 3.3
ioport int *SARPINCTRL = (ioport int *)0x7018; // SAR A/D Reference and Pin Control Register Section 3.4
ioport int *SARGPOCTRL = (ioport int *)0x701A; // SAR A/D GPO Control Register Section 3.5

void initAdc() {
    *SARGPOCTRL = 0xffff; // set all as output to try to fix this shit adc
    *SARGPOCTRL = 0;      // all analog inputs as analog inputs (not gpio)
    *SARPINCTRL = 0x061b; // set all weird values to reset them later to fix this shit adc
    wait_usec(1000); // wait 1 ms??
    *SARPINCTRL = 0x3601; // (PWRUPBIAS|SARPWRUP|FUCK)
    *SARCLKCTRL = 64;     // clock division (+1)
}

// Performs a blocking adc conversion
// ch: channel and must be from 0 to 3
Int16 readAdcBlocking(Uint16 ch) {
    Int16 result;
    // Setup SARCTRL register with channel, single conversion mode and start conversion
    // set ADCSTRT to start conversion
    *SARCTRL = 0x8000|(ch<<12)|(0x0400);
    // wait until ADCBUSY is set
    while (!((*SARDATA)& 0x8000));
    // wait until ADCBUSY is cleared and channel matches requested channel
    while (result = (*SARDATA), (result & 0x8000) || ((result>>12)&0x7)!=ch);
    return result & 0x03ff; // return 10-bit result
}

// Starts ADC conversion on channel 3
void adcStartConv() {
    *SARCTRL = 0xb400; // Channel 3, single conversion mode, start conversion
}

// Read ADC data
// will not wait so returns -1 if data not ready
Int16 adcReadDataNowait() {
    Int16 result;
    result = *SARDATA;
    *SARCTRL = 0x3400; // clear ADCSTRT flag to get ready for next conversion
    if ((result&0xf000)==0x3000) {
        // ADCBUSY flag is low and channel bitfield is 3
        return result&0x03ff; // return 10-bit result
    } else {
        return -1;
    }
}
