Niclasapdk/esd6_project/implementation/chorus.h

#ifndef CHORUS_H_
#define CHORUS_H_

#include <stdio.h>
#include <ezdsp5535.h>

void chorusInit();
Int16 chorusChangeDelay(Int16 dir);
Int16 chorusChangeRate(Int16 dir);
Int16 chorusChangeMix(Int16 dir);
Int16 chorus(Int16 x);

#endif /*CHORUS_H_*/
