Niclasapdk/esd6_project/implementation/wah.c

#include "wah.h"
#include "adc.h"

Int16 F1 = 4665; // Q15, Fc = 1000
const Int16 Q1 = 2*1720; // Q15 (0.0525) * 2, meaning damp *2 = Q1

void setWahPedal(Int16 adcVal) {
	const Int16 sin_coeff = 5; // 2*sin(pi/fs) = 0.00014247585718515246 (approx 5 in Q15)
	// fmin + adcVal * fdiff / 1024
	// range = 350 - 2250 Hz, from 4665/1000 * Hz
	// sin_coeff is rounded to 5 (from 4.669) which means
	// error in Fc calculation, factor = 4.669/5 = 0.9337
	// thus, Fc is calculated in range factor*350 to factor*2250
	// meaning 326 to 2100 Hz
	Int16 Fc = 326 + (((Int32)adcVal*(2100-326))>>10); // Q15.0
	// numberrep Q0.15 * Q15.0 = Q15.15
	// actual sizes 12 bit * 3 bit so no need for double precision accumulator
	F1 = sin_coeff*Fc;
}
Int16 wah(Int16 x) {
	static Int16 yaux = 0, yl = 0, y = 0, yh = 0; // Q15
	static Uint16 adcCtr = 0;
	Int16 adcVal;
	if (adcCtr&1) { // read adc data
		adcVal = adcReadDataNowait();
		if (adcVal >= 0) {
			// adc data valid, set pedal and increment counter
			setWahPedal(adcVal);
			adcCtr++;
		}
	} else { // start adc conversion
		adcStartConv();
		adcCtr++;
	}
	x >>= 1; // input gain -6dB
	yh = x - yl - (((Int32)Q1*yaux)>>15); // Q15
	y = (((Int32)F1 * yh)>>15) + yaux;
	yl = (((Int32)F1*y)>>15) + yl;
	yaux = y;
	return y;	
}
