Niclasapdk/esd6_project/implementation/od_LUT.h

#define OD_HP_LUT_LEN (10)
static const Int16 hp_fc_list[] = {100, 200, 300, 400, 500, 1000, 1500, 2000, 2500, 3000};
static const Int16 hp_b_table[][3] = {
    {16220, -32440, 16220},
    {16057, -32114, 16057},
    {15896, -31792, 15896},
    {15737, -31474, 15737},
    {15579, -31158, 15579},
    {14814, -29627, 14814},
    {14085, -28171, 14085},
    {13392, -26783, 13392},
    {12731, -25462, 12731},
    {12100, -24200, 12100},
};
static const Int16 hp_a_table[][3] = {
    {16384, -32438, 16057},
    {16384, -32108, 15737},
    {16384, -31778, 15423},
    {16384, -31448, 15115},
    {16384, -31119, 14814},
    {16384, -29476, 13394},
    {16384, -27846, 12111},
    {16384, -26232, 10951},
    {16384, -24637, 9902},
    {16384, -23061, 8956},
};

#define OD_LP_LUT_LEN (7)
static const Int16 lp_fc_list[] = {4000, 5000, 6000, 7000, 8000, 9000, 10000};
static const Int16 lp_b_table[][3] = {
    {937, 1874, 937},
    {1362, 2725, 1362},
    {1836, 3672, 1836},
    {2351, 4702, 2351},
    {2904, 5808, 2904},
    {3493, 6986, 3493},
    {4119, 8237, 4119},
};
static const Int16 lp_a_table[][3] = {
    {16384, -19970, 7335},
    {16384, -16960, 6026},
    {16384, -14025, 4984},
    {16384, -11153, 4173},
    {16384, -8335, 3567},
    {16384, -5557, 3145},
    {16384, -2806, 2896},
};
