Niclasapdk/esd6_project/implementation/.backup_oldfiles/ccs_workspace/chorus_project/chorus.h

#ifndef CHORUS_H_
#define CHORUS_H_

#include <stdio.h>
#include <ezdsp5535.h>

void setRateChorus(Int16 adcVal);
void setDepthChorus(Int16 adcVal2);
void setDelayChorus(Int16 adcVal3);
//Int16 chorus(Int16 x);

#endif /*CHORUS_H_*/
