Niclasapdk/esd6_project/badWahbah/EfectoWahWah_pkg/rt_nonfinite.h

/*
 * Academic License - for use in teaching, academic research, and meeting
 * course requirements at degree granting institutions only.  Not for
 * government, commercial, or other organizational use.
 *
 * rt_nonfinite.h
 *
 * Code generation for function 'EfectoWahWah'
 *
 */

#ifndef RT_NONFINITE_H
#define RT_NONFINITE_H

/* Include files */
#include "rtwtypes.h"

#ifdef __cplusplus
extern "C" {
#endif

/*Constant Variables
* holds values for 
* infinite,  minus infnite, not a number
* used for checking the boolean_T
*/
extern real_T rtInf;
extern real_T rtMinusInf;
extern real_T rtNaN;
extern real32_T rtInfF;
extern real32_T rtMinusInfF;
extern real32_T rtNaNF;

/*Function declaration, further explained in rt_nonfinite.c*/
extern boolean_T rtIsInf(real_T value);
extern boolean_T rtIsInfF(real32_T value);
extern boolean_T rtIsNaN(real_T value);
extern boolean_T rtIsNaNF(real32_T value);

#ifdef __cplusplus
}
#endif
#endif
/* End of code generation (rt_nonfinite.h) */
