Niclasapdk/esd6_project/badWahbah/EfectoWahWah_pkg/EfectoWahWah_data.h

/*
 * Academic License - for use in teaching, academic research, and meeting
 * course requirements at degree granting institutions only.  Not for
 * government, commercial, or other organizational use.
 *
 * EfectoWahWah_data.h
 *
 * Code generation for function 'EfectoWahWah_data'
 *
 */

#ifndef EFECTOWAHWAH_DATA_H
#define EFECTOWAHWAH_DATA_H

/* Include files */
#include "rtwtypes.h"
#include <stddef.h>
#include <stdlib.h>

#endif
/* End of code generation (EfectoWahWah_data.h) */
