Niclasapdk/esd6_project/badWahbah/EfectoWahWah_pkg/rtGetInf.c

/*
 * Academic License - for use in teaching, academic research, and meeting
 * course requirements at degree granting institutions only.  Not for
 * government, commercial, or other organizational use.
 *
 * rtGetInf.c
 *
 * Code generation for function 'EfectoWahWah'
 *
 */

/*
 * Abstract:
 *       MATLAB for code generation function to initialize non-finite, Inf and
 * MinusInf
 */
/* Include files */
#include "rtGetInf.h"
#include "rt_nonfinite.h"

/*
 * Function: rtGetInf
 * ================================================================== Abstract:
 *  Initialize rtInf needed by the generated code.
 */
real_T rtGetInf(void)
{
  return rtInf;
}

/*
 * Function: rtGetInfF
 * ================================================================= Abstract:
 *  Initialize rtInfF needed by the generated code.
 */
real32_T rtGetInfF(void)
{
  return rtInfF;
}

/*
 * Function: rtGetMinusInf
 * ============================================================= Abstract:
 *  Initialize rtMinusInf needed by the generated code.
 */
real_T rtGetMinusInf(void)
{
  return rtMinusInf;
}

/*
 * Function: rtGetMinusInfF
 * ============================================================ Abstract:
 *  Initialize rtMinusInfF needed by the generated code.
 */
real32_T rtGetMinusInfF(void)
{
  return rtMinusInfF;
}

/* End of code generation (rtGetInf.c) */
