Niclasapdk/esd6_project/badWahbah/EfectoWahWah_pkg/rtGetInf.h

/*
 * Academic License - for use in teaching, academic research, and meeting
 * course requirements at degree granting institutions only.  Not for
 * government, commercial, or other organizational use.
 *
 * rtGetInf.h
 *
 * Code generation for function 'EfectoWahWah'
 *
 */

#ifndef RTGETINF_H
#define RTGETINF_H

/* Include files */
#include "rtwtypes.h"

#ifdef __cplusplus
extern "C" {
#endif

extern real_T rtGetInf(void);
extern real32_T rtGetInfF(void);
extern real_T rtGetMinusInf(void);
extern real32_T rtGetMinusInfF(void);

#ifdef __cplusplus
}
#endif
#endif
/* End of code generation (rtGetInf.h) */
