Niclasapdk/esd6_project/badWahbah/EfectoWahWah_pkg/rtGetNaN.c

/*
 * Academic License - for use in teaching, academic research, and meeting
 * course requirements at degree granting institutions only.  Not for
 * government, commercial, or other organizational use.
 *
 * rtGetNaN.c
 *
 * Code generation for function 'EfectoWahWah'
 *
 */

/*
 * Abstract:
 *       MATLAB for code generation function to initialize non-finite, NaN
 */
/* Include files */
#include "rtGetNaN.h"
#include "rt_nonfinite.h"

/*
 * Function: rtGetNaN
 * ======================================================================
 *  Abstract:
 * Initialize rtNaN needed by the generated code.
 *  NaN is initialized as non-signaling. Assumes IEEE.
 */
real_T rtGetNaN(void)
{
  return rtNaN;
}

/*
 * Function: rtGetNaNF
 * =====================================================================
 *  Abstract:
 *  Initialize rtNaNF needed by the generated code.
 *  NaN is initialized as non-signaling. Assumes IEEE
 */
real32_T rtGetNaNF(void)
{
  return rtNaNF;
}

/* End of code generation (rtGetNaN.c) */
