Niclasapdk/esd6_project/(commit log)

2025-02-06 comb filters
2025-02-11 add guitar measurements and plots
    [bridge_hard.csv, bridge_normal.csv, middle_hard.csv, middle_normal.csv, neck_hard.csv, neck_normal.csv]
2025-02-12 add impedance test data and figure
    [impedance_bridge_10.csv, impedance_bridge_5.csv, impedance_middle_10.csv, impedance_neck_10.csv, impedance_neck_5.csv]
2025-02-20 universal comb filter
2025-02-20 universal comb filter png
2025-02-21 spice files for tubescreamer
2025-02-21 new universal comb filter
2025-02-25 first ts808 tube screamer wdf prototype
2025-02-27 add stage 2 and benchmark timing
2025-02-27 add part3 of circuit
2025-02-28 finish building clipping stage 3
2025-02-28 adds project for dsp hardware board and adds microcontroller pins for now
    [dsp_board.PrjPcb, main.SchDoc, switches_connectors.SchDoc]
2025-03-03 do something with tone stage
2025-03-03 too tired but have added commetns
2025-03-05 amplifier stage
    [amplifier_stage.SchDoc, main.SchDoc]
2025-03-05 amplifier stage updated
    [amplifier_stage.SchDoc]
2025-03-05 updated schematic
    [dsp_board.PrjPcb]
2025-03-05 updated board
    [amplifier_stage.SchDoc, main.SchDoc, power_supply.SchDoc]
2025-03-07 dsp board
    [PCB1.PcbDoc, amplifier_stage.SchDoc, dsp_board.PrjPcb, main.SchDoc, power_supply.SchDoc, shift_registers.SchDoc, switches_connectors.SchDoc]
2025-03-07 adds pre_amp schematic picture and ltspice files
2025-03-11 adds ltspice files for output stage and picture of output stage topology for report
2025-03-11 adds simulation files for ltspice output stage
2025-03-12 dsp board update
    [PCB1.PcbDoc, amplifier_stage.SchDoc, dsp_board.PrjPcb, main.SchDoc, power_supply.SchDoc, shift_registers.SchDoc, switches_connectors.SchDoc]
2025-03-12 adds powerdiodes for mathias
    [power_supply.SchDoc]
2025-03-12 no diodes :(
    [PCB1.PcbDoc, power_supply.SchDoc]
2025-03-14 adds picture and simulation files for powersupply
2025-03-18 dsp board with pcb
    [PCB1.PcbDoc, PCB2.PcbDoc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]
2025-03-19 updates simulation for powersupply
2025-03-19 add ts808 schematic
2025-03-19 dsp board pdf
    [PCB2.PcbDoc, amplifier_stage.SchDoc, power_supply.SchDoc, switches_connectors.SchDoc]
2025-03-20 ret wrong difference eq
    [WahEffect.c]
2025-03-21 add toggle switches n stuff
2025-03-21 add baseline for ts808 assembly
2025-03-24 schematics for voltage regulators
    [PCB2.PcbDoc, dsp_board.PrjPcb, power_supply.SchDoc]
2025-03-24 add LM317 schematic
2025-04-02 add adc code and fx param update
2025-04-04 change adc code to handle channels
2025-04-07 fix adc conversion func (only ch 3 works for some reason)
    [adc.c, main.c]
2025-04-09 updates hardware for v3 version
    [PCB1.PcbDoc, PCB2.PcbDoc, amplifier_stage.SchDoc, dsp_board.PrjPcb, main.SchDoc, power_supply.SchDoc, shift_registers.SchDoc, switches_connectors.SchDoc]
2025-04-09 hello nouglas
    [PCB2.PcbDoc, amplifier_stage.SchDoc, main.SchDoc, power_supply.SchDoc]
2025-04-09 fix set rate function
    [tremolo.c, tremolo.h]
2025-04-09 fix return type of chorus lfo function
    [chorus.c, chorus.h]
2025-04-09 change sample rate to 44.1kHz
2025-04-09 finalizes v3 pcb
    [PCB2.PcbDoc, main.SchDoc, shift_registers.SchDoc, switches_connectors.SchDoc]
2025-04-23 adds ltspice file with i2c level shift circuit
2025-04-23 add picture of i2c level shifting for report
2025-04-25 remove HALF flag from ADC to not divide input by 2
2025-04-25 implement previous changes (lost track)
2025-04-25 new dsp board
    [PCB2.PcbDoc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]
2025-04-25 pcb library
    [PcbLib1.PcbLib, Schlib1.SchLib]
2025-04-26 pcbv4 with fx loop and the other stuff
    [PCB2.PcbDoc, PCBV4.PcbDoc, amplifier_stage.SchDoc, dsp_board.PrjPcb, main.SchDoc, power_supply.SchDoc, regulators.SchDoc, switches_LEDs.SchDoc]
2025-04-28 update pcbv4 for review
    [PCBV4.PcbDoc]
2025-04-28 fix chorus and flanger?
    [adc.c, chorus.c, chorus.h, main.c]
2025-04-28 change FX param changer functions to be incremental with direction instead of ADC based
2025-04-29 add menu buttons
2025-04-29 add lfo tests fig and csv for flanger
    [flanger_lfo_test_1000mHz.csv, flanger_lfo_test_100mHz.csv]
2025-04-29 add plots for 1hz and 100mhz flanger lfo plots
2025-04-30 add wah plots and tests results
    [wah_fc_1000hz_500mV_overflow_test.csv, wah_fc_1000hz_50mV_test.csv, wah_fc_1000hz_700mV_rightshift_test.csv, wah_fc_1500hz_700mV_rightshift_test.csv, wah_fc_2250hz_700mV_rightshift_test.csv, wah_fc_350hz_700mV_rightshift_test.csv]
2025-05-01 tests and plots for flanger
    [flanger_1khz_modul_test.csv, flanger_delay_0ms_test.csv, flanger_delay_15ms_test.csv]
2025-05-01 tremolo, chorus and reverb tests/plots
    [chorus_1khz_wave_test.csv, chorus_delay_10ms_test.csv, chorus_delay_25ms_test.csv, chorus_delay_30ms_test.csv, reverb_early_delay_impulse.csv, reverb_impulse.csv, reverb_noise_dB.csv, tremolo_depth_0.5_test.csv]
2025-05-06 add debug prints
2025-05-06 test frequency response
    [loop_output.csv, pre_input.csv, pre_output.csv]
2025-05-06 amplifier stage figures
2025-05-07 adds data file for bandwidth test of whole system
    [bandwidth_test.csv]
2025-05-08 improve wah adc code for perfomance
2025-05-08 revert input delaylines in reverb
    [reverb.c]
2025-05-08 adds figure of impedance test
    [input_impedance.csv]
2025-05-08 adds overdrive filter test data
    [FIR_AA_measurement.csv, IIR_HP_200_measurement.csv, IIR_HP_3000_measurement.csv, IIR_HP_500_measurement.csv, IIR_LP_10000_measurement.csv, IIR_LP_4000_measurement.csv, IIR_LP_7000_measurement.csv]
2025-05-08 fix overdrive to sound good
    [fir.asm, overdrive.c]
2025-05-08 samplingtest for rah
    [samplingtest.csv]
2025-05-08 figures for overdrive filters
2025-05-08 adds csv files for input test and output test of dsp
    [input_test.csv, output_dsp_test.csv]
2025-05-08 mag_resp aa filter
2025-05-08 add output impedance measurement for processing
    [output_impedance.csv]
2025-05-09 output driver impedance plot
2025-05-09 frequency response test
    [loop_output.csv, pre_input.csv, pre_output.csv]
2025-05-09 update filter taps to old filter
2025-05-09 adds data for fir filter 60 tap version
    [fir_60_tap_filter_sweep.csv]
2025-05-09 changes to fir filter
2025-05-09 revise aa filter figure for dsp
2025-05-09 remove fir aa filter
2025-05-09 add csv for different tests
    [overdrive_non_linear_test.csv]
2025-05-13 plots for clock frequency of dsp
    [12Mhz_clock_before_change.csv, acope_0wy12.csv, acope_0wy13.csv, wrong_clock_with_reverb_12Mhz.csv]
2025-05-13 fix reverb to be good
    [reverb.c]
2025-05-13 remove fir filter
2025-05-14 made rt60? test
    [reverb_rt60_1_4s.csv, reverb_rt60_2_4s.csv, scope_0.csv, scope_1.csv, scope_2.csv, scope_3_4s.csv, scope_4_noisefloor_w_reverb.csv, scope_5_4s.csv]
2025-05-14 make uart thing
2025-05-15 adds new measurements and figures for wah sweep test with new 12db gain
    [wah_high_frequency_12db.csv, wah_low_frequency_12db.csv, wah_mid_frequency_12db.csv]
2025-05-15 adds computation time measurement for effects
    [allfx_computationtime.csv, chorus_computationtime.csv, flanger_computationtime.csv, nofx_computationtime.csv, overdrive_computationtime.csv, tremolo_computationtime.csv, treverb_computationtime.csv, wah_computationtime.csv]
2025-05-15 adds measurement computation for effects with overdrive fir filter
    [allfxfiroverdrive_computationtime.csv, firoverdrive_computationtime.csv]
2025-05-15 adds new measurement for overdrive with noise gate
    [allfx_computationtime.csv, overdrive_computationtime.csv]
2025-05-15 computation time for different optimisation 01-03 and debug mode
    [debug_allfx_computationtime.csv, o1_allfx_computationtime.csv, o3_allfx_computationtime.csv]
2025-05-16 add SPI Flash programming instructions
2025-05-20 measurement data for overdrive
    [overdrive_non_linear_long_0k6_test.csv, overdrive_non_linear_long_1k_test.csv, overdrive_non_linear_long_2k5_test.csv]
2025-05-20 5k overdrive data
    [overdrive_non_linear_long_5k_test.csv]
2025-05-21 measurement data of non line time overdrive
    [overdrive_worst_case_non_linearity_10x_time.csv]
